Latios1928/engn2912e-project/analog/Analog_AI_Documentation.md

# Analog Design — AI Usage Documentation

A running record of every use of AI assistance in the analog design work for
the ENGN 2912E SNN project: what was asked, what the AI did, what it produced,
and how far its output was checked. It is updated as the work continues.

- **Tool:** Claude Code (desktop app), model Claude Opus 5.5 (Anthropic)
- **User:** Ray Wu
- **Started:** 2026-10-25
- **Last updated:** 2026-11-11

---

## How AI is used in this project

| Category | What the AI does | What the AI does *not* do |
|---|---|---|
| Schematic / testbench review | Reads `.sch` files as text, works out connectivity from pin coordinates, points out wiring, topology and SPICE-setup errors | Edit existing schematics: changes to the user's schematics are made by the user in xschem. *Exception (2026-11-03, user approved):* the AI created the new `neuron_5khz*` files (entry 28). |
| Simulation debugging | Explains ngspice/xschem error messages and proposes fixes | Run xschem or ngspice without asking. *Exception (2026-11-03, user approved):* the AI ran xschem netlisting and ngspice in the user's iic-osic-tools container, with scratch output in the container's `/tmp` only (entry 28). |
| Results analysis | Reads `wrdata` text output (`*_tb.txt`) with short Python scripts and reports measured values (thresholds, step sizes, reset levels, timing) | Generate simulation data (except entry 28, as above) |
| Circuit explanation | Explains circuit operation (e.g. Indiveri et al. 2011, Figure 4) and design trade-offs | Choose final device sizes or architecture. *Exception:* entry 28, where the user asked the AI to size a copy of the neuron. |
| Estimates | Rough area and sizing estimates from rules of thumb | Provide sign-off numbers: no layout exists yet |
| Documentation | Writes and maintains Markdown logs | |

**Verification levels used below:**
- **Simulated:** numbers from ngspice runs the AI made itself (only entry 28, with the user's approval).
- **Analysed:** numbers computed by the AI from the user's own simulation output files.
- **Reasoned:** derived from reading files or from circuit theory; not simulated.
- **Estimate:** rule-of-thumb figure that needs checking against the PDK or a layout.

---

## Files created or changed by AI

| File | Action | Date | Notes |
|---|---|---|---|
| `analog/neuron/SIM_LOG.md` | Created | 2026-10-26 | Running simulation log for the earlier Schmitt-trigger neuron. Results in it come from the user's simulations, analysed by the AI. |
| `analog/Analog_AI_Documentation.md` | Created | 2026-10-29 | This file. |
| `digital/README.md` | Created | 2026-10-26 | Digital-side summary (outside analog scope; listed for completeness). |
| `tools/analog_API_infrastructure/README.md` | Created | 2026-10-30 | Design document and build guide for the LLM-assisted sizing tool. No implementation code: the user writes the code. |
| `analog/neuron/neuron_5khz.sch` | Created | 2026-11-03 | Copy of `neuron.sch`, same topology, resized for 5 kHz (entry 28). Generated by script from the original. |
| `analog/neuron/neuron_5khz.sym` | Created | 2026-11-03 | Identical to `neuron.sym` (same pins). |
| `analog/neuron/neuron_5khz_testbench.sch` | Created | 2026-11-03 | Copy of `neuron_testbench.sch`: DC input, bias `.param`s, MIM model library, frequency `meas`. |
| `tools/analog_API_infrastructure/{params,netlist,runner,metrics,loop,compare}.py` | Created | 2026-11-04 | Sizing-loop implementation, at the user's request (entry 34). `advisor.py` not touched. |
| `tools/analog_API_infrastructure/configs/{params,spec,sim}.yaml`, `requirements.txt`, `.gitignore` | Created | 2026-11-04 | Configs for the 5 kHz neuron; `runs/` gitignored. |
| `tools/analog_API_infrastructure/README.md` | Edited | 2026-11-04 | Status line, new Quick start section, AI-usage note. |
| `tools/analog_API_infrastructure/advisor.py` → `advisor_draft.py` | Renamed (`git mv`) | 2026-11-04 | The user's draft, content unchanged (checksum-verified), at the user's request (entry 35). |
| `tools/analog_API_infrastructure/advisor.py` | Created | 2026-11-04 | New, complete OpenRouter advisor (entry 35). |
| `analog/testbenches/README.md` | Created | 2026-11-05 | How the testbenches and runners work; DPI reference point, test list and first findings (entry 43). |
| `analog/testbenches/tbtools.py` | Created | 2026-11-05 | Shared runner code: xschem netlisting, corner/temperature/param/mismatch substitution, parallel ngspice runs. |
| `analog/testbenches/.gitignore` | Created | 2026-11-05 | Ignores the `runs/` scratch folders. |
| `analog/testbenches/dpi/dpi_dc_tb.sch`, `dpi_step_tb.sch`, `dpi_spike_tb.sch` | Created | 2026-11-05 | DPI synapse testbenches (entry 43). Generated by script, using the pin positions in `DPI.sym`. |
| `analog/testbenches/dpi/run_dpi.py` | Created | 2026-11-05 | Runs the DPI testbenches over sweeps, corners, temperature, supply and mismatch; writes `results/`. |
| `analog/testbenches/dpi/results/*` | Generated | 2026-11-05 | Report `dpi_results.md`, per-suite CSVs and PNG plots from the runner. |
| `analog/neuron/DAC.sch` | Edited (user request) | 2026-11-05 | Weight pins `w0`–`w3` replaced by one bus pin `w[3:0]` to match the user's new `DAC.sym`; gate nets renamed `w[0]`–`w[3]` (entry 44). Sized for branch weights 1:2:3:4 (entry 45). Enable switch `Men` and `en` pin added (entry 48). |
| `analog/neuron/DAC.sym` | Edited (user request) | 2026-11-05 | `en` input pin added below `w[3:0]` (entry 48). |
| `analog/neuron/DACs-DPI.sch` | Edited (user request) | 2026-11-05 | x2/x3 weights wired as buses `w1[3:0]`, `w2[3:0]` (x1 was already `w0[3:0]`); sources renamed to the bus nets; DPI `Isum` reconnected by label (entry 44). Rewritten as the weight-code test, with a Vb reference and DAC current ammeter (entry 45). DAC `en` tied to VDD (entry 48). |
| `analog/neuron/DACs-DPI-neuron.sch` | Created | 2026-11-05 | DACs → DPI → `neuron_sized` testbench: input spikes of a chosen weight code, reports the input spike that first fires the neuron (entry 46). Generated by script from `DACs-DPI.sch` and `neuron_sized_testbench.sch`, which were not changed. Weights static and spikes on the DAC `en` pins since entry 48. |
| `mock/snn_mock.v` → `mock/snn_analog.v`, `snn_top.v`, `digital/snn_digital.v`, `mock/{neuron,tb_neuron,tb_snn_top}.v`, `mock/sim.f`, `analog/snn/snn_analog.v` (black box, was `mixed/snn_analog_stub.v`), `mixed/{sim.f,snn_ms_tb.v}`, `librelane/snn_top/config.json` | Renamed, split, moved and edited (user request) | 2026-11-09 | The behavioral model is now `snn_analog` (same name and ports as the analog network, own clock and power-on reset). The digital part is `digital/snn_digital.v` (`rf` + `pulse_gen`, no dependency on the analog side); the root `snn_top.v` only wires it to `snn_analog`, which `mock/` and `mixed/` each supply through their own file list (`sim.f`). The neuron has a `LEAK` parameter (new test in `tb_neuron.v`). `snn_ms_tb.v` instantiates `snn_top`. The LibreLane config lists `snn_top` and `digital/` (no analog macro yet, not run). |
| `mock/{dac,neuron,snn_analog,tb_neuron,tb_snn_top}.v`, `mixed/snn_ms_tb.v` | Edited (user request) | 2026-11-11 | Weights are sign-magnitude (bit 3 = sign, 1 = inhibitory; −7…+7), chosen over 1's complement because the magnitude bits drive the DAC branches directly and the sign only steers the current, so no branches oppose each other. Mock DAC gives a signed current, the neuron sums signed currents and clamps at 0, `snn_analog`'s `GAIN` is 32. New tests: inhibition in `tb_neuron` and an inhibition scenario in `tb_snn_top` (both fail if the sign is ignored). Max weight in the testbenches is now `4'h7`. `mixed/` also runs the inhibition scenario, as if the analog DAC already had a sign; it fails until `DAC.sch` and an inhibitory input exist (checked: today `1111` excites and hidden 1 and the output fire). |
| `analog/snn/snn_analog.{sch,sym,v}`, `mock/snn_analog.v`, `digital/{rf,pulse_gen,snn_digital,tb_pulse_gen}.v`, `snn_top.v`, `mock/tb_snn_top.v`, `mixed/{snn_ms_tb.v,snn_ms_tb.sch,snn_ms_tb_digital.json}` | Resized (user request) | 2026-11-11 | Network changed from 3-5-1 to 2-2-1: 8 weight words (`w[31:0]`, 3-bit `addr`), `in`/`pulse[1:0]`, `spike[4:0]`. Schematic regenerated (8 DAC, 5 DPI, 5 neurons). Scenarios mapped to 2-2-1 (path in1 → hid1 → out); the out-of-range `rf` write test was dropped because every 3-bit address is valid. All tests pass; full mixed run 96 s. Earlier entries describe the 3-5-1 network. |
| `digital/pulse_gen.v`, `tb_pulse_gen.v`, `tb_pulse_gen.json` | Moved from `mock/` and rewritten (user request) | 2026-11-09 | Input pulse generator is digital: three channels on one counter, `clk` and `rst` ports, `en` sampled at period boundaries, registered outputs. New testbench with a reference model. Chip pins: `in[2:0]` (enables), not `pulse[2:0]`. `snn_top`, `snn_ms_tb.v`, `mixed/Makefile` and the LibreLane config updated. |
| `analog/mock/*` → `mock/*` | Moved (user request) | 2026-11-09 | The mock modules and their testbenches moved to top-level `mock/`, together with `snn_top.v`, `tb_snn_top.v` and `tb_snn_top.json`. `snn.v` → `snn_mock.v` (module `snn` → `snn_mock`, ports unchanged). LibreLane config, `mixed/Makefile` and comments updated. Earlier entries below still use the old paths. |
| `xschemrc`, `analog/neuron/xschemrc` | Created | 2026-11-05 | Project xschem setup: loads the PDK, then puts the project root and `analog/neuron` on the symbol search path (entry 47). |
| `analog/neuron/layout/` (new folder) | Created | 2026-11-10 | DPI layout (entry 58): generator `gen_dpi.py`, `DPI.gds`, LVS reference `DPI_lvs_ref.spice` (+ converted `.cdl`), `run_dpi_checks.sh`, helpers `extract_pins.py`, `render_under.py`, `drc_summary.py`, `lvs_xref.py`, outputs `DPI_pins.json`, `DPI.png`, `DPI_under_cap.png`. `DPI.sch`/`DPI.sym` not changed. |
| `analog/neuron/layout/` neuron files | Created / rewritten | 2026-11-10 / 2026-11-11 | `neuron_sized` layout (entries 59, 60): `gen_neuron.py` (rewritten in entry 60), `neuron_sized.gds`, `neuron_sized_lvs_ref.spice` (+ `.cdl`), `run_neuron_checks.sh`, `coupling.py`, outputs `neuron_sized_pins.json`, `coupling_{VMEM,spike,net1,net2}.txt`, `neuron_sized.png`, `neuron_sized_under_cap.png`. `neuron_sized.sch`/`.sym` and `spike_amplifier.*` not changed. |
| `analog/neuron/layout/` DAC files | Created | 2026-11-11 | DAC layout (entry 64): `gen_dac.py`, `DAC.gds`, `DAC_lvs_ref.spice` (+ `.cdl`), `run_dac_checks.sh`, outputs `DAC_pins.json`, `DAC.png`, `DAC_coupling_*.txt`. `coupling.py` now counts GND as a supply. `DAC.sch`/`DAC.sym` not changed. |
| `analog/neuron/DAC_binary.sch`, `DAC_binary.sym` | Created (user request) | 2026-11-11 | Binary 1:2:4:8 DAC with multi-finger branches (entry 66). Generated by script from `DAC.sch`; the symbol is a copy of `DAC.sym` (same pins). `DAC.sch`/`DAC.sym` and their users not changed. |
| `analog/neuron/layout/` binary DAC files | Created | 2026-11-11 | Binary DAC layout (entry 68): `gen_dac_binary.py`, `DAC_binary.gds`, `DAC_binary_lvs_ref.spice` (+ `.cdl`), `run_dac_binary_checks.sh`, outputs `DAC_binary_pins.json`, `DAC_binary.png`, `DAC_binary_coupling_*.txt`. |
| `analog/snn/snn_analog.sch`, `snn_analog.sym` | Created | 2026-11-08 | The 3-5-1 network from `DAC`, `DPI` and `neuron_sized` (23/9/9 instances), per the word map of `analog/mock/snn.v` (entry 49a). Generated by script; no existing schematic changed. |
| `xschemrc` | Edited | 2026-11-08 | `analog/snn` added to the symbol search path. |
| `mixed/*` | Created | 2026-11-08 | Mixed-signal flow with SpiceBind: Verilog testbench, SPICE testbench, `libngspice` crash shim, Makefile, README (entry 49a). |
| `analog/mock/{dac,snn,tb_neuron}.v` | Edited (user request) | 2026-11-08 | Weights widened to 4 bits, binary (entry 49a). |
| `analog/snn/snn_analog_inh.sch`, `snn_analog_inh.sym` | Created (user request) | 2026-11-11 | Copy of the 2-2-1 `snn_analog` with `DAC_signed` hidden → output synapses, a `DPI_inh` on the output membrane, and new pins `s[1:0]` and `VT_inh` (entry 74). `snn_analog.sch/.sym` unchanged. |

Until entry 44, no existing schematic (`.sch`/`.sym`) or SPICE file had been edited by the AI. The DPI testbenches (entry 43) only instantiate `DPI.sym`; `DPI.sch` and `DPI.sym` were not changed by the AI. The originals `neuron.sch`, `neuron.sym` and `neuron_testbench.sch` were checksum-verified unchanged after the 5 kHz files were generated.

---

## Log

### 2026-10-25

**1. Review of the Schmitt-trigger comparator testbench** *(Reasoned)*
- **Asked:** review `schmitt_trigger_comparator_testbench.sch` without editing files.
- **AI found:**
  - Testbench: no model include, analysis or `.control` block; VIN was a constant 3 V DC (no hysteresis visible); load caps on the internal nodes VP/VN.
  - Comparator: NMOS on top and PMOS on bottom (source-follower, not inverting); both feedback devices NMOS; body pins apparently unconnected.
- **Outcome:** the user later rebuilt the comparator stack with PMOS on top and one NMOS plus one PMOS feedback device.

**2. "Undriven node" netlist errors** *(Reasoned)*
- **Asked:** debug undriven-node errors from netlisting.
- **AI did:** without seeing the error text, listed likely causes; the main one was floating transistor body pins. Asked for the exact messages.
- **Outcome:** the user wired the body pins.

**3. Triangle-wave transient on the comparator** *(Reasoned)*
- **Asked:** why the transient triangle input wasn't working.
- **AI found:** `.param` inside `.control` (parameters undefined); a one-direction current pulse into a cap can't make a triangle; the run was ~100× shorter than the waveform period.
- **AI suggested:** drive the input with a voltage `pwl` triangle and move `.param` outside `.control`.

**4. Input source for an SNN neuron** *(Reasoned)*
- **Asked:** what input current source suits a comparator inside an SNN.
- **AI explained:** switched (pulsed) unipolar current into a membrane capacitor with a reset, based on the behavioural models in `analog/mock/` (`dac.v`, `neuron.v`, `comparator.v`).

### 2026-10-26

**5. "unknown subckt … neuron" in `neuron_testbench`** *(Reasoned)*
- **AI found:** the `plot` title opened with `'` and closed with `"`, which ended the code block's `value="…"` early. The `.control` block lost its `.endc` and swallowed the `.subckt` definition. Also: `v(spike)` named a node that doesn't exist.

**6. "tran simulation(s) aborted"** *(Reasoned)*
- **AI explained:** the vector errors were a result of the sim failing at the DC operating point (MEM nearly floating; feedback loop). Suggested `.ic v(mem)=0` with `tran … uic`, or a leak resistor, plus a maximum time step.

**7. Singular matrix at `vbias#branch`** *(Reasoned)*
- **AI found:** the label on Vbias's + terminal said `VDD`, putting the 0.2 V source in parallel with the 3.3 V supply and leaving `reset_bias` floating.
- **Outcome:** the user relabelled it `reset_bias`.

**8. Plotting the input current** *(Reasoned)*
- **AI explained:** use the series ammeter's branch current (`i(vmem)`). Flagged that the ammeter's instance name must start with `V`: `iMEM` would netlist as a 0 A current source.
- **Outcome:** the user renamed it `VMEM`.

**9. Access to simulation results** *(Reasoned)*
- **AI explained:** it couldn't see results, because ngspice wrote them inside the container. Suggested `write`/`wrdata` with absolute `/foss/designs/...` paths.
- **Outcome:** the user added the paths; later results were readable.

**10. Staircase on MEM, no reset (ipk = 1 nA)** *(Analysed)*
- **AI measured:** MEM rose ≈ 51 mV per input pulse, reaching only ≈ 0.53 V in 10 ms; VOUT stayed at 3.3 V.
- **AI explained:** the staircase is expected for pulsed input; the neuron never reached its threshold. Also flagged a `v(out)` typo in `wrdata`.

**11. Reset not fast enough (ipk = 1 µA)** *(Analysed)*
- **AI measured:** about 67 spikes per input pulse; reset fall ≈ 9 ns, but MEM only dropped from ≈ 1.96 V to ≈ 1.21 V.
- **AI explained:** the reset ends itself when MEM drops below the lower threshold. Suggested holding the reset for a fixed time (one-shot or latch), widening M1, lowering the input current, and using finer time steps.
- **Outcome:** the user widened M1 to W = 2 µm and added C2 = 100 fF on the reset gate.

**12. MEM not crossing threshold (back at ipk = 1 nA)** *(Analysed)*
- **AI explained:** VP is an internal node, not the firing threshold. MEM needed ≈ 38 pulses to reach VTH+. Gave a table of ipk versus pulses-to-fire and suggested 10 nA.

**13. Measuring VTH+ / VTH−** *(Reasoned)*
- **AI suggested:** a slow `pwl` triangle on the comparator alone, with `meas tran … WHEN v(vout)=1.65 FALL=1 / RISE=1` and `plot v(vout) vs v(in)`. Explained the `pwl` syntax on request.

**14. Simulation log created** *(Analysed)*
- **AI created** `analog/neuron/SIM_LOG.md` from the user's latest results:
  - Comparator: **VTH+ = 1.954 V, VTH− = 1.298 V** (hysteresis 0.656 V).
  - Neuron at ipk = 20 nA: fires at ≈ 1.955 V; resets only to ≈ 0.74–1.01 V in ≈ 7 ns; 8 spikes in 10 ms.

### 2026-10-27

**15. Explanation of the voltage-amplifier I&F neuron** *(Reasoned)*
- **Asked:** explain Figure 4 of Indiveri et al., "Neuromorphic silicon neuron circuits", *Frontiers in Neuroscience* 5:73 (2011).
- **AI explained:** the roles of I_in, the leak (M1/V_lk), the comparator, the I_Na positive feedback, and the C_K/I_Kup/I_Kdn timing for spike width and refractory period. Compared it with the user's Schmitt-trigger neuron and suggested a starved inverter for a controlled reset hold.

**16. Suitability for subthreshold operation** *(Reasoned)*
- **AI concluded:** suitable. Gave the advantages (tunable pA–nA biases, ms time scales, nW power) and the issues to design for (mismatch, temperature, leakage floor, bias generation). Flagged that the earlier Schmitt-trigger stack would draw large through-current with a slow input.

**17. Layout area estimate for 9 neurons** *(Estimate)*
- **AI estimated:** ≈ 1,200 µm² per neuron (range 800–1,800), so **≈ 0.011 mm² for 9 neurons**, dominated by a 1 pF MIM membrane cap. The weight register file is ≈ 0.012–0.013 mm² (from the LibreLane netlist: 69 of 225 flip-flops). Flagged that `capa.sym` (ideal capacitor) must be replaced with a PDK MIM capacitor, and that the 5 V standard-cell library differs from the 3.3 V analog devices.

**18. Analog versus digital area** *(Estimate)*
- **AI estimated:** total analog ≈ 0.02–0.03 mm² (neurons, DACs, pulse generators, bias) versus digital ≈ 0.013–0.016 mm², so analog is likely larger.

**19. Shuttle tile-size table** *(Reasoned / Estimate)*
- **AI found:** in the user's table, the "usable area" column was ≈ 1,000× too large (a formula referencing the 3x2 width), and the NAND2-equivalent column was ≈ 10× too high for GF180 (a NAND2 is ≈ 9–10 µm²).
- **AI recommended:** 1x2 tiles (0.113 mm²) for margin; 1x1 is possible but tight.

### 2026-10-29

**20. Capacitor values in the new Figure 4 neuron (`neuron.sch`)** *(Reasoned)*
- **Asked:** whether the XC1/XC2 capacitances can be changed.
- **AI read** the new schematic and the paper's text (extracted from the PDF).
- **AI found:**
  - C2 is C_mem (on VMEM) and C1 is C_K (on the `spike` node that drives M6). Both are 1 × 1 µm `cap_mim_2f0_m3m4_noshield`, ≈ 2 fF each.
  - The paper gives no specific values for these capacitors.
- **AI recommended:**
  - Set capacitance through W and L (≈ 2 fF/µm²).
  - Starting values: C_mem ≈ 0.5–1 pF, C_K ≈ 50–200 fF.
  - Check the PDK's minimum MIM size.
  - The `spike` output sits on the slow C_K node.

### 2026-10-30

**21. Plan for LLM-assisted sizing infrastructure (OpenRouter)** *(Reasoned)*
- **Asked:** a README for `tools/analog_API_infrastructure/` describing Python tooling that calls OpenRouter models to size the neuron and set testbench parameters, with control over spike frequency, active and capacitor area, reset time, refractory time, etc. The user wants to write the code themselves; the AI only guides.
- **AI did:**
  - Read the existing draft `advisor.py` and `neuron_testbench.sch`.
  - Wrote `README.md` covering: the propose → validate → simulate → measure loop; spec and parameter formats; how each metric is measured (`.meas` versus computed in Python for area); preparing the schematic (parameterized fields, a separate automation code block, a generated `params.spice`); a module layout with function interfaces but no bodies; the OpenRouter call (key from the environment, structured JSON output, retries, logging); validation rules; a random-search baseline for comparison; and a milestone plan.
- **AI found:**
  - Bugs in `advisor.py`: `os.enrivon`; undefined `s` in `Param.fix`; `tuple{…]` syntax error; `meets_spec` body copied from `_key`; set literals in place of dicts in `_schema`; a missing comma.
  - The bias parameters (`Vlk`, `VNA`, `VK`, `VKup`, `VKdn`, `VIp`, `Vamp_bias`, `VT`) are used by the testbench sources but not defined in its `.param` line.
- **Not done by AI:** any implementation code, or fixes to `advisor.py`. Those are left to the user.

**22. Plain-language walkthrough of `advisor.py`** *(Reasoned)*
- **Asked:** explain each Python function in `advisor.py` for a non-software-engineer.
- **AI did:** explained the imports, constants, `Param`/`fix`, `Spec`, `meets_spec`, `_key`, `_schema`, and the functions not yet written (`_user_prompt`, `_log`, `_random`, `_client`, `suggest`, the `__main__` self-test), plus a table of common Python syntax.
- **AI found:** still present in the user's file: `meets_spec` body copied from `_key`; set literals (`{"type","string"}`) in place of dicts in `_schema`; a missing comma before `"required"`.
- **Not done by AI:** any change to `advisor.py`.

### 2026-11-01

**23. Re-display of the reference `advisor.py`** *(Reasoned)*
- **Asked:** show the full advisor script again.
- **AI did:** reprinted the reference version from entry 21's discussion, unchanged.

**24. Explanation of schemas, dictionaries and tuples; running guide** *(Reasoned)*
- **Asked:** what a schema is, the purpose of the tuples and dictionaries in `advisor.py`, and a running document on the AI harness.
- **AI did:** created a Claude Doc, "AI Analog Harnessing Guide" (https://claude.ai/artifact/H8XnjUgpAtzQzgn4qyrGyK), outside the repo. It covers: a diagram of the propose → simulate → measure → back-annotate loop; schemas; each dictionary and tuple in `advisor.py`; lists and sets compared with tuples; a function reference; a glossary; and a change log.
- **Not done by AI:** any change to `advisor.py` or other project code.

**25. Schema versus history record for a candidate** *(Reasoned)*
- **Asked:** how parameter values, simulation results, an ID and a score fit into the `type` / `properties` / `required` / `additionalProperties` keys of the candidate schema.
- **AI explained:** the schema covers only what the model proposes (parameter values, optionally a per-candidate `reason`). Results, ID and score belong in a separate history record built by the user's code after simulation, so the model cannot fabricate results. Gave an example record and a distance-from-spec score idea.
- **Not done by AI:** any change to `advisor.py`. The harnessing guide was not updated because the Docs connector was disconnected.

**26. Why a schema needs the `"type"` key** *(Reasoned)*
- **Asked:** why `"type": "object"` is needed when `candidate` is already a dictionary.
- **AI explained:** the dictionary is a description, not the candidate itself; every schema description is a dict whatever it describes (e.g. `{"type": "number"}`). The schema is sent as JSON to OpenRouter, whose validator and model see only that text, and strict mode requires `type` at every level.

**27. Analogy for the structure of `advisor.py`** *(Reasoned)*
- **Asked:** an analogy to make the structure of the advisor functions intuitive.
- **AI explained:** a lab that hires an outside consultant by mail. Knobs with end stops and detents (`Param`, `fix`); datasheet (`spec`, `meets_spec`); lab notebook (`history`, `_key`, `seen`); contract and cover letter (`SYSTEM_PROMPT`, `_user_prompt`); the enclosed reply form (`_schema`); mailbox (`_client`); binder of photocopies (`_log`); a free intern (`_random`); one round of mail (`suggest`). The bench (ngspice) is outside `advisor.py`: the consultant suggests, the bench decides.

### 2026-11-03

**28. Duplicate neuron sized for 5 kHz** *(Simulated)*
- **Asked:** create a duplicate of the neuron (Indiveri et al. 2011, Fig. 4 topology in `neuron.sch`) and size it to spike at 5 kHz.
- **User approved** (asked first, since the workspace rule was read-only): creating new files next to the originals, and running ngspice in the user's iic-osic-tools container.
- **Operating point the AI chose** (5 kHz needs a defined input): constant input current Iin = 5 nA DC, VDD = 3.3 V, typical corner, 27 °C.
- **AI did:**
  - Netlisted `neuron_testbench.sch` with xschem to confirm the connectivity it had read from the file.
  - Characterized Id vs Vgs for 1 µm/1 µm bias devices; swept the Na, K, Kup biases and M6 length (≈ 100 runs, scratch files in the container's `/tmp/claude_neuron`).
  - Generated the three new files with a script, then netlisted the new testbench with xschem and simulated that netlist.
- **Final sizing (`neuron_5khz.sch`):**
  - C2 (Cmem) 20.52 × 20.52 µm ≈ 0.86 pF; C1 (C_K) 6.85 × 6.85 µm ≈ 100 fF.
  - M6 (reset switch) W/L = 0.22/5 µm. The long channel delays the reset until the spike node is high, which gives a full-swing spike.
  - Bias devices M7–M12: W/L = 1/1 µm. Switches M1–M5 and the spike amplifier unchanged (0.22/0.28 µm).
- **Biases (`neuron_5khz_testbench.sch`):** Vlk 0.420 V (≈ 0.5 nA leak), Vamp_bias 0.535 V (≈ 10 nA), VIp 0.573 V (≈ 25 nA), VNA 2.0 V (≈ 4 µA), VKup 2.277 V (≈ 1 µA), VK 1.1 V, VKdn 0.573 V (≈ 25 nA), VT 1.0 V.
- **Simulated results (typical, 27 °C):**
  - Frequency **4.999 kHz** from the xschem-generated netlist of the new schematic.
  - Spike 0 → 3.30 V, ≈ 6.4 µs wide at VDD/2; VMEM resets to < 1 mV; average power ≈ 0.21 µW.
  - VNA or VK ±50 mV: frequency within 0.1 %, no latch-up.
  - f vs Iin: 1.75 / 2.86 / 5.00 / 7.54 / 9.95 / 18.4 kHz at 2 / 3 / 5 / 7.5 / 10 / 20 nA.
- **AI found:**
  - The original `neuron_testbench.sch` cannot run as is: it lacks `.lib … mimcap_typical` (the MIM caps are then unknown subcircuits) and `.param` values for the eight bias voltages; its `wrdata` names `v(mem)`/`v(vout)` no longer exist.
  - With the first biases tried, the spike node peaked at only ≈ 0.95 V, because the reset won a race against the spike node; when INa exceeded IK the neuron latched high and stopped firing.
- **Limitation:** fixed bias *voltages* on subthreshold devices make the design strongly corner- and temperature-dependent. ss 27 °C gives 2.96 kHz; typical 85 °C and ff 27/85 °C do not fire, because leak exceeds 5 nA. On silicon the biases should come from current-referenced bias generators, or be retuned per chip.

**28. Meaning of `"type": "object"` in a JSON schema** *(Reasoned)*
- **Asked:** whether `"type": "object"` is too general, since everything in Python is an object.
- **AI explained:** in JSON Schema, "object" is one of six JSON types and means a `{...}` with named fields (a Python dict), so it is as specific as `"string"`. `properties`, `required` and `additionalProperties` then pin down exactly which fields. Added a short note on this to the schema section of the harnessing guide.
- **Not done by AI:** any change to `advisor.py`.

**29. JSON versus JSON Schema keywords** *(Reasoned)*
- **Asked:** whether `type`, `properties`, `required` and `additionalProperties` are part of the JSON language.
- **AI explained:** JSON is only a data format with no keywords. Those names come from JSON Schema, a separate standard written in JSON. Python treats them as ordinary dictionary keys; OpenRouter and the model give them meaning, so they must be spelled exactly (a misspelled keyword is ignored or rejected).
- **Not done by AI:** any change to `advisor.py`.

**30. Description of `_user_prompt` in `advisor.py`** *(Reasoned)*
- **Asked:** add a description of the user prompt to this file.
- **What it is:** each request to the model carries two messages. The *system prompt* (`SYSTEM_PROMPT`) is the fixed job description, the same every call. The *user prompt* is the specific question for this round, rebuilt each call by `_user_prompt(space, history, spec, n)` so it always includes the latest simulation results.
- **Inputs:** `space` (the tunable parameters and their bounds), `history` (every point simulated so far, with its measured metrics), `spec` (acceptable range per metric), and `n` (how many new candidates to ask for).
- **How it works:** it collects lines of text in a list, then joins them with line breaks into one block of text. It has four parts:
  1. **Parameters:** one line per knob with its minimum, maximum and grid step.
  2. **Spec:** one line per metric with its acceptable range.
  3. **Simulated points:** a comma-separated table with a header row (parameter names, metric names, `meets_spec`), then one row per simulated point with its values and pass/fail. If nothing has been simulated, it says so.
  4. **Request:** "Propose exactly n new candidates."
- **Example output** (two parameters, one metric, one simulated point):
  ```
  Parameters (name: lo .. hi, step):
    WP: 2.2e-07 .. 2e-06, step 5e-09
    WN: 2.2e-07 .. 2e-06, step 5e-09

  Spec (metric: acceptable range):
    vth_hi: 1.95 .. 2.05

  Simulated points:
    WP,WN,vth_hi,meets_spec
    4.4e-07,2.2e-07,1.5,False

  Propose exactly 4 new candidates.
  ```
- **Why a plain-text table:** it is compact, so many points fit in one request, and models read comma-separated tables reliably. `:.4g` rounds each number to 4 significant figures to keep it short.
- **AI found** in the user's version (lines 59–79):
  - Lines 78–79 (`Propose exactly…` and `return`) are indented inside the `else:` block. With an empty history, the function returns `None` instead of a prompt, so the first call of a run fails. They should be dedented to the level of `metrics = list(spec)`.
  - Line 74 uses `h['metrics'][m]`, which crashes with `KeyError` if a measurement failed. `h['metrics'].get(m, float('nan'))` prints `nan` instead.
  - Lines 61 and 64 format `p.lo` and `lo` without `:.4g`, unlike `hi`, so the bounds print inconsistently.
  - Line 69 typo: `(non yet)` should be `(none yet)`.
- **Not done by AI:** any change to `advisor.py`. The fixes are left to the user.

**31. Opening an xschem schematic from the command line** *(Reasoned)*
- **Asked:** how to open an xschem schematic from the command line.
- **AI explained:**
  - `xschem <file>.sch`, run from the project root inside the iic-osic-tools container, so relative symbol paths such as `analog/neuron/neuron.sym` resolve.
  - How to launch it from a Mac terminal with `docker exec` and the container's VNC display.
  - The batch netlisting flags (`-n -s -q -o`).
- **Not done by AI:** nothing was run in the container.

**32. "Missing symbol" for `spike_amplifier` when opening from the command line** *(Reasoned)*
- **AI found:** `neuron.sch` (and `neuron_5khz.sch`) place the amplifier as `analog/neuron/spike_amplifier.sym`. That path is resolved against xschem's library search path (`XSCHEM_LIBRARY_PATH`), not against the schematic's folder, so it only resolves when the project root is on that path or is the working directory xschem was started from.
- **AI explained** three fixes:
  1. Start xschem from the project root.
  2. Reference the symbol by its bare name, since it is in the same folder as `neuron.sch`.
  3. Add the project root to `XSCHEM_LIBRARY_PATH` in an `xschemrc`.
- **Not done by AI:** no file was changed and nothing was run in the container. The diagnosis wasn't confirmed against the container's actual `XSCHEM_LIBRARY_PATH`.

### 2026-11-04

**33. Turning a DC current target into a pulsed testbench input** *(Reasoned)*
- **Asked:** for 5 kHz spiking with C = 1 pF and ΔV ≈ 1.66 V, the calculation gives a DC current; how does that translate to the pulsed source in the testbench?
- **AI explained:**
  - The DC number is the required *average* current: I = C·ΔV·f = 8.3 nA, plus leak, plus a correction for time spent spiking and in refractory.
  - Charge per pulse is q = ipk·(pw + (tr + tf)/2). The neuron fires after N = ⌈Q/q⌉ pulses, so f_out = f_pulse/N. The output rate is therefore quantized.
- **AI gave** three worked stimulus options:
  - one pulse per spike at 5 kHz;
  - 4 pulses per spike at 20 kHz, aiming q at Q/3.5 for margin;
  - fast pulses with average current equal to the DC value, which behave like DC.
- **AI noted:**
  - Pulses arriving during the refractory period are lost.
  - ΔV = 1.66 V implies VT ≈ 1.66 V, whereas the `neuron_5khz` testbench uses VT = 1.0 V.
- **Not done by AI:** no file was changed and nothing was simulated. The numbers are hand calculations.

**34. Python files for the sizing loop** *(Simulated)*
- **Asked:** add the Python files the sizing infrastructure needs to the tools folder. This reverses the earlier "the user writes the code" arrangement for these files; `advisor.py` stays the user's.
- **User approved** a smoke test of ~8 ngspice runs in the container (output in the gitignored `runs/`).
- **AI did:** wrote `params.py` (YAML → `Param`/`Spec`), `netlist.py` (xschem batch netlist → template: removes `.control` and overridden `.param`s, replaces device fields with `{PARAM}`; writes `params.spice`), `runner.py` (`ngspice -b` with timeout, `num_threads=1`), `metrics.py` (`parse_meas`, hierarchical `area`, `meets_spec`, `score`), `loop.py` (propose → validate → parallel simulate → `history.jsonl`; random proposer built in, LLM proposer calls `advisor.suggest()`), `compare.py`, and configs.
- **Design choice:** the schematic is not edited; device sizes are substituted in a copy of the netlist, so README step 3 becomes optional.
- **Example problem in the configs:** keep 5 kHz (4.9–5.1 kHz at 5 nA), spike width < 20 µs, power < 0.5 µW, while cutting MIM area to < 300 µm² (hand-sized design: 468 µm²). Tunables: W_C2, W_C1 (square caps), VT, Vlk, VKdn.
- **Checks:**
  - Area from the netlist: a_active 7.72 µm², a_cap 468 µm², matching the hand calculation.
  - Init point through the full tool: 4.999 kHz, 6.37 µs, 0.206 µW, matching entry 28.
  - 8 random points ran without errors; the best scored 0.089 (5.55 kHz at 241 µm²), none met spec. One point produced too few spikes for `f_spike` and was correctly reported as `None`.
- **Not done by AI:** `advisor.py` is unchanged and still does not import (its `suggest()` is unfinished, and entry 30's `_user_prompt` fixes are still open), so `--proposer llm` is untested. `openai` is not installed in the container.

**35. New `advisor.py`; the user's draft renamed** *(Reasoned; tested with stubbed API replies)*
- **Asked:** create a separate `advisor.py` and rename the user's.
- **AI did:**
  - Renamed the draft to `advisor_draft.py` with `git mv`. The content is byte-identical to the committed version.
  - Wrote a new `advisor.py` with the draft's structure (`Param`, `meets_spec`, `_key`, `_schema`, `_user_prompt`, `_log`, `_random`, `suggest`). It includes the fixes from entry 30 and README section 8, plus:
    - an HTTP call using only the Python standard library, so `openai` is not needed;
    - structured output, with a plain-JSON fallback when a model rejects `response_format`;
    - retries with backoff on HTTP 429/5xx;
    - history trimmed to the 20 best and 20 most recent points;
    - clamp/snap of proposed values, and removal of duplicates;
    - prompts, replies and token usage logged to each run's `advisor_log.jsonl`.
  - `loop.py`: fails fast if no model or `OPENROUTER_API_KEY` is set, and points the advisor log at the run folder.
  - README status, file table and setup note updated; `openai` removed from `requirements.txt`.
- **Checks (no ngspice runs, no real API calls):**
  - Prompt text inspected.
  - With a faked API reply, a duplicate was dropped, out-of-range values were clamped and an incomplete candidate was discarded.
  - A 429 followed by a `response_format` 400 led to a retry, then the plain-JSON fallback.
  - `loop.py --proposer llm` ran with stubbed simulation and API, and logged every round.
- **Not verified:** a real OpenRouter call, i.e. whether a given model returns schema-conforming candidates (README milestone 6).

**36. Checking the user's peak-current equation, C·ΔV + I_lk·ΔT** *(Reasoned)*
- **Asked:** the user derived I_peak = C·ΔV + I_lk·ΔT, which differs from entry 33.
- **AI explained:**
  - That expression is a *charge* (coulombs), not a current. It is the correct charge balance, the same as entry 33's Q plus leak charge.
  - To get a current, divide by the total pulse on-time: I_pk = (C·ΔV + I_lk·ΔT) / (N·t_on), with t_on = pw + (tr + tf)/2.
  - ΔT is the time VMEM sits above ground, because the leak device has almost no drain-source voltage at VMEM ≈ 0:
    - one pulse per spike: ΔT ≈ pw, so I_pk = C·ΔV/pw + I_lk;
    - N pulses: ΔT ≈ (N − 1)·per + pw.
  - The result is the minimum (exact) value; add margin.
- **AI checked:** worked numbers against entry 33's table (166.5 nA versus ≈ 220 nA with 1.3× margin; 43.5 nA versus ≈ 50 nA for N = 4).
- **Not done by AI:** no file was changed and nothing was simulated.

**37. A reasonable number of input pulses per output spike** *(Reasoned)*
- **Asked:** what pulses-per-spike makes sense for this neuron when the synaptic current varies with the weights and with which inputs fire.
- **AI explained:**
  - Because the input charge depends on the weights and on which inputs fire, there is no single N. It should be specified as a range: q(w) = w·q₁ and N(w) = ⌈Q/(w·q₁)⌉.
- **AI derived** the ratios already built into the behavioural mock (`analog/mock/snn.v`, `neuron.v`, `dac.v`, `pulse_gen.v`: THRESHOLD 1000, GAIN 16, pulse width 2 cycles, spike length DURATION+1 = 5 cycles):
  - Input layer: N ≈ 5 pulses at w = 7 and ≈ 32 at w = 1.
  - Hidden and output layers: ≈ 2 presynaptic spikes at w = 7 and ≈ 13 at w = 1 (single synapse).
  - Mid-weight fan-in gives a layer gain of about 1.
- **AI recommended:**
  - N ≈ 2–5 at maximum single-synapse weight and ≈ 15–35 at the least-significant weight, matching the mock so weights validated on the mock carry over.
  - Explained the limits: too few pulses loses weight resolution and lets the refractory period swallow inputs; too many collapses the firing rate through the layers and lets leak and DAC mismatch dominate.
- **Worked example:** Q ≈ 1.66 pC gives q₁ ≈ 53 fC (input layer) and ≈ 133 fC (later layers). A 6.4 µs spike then needs I_unit ≈ 21 nA; to keep the mock's 2.5 ratio, the pulse-generator width should be ≈ 2.6 µs.
- **Not done by AI:** no file was changed and nothing was simulated. The analog spike width and the DAC/DPI charge per spike need measuring.

**38. Choosing q₁, and what sets the spike width** *(Reasoned)*
- **Asked:** a recommended q₁, and how spike_time is set, given q₁ = I₁·t_spike.
- **AI recommended:**
  - q₁ ≈ Q/12.5 ≈ 130 fC for synapses driven by neuron spikes (Q = 1.66 pC). This is the mock's 80/1000 ratio: N = 2 events at w = 7 and 13 at w = 1, and mid-weight fan-in gain ≈ 1.
  - Input layer: ≈ 53 fC, i.e. a pulse-generator width ≈ 0.4 × t_spike.
  - t_spike ≈ 10 µs, giving I₁ ≈ 13 nA.
- **AI checked:**
  - Leak: weight-1 average current at 5 kHz is ≈ 0.65 nA, comparable to the 0.5 nA leak in `neuron_5khz`, so the AI suggested ≲ 0.1 nA.
  - I_K must exceed the largest simultaneous synaptic current (fan-in × 7 × I₁).
- **AI found:**
  - In `neuron.sch` / `neuron_5khz.sch`, the `spike` output is the C_K node (C1). Its width at a switching level V_sw is ≈ C_K·(VDD − V_sw)/I_Kdn: with 100 fF and 25 nA that is ≈ 6.6 µs, consistent with the simulated ≈ 6.4 µs.
  - So in this schematic, spike width is set by C_K and VKdn, which also set the refractory period. The two are coupled, unlike the paper, where I_Kup sets the width.
  - `DAC.sch` has 4 weight inputs (w0–w3) while the mock uses 3 bits.
  - `DPI.sch` still uses an ideal `capa.sym`.
- **Options given:**
  - Take the spike from the first inverter output (`#net2`, plus an inverter) so I_Kup sets the width.
  - Buffer the C_K node.
  - Make a clocked fixed-length pulse.
  - For a DPI synapse, q = I_w·(I_gain/I_τ)·t_spike.
  - Derive I₁ and I_Kdn from the same reference so q₁ depends on a current ratio.
- **Not done by AI:** no file was changed and nothing was simulated.

**39. Which capacitor to size for a 10 µs spike** *(Reasoned)*
- **Asked:** which capacitor to start with to set a 10 µs spike duration.
- **AI recommended:**
  - Start with C1 (C_K). The `spike` output is the C_K node, so t_spike ≈ C_K,total·(VDD − V_sw)/I_Kdn. C2 (C_mem) mainly sets the firing rate.
  - Scaled from the simulated `neuron_5khz` point (≈ 100 fF MIM + ≈ 7 fF parasitics, 6.4 µs at VKdn = 0.573 V) to 10 µs: ≈ 160 fF MIM, W = L ≈ 8.7 µm as a starting point, then trim with VKdn (≈ 14 mV per ±1.5× current).
- **AI noted:**
  - `neuron.sch` still has C1 = C2 = 1 × 1 µm (≈ 2 fF) and M6 = 0.22/0.28 µm, unlike the long-channel M6 in `neuron_5khz`.
  - The refractory period grows with C_K as well.
  - With the spike taken from the first inverter instead, the knob becomes C_K with VKup.
- **AI gave:** a `.meas` TRIG/TARG line for the width.
- **Not done by AI:** no file was changed and nothing was simulated. The 8.7 µm figure is a scaled estimate.

**40. Refractory period versus reset** *(Reasoned)*
- **Asked:** what the refractory period is, and whether it's just the reset.
- **AI explained:**
  - Reset (down-swing) is the fast discharge of VMEM to ground once I_K turns on. It lasts roughly C_mem·ΔV/(I_K − I_in), well under a µs to a few µs.
  - Refractory is the period after that during which VMEM is *held* at ground. C_K stays above M6's turn-on voltage while I_Kdn slowly discharges it, so I_K keeps sinking any input: ≈ C_K·(VDD − V_on,M6)/I_Kdn.
  - Inputs during refractory are lost, provided I_K exceeds the input current; it caps the maximum firing rate at about 1/(t_spike + t_reset + t_refr).
  - In this schematic the refractory period overlaps most of the spike's falling edge, because both come from the same C_K discharge.
- **AI gave:** a way to measure it in simulation.
- **Not done by AI:** no file was changed and nothing was simulated.

**41. Is the current target list enough for the sizing assistant?** *(Reasoned)*
- **Asked:** whether spike width 10 µs, refractory 12–15 µs, threshold 1.66 V, C_mem 1 pF and a 200 µs period are enough to run the sizing loop.
- **AI said:** not yet.
- **AI found:**
  - The width/refractory pair is consistent: both come from the C_K discharge, so their ratio ≈ (VDD − V_on,M6)/(VDD − V_sw) ≈ 1.4–1.5.
  - The period implies I_in ≈ 9.5 nA DC plus leak, but only once the input condition is defined.
- **AI listed what is missing:**
  - the input stimulus (DC or pulsed, q₁/I₁);
  - tolerances on each target;
  - VDD, corner and temperature;
  - the measurement definitions (V_sw level, which spike to measure);
  - a leak target;
  - the I_K margin;
  - spike swing and reset level;
  - area and power budgets;
  - which parameters are tunable, with bounds;
  - which values are fixed (C_mem = 1 pF; VT is a bias, not a sizing result).
- **AI gave:** an example `spec.yaml` / `params.yaml`.
- **Not done by AI:** no file was changed and nothing was simulated.

### 2026-11-05

**42. Sizing sweep for `sizing_context.txt`: `neuron_sized`** *(Simulated)*
- **Asked:** run a sizing sweep on the neuron to the targets in `neuron/sizing_context.txt`, and save the result in a copied schematic.
- **AI did:**
  - Copied `neuron_5khz.sch` / `.sym` / `_testbench.sch` to `neuron_sized*`.
  - Set C2 (C_mem) to 22.18 × 22.18 µm. This is 1.000 pF from the PDK model (1.99 fF/µm²·A + 0.238 fF/µm·P).
  - Wrote `tools/analog_API_infrastructure/configs_sized/` (spec, params, sim); the original `configs/` is unchanged.
  - Ran ≈ 670 ngspice points in total: 1-D sensitivity sweeps, a grid, random search, then local refinement. The points were driven through `loop.py`'s `validate` / `simulate` from a scratch script and are logged in `runs/*_sized_sweep*/history.jsonl` (gitignored).
  - The LLM proposer was not used, so no OpenRouter calls were made.
- **Measurement definitions** (spikes 3–7; the first two start from the initial condition):
  - period = mean spike-to-spike time;
  - t_spike = width of v(spike) above 1.65 V;
  - v_spike_max = max v(spike), v_reset = min VMEM;
  - t_refr = VMEM falls below 0.33 V (end of reset) → VMEM rises 10 mV above v_reset (as in the README and entry 40);
  - p_avg = −i(V1)·VDD.
- **Definition issue found:** measured from the spike's falling edge instead, refractory is always ≤ 0.9 × spike width whenever v_spike_max ≥ 2.97 V (345 points). The release point (spike ≈ 0.6 V) is set by M6, which is not a tunable, so under that definition the spec is infeasible.
- **Result:** W_C1 = 10 µm (C1 ≈ 0.21 pF), VKdn = 0.588, VKup = 2.35, VK = 1.22, VNA = 1.93, Vlk = 0.425 V. Fixed: VT = 1.66, Vamp_bias = 0.535, VIp = 0.573 V.
  - At 9.5 nA DC, tt, 27 °C: period 201.4 µs, t_spike 9.29 µs, t_refr 14.69 µs, v_spike_max 3.23 V, v_reset 0.9 mV, p_avg 0.38 µW, a_cap 592 µm². All targets met.
  - Re-checked at a 10 ns step and from a fresh xschem netlist of the saved copy; both agree within 0.1 %.
- **Margins are thin on t_spike and t_refr (≈ 0.3 µs each):** the two move together (t_refr ≈ t_spike + 5.4 µs at this point), which pins t_spike near 9.3 µs.
- **Not done by AI:** corners and temperature were not checked. The original `neuron_5khz*` files were not modified.

**43. DPI synapse testbenches** *(Simulated)*
- **Asked:** start building extensive testbenches for the analog devices. The user chose the DPI synapse first, both xschem testbenches and a Python runner, and approved running xschem netlisting and ngspice.
- **AI did:**
  - Read `DPI.sch`: M1 (gate Vthr) and diode-connected M2 form a differential pair on `Isum`; M3 (gate VT) is the τ leak into Vsyn; C4 = 1 pF ideal between VDD and Vsyn; M4 is the output pFET.
  - Characterized it in scratch netlists to choose a reference point: Vthr = 2.9 V, Vsg(M3) = 0.40 V, Iw = 5 nA (ideal sink in place of the DAC).
  - Generated three testbenches in `analog/testbenches/dpi/` (DC sweeps, step response, single spike plus spike train) and a runner, `run_dpi.py`, with shared code in `tbtools.py`. Suites: nominal, τ vs Vtau, gain vs Vthr, weight 1–7, pulse width, spike rate, 5 corners × 0/27/85 °C, VDD ±0.3 V, and 200-sample device mismatch. A full run takes about 10 s.
  - Wrote `analog/testbenches/README.md`.
- **Simulated results (tt, 27 °C, reference point):**
  - Gain Isyn/Iw 1.40 (Isyn = 7.0 nA); τ_rise 0.40 ms; τ_decay 0.43 ms; exponential decay; leakage 3.3 pA; log-log slope of Isyn vs Iw 0.88.
  - The single-spike EPSC is strongly non-linear in charge per spike. At 100 µs width and Iw = w × 1 nA, the charge for w = 1…7 spans 3.7×10⁻⁵ to 0.54 pC. 10 µs pulses at 5 nA give no measurable EPSC, and a 1 kHz train has a mean about 4× the single-spike charge × rate.
  - Mismatch with all devices at 0.22/0.28 µm: gain std/mean ≈ 1.1 (0.11 to 14.5), τ_decay std/mean ≈ 0.7.
  - Corners/temperature at fixed bias voltages: τ_decay ranges from 2.9 µs (ff, 85 °C) to 15 ms (fs, 0 °C); at ff/sf 85 °C the gain drops below 0.004.
  - With Vthr fixed at 2.9 V, the gain is 0.0015 at VDD = 3.0 V and 159 at 3.6 V; with Vthr = VDD − 0.4 V it stays between 1.25 and 1.57.
  - At the biases in `DACs-DPI.sch` (Vsg(M3) = 0.5 V, Vthr = 3 V): gain 0.012, τ_decay 33 µs.
- **AI found:**
  - `DPI.sym` changed while the testbenches were being written: the `Isum` pin moved to the left side. The first runner results came out wrong because the testbench wire no longer reached the pin (it netlisted as `net1`). The schematics were regenerated from the new pin positions, and the runner now stops if any DPI pin lands on an unnamed net.
  - `~/.spiceinit` sets `num_threads=4`. Parallel runs were about 10× slower until each run folder got its own `.spiceinit` with `num_threads=1`.
  - Not changed, for the user to decide: C4 is an ideal `capa` rather than a MIM cap; the bulks of M1/M2 are tied to `Isum`, which needs an isolated p-well on silicon.
- **Limitations:**
  - The pass/fail targets in `run_dpi.py` are provisional, chosen by the AI around the typical results, not project specs.
  - The DAC is ideal in these tests; DAC + DPI together is not covered yet.
- **Not done by AI:** any change to `DPI.sch`, `DPI.sym` or the other existing schematics.

**44. Fix after the `DAC.sym` weight bus change** *(Simulated)*
- **Asked:** fix what the change to a `w[3:0]` bus broke. The user said `DPI.sym`; the bus was in fact added to `DAC.sym` (Vb also moved and the box shrank). `DPI.sym` was unchanged since its `Isum` pin moved (entry 43).
- **AI found:**
  - `DAC.sch` still had four pins `w0`–`w3`, so xschem reported the symbol and schematic pins as mismatched.
  - In `DACs-DPI.sch`, x1 was already on the bus `w0[3:0]` (user edit), but the old wires of x2 and x3 (`w01`…`w32`) landed on their bus pins, and the TRAN_SIM sources still drove `w00`…`w32`.
  - Separately, the DPI's `Isum` pin had moved to the left side, so the DAC tail current no longer reached the DPI (it netlisted as `net2`). Isyn stayed at the 3.3 pA leakage.
- **AI did** (the user asked for the fix, which is the first edit of existing schematics by the AI; copies of both files from before the edit were kept outside the repo):
  - `DAC.sch`: one ipin `w[3:0]`; gate labels `w[0]`–`w[3]`. It now netlists as `.subckt DAC Isum Vb w[3] w[2] w[1] w[0]`.
  - `DACs-DPI.sch`: bus wires and labels `w1[3:0]` (x2) and `w2[3:0]` (x3), following the user's `w0[3:0]`.
    - Sources keep their names (`Vw<b><d>`, `b<b><d>`) but now drive `w<d>[<b>]`, with a comment explaining the mapping; the plot line uses `v(w1[0]) v(w0[1])`.
    - `Isum` labels were added at the DPI's new pin and on the DAC tail wire.
- **Verified:** all three DACs and the DPI share `Isum`. With the user's stimulus, Isyn peaks at 23 nA at 4 ms (before the fix: 3.3 pA). The DPI testbenches (entry 43) were rerun and are unchanged.
- **Not changed:** `untitled.sch` (the user's sketch, with three DACs and no wiring yet) and `DAC_tb.sch` (one instance, no wiring).

**45. DAC sized 1:2:3:4 and DAC + DPI weight-code testbench** *(Simulated)*
- **Asked:** size the DAC for branch weights 1:2:3:4, with the base branch (w[0]) giving 15 nA, and change the DAC + DPI testbench to test different weight codes. The user confirmed that 15 nA is the DAC output current, and chose 10 µs input spikes.
- **AI did** (copies of both files from before the edit were kept outside the repo):
  - `DAC.sch`: branch k uses `m = k+1` unit cells. Each cell is a 0.22/0.28 µm switch and a 1/8 µm current source. Topology unchanged.
    - L was chosen against DIBL. `Isum` sits near 2.5 V while the mirror diode sits near 0.6 V, so with minimum-length devices a 15 nA reference gave 73 nA. At L = 4/8/12 µm the error was +6.7/+4.3/+3.6 %.
    - The estimated unit mismatch from the PDK model is about 5 % (1σ).
  - `DACs-DPI.sch`:
    - The fixed `Vb = 0.5 V` was replaced by `Iref` into a diode-connected unit device `Mref`. `iref` = 14.42 nA is trimmed so that w[0] gives 15.0 nA.
    - Added `VIdac` (DPI side `Isum_dpi`) to measure the DAC current, and `V2 = vtau`.
    - The DPI biases are now Vthr = 2.9 V and Vsg(M3) = 0.40 V (before: 3 V and 0.5 V).
    - New TRAN_SIM: one 10 µs spike every 2 ms; spike k carries code k = 0…15 (B-sources = spike × bit gate). `d1`/`d2`/`d3` select which DACs get the codes. For each code it prints the DAC current, its ratio to the unit, the error against the ideal weight sum, the charge per spike net of leakage, and the Isyn peak.
- **Simulated results (tt, 27 °C, x1 only):**
  - Unit current 15.006 nA. The current of every code is within 0.20 % of the ideal weight sum; code 15 = 10.02 units = 150.4 nA.
  - Charge per spike 0.152 pC (code 1) to 1.59 pC (code 15).
  - Isyn peak 0.32 nA (code 1) to 8.7 nA (code 15).
  - With all three DACs on the same code: 45.07 nA (code 1) and 451 nA (code 15), i.e. exact summation.
- **AI found:**
  - DAC leakage with all switches off is 96 pA in total, about 3 pA per minimum-length switch cell; the test subtracts it per window.
  - With branch weights 1:2:3:4 the 16 codes give only 11 distinct weights (0–10); for example codes 3 and 4 both give 3.
  - As in the DPI itself, the switch bulks are tied to their sources, which needs isolated p-wells on silicon.
- **Not done:** corners, temperature and mismatch for the DAC; it is not yet in the `analog/testbenches` runner.

**46. DAC + DPI driving `neuron_sized`: input spikes needed to fire** *(Simulated)*
- **Asked:** a testbench that connects the DAC + DPI to the newest sized neuron (`neuron_sized`, entry 42) and shows the series of inputs that makes it spike; for example, 10 spikes of weight 2. The user chose a 5 kHz input rate (10 µs spikes every 200 µs).
- **AI did:**
  - Created `analog/neuron/DACs-DPI-neuron.sch` by script: the three DACs, the Vb reference and the DPI from `DACs-DPI.sch`, plus `neuron_sized` and its bias sources from `neuron_sized_testbench.sch` (same values).
    - The DPI output drives VMEM through the ammeter `VIsyn`. The DPI's VT net is renamed `VT_dpi`, so it does not clash with the neuron's VT (1.66 V). MIM cap models were added.
    - Symbols use `analog/neuron/...` paths (see entry 47 for launching xschem).
  - Parameters `code1`/`code2`/`code3` (0–15) set the code that each DAC receives on every input spike; also `tsp` and `tpw`.
  - The test prints VMEM before each next input spike and the DPI peak per interval, up to the input spike on which the neuron first fires, then the number of input spikes per output spike.
  - Tuned Vthr (DPI gain) to 2.909 V so that code 2 (weight 2, 30 nA) first fires the neuron on input spike 10. Neuron biases and the 15 nA DAC unit are unchanged.
- **Simulated results (tt, 27 °C, 5 kHz, x1 only):**
  - Code 2: VMEM climbs 0.05 → 1.60 V over inputs 1–9; the neuron fires 71 µs after input 10.
  - After the first output it fires once per 7.0 input spikes, because the DPI current does not reset with the neuron.
  - Input spike that first fires, by weight 1–10: never, 10, 6, 5, 4, 4, 3, 3, 3, 2. Steady-state inputs per output for weights 2–10: 7.0, 4.0, 2.9, 2.2, 1.8, 1.6, 1.4, 1.2, 1.1.
  - Sensitivity: Vthr 2.907 / 2.911 V gives 9 / 11 input spikes, so the count of 10 holds over only a ~4 mV window.
- **AI found:**
  - With `uic`, the DPI's Vsyn starts away from its operating point and injects a 0.73 µA glitch into VMEM at t = 0, which shifted the count by one spike. The testbench uses an operating point with `.ic v(VMEM)=0 v(spike)=0` instead.
  - With the default trapezoidal integration, `i(VIsyn)` rang by ±0.2 nA from step to step after each reset (VMEM was smooth). `.options method=gear` removes this; the results are unchanged (71 µs vs 73 µs latency).
  - Isyn falls as VMEM rises (2.19 → 1.74 nA peak over inputs 4–9), because the minimum-size DPI output pFET has a low output resistance.
  - A first scratch copy left the `VKup` source floating; this was caught and fixed before the results above.
- **Not done:** corners, temperature and mismatch for the chain. Given the 4 mV Vthr window, these will move the count substantially.

**47. "The system does not work": missing spike amplifier in the GUI run** *(Simulated)*
- **Reported:** the plots from `DACs-DPI-neuron.sch` showed that the system did not work.
- **AI found:**
  - The netlist that the user's xschem session wrote (`~/.xschem/simulations/DACs-DPI-neuron.spice`) contained `x1 - spike_amplifier IS MISSING`. Inside `neuron_sized.sch` the amplifier is placed as `analog/neuron/spike_amplifier.sym`, which did not resolve in that session (entry 32 describes the same problem).
  - Without the amplifier the neuron has no comparator. Re-running that exact netlist: v(spike) stays at 3 µV and the neuron never fires. The batch runs in entry 46 were netlisted from the project root, where the symbol resolves.
  - The project mixes two reference styles. `DACs-DPI`, `DAC_tb` and `neuron_5khz*` use bare names (`DAC.sym`), which resolve only when xschem starts in `analog/neuron`. `neuron`, `neuron_sized*` and the new testbenches use `analog/neuron/X.sym`, which resolves only from the project root. Tested headless: from either folder, the schematics in the other style had missing symbols.
  - A local `xschemrc` replaces `~/.xschem/xschemrc` rather than adding to it, so it has to load the PDK setup itself.
- **AI did:**
  - Added `xschemrc` at the project root. It sources the PDK xschemrc (as `~/.xschem/xschemrc` does), then appends the project root and `analog/neuron` to `XSCHEM_LIBRARY_PATH`. The root is computed from the file's own location, so other checkouts work too.
  - Added `analog/neuron/xschemrc`, which sources the root file.
  - No schematic was changed.
- **Verified:** from both the project root and `analog/neuron`, these netlist with no missing symbols: `DACs-DPI-neuron`, `neuron_sized_testbench`, `DACs-DPI`, `neuron_5khz_testbench`, `neuron_testbench`, `DAC_tb`. Netlisted from `analog/neuron`, `DACs-DPI-neuron` again fires on input spike 10, then once per 7.0 input spikes.
- **Note:** xschem must be restarted to read the new `xschemrc`.

**48. DAC enable switch driven by the previous section's spike** *(Simulated)*
- **Asked:** add an enable transistor and `en` pin to the DAC; hold the weights static in `DACs-DPI-neuron.sch` and drive `en` with the spike train; compare the charge per spike and the spikes-to-fire count with the previous setup, in which the weight bits themselves were pulsed.
- **AI did** (copies of `DAC.sch`, `DAC.sym`, `DACs-DPI.sch` and `DACs-DPI-neuron.sch` from before the edit were kept outside the repo):
  - `DAC.sch`: added `Men` (0.22/0.28 µm) with drain `Isum`, gate `en`, source the shared branch node `X`, and bulk at GND (not tied to its source as the other switches are, so it can be built on p-substrate). Added an `en` input pin.
  - `DAC.sym`: added the `en` pin below `w[3:0]`. The subcircuit is now `DAC Isum Vb w[3] w[2] w[1] w[0] en`.
  - `DACs-DPI.sch`: tied `en` of all three DACs to VDD, so its code test (which still pulses the bits) keeps working.
  - `DACs-DPI-neuron.sch` (the user's saved copy; its netlist was first confirmed identical to the generated one):
    - The weight bits are now static sources at `code1`–`code3`, and `Ven0`–`Ven2` pulse `en0`–`en2` (10 µs every 200 µs).
    - Added a measurement of DAC charge per input spike (spike 2, with leakage between spikes removed).
    - Vthr is unchanged at 2.909 V.
- **Simulated comparison (tt, 27 °C, 5 kHz, x1 only; before = weight bits pulsed, after = static bits, pulsed `en`):**

  | Weight (code) | Charge/spike before → after | First firing input before → after | Inputs per output before → after |
  |---|---|---|---|
  | 1 (1) | 153.5 → 167.7 fC (+9.2 %) | never → 30 | – → – |
  | 2 (2) | 308.7 → 322.4 fC (+4.4 %) | 10 → 10 (71 → 111 µs after it) | 7.05 → 6.20 |
  | 4 (8) | 622.2 → 635.7 fC (+2.2 %) | 5 → 5 | 2.89 → 2.65 |
  | 10 (15) | 1589 → 1599 fC (+0.6 %) | 2 → 2 | 1.15 → 1.08 |

  - The extra charge is about the same at every weight (+10 to +14 fC), as expected from recharging node `X` and the branch nodes (about 5–6 fF) from `Isum` each time `en` rises. The AI's estimate before simulating was 7–8 fC.
  - DAC leakage between spikes fell from 93 pA to 8.7 pA, because the off-state leakage now goes through one `Men` per DAC instead of 10 unit switches.
  - `DACs-DPI` code test with `en` = VDD: unit current 15.009 nA, worst code error 0.11 % (before: 15.006 nA, 0.20 %), so `Men` does not disturb the 1:2:3:4 ratios.
- **AI found:**
  - Weight 2 still first fires on input 10, but now 111 µs after it instead of 71 µs, so there is less margin before input 11.
  - Weight 1 now fires after 30 inputs. Its 9 % larger charge per spike tips it over the neuron's leak.
- **Limitation:** `en` is driven by an ideal pulse with 10 ns edges. A real neuron spike has slower edges, and `Men` conducts from about 0.8–1 V on its gate, so the charge per spike would follow the presynaptic spike shape. This is not simulated yet.

### 2026-11-08

**49. How the 3-5-1 SNN computes (ML principles)** *(Reasoned / Estimate)*
- **Asked:** explain the machine-learning principles behind the 3-5-1 SNN; the user knows the circuits but not how a computation is done.
- **AI explained:**
  - Rate coding: each neuron computes output rate = f(Σ weight × input rate − leak), the same form as an artificial neuron y = f(Σ w·x + b). Spike × DAC current is the multiply, KCL at VMEM the sum, the leak (Vlk) the bias, and integrate-and-fire the activation function.
  - Entry 46's steady-state results, converted to output rate at 5 kHz input, trace that activation function: about 0 for weight 1, then roughly 0.5 kHz per weight unit (0.71 kHz at weight 2 to 4.5 kHz at weight 10), i.e. close to a ReLU.
  - Layer roles: input neurons encode in[2:0] as spike rates, hidden neurons act as feature detectors (e.g. AND of two inputs when one input alone sits below the leak), and the output neuron combines them (e.g. OR), giving a classifier over the 8 input patterns. Worked example: 2-of-3 majority.
  - With only unsigned (excitatory) weights the network is monotone: it can compute AND, OR, majority and other monotone functions of the 3 inputs, but not XOR or NOT. Those need inhibitory synapses.
  - Weights are found offline (by hand or by training a software rate model with non-negative, quantized weights) and loaded into `rf`; there is no on-chip learning.
- **AI found / estimated:**
  - *(Estimate)* Rates fall from layer to layer. A hidden neuron firing at 0.7 kHz into a weight-10 synapse gives about 1.1 nA average, close to the leak level that weight 1 at 5 kHz (≈ 0.76 nA) fails to overcome, so the output neuron would barely fire.
  - The behavioural mock `analog/mock/neuron.v` has no leak, so in the mock any nonzero input eventually fires a neuron and the AND behaviour cannot appear.
  - `rf` stores 3-bit weights, while `DAC.sym` now takes a 4-bit code `w[3:0]` (entry 48).
- **Not done by AI:** no file other than this log was changed; nothing was simulated for this entry.

**49a. Mixed-signal simulation of `snn_top`** *(Simulated)*
- **Asked:** a mixed-signal simulation that swaps every digital (mock) block for its analog version where one exists. The user chose: Verilog `pulse_gen`, an xschem schematic for the network, SpiceBind to couple Icarus and ngspice, and, as step 1, a mock that follows the analog 4-bit weight format (binary 1:2:4:8).
- **AI did:**
  - Mock and `rf`/`snn_top`/testbenches: 4-bit binary weights (23 × 4 = 92 bits). Mock testbenches pass.
  - `analog/snn/snn_analog.sch`/`.sym`: 3 input sections (pulse → DAC → DPI → neuron), 5 hidden (3 DACs each), 1 output (5 DACs); one DPI per neuron on a shared `Isum`, DPI `Isyn` on VMEM; shared biases.
  - `mixed/`: Verilog testbench `snn_ms_tb.v` (`rf`, `pulse_gen`, the scenarios of `tb_snn_top.v`), SPICE testbench `snn_ms_tb.sch` with the biases of `DACs-DPI-neuron.sch`, Makefile, README.
- **AI found** (details in `mixed/README.md`):
  - ngspice crashed at start: uid 1000 has no passwd entry and `ngSpice_Init` dereferences `getpwuid()` unchecked. Fixed with an `LD_PRELOAD` shim.
  - A `.param` with the same name as a net (`VT`, `Vamp_bias`, …) made ngspice rename that net to `{vt}` on the long instance line, leaving the neuron biases floating. Parameters are now `p_*`. `DACs-DPI-neuron.sch` uses the same names but was checked and is not affected.
  - A `.tran` stop time of 1 s made ngspice reserve memory for 10⁷ points per trace and segfault depending on free memory; it is now 100 ms.
  - The first `pulse_gen` cut the first pulse short when `en` rose mid-cycle (a 5 µs pulse instead of 10 µs). The digital `pulse_gen` samples `en` at period boundaries, so pulses always have full width.
  - xschem returns exit code 10 after a good netlist.
- **Simulated results (tt, 27 °C, about 20 ms, 221 s):** all 4 scenarios pass. Scenario 3 run alone with a 2 ms settle: 415 / 727 / 1020 µs against 412 / 722 / 996 µs in pure ngspice with ideal sources.
- **Limitations found:**
  - First-spike times depend on history: two full runs differing by a 50 µs shift gave 393 / 699 / 986 µs and 416 / 729 / 1032 µs for scenario 3, and 287 and 153 µs for in1 in scenario 4.
  - At a 0.02 µs step SpiceBind is 4–5 % early while pure ngspice does not move.
  - There is no analog reset, and a 2 ms settle leaves charge on the membranes for the next scenario; unused membranes start far from 0 at the operating point.
  - `DAC.sch` is still 1:2:3:4 while the mock is binary (the scenarios only use codes 0 and 15).
- **Not done:** corners, temperature, mismatch; no existing analog schematic was changed.

**50. Readiness of the analog blocks for a full 3-5-1 SNN** *(Reasoned)*
- **Asked:** whether all analog components are ready and sized to work as an SNN.
- **AI's assessment (from the files and entries 42–48; nothing simulated): not yet.**
  - Sized and simulated at tt / 27 °C only: `neuron_sized` (entry 42), the DAC (entries 45, 48), the DPI biases (entries 43, 46), and one DAC → DPI → neuron chain driven by ideal 10 µs enable pulses (entries 46, 48).
  - Missing:
    - no top-level 3-5-1 schematic (9 neurons, 9 DPIs, 23 DACs);
    - no test of a real neuron spike driving the next layer's DAC `en`, including fan-out to 5 DACs;
    - no analog input pulse generator (it exists only in the Verilog mock);
    - all biases are ideal sources, with no on-chip generation or pin plan;
    - no corners, temperature or mismatch runs for the neuron, DAC or chain.
  - Known risks:
    - the DPI's minimum-size devices give gain std/mean ≈ 1.1 under mismatch;
    - with fixed biases, τ spans 2.9 µs to 15 ms across corners;
    - the weight-2 spike count shifts within a 4 mV Vthr window;
    - firing rates fall layer to layer (entry 49);
    - `rf` is 3-bit while the DAC takes a 4-bit code.
- **Not done by AI:** no file other than this log was changed.

**51. Layout of `neuron_sized` in KLayout: started, then stopped by the user** *(no result)*
- **Asked:** build a KLayout layout of `neuron_sized`. The user chose full DRC + LVS clean, `analog/neuron/layout/`, and approved running tools in the container.
- **AI did:** netlisted `neuron_sized` into `/tmp/claude_layout` in the container (12 FETs + the 5-FET spike amplifier, MIM caps C1 10 × 10 µm and C2 22.18 × 22.18 µm), and confirmed KLayout 0.30.8 with the gf180mcuD PCells, DRC and LVS decks. The user stopped the work while the AI was reading the PCell code.
- **Not done:** no layout and no file in the repo.

**52. High-level SNN architecture: signals, blocks, computation, training** *(Reasoned)*
- **Asked:** what the inputs are, how DAC / DPI / neuron fit together, how a computation is executed, and how training works.
- **AI explained** (with a diagram of one synapse chain):
  - Inputs: `in[2:0]` are static digital bits turned into 5 kHz spike trains; the weights are 23 static codes in `rf`; the biases are DC voltages. Internal signals are 10 µs spikes; the answer is the output neuron's spike count.
  - Per connection: spike → DAC `en` (weight × 15 nA) → shared `Isum` (sums all of a neuron's inputs) → one DPI per neuron (smooths to Isyn, τ ≈ 0.4 ms) → neuron (integrates against the leak, fires, resets) → spike drives the next layer's DACs. Totals: 9 neurons, 9 DPIs, 23 DACs.
  - Computation is asynchronous: load the weights, set the inputs, wait a few ms, and count output spikes. It is a classifier over the 8 input patterns.
  - Training is offline: the 8-pattern truth table is the dataset; a software rate model built from the entry-46 data, with non-negative integer weights; then hand design, search or gradient descent with rounding; verification in SPICE and chip-in-the-loop adjustment. Excitatory-only weights limit the network to monotone functions.
- **Not done by AI:** no file other than this log was changed.

**53. Can the SNN solve XOR?** *(Reasoned)*
- **Asked:** whether this SNN can be used for an XOR problem.
- **AI explained:** not as designed. All synapses are excitatory, so the network is monotone, while XOR must turn off when the second input turns on. No set of weights can fix this.
- **AI proposed:** XOR = H1 (OR of in0, in1) excitatory to the output, minus H2 (AND) inhibitory. The smallest change is one inhibitory (current-sinking) DPI on the output neuron, plus sign-select switches on the 5 hidden→output DACs and a sign bit for each in `rf`.
- **Cautions:** the OR neuron fires before the AND neuron, so the output may spike briefly for (1,1); count spikes after a delay or above a threshold. The inhibitory weight must outweigh H1's two-input rate. The alternative, complement input encoding, needs 4 input lines.
- **Not done by AI:** no file other than this log was changed.

**54. What the current (excitatory-only) SNN can compute** *(Reasoned)*
- **Asked:** what kind of computation the SNN can do now.
- **AI explained:**
  - As a binary classifier it computes the monotone Boolean functions of 3 inputs that are off for input 000: 18 non-constant ones plus constant 0. These are copy, 2- and 3-input OR, 2- and 3-input AND, majority, a+bc and a(b+c), with their permutations. Constant 1 is impossible because no inputs means no spikes.
  - For 3 inputs, every one of these is a threshold function, so a single neuron can compute each (weights and threshold given). The hidden layer adds margin and parallel readouts (`out[7:3]`), not new functions.
  - Not possible: XOR, parity, NOT, a·¬b, NAND, "exactly one".
  - The output rate also gives a graded weighted score, with at most 8 values for binary inputs. Variable-rate inputs would turn the network into a positive-weight ReLU model.
  - Input-layer weights set the effective scale between hidden weights and the leak. Margins are easiest for 0-vs-1 inputs, moderate for 1-vs-2, and tightest for 2-vs-3.
- **Not done by AI:** no file other than this log was changed.

**55. Worked XOR example (A = 1, B = 0) and an analogy** *(Reasoned / Estimate)*
- **Asked:** a concrete example of how the network turns A = 1, B = 0 (and a reference) into an output that reads as XOR, plus an analogy.
- **AI explained:**
  - The example uses the proposed network with one inhibitory synapse (entry 53), since the current chip cannot compute XOR. Weights: input 10/10; H1 (OR) 6/6; H2 (AND) 1/1; output +10 from H1 and inhibitory from H2.
  - The "reference" is each neuron's leak (Vlk); an always-on input would not enable XOR.
  - *(Estimate, scaled from the entry-46 rate data)* Timeline: input A fires from ~0.3 ms at ~4.5 kHz; H1 fires from ~1 ms at ~2.5 kHz; H2 stays silent (weight 1 alone is below the leak); the output fires from ~1.5 ms at ~2.3 kHz. Counting output spikes over 2–10 ms gives ~18, read as 1. Also gave a spike raster and a table of all four input cases.
  - Analogy: neurons as leaky tipping buckets (water level = VMEM, hole = leak, tip = spike, pipe width = weight, a pump = inhibition). The OR bucket has wide pipes, the AND bucket thin ones, and the AND bucket's tips run a pump that drains the output bucket.
- **Not done by AI:** no file other than this log was changed; nothing was simulated.

**56. Why use an SNN for XOR instead of a logic gate?** *(Reasoned / Estimate)*
- **Asked:** why use an SNN when an XOR circuit would do.
- **AI explained:**
  - For XOR alone, a gate wins on every metric. *(Estimates)* A gate is ~10 transistors, ~0.1 ns and ~fJ per answer; the SNN takes a few ms and ~10 nJ per answer (9 × 0.38 µW × ~5 ms), with ≈ 5,000 µm² of capacitors. A 3-input lookup table also beats it as a reprogrammable function.
  - XOR is a demonstrator (Minsky and Papert, 1969): it shows the network has layers, a nonlinearity and inhibition.
  - Claimed SNN advantages appear at scale on sensory or temporal data: multiply-accumulate by current summation, event-driven power, native spiking sensors, and functions learned from data. Whether SNNs beat digital accelerators is still debated.
  - Suggested report framing: XOR as verification, merit argued from block-level costs; a coincidence-detection or rate-coded task as a better showcase.
- **Not done by AI:** no file other than this log was changed.

**57. New thread: AI-generated KLayout layouts — tooling check** *(Analysed)*
- **Asked:** the user started a thread on having the AI generate KLayout layouts.
- **AI did:** surveyed the repo (no analog layout exists yet; only `librelane/snn_top/results/snn_top.gds` from the digital flow). It checked the container read-only: KLayout 0.30.8, gf180mcuD PCells (`fet`, `cap_mim`, `res`, …) under `libs.tech/klayout/tech/pymacros/cells`, the DRC deck (`run_drc.py`) and the LVS deck (`run_lvs.py`, with an xschem-to-KLayout SPICE converter), and gdsfactory 9.40.1. It noted that entry 51 (`neuron_sized`) was stopped before any layout was made.
- **Proposed:** scripted layout with KLayout Python (PCell instances → placement → routing on Metal1/Metal2 → pins), then DRC and LVS in the container against the xschem netlist. Start with a small block (DPI or DAC) before `neuron_sized`.
- **Not done by AI:** no file other than this log was changed; no layout made yet.

**58. DPI layout in KLayout, DRC + LVS clean, and a pin map for top-level integration** *(Analysed / tool-verified)*
- **Asked:** lay out the DPI synapse, then write a document with the pin coordinates for top-level integration. The user approved running tools in the container and adding files under `analog/neuron/layout/`.
- **AI did:** wrote a scripted layout (`gen_dpi.py`, KLayout Python + gf180mcuD PCells), ran the PDK's KLayout DRC (variant D, incl. off-grid) and LVS in the container, and iterated until both passed. The cell is 28.0 × 26.0 µm. The four FETs are W/L 0.22/0.28 as in `DPI.sch`. C4 is a MIM cap (Metal4–Metal5, 22.36 µm square, extracted at 0.99994 pF) over the transistors.
- **Design decisions the AI made:**
  - `DPI.sch` ties the NFET bodies to Isum, so M1/M2 sit in an LVPWELL inside a deep N-well (tied to VDD). The PDK then needs a P+ guard ring at substrate potential (DN.3), which is exposed as a new **VSS** pin.
  - The cap bottom plate goes to VDD and the top plate to net1. Both plates are reached from Metal5 through via stacks outside the cap (MIMTM.10).
- **Problems found and fixed:** off-grid M1 pads from the PDK FET generator (snapped to 5 nm); M2 spacing at the gate pads; M5 spacing to the wide top plate; DF.13 only counting taps inside NWELL; and the LVS deck ignoring Via2/Via3 under FuseTop, so routing under the cap uses only M1/M2.
- **Results:** DRC clean. LVS: "Netlists match" against `DPI_lvs_ref.spice` (the `DPI.sch` netlist with C4 as `cap_mim_2f0fF` and a VSS port). The `mslot` DRC table crashes because of a bug in the PDK deck; its only rule (metal > 30 µm must be slotted) does not apply here.
- **Integration document:** Claude Doc "DPI Layout — Pin Map for Top-Level Integration" (https://claude.ai/artifact/DZ2f6AuVjDpGHJJsQYuzQQ). Pins: Isum, Vthr, VT on the left edge; Isyn, VDD on the right edge, all Metal2; VSS on the Metal1 ring. Also covers keep-outs and abutment.
- **Open for the user:** whether to add a VSS pin to `DPI.sym` (or tie the NFET bodies to ground instead). The layout has not been simulated with parasitics.
- **Not done by AI:** `DPI.sch` and `DPI.sym` were not changed.

**59. `neuron_sized` layout in KLayout, DRC + LVS clean, with a VMEM coupling check** *(Analysed / tool-verified)*
- **Asked:** lay out the neuron with emphasis on low coupling onto VMEM, deep N-well for the NMOS, guard rings, dummy transistors for matching, and MIM caps over the transistors.
- **AI did:** wrote `gen_neuron.py` (17 FETs, the spike amplifier flattened as A1–A5, plus C1 and C2), ran the PDK DRC (variant D, incl. off-grid) and LVS in the container until both passed, and wrote `coupling.py`. That script measures VMEM's overlaps and side-runs against every other net from the LVS net geometry. The cell is 64.56 × 32.14 µm.
- **How each emphasis was done:**
  - **VMEM:** no channel track. On the NMOS side it is a Metal2 bus inside the NMOS guard ring, below the transistors. On the PMOS side it is a Metal2 bus inside the PMOS ring. The two meet through the left margin on Metal5 (the C2 top plate). The VMEM devices (M11, M6, A1, M5) sit at the left end, next to the stacks.
  - **Deep N-well:** NMOS in an LVPWELL (VSS) inside one DNWELL (VDD); PMOS in an NWELL in the same DNWELL.
  - **Guard rings:** a P+ ring around the NMOS (VSS), an N+ ring around the PMOS (VDD), and a P+ substrate ring around the DNWELL (VSS, rule DN.3).
  - **Dummies:** DN2/DN3 around the diff pair A1/A2 and DP2/DP3 around the mirror A4/A5. Both pairs are mirrored around their shared source and have poly contacts on both ends. Every row ends in a dummy (DN1/DN4, DP1/DP4).
  - **MIM caps:** C2 (VMEM, 22.18 µm) and C1 (spike, 10 µm) sit on one shared VSS Metal4 bottom plate over the transistors, which also shields the circuit from the top plates.
- **VMEM coupling result (geometry, not capacitance):** zero overlap with any signal net on an adjacent layer. Every signal crossing under VMEM's top plate has the VSS Metal4 plate in between. Same-layer side-runs within 1 µm are short and come only from the terminals of the VMEM devices themselves: amp_n2 4.2 µm (A1 drain), net2 2.2 µm (M5 gate), tail 1.6 µm, spike 0.9 µm (M6 gate), Vlk 0.6 µm, net7 0.4 µm.
- **Problems fixed:** M1 notches at the row-level links; rail straps too close to the second gate contact on the matched devices; contacts at the ring corners.
- **LVS reference:** `neuron_sized_lvs_ref.spice` = the `neuron_sized.sch` devices and nets, with C1/C2 written as `cap_mim_2f0fF` and the 8 dummies added.
- **Not done:** no parasitic extraction or post-layout simulation; no pin-map document yet. `neuron_sized.sch`, `neuron_sized.sym` and `spike_amplifier.*` were not changed.

**60. `neuron_sized` layout, revision 2: dummy rings and shielded switching lines** *(Analysed / tool-verified)*
- **Asked (user's layout review of entry 59):** (1) many parallel M1 lines, which is a problem especially for spike (DC bias lines matter less); (2) the dummies only sat at the row ends. The user wants a ring of dummies around the critical NMOS and PMOS transistors, trading area for matching because the neuron has subthreshold parts.
- **AI did:** rewrote `gen_neuron.py` and regenerated the LVS reference. DRC is clean (variant D, incl. off-grid) and LVS matches ("Congratulations! Netlists match", 17 devices + 2 caps + 46 dummies). The cell grew from 64.56 × 32.14 to 73.76 × 44.85 µm.
- **Dummy rings:** the AI treated as critical the NMOS A1, A2, A3, M7, M8, M10, M11 and the PMOS A4, A5, M9, M12.
  - Each critical row has an identical dummy (same W/L, orientation and x) directly above and below every device, plus end dummies and flank dummies around the diff pair and the mirror.
  - Each critical device therefore has a dummy on all four sides: 3 × 11 NMOS and 3 × 8 PMOS arrays.
  - The critical devices' rail terminals tie into the dummy above, so no M1 has to pass between the rows.
  - The switching devices (M1–M6) moved outside the rings.
- **Parallel lines:**
  - spike, net1 and net2 each get their own channel track with a grounded M1 shield on both sides (VSS below, VDD above).
  - M6 moved next to M1/M2, so spike stays short.
  - The switching devices' S/D stubs were moved 1.0 µm from the gate stub (was 0.35 µm), and the switch devices were spread to a 1.6 µm gap.
  - The DC bias lines remain packed together.
- **Result (geometric, `coupling.py`, same-layer side-run within 1 µm; entry 59 → entry 60):**
  - spike: VKup 20.1 → 0 µm, net2 28.6 → 9.3 µm.
  - net2: VKdn 32.6 → 0, VKup 22.3 → 0 µm.
  - net1: VT 15.3 → 2.4, amp_n2 16.4 → 2.4, tail 10.0 → 0.4 µm.
  - VMEM: unchanged, every side-run ≤ 1.6 µm and only at its own devices.
  - No bias line now runs beside a switching line.
- **Not done:** no parasitic extraction or post-layout simulation.
- **User check:** the user confirmed the AI's choice of critical (ringed) devices on 2026-11-11.

**61. Can Metal3 be used for routing? Are packed DC bias lines OK?** *(Reasoned / Estimate)*
- **Asked:** whether Metal3 is free for routing or used by the MIM cap (is the MIM only between M4 and M5?), and whether closely packed DC bias lines are acceptable.
- **AI explained:**
  - Metal3 is free: with MIM option B the cap is the Metal4 bottom plate plus the FuseTop top plate, contacted by Via4 to Metal5. The cells use Metal3 only for small pads in the via stacks outside the caps.
  - The constraint is the PDK LVS deck, not physics: it drops any Via2/Via3 under FuseTop, so Metal3 may cross under a cap but must change layer outside the FuseTop area. The bottom plate is reachable only from above (MIMTM.10), and other Metal4 must stay ≥ 1.2 µm from it (MIMTM.1).
  - Top-level Metal3 over the neuron sits below the VSS plate, so the plate does not shield it from the cell's own M1/M2. The AI advised keeping switching top-level routes off the neuron and DPI.
  - Packed DC bias lines are acceptable: neighbours that do not move inject nothing. The risk is a switching net coupling onto any bias line, because the bias nodes are high-impedance gate nodes for subthreshold devices.
  - In the current layout, no switching line runs beside a bias line. The remaining contact is net1's vertical M2 stub crossing four bias tracks (Vamp_bias, VIp, VKdn, VKup; 0.16 µm² each). Spike's C1 plate over the bias tracks is screened by the VSS bottom plate.
  - *(Estimate)* About 0.05 fF per crossing against about 10 fF on a bias node gives a transient on the order of 10–20 mV for a 3.3 V step. That is significant for a subthreshold gate if the bias source is high-impedance. Mitigations: low-impedance bias drivers or local decoupling (MOS caps) on the bias lines, or putting net1's track below the bias tracks.
- **Not done by AI:** no files changed other than this log; nothing simulated.

**62. Trade-offs of MOS decoupling caps on the bias lines** *(Reasoned / Estimate)*
- **Asked:** the trade-offs of adding MOS capacitors to decouple the bias lines (versus re-routing net1, entry 61).
- **AI explained:**
  - **Peak vs. charge:** a decap lowers the glitch peak (ΔV = Cc·Vstep / Ctot), but with a resistive bias source the integral ∫ΔV dt = Cc·Vstep·Rsrc does not depend on the decap. It helps (a) when the aggressor pulse is shorter than τ = Rsrc·Ctot, so the rising and falling edges cancel, and (b) by cutting the exponential rectification of large glitches in subthreshold devices. Re-routing lowers Cc itself, which helps in every case.
  - **Settling:** *(Estimate)* a subthreshold diode-connected bias source has Rsrc ≈ n·UT/I ≈ 35 MΩ at 1 nA. With 100 fF, τ ≈ 3.5 µs; at 10 pA it is about 0.35 ms. This slows bias start-up and reprogramming.
  - **Cap type and voltage:** an NMOS inversion cap at a subthreshold gate voltage (below Vth) is in depletion and gives only a fraction of Cox. An accumulation varactor (PDK `cap_nmos_b`/`cap_pmos_b`, to be checked in the PDK docs) or a MIM cap avoids this. MIM is linear but about 2 fF/µm² and needs M4/M5, already used by C1/C2.
  - **Reference rail:** reference the decap to the rail the bias is relative to (NMOS biases to VSS, PMOS biases to VDD). Otherwise supply noise couples into Vgs.
  - **Area:** *(Estimate)* about 5 fF/µm² gate cap; 100 fF per line ≈ 20 µm²; 8 lines ≈ 160 µm² per neuron, × 9 neurons. FEOL area under the MIM caps (the routing channel) could hold some of it.
  - **Leakage:** 3.3 V gate oxide leakage is negligible.
  - **Top level:** bias lines are shared by all neurons and run across the chip, which is likely the larger exposure. Decoupling at the bias generator (or per row) covers that once.
- **Recommendation:** re-route net1 below the bias tracks (no area, lowers Cc); add decoupling at the bias generators, sized so τ is much longer than the aggressor pulse width and much shorter than the bias reprogramming time; per-neuron decaps only if simulation shows a need.
- **Not done by AI:** no files changed other than this log; nothing simulated.

**63. Coordinates of the net1 wiring in `neuron_sized.gds`** *(Analysed)*
- **Asked:** the coordinates of the net1 line.
- **AI did:** read net1's geometry from the LVS database of the current layout (revision 2, entry 60). net1's M1 track is (23.49, 23.41)–(49.54, 23.81) µm, centre y 23.61. Its M2 risers are: from the A2 drain at x 28.94–29.34 (y 11.37–23.81, crossing the Vamp_bias, VIp and VKdn tracks); from the A5 drain at x 23.59–23.99 (y 23.41–33.47, crossing VKup); and to the M1/M3 gates at x 48.41–49.44 (y 11.96–32.87). The shields are at y 22.81 (VSS) and 24.41 (VDD).
- **Not done by AI:** no files changed other than this log.

**64. DAC layout: deep N-well, dummy ring, shielded routing, labelled pins** *(Analysed / tool-verified)*
- **Asked:** a layout of the current bias DAC (`DAC.sch`) with deep N-well for the NMOS, a dummy-transistor ring around the transistors, no parallel routing next to sensitive nodes, and labelled pins.
- **AI did:** wrote `gen_dac.py` and the LVS reference. DRC is clean (variant D, incl. off-grid; the `mslot` table crashes in the PDK deck as before). LVS matches ("Congratulations! Netlists match"; 21 devices + 28 dummies, substrate net GND). Cell: 172.08 × 33.13 µm.
- **Circuit facts used:** the DAC is all NMOS (no PMOS to ring). The weights are multipliers on unit devices: sources M2/M4/M6/M8 = 1/2/3/4 units of W/L 1/8 µm; switches M1/M3/M5/M7 = 1/2/3/4 units of 0.22/0.28 µm. The switches' bodies are tied to their sources (the branch nodes net4/net2/net3/net1); Men's body is GND.
- **Layout:**
  - **Deep N-well:** one DNWELL tied to VDD through an N+ strip. A VDD pin was added because the schematic has none.
  - **Isolated wells:** each branch's switches sit in their own LVPWELL whose P+ ring is the body tap (the branch node). Men and the current-source array sit in grounded LVPWELLs. A P+ substrate ring (GND) surrounds everything.
  - **Dummy ring and common centroid:** the 10 unit sources form a 2 × 5 common-centroid array (upper C D A D C, lower D B C B D), chosen by exhaustive search for centroid error plus a routable drain channel. A full ring of 18 identical dummies (4 × 7 positions) surrounds it. Horizontal centroids are exact; A and B are off by half a row vertically (unavoidable with odd unit counts in 2 rows). Each switch row and Men also have end dummies tied to their well.
  - **Routing:**
    - Switch gates are contacted at the bottom, so w[3:0] and en run in their own channel below the switches, behind a GND shield track.
    - X and Isum run above the switches between GND shield tracks.
    - Vb stays inside the array: M2 on the gate contacts plus a riser to the pin.
    - The branch nodes run in their own channel with a GND shield between each pair (added after the first coupling check showed 75–88 µm side-by-side runs, now 0).
  - **Pins (Metal2 at the edge, labelled):** left Isum, en, w[0]–w[3]; right Vb, VDD, GND. GND is also on the Metal1 substrate ring.
- **Remaining adjacency (geometric):** only inside devices: switch drain/gate/source of neighbouring switches (X–w[3] 8.9 µm, X–net1 6.1 µm) and each unit's drain next to its own Vb gate contact.
- **Open for the user:**
  - add VDD and GND pins to `DAC.sym` (GND is a global in the schematic);
  - the area: 172 × 33 µm per DAC, and the SNN uses 23 DACs. The switch wells could be stacked to shorten the cell if needed.
- **Not done:** no parasitic extraction or post-layout simulation. `DAC.sch` and `DAC.sym` were not changed.
- **User decision (2026-11-11):** keep the DAC as laid out (172 × 33 µm); no compaction of the switch wells.

**65. DAC: parallel horizontal tracks alternate between Metal1 and Metal3** *(Analysed / tool-verified)*
- **Asked:** the DAC layout still had many parallel wires; alternate the parallel horizontal traces between M3 and M1 to reduce coupling capacitance.
- **AI did:** changed `gen_dac.py` so that neighbouring horizontal tracks are never on the same layer (the DAC has no MIM cap, so Via2 is allowed anywhere):
  - X, Isum and the branch nodes move to Metal3, with the GND shields on Metal1 between them.
  - The digital channel alternates en M3, w[0] M1, w[1] M3, w[2] M1, w[3] M3.
  - The M2 stubs land on M3 tracks with Via2.
  - The branch tracks now cross the array guard ring on M3 instead of through M2 jumpers.
  - DRC clean (incl. off-grid), LVS matched, cell size and pin positions unchanged (172.08 × 33.13 µm).
- **Result (geometric, same-layer side-run within 1 µm, before → after):** w[2]–w[3] 60.9 → 4.7 µm, w[1]–w[2] 42.2 → 4.7, w[0]–w[1] 26.3 → 4.7, en–w[0] 13.4 → 4.7 (the remainder is the M2 pin stubs at the cell edge). Total over all signal pairs: 281.5 → 157.6 µm. X, Isum and the branch nodes were already shielded and are unchanged. Their remaining adjacency is short vertical device-level proximity (a switch drain next to a neighbouring switch's source strap or gate; unit drain stubs ending at the Vb gate line), which layer alternation does not affect.
- **Note:** the metric counts only same-layer neighbours; the diagonal M1–M3 coupling that remains is smaller but not zero. No capacitance extraction was run.
- **Not done:** no parasitic extraction or post-layout simulation; not committed.

**66. Binary 1:2:4:8 DAC schematic with fingers** *(Analysed)*
- **Asked:** change the DAC weights from 1:2:3:4 to binary 1:2:4:8, whether fingers can be used, and an updated schematic based on `DAC.sch`.
- **AI did:** created `analog/neuron/DAC_binary.sch` and `DAC_binary.sym` (same pins as `DAC.sym`) by script from `DAC.sch`.
  - Each branch is one multi-finger device with m = 1: switch W = k × 0.22 µm (L 0.28 µm) and current source W = k × 1 µm (L 8 µm), nf = k, for k = 1, 2, 4, 8 (M1/M2, M3/M4, M5/M6, M7/M8).
  - Topology unchanged: switch bodies on the branch nodes; Men's body on GND.
  - Netlisted with xschem: `XM8 net1 Vb GND GND nfet_03v3 L=8u W=8u nf=8`, etc.
- **AI explained:**
  - Fingers and m are electrically equivalent here, because the symbol's W is the total width and AD/AS are computed per finger.
  - Fingers share diffusion, which slightly lowers the drain capacitance on X and the branch nodes.
  - For matching, the layout can still split the 15 unit fingers into a 3 × 5 common-centroid array (A at the centre, B/C/D point-symmetric, so every centroid can be exact), and LVS combines parallel fingers.
  - Full-scale current rises from 10 to 15 units.
  - The repo README plans sign-magnitude weights (3 magnitude bits 1:2:4 plus a sign switch); this schematic follows the user's request for 4 binary bits instead.
- **Not done:** not simulated; existing instances (`DAC_tb`, `DACs-DPI`, `DACs-DPI-neuron`, `snn_analog`) still use `DAC.sym`; the DAC layout still matches the 1:2:3:4 `DAC.sch`.

**67. Simulation of `DAC_binary` (1:2:4:8, fingers) against `DAC` (1:2:3:4)** *(Simulated)*
- **Asked:** simulate the binary DAC schematic (entry 66).
- **AI did:** with the user's approval, wrote a static testbench and Python driver (outside the repo, container `/tmp`) and ran ngspice on both DACs side by side: Iref 14.42 nA into a 1u/8u diode for Vb, V(Isum) = 2.5 V, en = 3.3 V. Runs: all 16 codes; 5 corners × 3 temperatures; 200-run mismatch Monte Carlo (old DAC's m devices expanded into units, since the PDK mismatch model ignores m); output compliance sweep. Results recorded in `analog/neuron/SIM_LOG.md`.
- **Results (tt, 27 °C):**
  - LSB 15.02 nA; full scale 225.2 nA (15 LSB, up from 150.2 nA).
  - INL 0.005 LSB, DNL 0.002 LSB; Monte Carlo DNL max p95 0.27 LSB, monotonic in 200/200 runs.
  - Branch mismatch σ: ×1 3.3 %, ×2 2.5 %, ×4 1.5 %, ×8 0.77 % (area scaling as expected).
  - Full-scale σ across instances 3.4 %; full scale within 1 % for V(Isum) ≥ 2.04 V.
  - Corners: LSB 14.89–15.14 nA; at ff/85 °C the off switches leak 2.3 nA (0.16 LSB offset while en is high).
- **Found:** multi-finger devices need `ngbehavior=hsa` (the container default). A run-directory `.spiceinit` that drops it makes nf devices bin by total W and read about 3.7 % low. The first run hit this; it was corrected and rerun.
- **Not done by AI:** no repo testbench was added; no transient/DPI-chain simulation; `DAC.sch` and its users unchanged.

**68. Layout of the binary DAC (`DAC_binary.sch`)** *(Analysed / tool-verified)*
- **Asked:** lay out the binary 1:2:4:8 DAC (entries 66–67).
- **AI did:** wrote `gen_dac_binary.py` (derived from `gen_dac.py`) and an LVS reference written from the real schematic devices (W = k × unit, nf = k). DRC is clean (variant D, incl. off-grid; `mslot` crashes in the PDK deck as before). LVS matches ("Congratulations! Netlists match", with `--combine`, which merges parallel devices in both netlists so the unit fingers compare against the schematic's multi-finger devices). Cell: 187.88 × 40.70 µm.
- **Layout:**
  - **Common centroid:** the 15 unit sources form a point-symmetric 3 × 5 array (top D C D C D / middle B D A D B / bottom D C D C D; A = ×1 at the centre), chosen from the 89 routable point-symmetric placements. Every branch centroid is exactly at the array centre, and no two same-branch units touch.
  - **Dummy ring:** full, 5 × 7 positions, 20 dummies. The switch rows have 1/2/4/8 unit switches with end dummies.
  - **Wells:** deep N-well with isolated switch wells as in entry 64.
  - **Routing:**
    - Channel A (bottom/middle rows) carries all four branch nodes, track order net3 < net1 < net4 < net2 to satisfy the stacked-drain constraint. Branches C and D also use channel B (middle/top rows) and join on M2 left of the array.
    - Signals are on M3 with GND shields on M1 between them, as in entry 65. The middle row's GND sources strap onto channel A's top shield.
  - **Pins:** unchanged in kind (left Isum, en, w[0]–w[3]; right Vb, VDD, GND).
- **Remaining adjacency (geometric):** only device-level proximity, scaled by the larger branch D: net1–X 36.9 µm and w[3]–X 21.5 µm in the ×8 switch row, and Vb–net1 21.7 µm (unit drain stubs ending at the Vb gate lines). No long horizontal signal-to-signal runs.
- **Not done:** no parasitic extraction or post-layout simulation; the DAC users still instantiate `DAC.sym`.

**69. Binary DAC: full dummy rings around the switch rows** *(Analysed / tool-verified)*
- **Asked:** the weighted switch transistors only had dummies at the row ends; put rings around them, trading area for matching.
- **AI did:** changed `gen_dac_binary.py` so that each switch well (the ×1/×2/×4/×8 switches, and Men) holds a dummy ring: an identical 0.22/0.28 µm dummy directly above and below every device of the row plus the end dummies (3 × (k + 2) positions per branch; 52 new dummies). All are tied to the well's body net (branch node, or GND for Men). Each switch's source/body joins the dummy above it; its X (drain) and gate stubs cross the dummy rows on Metal2.
- **Checks:** DRC clean (incl. off-grid). LVS matched with the extended reference (`DAC_binary_lvs_ref.spice`, `--combine`).
- **Size and pins:** the cell grew in height only, 187.88 × 40.70 → 187.88 × 44.08 µm. Pins moved: Isum y 13.99 → 17.37, Vb 22.79 → 26.17, VDD 35.95 → 39.33, GND (M2) 10.39 → 13.77; w[3:0] and en unchanged.
- **Side effect:** net1–X same-layer adjacency fell from 36.9 to 23.8 µm, because the switch sources now strap to the dummy above instead of running beside the next switch's drain.
- **Not done:** no parasitic extraction or post-layout simulation; not committed.

### 2026-11-11

**DAC_binary layout: current sources moved under the switches** *(Layout, DRC/LVS run)*
- **Asked:** the Vb current-source array sat to the right of the w[3:0] switch islands, which wasted area; move it under them.
- **AI did:** changed the floorplan in `layout/gen_dac_binary.py`:
  - the array is stacked directly below the switch row, right-aligned with island D;
  - a new shielded channel C between the X/Isum channel and the array carries the four branch nodes;
  - one M2 riser per node, left of the array, joins channels C, A and B;
  - an M1 GND spine ties the X/Isum and channel C shields to the array ring, and the array ring is strapped to the substrate ring on the right;
  - the cell is built with the islands below the array and mirrored in y at the end.
  Device placement, the common-centroid pattern and the dummy rings are unchanged.
- **Result:** 187.88 × 44.08 µm (8282 µm²) → 106.58 × 57.12 µm (6088 µm², −26 %). DRC (variant D) clean; LVS match (`--combine`, substrate GND).
  - Pin sides are unchanged: Isum, en and w[3:0] on the left; Vb, VDD and GND on the right. Their y positions moved; see `DAC_binary_pins.json`.
  - Geometric coupling is unchanged for X, Isum, Vb, en and w[3:0]. Each branch node gains 0.64 µm² of overlap where its riser crosses the X/Isum channel.

**70. Purpose of the DPI; is the inhibitory DPI in the repo?** *(Reasoned, from git and file reads)*
- **Asked:** explain the DPI's purpose, and whether an inhibitory DPI is now present (the user was told it had been pushed).
- **AI explained the DPI's roles:**
  - it flips the DAC's sink current into a current sourced into VMEM;
  - it turns 10 µs charge packets into a smooth current lasting ~0.4 ms, which sets the time window in which inputs add up (the basis of AND);
  - Vthr scales all of a neuron's weights at once (gain);
  - its τ current can act as a threshold (the AND "option 2" on the branch);
  - it isolates the DAC from the VMEM swing;
  - one DPI per neuron sums all incoming DACs at `Isum`.
- **AI found:**
  - `DPI_inh.sch/.sym` (`DPI_sized` plus a 1:1 nFET mirror that sinks its current from VMEM), `DAC_signed` and the XOR testbenches (nominal pass; 27/30 under mismatch) exist only on the remote branch `origin/xor-inhibition` (commits b8612ed, ba1eddc, 2026-11-11, author martinatilla). They are not merged into `main` and not in the local checkout.
  - That branch started from cbdcec7, before `main` changed to the 2-2-1 network. A trial merge (`git merge-tree`, nothing written) conflicts in `analog/snn/snn_analog.sch`, `snn_analog.sym`, `mixed/snn_ms_tb.sch` and this log.
  - On `main`, signed weights exist only in the Verilog mock (`mock/dac.v`); the analog `snn_analog.sch` still uses 8 unsigned `DAC`s and 5 `DPI`s. The README TODO lists analog inhibition as open.
  - Entries 49–56 above described the earlier 3-5-1, unsigned network; `main` is now 2-2-1, and the branch implements the XOR from entry 53.
- **Not done by AI:** no merge, branch switch or file change other than this log.

**71. Why a DPI instead of wiring the DAC straight to the membrane** *(Reasoned)*
- **Asked:** an analogy for the DPI's usefulness, and why not connect the DAC current directly to the membrane capacitor.
- **AI explained:**
  - On average a direct connection would deliver similar current (once a pFET DAC fixes the polarity), so the DPI is not strictly required.
  - Analogy: the DAC throws cups of water; the DPI is a rain barrel with a spigot that trickles each cup into the membrane bucket over ~0.4 ms.
  - What the DPI adds:
    - a τ-set window in which inputs add up, separate from the leak;
    - a threshold that rejects one input and passes two (the AND on `origin/xor-inhibition`, 93–96 % yield, against 9–83 % for a leak-only AND in a ~25 mV Vlk window);
    - a gain knob (Vthr) that scales every weight on a neuron at once;
    - a fixed `Isum` voltage, so the DAC current sources are not affected by the VMEM swing;
    - the sink-to-source polarity flip.
  - Cost: about 728 µm² per neuron, mostly the 1 pF capacitor.
  - Included a sketch of the direct vs. DPI current for two spikes 0.15 ms apart.
- **Not done by AI:** no file other than this log was changed.

**72. Illustration of what the DPI does, and a correction to entry 71** *(Reasoned)*
- **Asked:** the user was still unsure why the DPI helps and asked for an illustration.
- **AI explained,** with a three-row before/after sketch (DAC straight to the membrane vs. through a DPI):
  - **Polarity:** the nFET DAC sinks current, so on its own it would pull VMEM down; the DPI sources current into VMEM.
  - **Stable weights:** wired directly, the DAC's output node would be VMEM, so the charge per spike would change as VMEM rises; the DPI holds `Isum` fixed.
  - **AND:** directly, two inputs give exactly 2× one input and the leak must sit in that narrow gap. A DPI in threshold mode gives ≈ 0 for one input and a large current for two, which moves the precise decision onto M3 (sized, with its own bias `VT_hid`) and leaves the leak a wide margin.
  - A pFET DAC wired directly would still integrate, so the DPI's value is reliable weights and a robust AND, not basic function.
- **Correction to entry 71:** the 9–83 % vs. 93–96 % AND yields on `origin/xor-inhibition` both used DPIs (leak-decided vs. DPI-threshold-decided AND). They do not compare a DPI with a direct DAC connection, which has not been simulated.
- **Not done by AI:** no file other than this log was changed.

**73. How to bring the inhibitory DAC + DPI into `main`** *(Reasoned, from git reads)*
- **Asked:** how to pull the inhibiting DAC + DPI from the other branch into the user's.
- **AI found:**
  - `DAC_signed` instantiates the existing `DAC.sym`; `DPI_inh` instantiates `DPI_sized.sym`; `DPI_sized` uses only primitives. `DAC.sch/.sym` and `DPI.sch/.sym` are unchanged on `main` since the branch point (cbdcec7), so the six cell files carry over with no conflicts.
  - `inh_cell_tb` and `hidden_tb` use only those cells plus `DAC`, `DPI` and `neuron_sized`. `xor_tb` uses the branch's 3-5-1 `snn_analog.sym` and does not fit `main`.
- **AI recommended:** copy the files with `git checkout origin/xor-inhibition -- <paths>` instead of merging. Check with `inh_cell_tb` (expected charge ratio ≈ 1.007), then commit with credit to b8612ed. After that, hand-edit `snn_analog.sch` for 2-2-1 (2 `DAC_signed` hidden → output DACs, a `DPI_inh` on the output VMEM, `VT_inh`, optionally `DPI_sized`).
  - Agree with the team on the weight format: `DAC_signed` wraps the 1:2:3:4 DAC with a separate sign pin, while `main` plans sign-magnitude (bit 3) and has `DAC_binary`. Check with the branch author about porting to 2-2-1.
- **Not done by AI:** no git command that changes the repo was run, and no file other than this log was changed.

**74. 2-2-1 SNN schematic with an inhibitory output synapse (`snn_analog_inh`)** *(Analysed / tool-verified by netlisting)*
- **Asked:** an updated SNN schematic with 2 input DACs and neurons, 4 DAC + DPI pairs into 2 hidden neurons, 2 signed DACs with an inhibitory DPI, and the output neuron. The user chose: a new copy (original untouched), separate sign pins `s[1:0]`, an own `VT_inh` bias with shared `Vthr`, and netlisting in the container.
- **AI did:**
  - Created `analog/snn/snn_analog_inh.sch` from `snn_analog.sch` by script.
    - Input and hidden layers unchanged: `DAC` → `DPI` → `neuron_sized`.
    - `xdac4_0` and `xdac4_1` are now `DAC_signed` (sign `s[0]`, `s[1]`; excitatory current to `Isum_4`, inhibitory to the new net `Isum_5`).
    - Added `xdpi5` = `DPI_inh` (Vthr, `VT_inh`, `Isum_5`), whose `Iout` sinks current from `VMEM_4`.
    - Added pins `s[1:0]` and `VT_inh`, and updated the description text.
  - Created `snn_analog_inh.sym`: `snn_analog.sym` plus the two pins, with the box extended downwards.
- **Verified** (netlisting only, in `/tmp/claude_snninh` in the container):
  - every top-level instance connects to the intended named nets, and nothing is reported missing;
  - `DAC_signed` steers its inner `DAC` output `Y` through `XMse`/`XMsi` to `Isum_e`/`Isum_i`;
  - `DPI_inh` is `DPI_sized` plus the 8 µm/2 µm mirror;
  - a scratch wrapper instance has the same 55 pins as the subcircuit.
- **Notes:**
  - The inhibitory path uses `DPI_sized` (inside `DPI_inh`), while the excitatory output DPI is the plain `DPI`, so their nominal gains match but their mismatch differs; `VT_inh` can trim.
  - `DAC_signed` and `DPI_inh` use an internal `GND` label, not the `VSS` pin (as `DAC` already does). This is fine in ngspice; check it for LVS.
  - On `origin/xor-inhibition`, the XOR also needed separate input/hidden DPI biases and `DPI_sized` for the AND; these are not in this schematic.
- **Not done:** no simulation or testbench; `mixed/`, `snn_analog.v`, the digital source of `s[1:0]` and the librelane macro were not updated.

### 2026-11-12

**Layouts for DPI_inh and DAC_signed** *(Layout, DRC/LVS run)*
- **Asked:** build layouts for the inhibitory DPI (`DPI_inh.sch`) and the signed DAC (`DAC_signed.sch`).
- **AI did:**
  - **`gen_dpi.py`:** added `-rd w/l/name` options. At the default sizes the output is the same as before; this was checked polygon by polygon against `DPI.gds`.
  - **New `DPI_sized.gds`** (`DPI_sized.sch`: all four devices 0.88/1.12 µm): 28 × 26 µm, the same footprint as `DPI.gds`.
  - **New `gen_dpi_inh.py` → `DPI_inh.gds`**, 30.10 × 37.66 µm:
    - `DPI_sized` is a subcell, with the Mi1/Mi2 mirror (2/8 µm) below it;
    - the mirror is one row of four rotated devices (dummy, Mi2, Mi1, dummy) in the P substrate, whose guard ring closes onto the DPI's bottom ring side;
    - Im runs to the DPI's Isyn pin on an M2 riser right of the DPI;
    - pins: Vthr, VT, Isum and Iout on the left, VDD on the right, GND on the ring.
  - **New `gen_dac_signed.py` → `DAC_signed.gds`**, 182.08 × 33.13 µm:
    - `DAC.gds` (the 1:2:3:4 DAC that the schematic instantiates) is a subcell, with a 10 µm steering block on its left;
    - Msi/Mse share Y, which goes on M2 to the DAC's Isum stub;
    - the Mni/Mpi inverter sits above them, with Mpi in an N-well whose tap is tied to the left end of the DAC's VDD tap strip;
    - Isum_e, Isum_i and s escape on M3;
    - en and w[3:0] are extended on M2 to the new left edge; Vb, VDD and GND stay on the right.
  - New LVS references (`*_lvs_ref.spice`, hierarchical) and check scripts (`run_dpi_sized_checks.sh`, `run_dpi_inh_checks.sh`, `run_dac_signed_checks.sh`).
- **Checks:** DRC (variant D) is clean for all three. LVS matches for all three, with each subcell matched hierarchically (DPI_inh/DPI_sized, DAC_signed/DAC).
- **Not done by AI:** no post-layout simulation. `DAC_signed` reuses `DAC.gds` unchanged, which still has the side-by-side floorplan that was compacted for `DAC_binary` on 2026-11-11.

**Top-level analog SNN layout (SNN.gds)** *(Layout, DRC/LVS run)*
- **Asked:** build the top-level layout of the SNN's analog components in `SNN.gds` (which held an empty cell `SNN`).
- **AI used** `analog/snn/snn_analog_inh.sch` (the newest schematic, with DAC_signed and DPI_inh):
  - 5 × neuron_sized, 5 × DPI (minimum size, as `DPI.sym`), 1 × DPI_inh, 6 × DAC (1:2:3:4) and 2 × DAC_signed;
  - all blocks are instances of the existing cells.
- **New `layout/gen_snn.py` → `SNN.gds`, 349.54 × 308.28 µm:**
  - one row per neuron (input rows at the bottom, the output row at the top);
  - each row, left to right: supply column (Vb, VDD, VSS), DAC(s) mirrored so their pins face right, channel A (w, en, s, Vthr/VT, row-local Isum), DPI(s), channel B (DPI supplies, VMEM, neuron biases), neuron, channel C (neuron supplies, spike);
  - routing is M2 stubs onto M3 tracks, with nothing routed over a block; the generator checks the spacing of every top-level M2/M3 shape;
  - a bottom channel carries the VDD/VSS M2 buses and the spike[0..3] taps back to the next layer's DAC enables;
  - DPI_inh's Iout reaches VMEM_4 through the gap between DPI4 and DPI_inh;
  - all pins are on the bottom edge (M3, labelled). The blocks' GND is VSS.
- **LVS setup:** block GDS files are read into one layout with SkipNewCell, so that DAC_signed's DAC subcell is the same cell as the plain DACs. Without this, LVS flattened a duplicate `DAC$1` and DAC_signed did not match.
- **New files:** `SNN_lvs_ref.spice` (hierarchical: every block's own LVS reference plus the top-level netlist) and `run_snn_checks.sh`.
- **Checks:** DRC (variant D) clean. LVS matches for all 7 circuits (SNN, neuron_sized, DPI, DPI_inh, DPI_sized, DAC, DAC_signed).
- **Not done by AI:** no coupling or parasitic analysis of the top-level routing (w, spike and the Isum/VMEM nodes share channels A/B), and no post-layout simulation. The DAC column (182 µm) sets the width; `DAC.gds` still has the side-by-side floorplan.

**SNN and DAC_signed layouts switched to the binary DAC** *(Layout, DRC/LVS run)*
- **Asked:** change the layout so that binary DACs are used.
- **AI did:**
  - **`gen_dac_signed.py`:** now uses `DAC_binary.gds` by default (`-rd dac=DAC` gives the old 1:2:3:4 version). DAC_binary is the other way up from DAC (w/en above Isum, VDD tap at the bottom), so the DAC is placed mirrored in y, the steering block is drawn as before and the cell is mirrored back. The inverter rows are now placed relative to the VDD tap. `DAC_signed.gds` is 116.58 × 57.12 µm (was 182.08 × 33.13).
  - **`gen_snn.py`:** the six plain DACs are `DAC_binary` (`-rd dac=DAC` for the old ones).
  - **New `make_snn_lvs_ref.py`:** writes `SNN_lvs_ref.spice` and is called from `run_snn_checks.sh`.
- **Result:** `SNN.gds` is 284.04 × 476.76 µm (0.135 mm², was 349.54 × 308.28 = 0.108 mm²). The binary DAC is narrower but taller (57.1 µm), and two DACs are stacked in rows u2–u4. DRC clean; LVS matches for all 7 circuits.
- **Layout now differs from the schematics:** `DAC_signed.sch` and `snn_analog_inh.sch` still instantiate `DAC.sym` (1:2:3:4, magnitude 0–10). The LVS references say so explicitly. With 1:2:4:8 weights the 4-bit codes mean 0–15 units, so the weight encoding of the digital side and the simulations would change too.

**SNN: spike lines on alternating metal layers** *(Layout, DRC/LVS run)*
- **Asked:** the spike outputs all run parallel to each other; alternate them between Metal3, Metal1 and Metal5.
- **AI did (`gen_snn.py`):**
  - the vertical spike tracks in channel C (spike[0..4]) and channel A (spike[0..3], to the DAC enables) rotate M1 → M5 → M3 (spike[0] M1, [1] M5, [2] M3, [3] M1, [4] M5). The rotation starts on M1 so the end tracks are not on M3 next to the M3 tracks around them (pulse[1], s[0], VSS);
  - the bottom-channel taps that join channels C and A cross those verticals, so they cannot use M1/M3/M5; they alternate M4 / M2, with M4 next to the M2 VDD bus;
  - via stacks connect each M2 stub to its track's layer;
  - the generator's spacing check now covers M1–M5;
  - the spike pins are on their track's layer.
- **Result:** `SNN.gds` is 284.34 × 476.76 µm (+0.3 µm for the 0.5 µm M5 tracks). DRC clean; LVS matches for all 7 circuits.
- **Not done by AI:** no coupling extraction; the change removes same-layer side-by-side runs between spike lines but does not change their pitch (0.8 µm).

**Parasitic extraction of SNN.gds** *(Extracted + simulated)*
- **Asked:** run a parasitic extraction (PEX) on the SNN layout.
- **Tools:** kpex has no gf180mcuD technology file in this container, so Magic 8.3 was used (gf180mcuD tech).
- **New `layout/run_snn_pex.sh` → `layout/PEX/` (the same folder as the teammate's PEX extraction; the file system is case-insensitive):**
  - `SNN_pex_c.spice`: flat, hierarchical net names, every C;
  - `SNN_pex.spice`: `.subckt SNN_flat` with the SNN pins, C ≥ 0.01 fF, for simulation;
  - both have 1271 devices, which matches a hand count of all unit fingers and dummies; Magic's substrate node VSUBS is mapped to VSS.
- **No wire resistance in the outputs:**
  - Magic's `extresist` merged the isolated LVPWELL body nodes (Isum of every DPI, the DAC_signed outputs) into the substrate, which shorts Isum to VSS; the extracted SNN then drew 0.88 mA and latched;
  - the C-only netlists draw 0.5 nA at rest, like the schematic;
  - the wire resistance that extresist computed was < 60 Ω per routed net (ps delays), so it was left out.
- **Results:**
  - **Spike lines:** spike-to-spike coupling is 152 fF with the old all-M3 routing and 33 fF with the M1/M5/M3 rotation.
  - **Spike node load:** total spike-node C is 48–108 fF (in-cell 18.9 fF; the rest is top-level routing to the pins and DAC enables). The spike node is the neuron's C_K (≈ 0.21 pF), so this changes its timing.
  - **Post-layout timing of each neuron** (schematic testbench plus extracted spike and VMEM C, 9.5 nA, tt 27 °C):
    - period 212.5–214.7 µs (spec 190–210);
    - spike width 11.0–12.7 µs (spec 9–11);
    - refractory 17.5–20.7 µs (spec 12–15);
    - spike peak ≥ 3.06 V (OK);
    - all neurons except the output neuron fail width and refractory; even the in-cell 18.9 fF alone pushes refractory to 15.7 µs;
    - spike widths differ by about 15 % between neurons, so the charge per synaptic event differs too.
  - **VMEM:** 36.6–42.6 fF (≈ 4 % of C_mem); switching-net coupling onto VMEM ≤ 0.07 fF.
  - **Isum:** 13–26 fF; the largest coupling is the static sign bit s[1] (2.7–7.2 fF, next to the local Isum track); from spike lines ≤ 0.23 fF (≈ 0.8 fC per 3.3 V edge, < 1 % of a 15 nA × 10 µs LSB packet).
- **Magic instance names:** DPI_j / neuron_sized_j are row 4 − j (DPI_0 is the output row).
- **Not done by AI:** no full post-layout transient of the SNN, and no fix for the spike load. Possible fixes: buffer the spike output inside the neuron, or re-size C1 / VKdn for the loaded node.

**Why the new block testbenches fail at process corners** *(Simulated)*
- **Asked:** look at the newly pulled block testbenches (`analog/testbenches/{neuron,dpi,dac}`); process corners seem to fail.
- **AI found (from the committed results):**
  - `neuron_nominal_tb__robust.md`: 1 of 15 corner/temperature conditions meets the specs; ff 27/85 °C and fs 85 °C do not fire; the period spans 201–757 µs and the spike width 1.6–244 µs.
  - `dpi_pulse_tb.md`: the excitatory gain spans 37.6× across corners.
  - `dac_signed_static_tb.md`: the unit current is 14.86–15.12 nA at every corner (only leakage grows, 1.55 nA at code 0 at ff/85 °C).
- **Cause:** the neuron and DPI testbenches bias subthreshold transistors with fixed gate voltages, so their currents move about 10× per 60–100 mV of threshold shift. The DAC is biased from a reference current into a diode, so its Vb moves instead (0.44–0.76 V across corners) and its current stays put.
- **Check (scratch netlists in the container's `/tmp/cmb`, not in the repo):** the neuron (`neuron_sized`, 9.5 nA DC, 6 ms runs, same spec definitions) at 15 PVT points, run two ways:
  - fixed bias voltages: reproduces the testbench, 1/15 pass, 3 do not fire;
  - each bias generated by its tt-27 °C current (Vlk 0.54 nA, VKdn 34.2 nA, VIp 24.0 nA, Vamp_bias 96.5 nA, VKup 0.55 µA, VNA 5.05 µA, VK 17.5 µA; VT left as a voltage) into a matched diode-connected replica of the bias transistor: all 15 fire; period 180–222 µs, t_spike 6.3–10.9 µs, t_refr 11.9–16.0 µs, neuron power 0.31–0.50 µW (the 76.8 µW of the reference branches excluded); 4/15 pass (tt 27 °C, sf at all three temperatures).
- **The remaining spread:** the period follows the MIM corner (`mim_corner_2p0fF` = 0.9/1.1 at ff/ss, i.e. ±10 % on C_mem at a fixed 9.5 nA input), which a ±5 % period spec cannot absorb; t_spike/t_refr follow C1 and the switching thresholds.
- **Suggested, not done:**
  - generate all subthreshold biases from currents (one on-chip reference plus mirrors, or current inputs at the SNN pins);
  - make the DPI gain a ratio of two reference currents;
  - state corner specs separately from the tt 27 °C targets, or add a trim.
- **Not done by AI:** no repo testbench, schematic or runner changed; DPI current-mode biasing not simulated.

**Current-mode bias cell (`bias_cell`): schematic, layout, verification** *(Simulated + layout, DRC/LVS run)*
- **Asked:** generate a bias cell that sets currents instead of voltages, with schematic and layout.
- **User chose:** one external Iref pin and fixed mirror ratios (no on-chip reference, no trim pins).
- **AI did:**
  - **`analog/neuron/bias_cell.sch` / `.sym`, 25 transistors:**
    - Iref (100 nA) into an NMOS master MN0 (10/8 µm); MNP/MP0 form the PMOS master;
    - each bias is a mirror output into a diode-connected replica of the transistor it drives;
    - PMOS outputs feed NMOS replicas for Vb, Vlk, VKdn, VIp, Vamp_bias and VK; NMOS outputs feed PMOS replicas for VNA, VKup, Vthr, VT_dpi and VT_inh;
    - replicas are exact copies in parallel, because wider or longer replicas did not track the target devices (narrow-width and short-channel effects: a 0.22/1.12 replica of the 0.22/0.28 amplifier tail gave 7 nA instead of 97 nA). VK, VNA and VKup (strong inversion) use long narrow replicas to save current;
    - Vthr comes from a pFET diode, so the DPI gain becomes roughly a ratio of reference currents;
    - VT stays a voltage input.
  - **Sizing:** `analog/testbenches/bias/bias_design.py` sizes every bias to the tuned voltage at tt 27 °C within 0.3 mV. VT_dpi and Vthr use the network's chain preset (VDD − 0.40, 2.909 V); VT_inh uses the DPI_sized output preset (VDD − 0.5096 V). Supply current is 0.72 µA including Iref (2.4 µW, shared by all blocks). The VKdn replica is 4 units, to halve its mismatch.
  - **Layout: `layout/gen_bias.py` → `bias_cell.gds`, 167.4 × 53.5 µm:**
    - two tiers (NMOS row, Iref/vgp gate buses, PMOS row in an N-well), tier A mirrored so the NMOS rows share the VSS P+ rail;
    - one column per bias, with an M3 vertical to the pin;
    - multi-finger PCells with contacts between fingers, gate bars along the outer gate-pad row, Via1 landed directly on the 0.38 µm PCell pads, internal S/D length 0.7 µm, and extra active (dogbone) around the internal contacts of 0.22 µm fingers (CO.4);
    - pins: bias outputs on M3 at the top/bottom edges; Iref, VDD and VSS on M2 at the edges.
    DRC (variant D) clean; LVS match (`--combine`, substrate VSS). `bias_cell_lvs_ref.spice`, `run_bias_checks.sh`.
- **Verification (`analog/testbenches/bias/run_bias_cell.py`, `results/bias_cell.md`):**
  - **neuron_sized** at 9.5 nA over 15 PVT points: with fixed voltages 1/15 pass, 3 do not fire; with the cell, all fire, period 180–222 µs, t_spike 6.2–11.1 µs, t_refr 11.7–16.2 µs, 4/15 pass. The remaining spread is the ±10 % MIM corner and the inverter thresholds.
  - **DPI DC gain:** 0.007–0.92 (137×) with fixed voltages; 0.51–0.93 (1.8×) with the cell.
  - **Mismatch (100 samples):** σ 1.6–6.9 mV on all outputs except Vamp_bias (25 mV, single minimum-size replica; tolerance ≈ 86 mV).
  - **Layout:** the extracted layout (Magic, C only) gives the same voltages as the schematic within 0.4 mV for the subthreshold biases (VK −7 mV, VNA −4 mV, VKup −1 mV from the finger split).
- **Not done by AI:** the cell is not yet connected in the SNN schematic or layout (the SNN still has voltage bias pins); no on-chip reference; DPI_inh / DPI_sized gain over PVT not simulated; no transient test of bias-line disturbance by switching nets.

**SNN layout: bias cell included** *(Layout, DRC/LVS + extracted op)*
- **Asked:** modify the SNN layout to include the bias cell.
- **AI did (`layout/gen_snn.py`, `make_snn_lvs_ref.py`):**
  - placed `bias_cell.gds` above the top row (output row u4), with an 11-track Metal2 channel between them;
  - the cell's bottom-edge outputs (Vamp_bias, VNA, VKup, Vthr, VT_dpi, VT_inh) drop into the channel; its top-edge outputs (Vb, Vlk, VKdn, VIp, VK) go over the cell on M2 and down an M3 corridor on its right;
  - each bias joins the top of its existing track (Vb in column L, Vthr/VT_dpi/VT_inh in channel A, the neuron biases in channel B). The tracks now start at their lowest tap, with no bottom pins;
  - the cell's VDD/VSS (right edge) connect to the channel C supply tracks;
  - a new column L track carries Iref from a bottom-edge pin to the cell's Iref pin.
- **Pins:** 45, all on the bottom edge: VDD, VSS, Iref, w[31:0], pulse[1:0], s[1:0], VT, spike[4:0]. Vb, Vthr, VT_dpi, VT_inh, VNA, Vlk, VK, VIp, VKup, VKdn and Vamp_bias are internal now.
- **Result:** `SNN.gds` is 285.14 × 547.04 µm (was 284.34 × 476.76). DRC (variant D) clean; LVS matches for all 8 circuits, including bias_cell.
- **Extracted SNN (`run_snn_pex.sh`, refreshed; 1394 devices), op at tt 27 °C, Iref 100 nA:** every bias within 0.6 mV of the bias cell's design values (VK −7 mV); idle supply current 0.72 µA.
- **Not done by AI:**
  - `snn_analog_inh.sch` still has the bias pins and no bias cell (the LVS reference says so);
  - no transient check of switching-line coupling onto the long, high-impedance bias tracks;
  - about 105 × 59 µm right of the bias cell is unused.

**Well-bias audit of the SNN layout** *(Analysed / tool-verified)*
- **Asked:** make sure the isolated P-wells are properly biased.
- **AI did:** wrote `layout/well_bias_check.py` (run from `run_snn_checks.sh`, report `layout/SNN_well_bias.md`). For every isolated P-well (LVPWELL), deep N-well, N-well and the substrate, it:
  - finds the wells and their taps from the drawn layers;
  - probes the net of each tap's Metal1 in the LVS database (with schematic names);
  - measures, for each LVPWELL island, the farthest N+ diffusion from a tap in the same island. DRC rule DF.14 accepts any P+ tap within 20 µm, even one in a different well, and no DRC or LVS rule checks that a DNWELL is tied, since it is not a device terminal.
- **Result: no issues.**
  - **59 LVPWELL islands,** each in a DNWELL with one P+ tap ring on its intended net: VSS for the DAC current-source arrays, Men and the neuron NMOS; Isum_0…Isum_5 for the DPI input pairs; DAC_binary NET1–NET4 for the weight-switch islands. Farthest N+ from a same-island tap: 1.4 µm (limit 20 µm).
  - **19 DNWELLs** and **15 NWELLs** (2 in DAC_signed and 2 in the bias cell outside any DNWELL) are tied to VDD; **20 substrate tap rings** are on VSS.
  - **Junction polarity:** every LVPWELL net stays below VDD, and each LVPWELL body is the lowest node of the NMOS it holds (VSS, or body = source for the DPI pairs and the weight switches), so all junctions are reverse-biased or at zero bias.
- **Found while testing the script:** a first version probed the first contact inside a tap's bounding box. For a substrate ring around a whole block that box also holds the block's own contacts, so it reported false substrate ties to NET3 and w[14]. It now probes contacts inside the tap polygon.
- **Not done by AI:** no transient check of the well nodes (for example the Isum or branch-node LVPWELL junction capacitance).

**Spike amplifier sizing (offset, bandwidth, stability, noise)** *(Simulated)*
- **Asked:** the spike amplifier is minimum size; run a sizing for DC offset, bandwidth, stability and input-referred noise.
- **AI did:** `analog/testbenches/spike_amp/amp_char.py` and `run_sweep.py` characterize the 5T OTA as the neuron uses it (comparator: VP = VMEM, VN = VT = 1.66 V, load = inverter 1 + its VIp limit). They measure:
  - systematic offset (DC trip point) and mismatch offset (40 MC samples);
  - open-loop gain, unity-gain frequency, and phase margin in unity-gain feedback (as a stability figure; the amplifier runs open-loop);
  - trip delay on the real VMEM ramp;
  - input-referred noise.
  The tail M3 was kept at 0.22/0.28 so the bias cell's replica stays valid. 320 points swept (`results/spike_amp_sizing.md`).
- **Result, current (all 0.22/0.28) → chosen (pair M1/M2 4/2 µm, mirror M4/M5 0.5/8 µm):**
  - systematic offset −55.9 → −1.2 mV; offset σ 40.5 → 2.6 mV; gain 24.6 → 53.8 dB;
  - fu 97 → 19 MHz; PM 81 → 64°; trip delay 0.03 → 0.66 µs;
  - noise 336 → 60 µV rms (1 Hz–100 kHz), 3.1 → 0.29 µV/√Hz at 1 kHz;
  - area 0.3 → 24 µm².
- **In the neuron (bias cell biases, 9.5 nA):**
  - period mismatch σ 2.88 % → 1.68 % (40 samples);
  - t_spike σ unchanged (set by VKdn);
  - PVT 4/15 → 5/15 pass;
  - nominal period +1.3 % and t_refr 14.71 → 14.99 µs (at its limit), from the added VMEM gate capacitance and the slower trip.
- **Saved:** `analog/neuron/spike_amplifier_sized.sch` / `.sym` (copy).
- **Not done by AI:** `neuron_sized.sch` and the neuron layout still use the minimum-size amplifier; no retune of VKdn for the t_refr margin.

**neuron_sized.sch now uses spike_amplifier_sized** *(Schematic edit, simulated)*
- **Asked:** update only the neuron_sized schematic to use the sized amplifier (no bias-cell retune, no layout change).
- **AI did:** in `analog/neuron/neuron_sized.sch`, instance x1 changed from `spike_amplifier.sym` to `spike_amplifier_sized.sym` (same pins), and a note was added.
- **Checked:** `neuron_sized_testbench.sch` netlists with no missing symbols and gives a period of 204.2 µs at 9.5 nA (was 201.4 µs), as in the sizing study.
- **Now out of step:**
  - `layout/neuron_sized.gds` and `neuron_sized_lvs_ref.spice` still have the minimum-size amplifier, so the neuron (and SNN) layout no longer matches this schematic;
  - t_refr is ≈ 15.0 µs, at its spec limit (VKdn not retuned).

---

## Notes on reliability

- Up to entry 27 the AI ran no SPICE simulation; those simulated numbers came from the user's own ngspice runs. Entries 28, 34, 42, 43–49, 49a and 67 have numbers from ngspice runs the AI made in the user's container, with the user's approval.
- Connectivity was worked out from xschem file coordinates. Where this was uncertain, the AI said so and asked the user to confirm in xschem.
- PDK-specific figures (MIM density and minimum size, standard-cell areas, device thresholds) are from general knowledge and need checking against the GF180 PDK documentation.
- Area figures are planning estimates only, until a layout exists. The DPI now has one (entry 58): 728 µm².
