Latios1928/engn2912e-project/analog/neuron/layout/SNN_well_bias.md

# Well-bias audit: SNN.gds

Generated by `well_bias_check.py`. Nets are probed in the LVS database (`SNN.lvsdb`): `<circuit>/<net>` with the schematic net name.

## Isolated P-wells (LVPWELL)

| # | island (um) | in DNWELL | P+ taps | tap net(s) | N+ diffusions | farthest N+ from a tap in the island (um) |
|---|---|---|---|---|---|---|
| 0 | (22.0, 16.2)-(99.7, 42.1) | DN2 | 1 | SNN/VSS x1 | 35 | 0.00 |
| 1 | (167.1, 16.2)-(173.6, 20.7) | DN0 | 1 | SNN/ISUM_0 x1 | 2 | 1.32 |
| 2 | (208.9, 16.3)-(270.5, 26.9) | DN1 | 1 | SNN/VSS x1 | 36 | 0.00 |
| 3 | (22.0, 53.1)-(53.3, 60.6) | DN2 | 1 | DAC_binary/NET1 x1 | 30 | 0.00 |
| 4 | (55.1, 53.1)-(74.9, 60.6) | DN2 | 1 | DAC_binary/NET3 x1 | 18 | 0.00 |
| 5 | (76.7, 53.1)-(90.7, 60.6) | DN2 | 1 | DAC_binary/NET2 x1 | 12 | 0.00 |
| 6 | (92.5, 53.1)-(103.6, 60.6) | DN2 | 1 | DAC_binary/NET4 x1 | 9 | 0.00 |
| 7 | (105.4, 53.1)-(116.6, 60.6) | DN2 | 1 | SNN/VSS x1 | 9 | 0.00 |
| 8 | (22.0, 75.3)-(99.7, 101.2) | DN5 | 1 | SNN/VSS x1 | 35 | 0.00 |
| 9 | (167.1, 75.3)-(173.6, 79.8) | DN3 | 1 | SNN/ISUM_1 x1 | 2 | 1.32 |
| 10 | (208.9, 75.4)-(270.5, 86.0) | DN4 | 1 | SNN/VSS x1 | 36 | 0.00 |
| 11 | (22.0, 112.2)-(53.3, 119.7) | DN5 | 1 | DAC_binary/NET1 x1 | 30 | 0.00 |
| 12 | (55.1, 112.2)-(74.9, 119.7) | DN5 | 1 | DAC_binary/NET3 x1 | 18 | 0.00 |
| 13 | (76.7, 112.2)-(90.7, 119.7) | DN5 | 1 | DAC_binary/NET2 x1 | 12 | 0.00 |
| 14 | (92.5, 112.2)-(103.6, 119.7) | DN5 | 1 | DAC_binary/NET4 x1 | 9 | 0.00 |
| 15 | (105.4, 112.2)-(116.6, 119.7) | DN5 | 1 | SNN/VSS x1 | 9 | 0.00 |
| 16 | (22.0, 134.4)-(99.7, 160.3) | DN8 | 1 | SNN/VSS x1 | 35 | 0.00 |
| 17 | (167.1, 134.4)-(173.6, 138.9) | DN6 | 1 | SNN/ISUM_2 x1 | 2 | 1.32 |
| 18 | (208.9, 134.5)-(270.5, 145.2) | DN7 | 1 | SNN/VSS x1 | 36 | 0.00 |
| 19 | (22.0, 171.3)-(53.3, 178.9) | DN8 | 1 | DAC_binary/NET1 x1 | 30 | 0.00 |
| 20 | (55.1, 171.3)-(74.9, 178.9) | DN8 | 1 | DAC_binary/NET3 x1 | 18 | 0.00 |
| 21 | (76.7, 171.3)-(90.7, 178.9) | DN8 | 1 | DAC_binary/NET2 x1 | 12 | 0.00 |
| 22 | (92.5, 171.3)-(103.6, 178.9) | DN8 | 1 | DAC_binary/NET4 x1 | 9 | 0.00 |
| 23 | (105.4, 171.3)-(116.6, 178.9) | DN8 | 1 | SNN/VSS x1 | 9 | 0.00 |
| 24 | (22.0, 191.8)-(99.7, 217.6) | DN9 | 1 | SNN/VSS x1 | 35 | 0.00 |
| 25 | (22.0, 228.6)-(53.3, 236.2) | DN9 | 1 | DAC_binary/NET1 x1 | 30 | 0.00 |
| 26 | (55.1, 228.6)-(74.9, 236.2) | DN9 | 1 | DAC_binary/NET3 x1 | 18 | 0.00 |
| 27 | (76.7, 228.6)-(90.7, 236.2) | DN9 | 1 | DAC_binary/NET2 x1 | 12 | 0.00 |
| 28 | (92.5, 228.6)-(103.6, 236.2) | DN9 | 1 | DAC_binary/NET4 x1 | 9 | 0.00 |
| 29 | (105.4, 228.6)-(116.6, 236.2) | DN9 | 1 | SNN/VSS x1 | 9 | 0.00 |
| 30 | (22.0, 250.9)-(99.7, 276.7) | DN12 | 1 | SNN/VSS x1 | 35 | 0.00 |
| 31 | (167.1, 250.9)-(173.6, 255.4) | DN10 | 1 | SNN/ISUM_3 x1 | 2 | 1.32 |
| 32 | (208.9, 251.0)-(270.5, 261.6) | DN11 | 1 | SNN/VSS x1 | 36 | 0.00 |
| 33 | (22.0, 287.7)-(53.3, 295.3) | DN12 | 1 | DAC_binary/NET1 x1 | 30 | 0.00 |
| 34 | (55.1, 287.7)-(74.9, 295.3) | DN12 | 1 | DAC_binary/NET3 x1 | 18 | 0.00 |
| 35 | (76.7, 287.7)-(90.7, 295.3) | DN12 | 1 | DAC_binary/NET2 x1 | 12 | 0.00 |
| 36 | (92.5, 287.7)-(103.6, 295.3) | DN12 | 1 | DAC_binary/NET4 x1 | 9 | 0.00 |
| 37 | (105.4, 287.7)-(116.6, 295.3) | DN12 | 1 | SNN/VSS x1 | 9 | 0.00 |
| 38 | (22.0, 308.2)-(99.7, 334.1) | DN13 | 1 | SNN/VSS x1 | 35 | 0.00 |
| 39 | (22.0, 345.1)-(53.3, 352.6) | DN13 | 1 | DAC_binary/NET1 x1 | 30 | 0.00 |
| 40 | (55.1, 345.1)-(74.9, 352.6) | DN13 | 1 | DAC_binary/NET3 x1 | 18 | 0.00 |
| 41 | (76.7, 345.1)-(90.7, 352.6) | DN13 | 1 | DAC_binary/NET2 x1 | 12 | 0.00 |
| 42 | (92.5, 345.1)-(103.6, 352.6) | DN13 | 1 | DAC_binary/NET4 x1 | 9 | 0.00 |
| 43 | (105.4, 345.1)-(116.6, 352.6) | DN13 | 1 | SNN/VSS x1 | 9 | 0.00 |
| 44 | (12.0, 367.3)-(89.7, 393.2) | DN16 | 1 | SNN/VSS x1 | 35 | 0.00 |
| 45 | (167.1, 367.3)-(173.6, 371.8) | DN14 | 1 | SNN/ISUM_4 x1 | 2 | 1.32 |
| 46 | (208.9, 367.4)-(270.5, 378.0) | DN15 | 1 | SNN/VSS x1 | 36 | 0.00 |
| 47 | (12.0, 404.2)-(43.3, 411.7) | DN16 | 1 | DAC_binary/NET1 x1 | 30 | 0.00 |
| 48 | (45.1, 404.2)-(64.9, 411.7) | DN16 | 1 | DAC_binary/NET3 x1 | 18 | 0.00 |
| 49 | (66.7, 404.2)-(80.7, 411.7) | DN16 | 1 | DAC_binary/NET2 x1 | 12 | 0.00 |
| 50 | (82.5, 404.2)-(93.6, 411.7) | DN16 | 1 | DAC_binary/NET4 x1 | 9 | 0.00 |
| 51 | (95.4, 404.2)-(106.6, 411.7) | DN16 | 1 | SNN/VSS x1 | 9 | 0.00 |
| 52 | (167.1, 407.0)-(175.3, 412.2) | DN17 | 1 | SNN/ISUM_5 x1 | 2 | 1.40 |
| 53 | (12.0, 424.6)-(89.7, 450.5) | DN18 | 1 | SNN/VSS x1 | 35 | 0.00 |
| 54 | (12.0, 461.5)-(43.3, 469.1) | DN18 | 1 | DAC_binary/NET1 x1 | 30 | 0.00 |
| 55 | (45.1, 461.5)-(64.9, 469.1) | DN18 | 1 | DAC_binary/NET3 x1 | 18 | 0.00 |
| 56 | (66.7, 461.5)-(80.7, 469.1) | DN18 | 1 | DAC_binary/NET2 x1 | 12 | 0.00 |
| 57 | (82.5, 461.5)-(93.6, 469.1) | DN18 | 1 | DAC_binary/NET4 x1 | 9 | 0.00 |
| 58 | (95.4, 461.5)-(106.6, 469.1) | DN18 | 1 | SNN/VSS x1 | 9 | 0.00 |

## Deep N-wells (DNWELL)

| # | region (um) | LVPWELL islands inside | N+ taps (outside LVPWELL) | tap net(s) |
|---|---|---|---|---|
| DN0 | (164.6, 13.7)-(185.7, 32.7) | 1 | 1 | SNN/VDD x1 |
| DN1 | (206.4, 13.8)-(273.0, 51.6) | 1 | 1 | SNN/VDD x1 |
| DN2 | (19.5, 13.7)-(119.1, 63.8) | 6 | 1 | SNN/VDD x1 |
| DN3 | (164.6, 72.8)-(185.7, 91.8) | 1 | 1 | SNN/VDD x1 |
| DN4 | (206.4, 72.9)-(273.0, 110.7) | 1 | 1 | SNN/VDD x1 |
| DN5 | (19.5, 72.8)-(119.1, 122.9) | 6 | 1 | SNN/VDD x1 |
| DN6 | (164.6, 131.9)-(185.7, 150.9) | 1 | 1 | SNN/VDD x1 |
| DN7 | (206.4, 132.0)-(273.0, 169.8) | 1 | 1 | SNN/VDD x1 |
| DN8 | (19.5, 131.9)-(119.1, 182.1) | 6 | 1 | SNN/VDD x1 |
| DN9 | (19.5, 189.3)-(119.1, 239.4) | 6 | 1 | SNN/VDD x1 |
| DN10 | (164.6, 248.4)-(185.7, 267.4) | 1 | 1 | SNN/VDD x1 |
| DN11 | (206.4, 248.5)-(273.0, 286.2) | 1 | 1 | SNN/VDD x1 |
| DN12 | (19.5, 248.4)-(119.1, 298.5) | 6 | 1 | SNN/VDD x1 |
| DN13 | (19.5, 305.7)-(119.1, 355.8) | 6 | 1 | SNN/VDD x1 |
| DN14 | (164.6, 364.8)-(185.7, 383.8) | 1 | 1 | SNN/VDD x1 |
| DN15 | (206.4, 364.9)-(273.0, 402.7) | 1 | 1 | SNN/VDD x1 |
| DN16 | (9.5, 364.8)-(109.1, 414.9) | 6 | 1 | SNN/VDD x1 |
| DN17 | (164.6, 404.5)-(185.7, 423.5) | 1 | 1 | SNN/VDD x1 |
| DN18 | (9.5, 422.1)-(109.1, 472.3) | 6 | 1 | SNN/VDD x1 |

## N-wells (NWELL)

| # | region (um) | in DNWELL | N+ taps | tap net(s) |
|---|---|---|---|---|
| NW0 | (166.0, 27.5)-(184.3, 31.6) | yes | 1 | SNN/VDD x1 |
| NW1 | (208.9, 38.3)-(270.5, 49.1) | yes | 1 | SNN/VDD x1 |
| NW2 | (166.0, 86.6)-(184.3, 90.7) | yes | 1 | SNN/VDD x1 |
| NW3 | (208.9, 97.4)-(270.5, 108.2) | yes | 1 | SNN/VDD x1 |
| NW4 | (166.0, 145.7)-(184.3, 149.8) | yes | 1 | SNN/VDD x1 |
| NW5 | (208.9, 156.6)-(270.5, 167.3) | yes | 1 | SNN/VDD x1 |
| NW6 | (166.0, 262.2)-(184.3, 266.3) | yes | 1 | SNN/VDD x1 |
| NW7 | (208.9, 273.0)-(270.5, 283.7) | yes | 1 | SNN/VDD x1 |
| NW8 | (116.0, 365.2)-(119.7, 369.3) | no | 1 | SNN/VDD x1 |
| NW9 | (166.0, 378.6)-(184.3, 382.7) | yes | 1 | SNN/VDD x1 |
| NW10 | (208.9, 389.4)-(270.5, 400.2) | yes | 1 | SNN/VDD x1 |
| NW11 | (166.0, 417.8)-(184.4, 422.4) | yes | 1 | SNN/VDD x1 |
| NW12 | (116.0, 422.5)-(119.7, 426.6) | no | 1 | SNN/VDD x1 |
| NW13 | (6.0, 489.0)-(173.4, 499.5) | no | 1 | SNN/VDD x1 |
| NW14 | (6.0, 529.2)-(173.4, 540.1) | no | 1 | SNN/VDD x1 |

## P substrate

P+ taps outside all wells: 20, nets: SNN/VSS x20

## Junction polarity (this project's body nets)

Every junction must stay reverse-biased (or at zero bias) in operation:

| junction | n side | p side | why it is reverse-biased |
|---|---|---|---|
| DNWELL / P substrate | VDD | VSS | VDD is the highest, VSS the lowest supply |
| DNWELL / LVPWELL | VDD | VSS, Isum_k, DAC branch nodes | every LVPWELL net stays below VDD (Isum_k sits at about 2.0-2.6 V, the branch nodes between 0 V and Isum) |
| N+ S/D / LVPWELL on VSS | S/D of the NMOS (current sources, Men, neuron NMOS) | VSS | VSS is the lowest node |
| N+ S/D / LVPWELL on Isum_k (DPI M1, M2) | sources: Isum_k; drains: VDD, net1 | Isum_k | body = source; both drains are above Isum_k |
| N+ S/D / LVPWELL on a DAC branch node (weight switches) | source: branch node; drain: X | branch node | body = source; the DAC current flows from X into the branch node, so X >= branch node |
| NWELL / P substrate (DAC_signed inverter, bias cell) | VDD | VSS | as above |
| P+ S/D / NWELL or DNWELL (PMOS) | VDD | PMOS S/D | every PMOS S/D is at or below VDD |

Dummy transistors have every terminal on their well's net (zero bias).

## Issues found

None.
