Latios1928/engn2912e-project/analog/neuron/layout/bias_cell.png

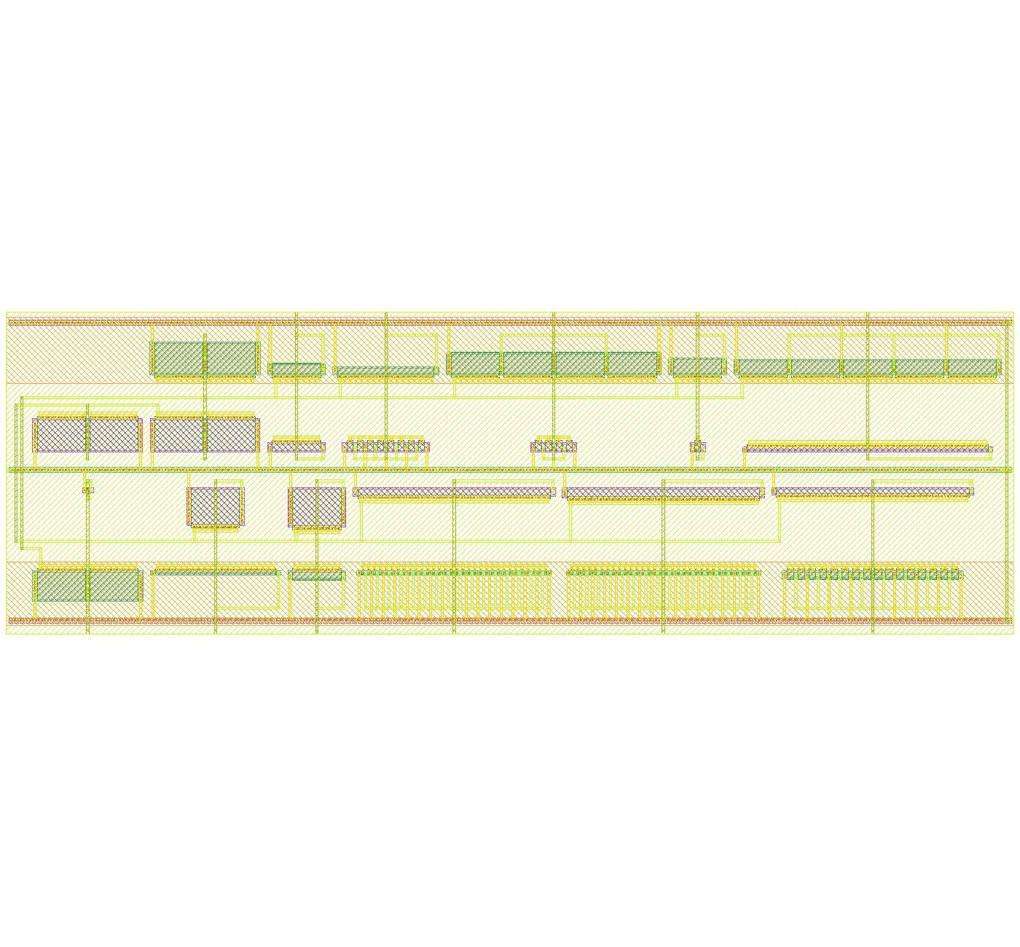
analog/neuron/layout/bias_cell.png
