Latios1928/engn2912e-project/analog/neuron/layout/DAC.png

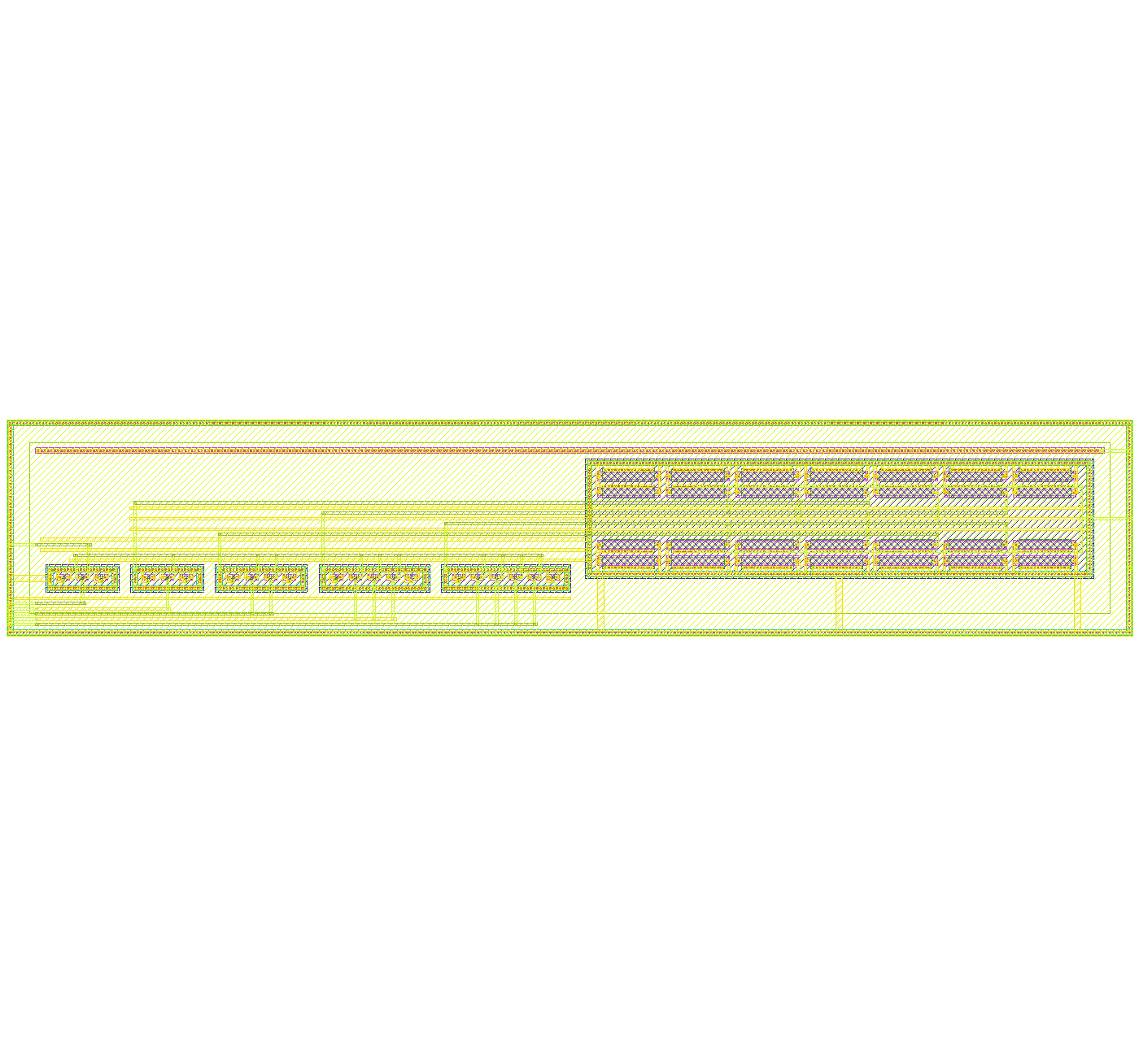
analog/neuron/layout/DAC.png
