Latios1928/engn2912e-project/analog/neuron/layout/DAC_binary.png

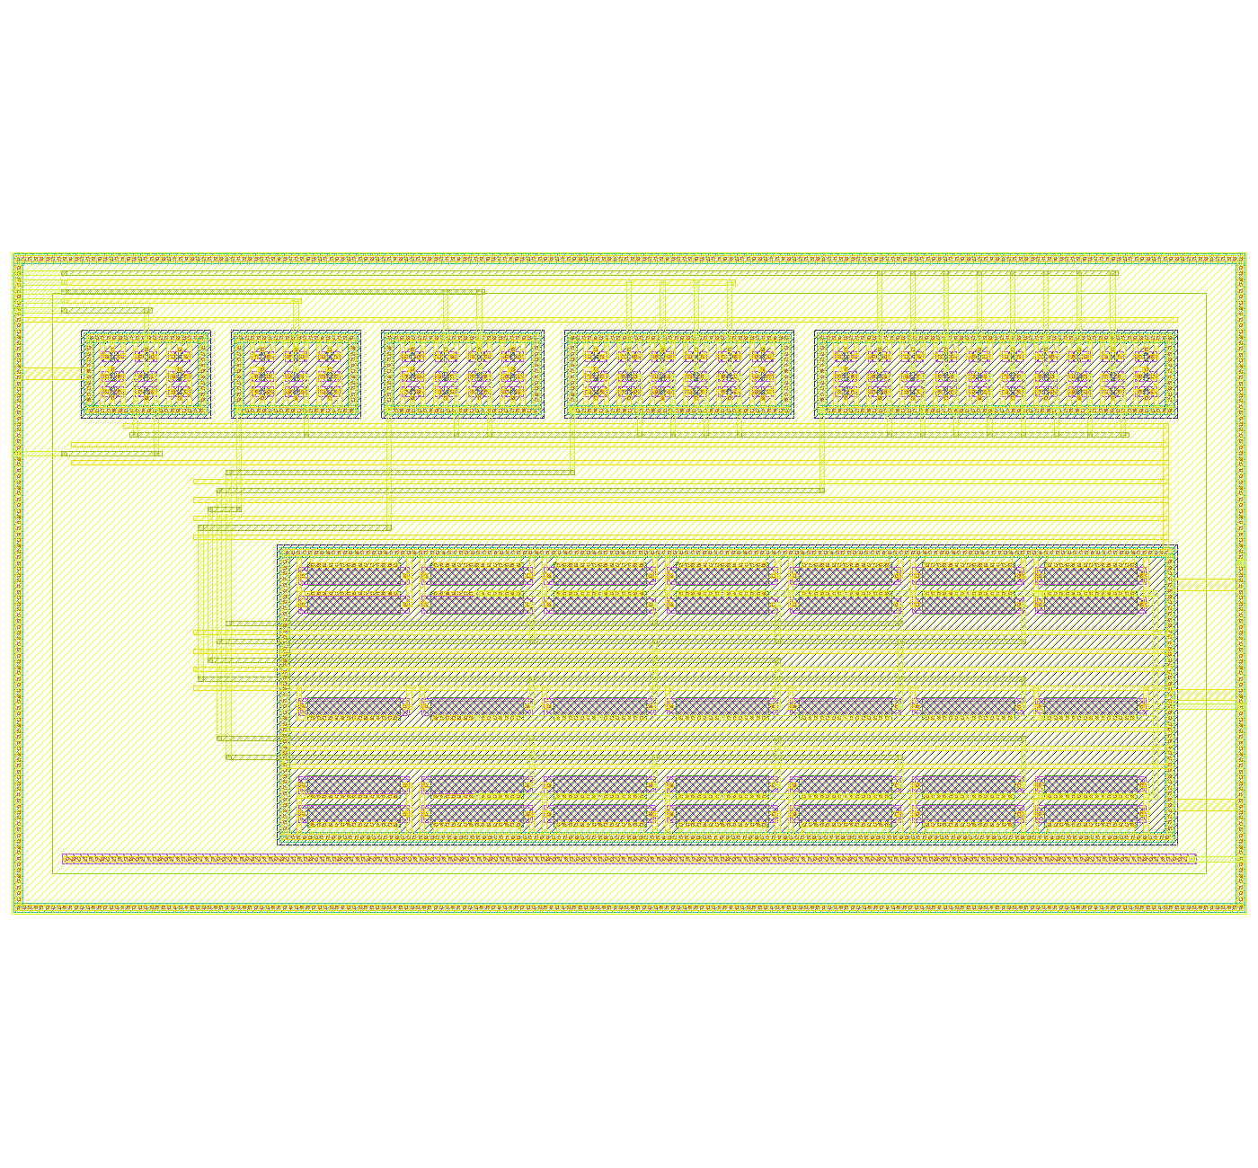
analog/neuron/layout/DAC_binary.png
