Latios1928/engn2912e-project/analog/neuron/layout/DAC_signed.png

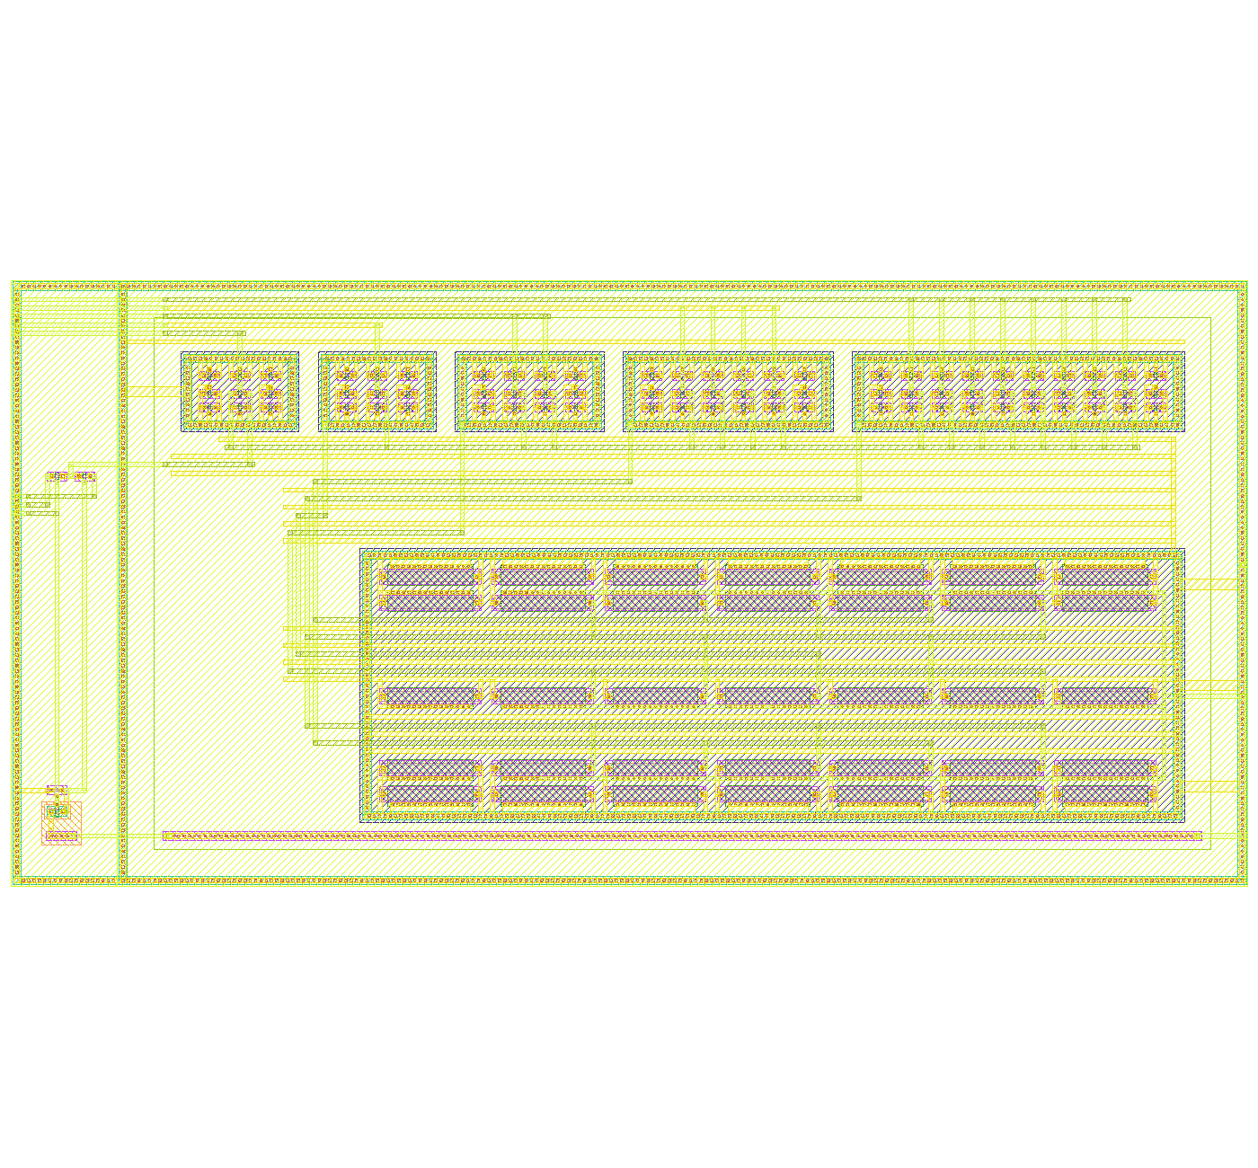
analog/neuron/layout/DAC_signed.png
