Latios1928/engn2912e-project/analog/neuron/layout/DPI.png

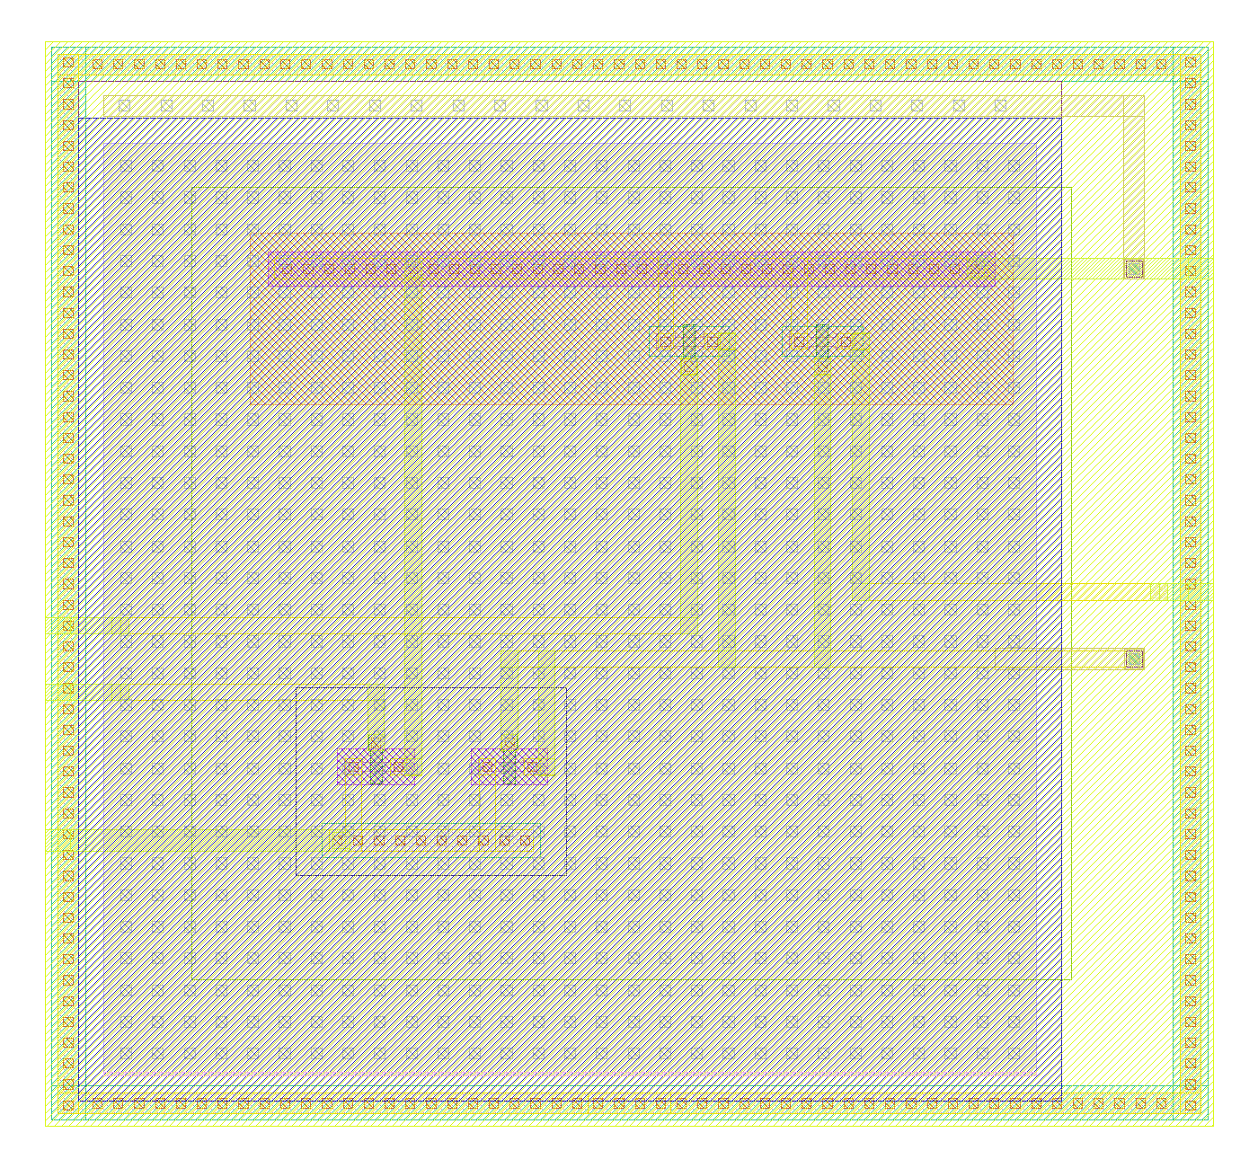
analog/neuron/layout/DPI.png
