Latios1928/engn2912e-project/analog/neuron/layout/DPI_inh.png

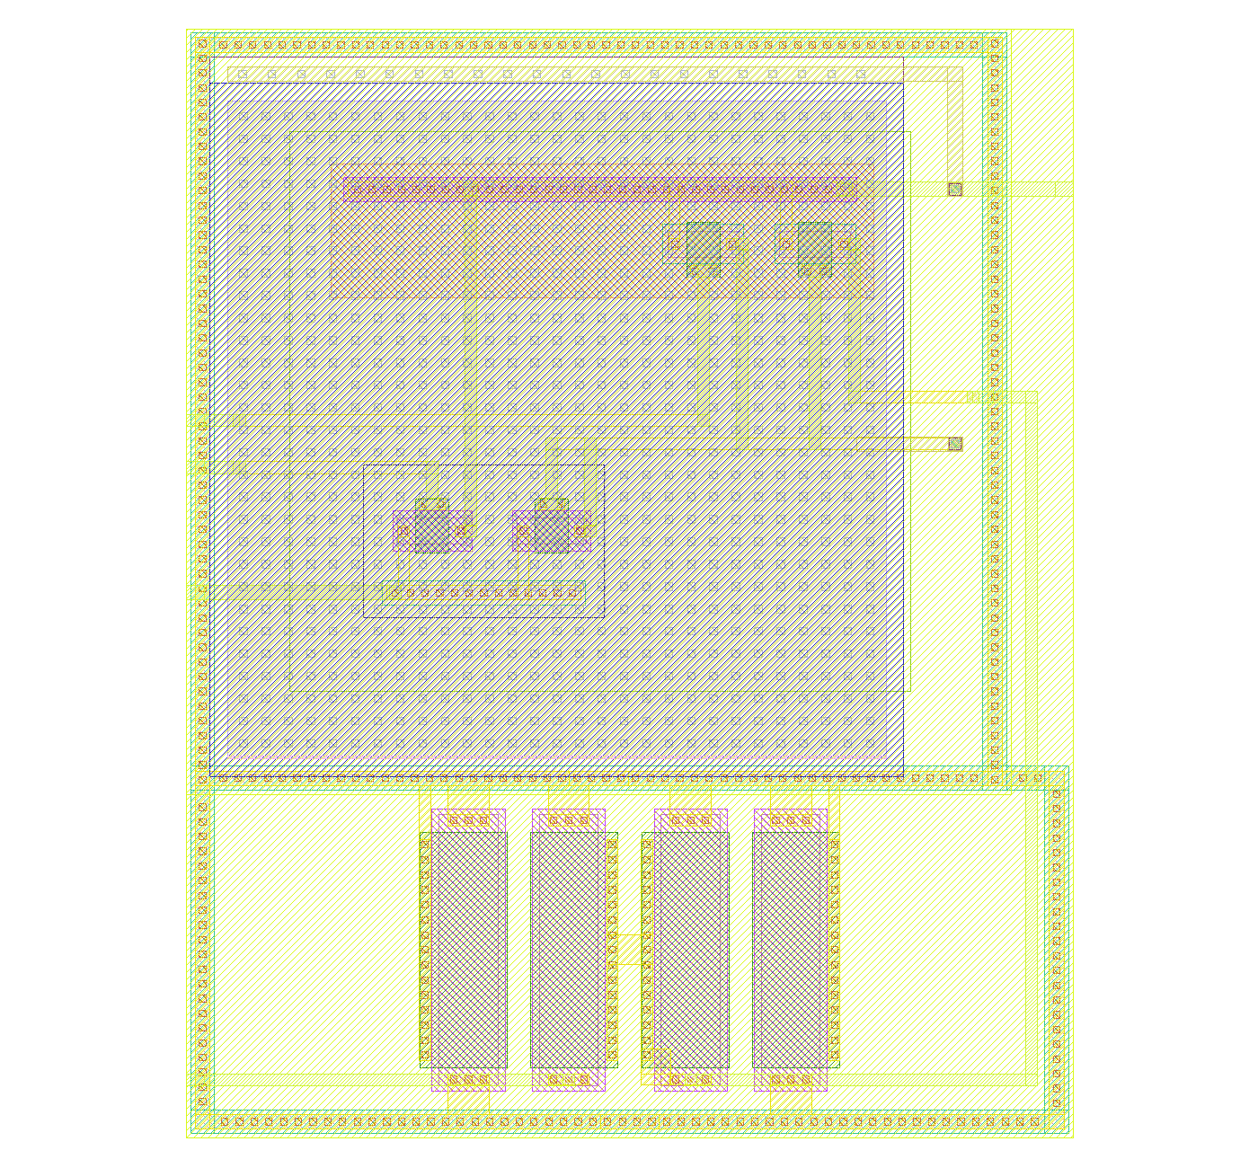
analog/neuron/layout/DPI_inh.png
