Latios1928/engn2912e-project/analog/neuron/layout/DPI_under_cap.png

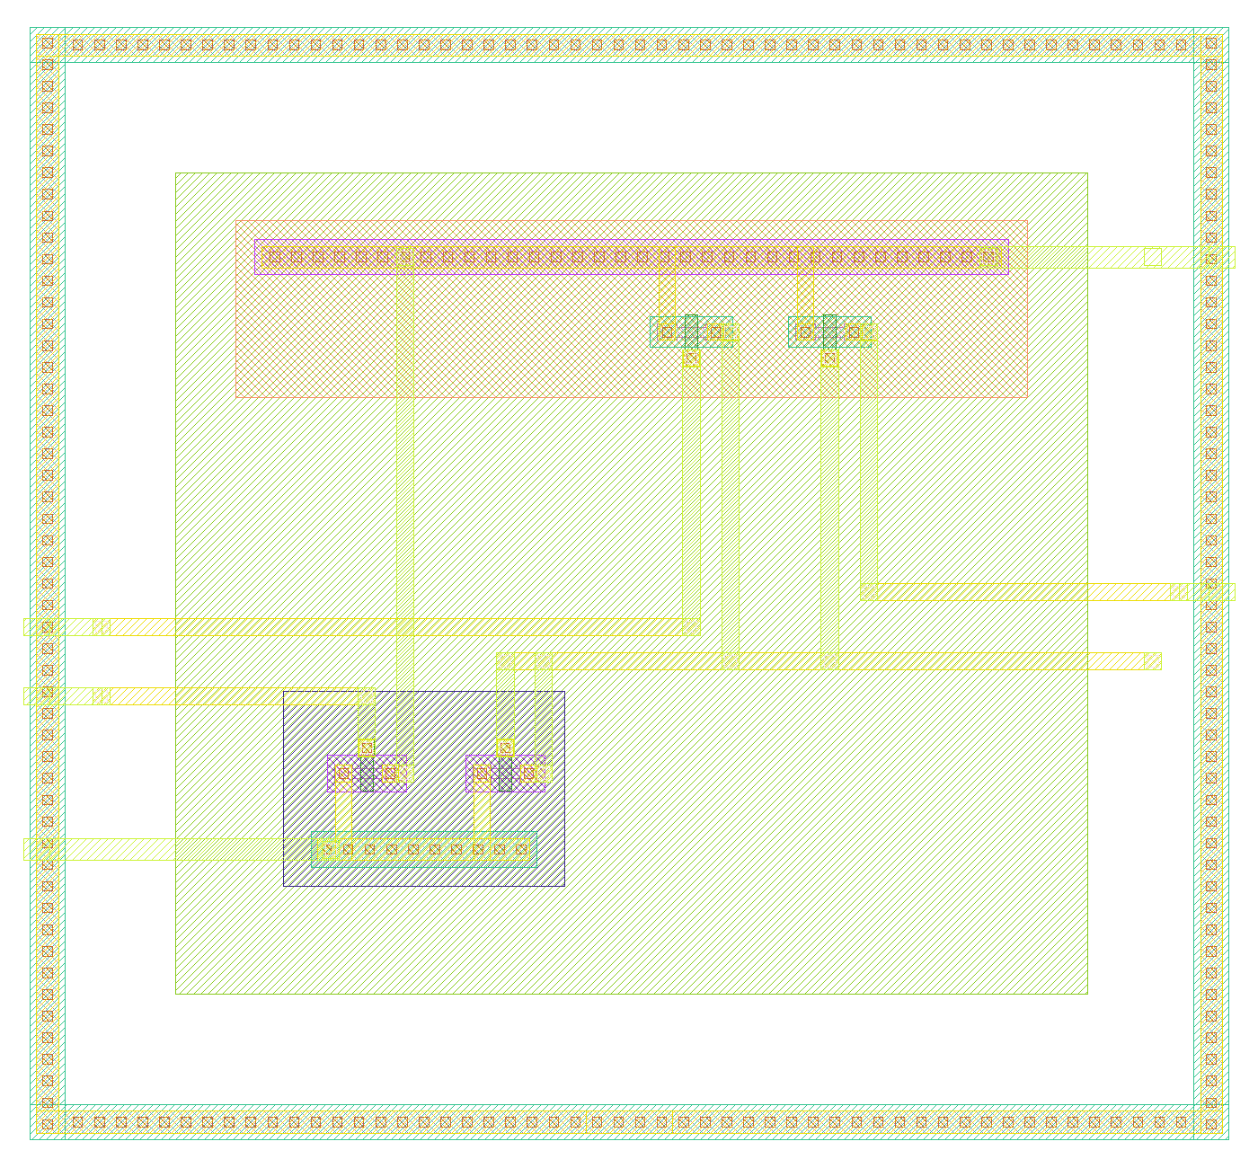
analog/neuron/layout/DPI_under_cap.png
