Latios1928/engn2912e-project/analog/neuron/layout/neuron_sized.png

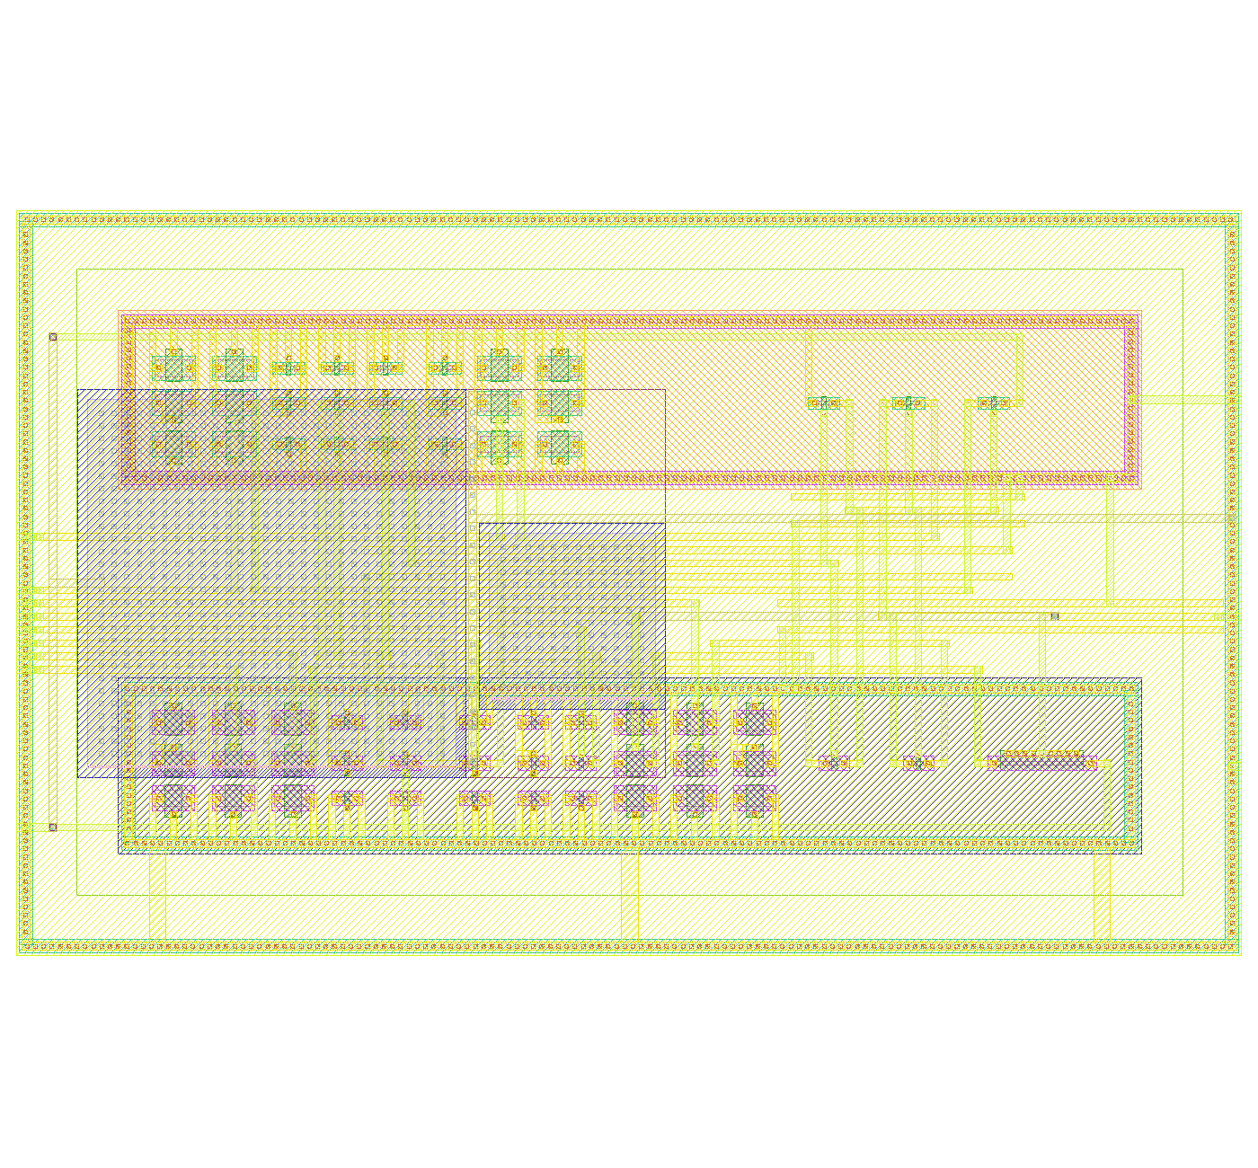
analog/neuron/layout/neuron_sized.png
