Latios1928/engn2912e-project/analog/neuron/layout/neuron_sized_under_cap.png

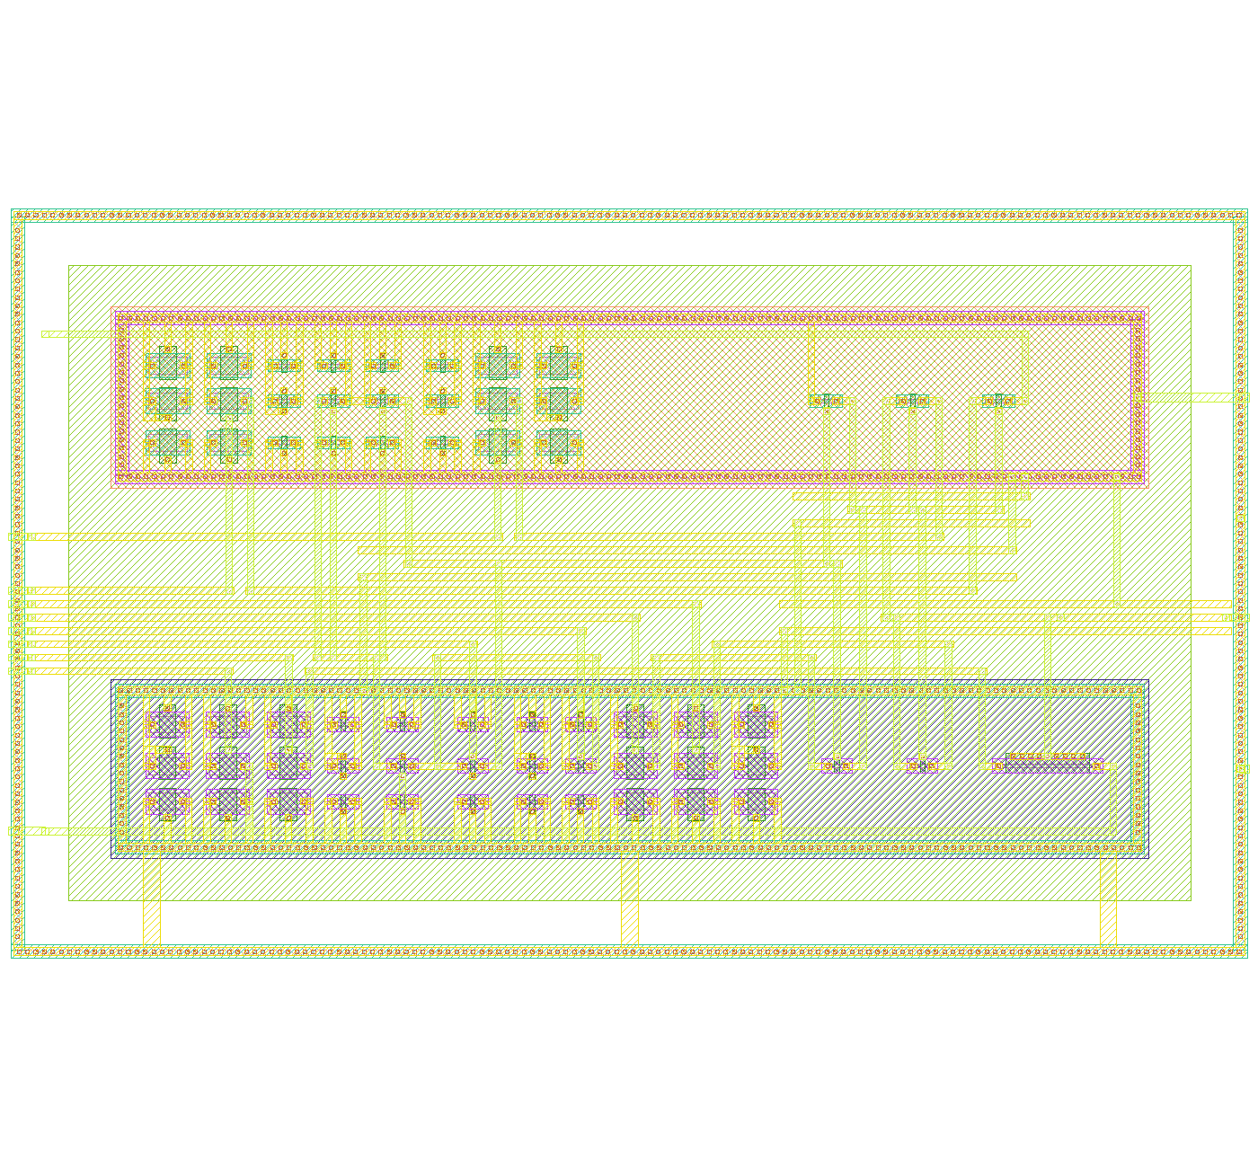
analog/neuron/layout/neuron_sized_under_cap.png
