Latios1928/engn2912e-project/analog/neuron/layout/SNN.png

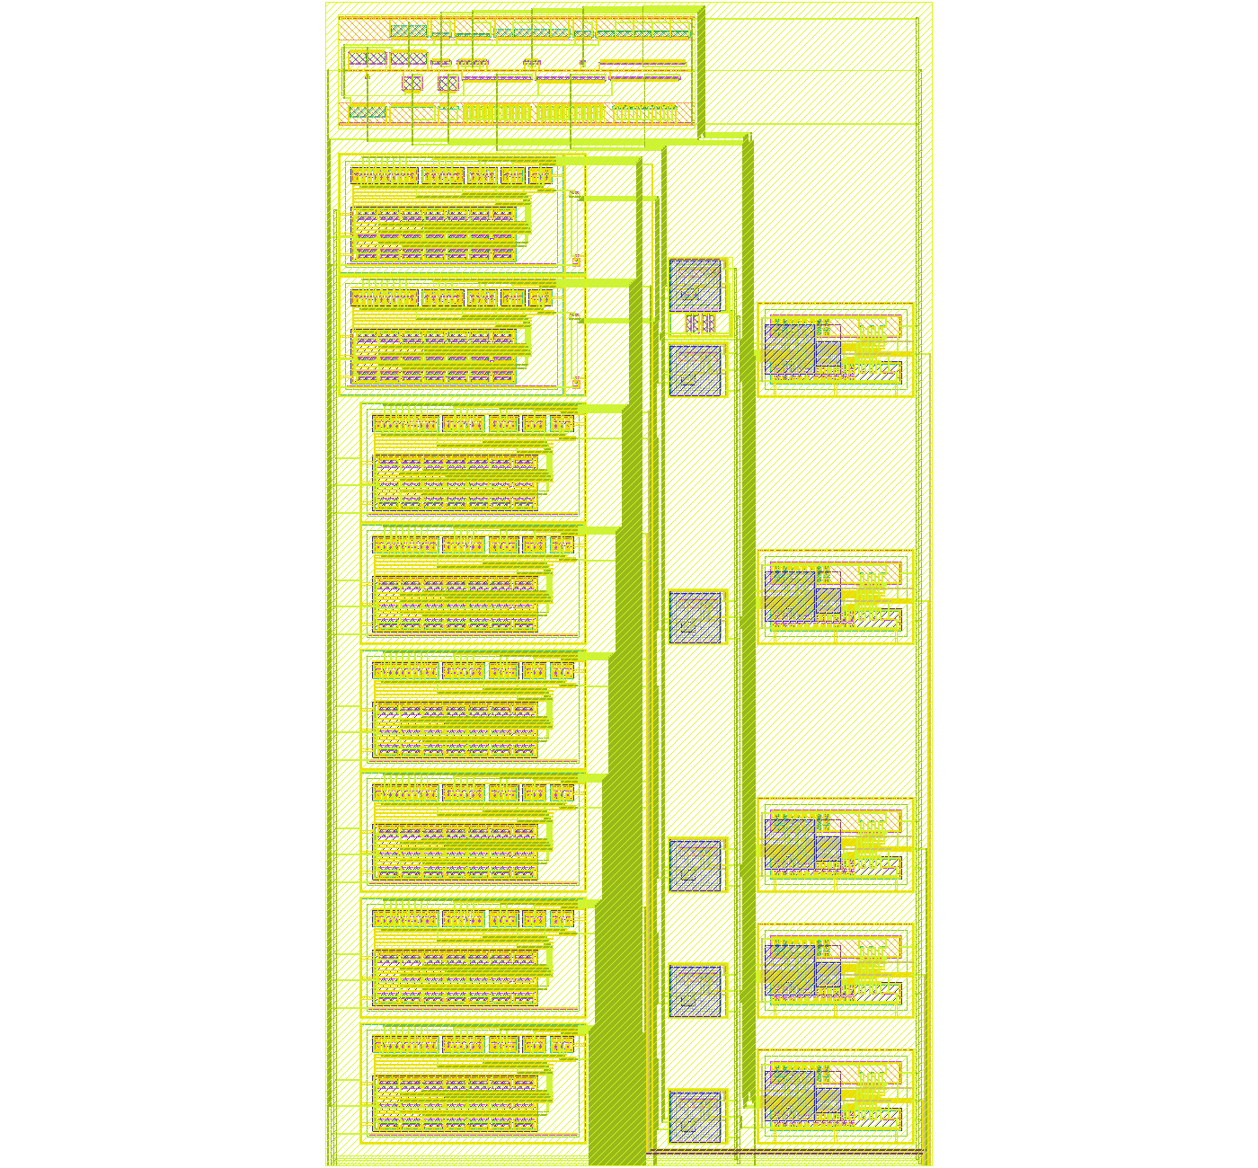
analog/neuron/layout/SNN.png
