Latios1928/engn2912e-project/analog/testbenches/dac/results/dac_signed_pulse_tb.md

# dac_signed_pulse_tb: DAC_signed switched by its enable

Generated by `run_dac_signed_pulse.py` on 2026-11-12 14:52. Cell: schematic `analog/neuron/DAC_signed.sch`. tt, 27 C, Iref 14.42 nA, outputs held at 2.5 V, 5 enables every 200 us; charge per enable = mean of enables 2-5, leakage removed.

## Ideal 10 us enable pulses (10 ns edges)

| code | weight | sign | on-current (nA) | charge (fC) | on-current x 10 us (fC) | excess (fC) | excess | settling to 1 % (ns) | to the other output (fC) |
|---|---|---|---|---|---|---|---|---|---|
| 1 | 1 | + | 15.04 | 160.3 | 150.4 | 9.871 | +6.6 % | 19.3 | 1.7e-09 |
| 1 | 1 | - | 15.04 | 160.3 | 150.4 | 9.87 | +6.6 % | 19.2 | 1.8e-05 |
| 2 | 2 | + | 30.06 | 315 | 300.6 | 14.38 | +4.8 % | 17 | 9.4e-10 |
| 2 | 2 | - | 30.06 | 315 | 300.6 | 14.38 | +4.8 % | 17 | 2.2e-05 |
| 4 | 3 | + | 45.08 | 470.9 | 450.8 | 20.12 | +4.5 % | 17 | 1.5e-09 |
| 4 | 3 | - | 45.08 | 470.9 | 450.8 | 20.12 | +4.5 % | 17 | 2.4e-05 |
| 7 | 6 | + | 90.09 | 945.3 | 900.9 | 44.46 | +4.9 % | 22.4 | 1.7e-09 |
| 7 | 6 | - | 90.09 | 945.3 | 900.9 | 44.46 | +4.9 % | 22.2 | 2.7e-05 |
| 8 | 4 | + | 60.08 | 627.9 | 600.8 | 27.05 | +4.5 % | 17.9 | 3.6e-09 |
| 8 | 4 | - | 60.08 | 627.9 | 600.8 | 27.05 | +4.5 % | 17.9 | 2.7e-05 |
| 15 | 10 | + | 150.1 | 1594 | 1501 | 93.35 | +6.2 % | 83.2 | 2.3e-09 |
| 15 | 10 | - | 150.1 | 1594 | 1501 | 93.35 | +6.2 % | 82.8 | 2.3e-05 |

## Enable driven by a neuron spike

Enable shape: spike 3 of `analog/testbenches/neuron/results/neuron_nominal_tb.txt` (schematic neuron unless that file says otherwise), 346 PWL points, 19.9 us from start to below 20 mV, above 1.65 V for 9.1 us, peak 3.22 V; repeated every 200 us. *Equivalent enable width*: the charge divided by the on-current.

| code | weight | sign | charge (fC) | ideal 10 us pulse (fC) | spike / pulse | equivalent enable width (us) |
|---|---|---|---|---|---|---|
| 1 | 1 | + | 254.4 | 160.3 | 1.587 | 16.91 |
| 1 | 1 | - | 254.4 | 160.3 | 1.587 | 16.91 |
| 2 | 2 | + | 503.7 | 315 | 1.599 | 16.75 |
| 2 | 2 | - | 503.7 | 315 | 1.599 | 16.75 |
| 4 | 3 | + | 751.1 | 470.9 | 1.595 | 16.66 |
| 4 | 3 | - | 751.1 | 470.9 | 1.595 | 16.66 |
| 7 | 6 | + | 1488 | 945.3 | 1.574 | 16.52 |
| 7 | 6 | - | 1488 | 945.3 | 1.574 | 16.52 |
| 8 | 4 | + | 997.4 | 627.9 | 1.588 | 16.60 |
| 8 | 4 | - | 997.4 | 627.9 | 1.588 | 16.60 |
| 15 | 10 | + | 2465 | 1594 | 1.546 | 16.43 |
| 15 | 10 | - | 2465 | 1594 | 1.546 | 16.43 |

## Enable width (codes 1 and 15, s = 0)

Straight-line fit q = I x width + q_fixed: I should match the on-current; q_fixed is the charge every enable adds on top (edges, node X).

| code | I from the fit (nA) | on-current (nA) | q_fixed (fC) | q_fixed in units of 1 us of on-current |
|---|---|---|---|---|
| 1 | 15.04 | 15.06 | 9.91 | 0.66 |
| 15 | 150.1 | 151.3 | 93.2 | 0.62 |

| code | width (us) | charge (fC) | on-current x width (fC) | excess |
|---|---|---|---|---|
| 1 | 2 | 39.99 | 30.23 | +32.3 % |
| 1 | 5 | 85.12 | 75.2 | +13.2 % |
| 1 | 10 | 160.3 | 150.4 | +6.6 % |
| 1 | 20 | 310.7 | 300.8 | +3.3 % |
| 1 | 50 | 761.9 | 752.1 | +1.3 % |
| 15 | 2 | 392.5 | 312.6 | +25.6 % |
| 15 | 5 | 843.9 | 750.9 | +12.4 % |
| 15 | 10 | 1594 | 1501 | +6.2 % |
| 15 | 20 | 3095 | 3001 | +3.1 % |
| 15 | 50 | 7596 | 7503 | +1.2 % |

## Corners and temperature: ideal 10 us pulses

*Leakage per period*: the current that still flows while the enable is off, times one 200 us period, so it can be compared with the charge of one pulse. It flows whether a spike comes or not.

| corner | T (C) | code | on-current (nA) | charge per pulse (fC) | excess | leakage, enable off (pA) | leakage per period (fC) | leakage / pulse charge |
|---|---|---|---|---|---|---|---|---|
| tt | 0 | 1 | 15.07 | 160.5 | +6.5 % | 0.0469 | 0.009383 | 0.0058 % |
| tt | 0 | 15 | 150.4 | 1594 | +6.0 % | 0.0469 | 0.009382 | 0.00059 % |
| tt | 27 | 1 | 15.04 | 160.3 | +6.6 % | 0.388 | 0.07752 | 0.048 % |
| tt | 27 | 15 | 150.1 | 1594 | +6.2 % | 0.388 | 0.07754 | 0.0049 % |
| tt | 85 | 1 | 15.09 | 160.9 | +6.6 % | 12.7 | 2.539 | 1.6 % |
| tt | 85 | 15 | 149.5 | 1595 | +6.7 % | 12.7 | 2.541 | 0.16 % |
| ss | 0 | 1 | 14.98 | 159.9 | +6.8 % | 0.00295 | 0.000589 | 0.00037 % |
| ss | 0 | 15 | 149.4 | 1590 | +6.4 % | 0.00295 | 0.0005892 | 3.7e-05 % |
| ss | 27 | 1 | 14.95 | 159.8 | +6.9 % | 0.0234 | 0.004674 | 0.0029 % |
| ss | 27 | 15 | 149.2 | 1591 | +6.7 % | 0.0234 | 0.004674 | 0.00029 % |
| ss | 85 | 1 | 14.92 | 159.8 | +7.1 % | 1.12 | 0.224 | 0.14 % |
| ss | 85 | 15 | 148.8 | 1594 | +7.2 % | 1.12 | 0.224 | 0.014 % |
| ff | 0 | 1 | 15.15 | 160.7 | +6.0 % | 1.14 | 0.2288 | 0.14 % |
| ff | 0 | 15 | 151.3 | 1596 | +5.5 % | 1.14 | 0.2288 | 0.014 % |
| ff | 27 | 1 | 15.17 | 160.9 | +6.1 % | 7.4 | 1.479 | 0.92 % |
| ff | 27 | 15 | 150.9 | 1594 | +5.7 % | 7.4 | 1.48 | 0.093 % |
| ff | 85 | 1 | 16.42 | 172.1 | +4.8 % | 155 | 30.93 | 18 % |
| ff | 85 | 15 | 150.2 | 1592 | +6.0 % | 156 | 31.23 | 2 % |
| sf | 0 | 1 | 15.01 | 160.1 | +6.7 % | 0.00516 | 0.001032 | 0.00064 % |
| sf | 0 | 15 | 149.7 | 1590 | +6.2 % | 0.00516 | 0.001032 | 6.5e-05 % |
| sf | 27 | 1 | 14.98 | 160 | +6.8 % | 0.0447 | 0.008946 | 0.0056 % |
| sf | 27 | 15 | 149.4 | 1591 | +6.5 % | 0.0447 | 0.008946 | 0.00056 % |
| sf | 85 | 1 | 14.95 | 160 | +7.0 % | 2 | 0.4006 | 0.25 % |
| sf | 85 | 15 | 149 | 1594 | +6.9 % | 2 | 0.4006 | 0.025 % |
| fs | 0 | 1 | 15.13 | 160.7 | +6.2 % | 0.519 | 0.1038 | 0.065 % |
| fs | 0 | 15 | 151 | 1597 | +5.7 % | 0.519 | 0.1038 | 0.0065 % |
| fs | 27 | 1 | 15.11 | 160.6 | +6.2 % | 3.56 | 0.7127 | 0.44 % |
| fs | 27 | 15 | 150.6 | 1596 | +5.9 % | 3.56 | 0.7128 | 0.045 % |
| fs | 85 | 1 | 15.76 | 166.4 | +5.6 % | 82.9 | 16.58 | 10 % |
| fs | 85 | 15 | 150 | 1595 | +6.4 % | 83.4 | 16.67 | 1 % |

## Corners and temperature: enable driven by the neuron's spike at that corner

| corner | T (C) | code | neuron period (us) | spike above 1.65 V (us) | charge per spike (fC) | ideal 10 us pulse, same corner (fC) | spike / pulse | equivalent enable width (us) |
|---|---|---|---|---|---|---|---|---|
| tt | 0 | 1 | 213.2 | 20.2 | 586.3 | 160.5 | 3.65 | 38.9 |
| tt | 0 | 15 | 213.2 | 20.2 | 5652 | 1594 | 3.55 | 37.6 |
| tt | 27 | 1 | 201.4 | 9.14 | 254.4 | 160.3 | 1.59 | 16.9 |
| tt | 27 | 15 | 201.4 | 9.14 | 2465 | 1594 | 1.55 | 16.4 |
| tt | 85 | 1 | 500.6 | 2.64 | 71.63 | 160.9 | 0.445 | 4.75 |
| tt | 85 | 15 | 500.6 | 2.64 | 717.1 | 1595 | 0.449 | 4.8 |
| ss | 0 | 1 | 756.5 | 244 | 9174 | 159.9 | 57.4 | 612 |
| ss | 0 | 15 | 756.5 | 244 | 8.686e+04 | 1590 | 54.6 | 581 |
| ss | 27 | 1 | 369.5 | 85.5 | 2864 | 159.8 | 17.9 | 191 |
| ss | 27 | 15 | 369.5 | 85.5 | 2.718e+04 | 1591 | 17.1 | 182 |
| ss | 85 | 1 | 234.1 | 16.7 | 481 | 159.8 | 3.01 | 32.2 |
| ss | 85 | 15 | 234.1 | 16.7 | 4595 | 1594 | 2.88 | 30.9 |
| ff | 0 | 1 | 231.6 | 1.82 | 49.98 | 160.7 | 0.311 | 3.3 |
| ff | 0 | 15 | 231.6 | 1.82 | 506 | 1596 | 0.317 | 3.35 |
| sf | 0 | 1 | 415 | 110 | 3905 | 160.1 | 24.4 | 260 |
| sf | 0 | 15 | 415 | 110 | 3.713e+04 | 1590 | 23.3 | 248 |
| sf | 27 | 1 | 276.2 | 61 | 1612 | 160 | 10.1 | 108 |
| sf | 27 | 15 | 276.2 | 61 | 1.55e+04 | 1591 | 9.74 | 104 |
| sf | 85 | 1 | 213.3 | 10.1 | 265.2 | 160 | 1.66 | 17.7 |
| sf | 85 | 15 | 213.3 | 10.1 | 2562 | 1594 | 1.61 | 17.2 |
| fs | 0 | 1 | 209 | 2.08 | 102.1 | 160.7 | 0.635 | 6.75 |
| fs | 0 | 15 | 209 | 2.08 | 988.5 | 1597 | 0.619 | 6.55 |
| fs | 27 | 1 | 336 | 1.6 | 65.88 | 160.6 | 0.41 | 4.36 |
| fs | 27 | 15 | 336 | 1.6 | 654.6 | 1596 | 0.41 | 4.35 |

Every run: `dac_signed_pulse_tb.csv`. Netlists, logs and waveforms (isel, ioth, v(en)): `runs/dac_signed_pulse_sch_*/`.
