Latios1928/engn2912e-project/analog/testbenches/dac/results/dac_signed_static_tb.md

# dac_signed_static_tb: DAC_signed, DC

Generated by `run_dac_signed.py` on 2026-11-12 09:45. Cell: schematic `analog/neuron/DAC_signed.sch`. Iref 14.42 nA into a 1 um / 8 um diode for Vb, en high, outputs held at 2.5 V, gmin 1e-16 S.

## Nominal (tt, 27 C)

- Vb 0.6161 V; unit current 15 nA (s = 0), 15 nA (s = 1)
- Branch ratios w[0..3]: 1.000, 1.999, 2.997, 3.996 (taken as 1:2:3:4); full scale 150.1 nA = 10.00 units
- INL 0.00342 units; monotonic: yes
- Inhibitory / excitatory current, codes 1-15: 1.00000 to 1.00000
- Current to the unselected output: at most 0.000278 pA (1.8e-06 % of the selected current)
- Code 0 (en on, all bits off): 3.87 pA
- Full scale within 1 % down to an output voltage of 1.95 V (Isum_e), 1.95 V (Isum_i)

### Every code

| code | w[3:0] | ideal weight | Isum_e, s = 0 (nA) | Isum_i, s = 1 (nA) | i / e | to the other output (pA) |
|---|---|---|---|---|---|---|
| 0 | 0000 | 0 | 0.003872 | 0.003872 | nan | 0.000278 |
| 1 | 0001 | 1 | 15.04 | 15.04 | 1.00000 | 0.000278 |
| 2 | 0010 | 2 | 30.06 | 30.06 | 1.00000 | 0.000278 |
| 3 | 0011 | 3 | 45.08 | 45.08 | 1.00000 | 0.000278 |
| 4 | 0100 | 3 | 45.08 | 45.08 | 1.00000 | 0.000278 |
| 5 | 0101 | 4 | 60.09 | 60.09 | 1.00000 | 0.000278 |
| 6 | 0110 | 5 | 75.09 | 75.09 | 1.00000 | 0.000278 |
| 7 | 0111 | 6 | 90.09 | 90.09 | 1.00000 | 0.000278 |
| 8 | 1000 | 4 | 60.09 | 60.09 | 1.00000 | 0.000278 |
| 9 | 1001 | 5 | 75.09 | 75.09 | 1.00000 | 0.000278 |
| 10 | 1010 | 6 | 90.09 | 90.09 | 1.00000 | 0.000278 |
| 11 | 1011 | 7 | 105.1 | 105.1 | 1.00000 | 0.000278 |
| 12 | 1100 | 7 | 105.1 | 105.1 | 1.00000 | 0.000278 |
| 13 | 1101 | 8 | 120.1 | 120.1 | 1.00000 | 0.000278 |
| 14 | 1110 | 9 | 135.1 | 135.1 | 1.00000 | 0.000278 |
| 15 | 1111 | 10 | 150.1 | 150.1 | 1.00000 | 0.000278 |

### Digital sign-magnitude weights

The digital side (`rf`, `mock/dac.v`) stores weights as sign-magnitude: bit 3 is the sign, bits 2:0 the magnitude (0-7, binary). Wired straight to `DAC_signed` (bits 2:0 to w[2:0], w[3] = 0, bit 3 to s), each digital weight delivers:

| digital weight | to | units delivered | ideal | error (units) |
|---|---|---|---|---|
| -7 | Isum_i | -6.00 | -7 | +1.00 |
| -6 | Isum_i | -5.00 | -6 | +1.00 |
| -5 | Isum_i | -4.00 | -5 | +1.00 |
| -4 | Isum_i | -3.00 | -4 | +1.00 |
| -3 | Isum_i | -3.00 | -3 | -0.00 |
| -2 | Isum_i | -2.00 | -2 | -0.00 |
| -1 | Isum_i | -1.00 | -1 | -0.00 |
| +0 | Isum_e | +0.00 | +0 | +0.00 |
| +1 | Isum_e | +1.00 | +1 | +0.00 |
| +2 | Isum_e | +2.00 | +2 | +0.00 |
| +3 | Isum_e | +3.00 | +3 | +0.00 |
| +4 | Isum_e | +3.00 | +4 | -1.00 |
| +5 | Isum_e | +4.00 | +5 | -1.00 |
| +6 | Isum_e | +5.00 | +6 | -1.00 |
| +7 | Isum_e | +6.00 | +7 | -1.00 |

With branches 1:2:3:4, bits 2:0 weigh 1:2:3, so magnitudes 4-7 come out as 3-6 units: the digital weights and the analog branches disagree (see the end of this report).

## Process corners and temperature

| corner | T (C) | Vb (V) | unit (nA) | full scale (nA) | INL (units) | monotonic | i / e | to the other output (pA) | code 0 (pA) | vmin e / i (V) |
|---|---|---|---|---|---|---|---|---|---|---|
| tt | 0 | 0.647 | 15.03 | 150.4 | 0.00361 | yes | 1.0000-1.0000 | 0.000278 | 0.462 | 1.97 / 1.97 |
| tt | 27 | 0.616 | 15 | 150.1 | 0.00342 | yes | 1.0000-1.0000 | 0.000278 | 3.87 | 1.95 / 1.95 |
| tt | 85 | 0.550 | 14.94 | 149.5 | 0.00262 | yes | 1.0000-1.0000 | 0.000777 | 127 | 1.92 / 1.92 |
| ss | 0 | 0.758 | 14.94 | 149.4 | 0.00361 | yes | 1.0000-1.0000 | 0.000278 | 0.0243 | 1.84 / 1.84 |
| ss | 27 | 0.727 | 14.92 | 149.2 | 0.00359 | yes | 1.0000-1.0000 | 0.000278 | 0.229 | 1.83 / 1.83 |
| ss | 85 | 0.661 | 14.88 | 148.8 | 0.00351 | yes | 1.0000-1.0000 | 0.000777 | 11.2 | 1.8 / 1.8 |
| ff | 0 | 0.537 | 15.12 | 151.3 | 0.00214 | yes | 1.0000-1.0000 | 0.000278 | 11.4 | 2.07 / 2.07 |
| ff | 27 | 0.506 | 15.08 | 150.9 | 0.00175 | yes | 1.0000-1.0000 | 0.000278 | 74 | 2.05 / 2.05 |
| ff | 85 | 0.439 | 14.86 | 150.2 | 0.000796 | yes | 1.0000-1.0000 | 0.000777 | 1.55e+03 | 1.99 / 1.99 |
| sf | 0 | 0.728 | 14.97 | 149.7 | 0.00364 | yes | 1.0000-1.0000 | 0.000278 | 0.047 | 1.88 / 1.88 |
| sf | 27 | 0.696 | 14.94 | 149.4 | 0.00361 | yes | 1.0000-1.0000 | 0.000278 | 0.442 | 1.87 / 1.87 |
| sf | 85 | 0.630 | 14.9 | 149 | 0.00342 | yes | 1.0000-1.0000 | 0.000777 | 20 | 1.84 / 1.84 |
| fs | 0 | 0.567 | 15.1 | 151 | 0.00275 | yes | 1.0000-1.0000 | 0.000278 | 5.18 | 2.05 / 2.05 |
| fs | 27 | 0.536 | 15.06 | 150.6 | 0.00231 | yes | 1.0000-1.0000 | 0.000278 | 35.6 | 2.03 / 2.03 |
| fs | 85 | 0.469 | 14.92 | 150 | 0.00129 | yes | 1.0000-1.0000 | 0.000777 | 830 | 1.97 / 1.97 |

## Device mismatch (tt, 27 C)

100 of 100 samples simulated; monotonic in 100 of 100. The reference diode mismatches too, so the unit spread includes the reference.

| quantity | mean | std dev | min | max |
|---|---|---|---|---|
| unit current (nA) | 15.12 | 0.62 | 13.72 | 16.75 |
| full scale (nA) | 151.3 | 6.04 | 137.3 | 166.5 |
| INL (units) | 0.1149 | 0.0604 | 0.026 | 0.321 |
| i / e, lowest code | 1 | 0.000341 | 0.9992 | 1.001 |
| i / e, highest code | 1 | 0.000335 | 0.9993 | 1.002 |
| branch w[0] ratio (ideal 1) | 1 | 0 | 1 | 1 |
| branch w[1] ratio (ideal 2) | 1.997 | 0.0857 | 1.809 | 2.24 |
| branch w[2] ratio (ideal 3) | 3.002 | 0.151 | 2.63 | 3.438 |
| branch w[3] ratio (ideal 4) | 3.99 | 0.183 | 3.562 | 4.428 |

## Open points

- Weight format: the digital side is sign-magnitude with a 3-bit binary magnitude; `DAC_signed` wraps the 1:2:3:4 `DAC` with a separate sign pin. A matching cell would steer `DAC_binary`'s x1/x2/x4 branches with s = bit 3.
- Dynamic behaviour (charge per input spike when `en` switches, injection, real spike shapes) needs a pulse testbench.

Every run: `dac_signed_static_tb.csv`; nominal currents per code: `dac_signed_static_tb_codes.csv`. Netlists and logs: `runs/dac_signed_sch_*/`.
