Latios1928/engn2912e-project/analog/testbenches/dpi/results/dpi_load_tb.md

# dpi_load_tb: synapse output vs membrane voltage

Generated by `run_dpi_load.py` on 2026-11-12 15:38. Excitatory cell: `DPI_sized`; inhibitory: `DPI_inh`. Bias presets: *output* Vthr 2.785 V, vtau 0.5096 V (XOR output layer (testbenches/xor/README.md)); *hidden* Vthr 2.5 V, vtau 0.6225 V (XOR hidden layer (testbenches/xor/README.md)); *relay* Vthr 2.4 V, vtau 0.72 V (XOR input relays (testbenches/xor/README.md)); *chain* Vthr 2.909 V, vtau 0.4 V (neuron/DACs-DPI-neuron.sch (one DPI bias set for the 2-2-1 network on main)).

Reference VMEM: 0.5 V (excitatory), 1.0 V (inhibitory). *Left at*: output current at that VMEM as a fraction of the reference. *-1 % / -10 % at VMEM*: membrane voltage where the output has dropped by 1 % / 10 % (excitatory: rising VMEM; inhibitory: falling VMEM; *none*: not within 0-3.3 V). *V(Isum)*: the tail voltage the DAC sees (lowest of the two DPIs at the reference VMEM); bold where it is below what `DAC_signed` needs at that corner (`dac/results/dac_signed_static_tb.csv`, 1 % compliance).

## Bias presets (tt, 27 C)

| bias | input (nA) | exc. out (nA) | exc. gain | left at 1.66 V | at 3.2 V | exc. -1 % / -10 % at VMEM (V) | inh. out (nA) | left at 0.1 V | inh. -1 % / -10 % at VMEM (V) | V(Isum) (V) | DAC needs (V) |
|---|---|---|---|---|---|---|---|---|---|---|---|---|
| output | 15 | 10.81 | 0.721 | 97 % | 91 % | 0.97 / 3.21 | 10.93 | 97 % | 0.64 / 0.04 | 2.227 | 1.95 |
|  | 45 | 27.81 | 0.618 | 98 % | 91 % | 1.04 / 3.21 | 28.01 | 97 % | 0.58 / 0.05 | 2.179 | 1.95 |
|  | 150 | 76.14 | 0.508 | 98 % | 90 % | 1.13 / 3.20 | 76.41 | 98 % | 0.46 / 0.06 | 2.122 | 1.95 |
| hidden | 15 | 204 | 13.6 | 98 % | 85 % | 1.24 / 3.17 | 204.1 | 96 % | 0.30 / 0.08 | **1.948** | 1.95 |
|  | 45 | 359.6 | 7.99 | 98 % | 78 % | 1.30 / 3.15 | 359.2 | 90 % | 0.24 / 0.10 | **1.897** | 1.95 |
|  | 150 | 611.2 | 4.07 | 99 % | 70 % | 1.36 / 3.12 | 609.8 | 82 % | 0.23 / 0.12 | **1.838** | 1.95 |
| relay | 15 | 23.31 | 1.55 | 98 % | 91 % | 1.02 / 3.21 | 23.49 | 97 % | 0.59 / 0.05 | 2.000 | 1.95 |
|  | 45 | 356.3 | 7.92 | 98 % | 78 % | 1.30 / 3.15 | 356 | 90 % | 0.24 / 0.10 | **1.813** | 1.95 |
|  | 150 | 662.9 | 4.42 | 99 % | 68 % | 1.37 / 3.12 | 661.4 | 80 % | 0.23 / 0.13 | **1.743** | 1.95 |
| chain | 15 | 7.344 | 0.49 | 97 % | 90 % | 0.95 / 3.21 | 7.435 | 97 % | 0.66 / 0.04 | 2.350 | 1.95 |
|  | 45 | 19.45 | 0.432 | 98 % | 91 % | 1.01 / 3.21 | 19.62 | 97 % | 0.61 / 0.04 | 2.303 | 1.95 |
|  | 150 | 56.01 | 0.373 | 98 % | 90 % | 1.10 / 3.20 | 56.26 | 98 % | 0.50 / 0.06 | 2.245 | 1.95 |

## Corners and temperature (output biases)

| corner | T (C) | input (nA) | exc. out (nA) | exc. gain | left at 1.66 V | at 3.2 V | exc. -1 % / -10 % at VMEM (V) | inh. out (nA) | left at 0.1 V | inh. -1 % / -10 % at VMEM (V) | V(Isum) (V) | DAC needs (V) |
|---|---|---|---|---|---|---|---|---|---|---|---|---|---|
| tt | 0 | 15 | 10.41 | 0.694 | 97 % | 90 % | 0.95 / 3.20 | 10.52 | 97 % | 0.67 / 0.04 | 2.188 | 1.97 |
|  |  | 45 | 27.01 | 0.6 | 98 % | 90 % | 1.01 / 3.21 | 27.19 | 97 % | 0.61 / 0.04 | 2.144 | 1.97 |
|  |  | 150 | 75.18 | 0.501 | 98 % | 90 % | 1.11 / 3.20 | 75.4 | 98 % | 0.50 / 0.06 | 2.090 | 1.97 |
| tt | 27 | 15 | 10.81 | 0.721 | 97 % | 91 % | 0.97 / 3.21 | 10.93 | 97 % | 0.64 / 0.04 | 2.227 | 1.95 |
|  |  | 45 | 27.81 | 0.618 | 98 % | 91 % | 1.04 / 3.21 | 28.01 | 97 % | 0.58 / 0.05 | 2.179 | 1.95 |
|  |  | 150 | 76.14 | 0.508 | 98 % | 90 % | 1.13 / 3.20 | 76.41 | 98 % | 0.46 / 0.06 | 2.122 | 1.95 |
| tt | 85 | 15 | 11.54 | 0.77 | 98 % | 91 % | 1.02 / 3.21 | 11.68 | 97 % | 0.58 / 0.05 | 2.314 | 1.92 |
|  |  | 45 | 30.45 | 0.677 | 98 % | 91 % | 1.09 / 3.20 | 30.7 | 98 % | 0.50 / 0.05 | 2.256 | 1.92 |
|  |  | 150 | 81.96 | 0.546 | 98 % | 89 % | 1.18 / 3.19 | 82.32 | 97 % | 0.37 / 0.07 | 2.189 | 1.92 |
| ss | 0 | 15 | 9.32 | 0.621 | 97 % | 90 % | 0.94 / 3.20 | 9.361 | 97 % | 0.68 / 0.04 | 2.080 | 1.84 |
|  |  | 45 | 24.34 | 0.541 | 98 % | 90 % | 1.01 / 3.21 | 24.39 | 97 % | 0.62 / 0.04 | 2.035 | 1.84 |
|  |  | 150 | 68.48 | 0.457 | 98 % | 90 % | 1.11 / 3.20 | 68.41 | 98 % | 0.50 / 0.05 | 1.980 | 1.84 |
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
|  |  | 45 | 25.75 | 0.572 | 98 % | 91 % | 1.08 / 3.21 | 26.06 | 98 % | 0.52 / 0.05 | 2.335 | 1.97 |
|  |  | 150 | 68.75 | 0.458 | 98 % | 89 % | 1.17 / 3.19 | 69.27 | 97 % | 0.40 / 0.07 | 2.270 | 1.97 |

## Device mismatch (tt, 27 C, output biases, 50 samples)

| input (nA) | quantity | mean | std dev | min | max |
|---|---|---|---|---|---|
| 15 | excitatory gain | 0.7165 | 0.139 | 0.4911 | 1.127 |
| 15 | inhibitory gain | 0.7415 | 0.111 | 0.4286 | 0.9486 |
| 15 | excitatory left at 1.66 V (%) | 97.46 | 0.0502 | 97.37 | 97.59 |
| 15 | inhibitory left at 0.1 V (%) | 97.08 | 0.0481 | 96.93 | 97.16 |
| 15 | V(Isum) (V) | 2.228 | 0.005 | 2.216 | 2.237 |
| 15 | inhibitory / excitatory output | 1.078 | 0.285 | 0.5894 | 1.706 |
| 45 | excitatory gain | 0.6136 | 0.108 | 0.435 | 0.9251 |
| 45 | inhibitory gain | 0.6317 | 0.0865 | 0.383 | 0.7898 |
| 45 | excitatory left at 1.66 V (%) | 97.74 | 0.0565 | 97.64 | 97.88 |
| 45 | inhibitory left at 0.1 V (%) | 97.38 | 0.0469 | 97.23 | 97.45 |
| 45 | V(Isum) (V) | 2.18 | 0.00501 | 2.168 | 2.19 |
| 45 | inhibitory / excitatory output | 1.065 | 0.257 | 0.6142 | 1.624 |
| 150 | excitatory gain | 0.5033 | 0.0747 | 0.3758 | 0.7125 |
| 150 | inhibitory gain | 0.515 | 0.0606 | 0.3358 | 0.6224 |
| 150 | excitatory left at 1.66 V (%) | 98.08 | 0.046 | 97.99 | 98.19 |
| 150 | inhibitory left at 0.1 V (%) | 97.5 | 0.0264 | 97.42 | 97.53 |
| 150 | V(Isum) (V) | 2.123 | 0.00502 | 2.111 | 2.132 |
| 150 | inhibitory / excitatory output | 1.048 | 0.215 | 0.6562 | 1.508 |

Every run: `dpi_load_tb.csv`. Logs and the swept curves: `runs/dpiload_sch_DPI_sized_*/`.
