Latios1928/engn2912e-project/analog/testbenches/dpi/results/dpi_load_tb__DPI__chain.md

# dpi_load_tb__DPI__chain: synapse output vs membrane voltage

Generated by `run_dpi_load.py` on 2026-11-12 15:39. Excitatory cell: `DPI`; inhibitory: `DPI_inh`. Bias presets: *output* Vthr 2.785 V, vtau 0.5096 V (XOR output layer (testbenches/xor/README.md)); *hidden* Vthr 2.5 V, vtau 0.6225 V (XOR hidden layer (testbenches/xor/README.md)); *relay* Vthr 2.4 V, vtau 0.72 V (XOR input relays (testbenches/xor/README.md)); *chain* Vthr 2.909 V, vtau 0.4 V (neuron/DACs-DPI-neuron.sch (one DPI bias set for the 2-2-1 network on main)).

Reference VMEM: 0.5 V (excitatory), 1.0 V (inhibitory). *Left at*: output current at that VMEM as a fraction of the reference. *-1 % / -10 % at VMEM*: membrane voltage where the output has dropped by 1 % / 10 % (excitatory: rising VMEM; inhibitory: falling VMEM; *none*: not within 0-3.3 V). *V(Isum)*: the tail voltage the DAC sees (lowest of the two DPIs at the reference VMEM); bold where it is below what `DAC_signed` needs at that corner (`dac/results/dac_signed_static_tb.csv`, 1 % compliance).

## Bias presets (tt, 27 C)

| bias | input (nA) | exc. out (nA) | exc. gain | left at 1.66 V | at 3.2 V | exc. -1 % / -10 % at VMEM (V) | inh. out (nA) | left at 0.1 V | inh. -1 % / -10 % at VMEM (V) | V(Isum) (V) | DAC needs (V) |
|---|---|---|---|---|---|---|---|---|---|---|---|---|
| output | 15 | 17.72 | 1.18 | 66 % | 33 % | 0.53 / 0.80 | 10.93 | 97 % | 0.64 / 0.04 | 2.227 | 1.95 |
|  | 45 | 46.6 | 1.04 | 68 % | 36 % | 0.53 / 0.83 | 28.01 | 97 % | 0.58 / 0.05 | 2.179 | 1.95 |
|  | 150 | 125.3 | 0.836 | 72 % | 39 % | 0.54 / 0.89 | 76.41 | 98 % | 0.46 / 0.06 | 2.122 | 1.95 |
| hidden | 15 | 3.224e-05 | 2.15e-06 | 58 % | 27 % | 0.52 / 0.69 | 204.1 | 96 % | 0.30 / 0.08 | **1.948** | 1.95 |
|  | 45 | 451.9 | 10 | 79 % | 43 % | 0.55 / 1.03 | 359.2 | 90 % | 0.24 / 0.10 | **1.897** | 1.95 |
|  | 150 | 938.2 | 6.25 | 83 % | 41 % | 0.57 / 1.17 | 609.8 | 82 % | 0.23 / 0.12 | **1.838** | 1.95 |
| relay | 15 | 9.978e-06 | 6.65e-07 | 50 % | 22 % | 0.51 / 0.60 | 23.49 | 97 % | 0.59 / 0.05 | 2.000 | 1.95 |
|  | 45 | 1.492e-05 | 3.32e-07 | 55 % | 25 % | 0.51 / 0.64 | 356 | 90 % | 0.24 / 0.10 | **1.813** | 1.95 |
|  | 150 | 336 | 2.24 | 77 % | 43 % | 0.55 / 0.99 | 661.4 | 80 % | 0.23 / 0.13 | **1.743** | 1.95 |
| chain | 15 | 12.36 | 0.824 | 65 % | 33 % | 0.53 / 0.80 | 7.435 | 97 % | 0.66 / 0.04 | 2.350 | 1.95 |
|  | 45 | 31.65 | 0.703 | 67 % | 35 % | 0.53 / 0.82 | 19.62 | 97 % | 0.61 / 0.04 | 2.303 | 1.95 |
|  | 150 | 88.28 | 0.589 | 71 % | 38 % | 0.54 / 0.86 | 56.26 | 98 % | 0.50 / 0.06 | 2.245 | 1.95 |

## Corners and temperature (chain biases)

| corner | T (C) | input (nA) | exc. out (nA) | exc. gain | left at 1.66 V | at 3.2 V | exc. -1 % / -10 % at VMEM (V) | inh. out (nA) | left at 0.1 V | inh. -1 % / -10 % at VMEM (V) | V(Isum) (V) | DAC needs (V) |
|---|---|---|---|---|---|---|---|---|---|---|---|---|---|
| tt | 0 | 15 | 11.25 | 0.75 | 63 % | 30 % | 0.53 / 0.77 | 7.008 | 97 % | 0.69 / 0.04 | 2.312 | 1.97 |
|  |  | 45 | 29.08 | 0.646 | 65 % | 32 % | 0.53 / 0.79 | 18.75 | 97 % | 0.64 / 0.04 | 2.268 | 1.97 |
|  |  | 150 | 82.78 | 0.552 | 69 % | 35 % | 0.53 / 0.84 | 54.97 | 97 % | 0.54 / 0.05 | 2.214 | 1.97 |
| tt | 27 | 15 | 12.36 | 0.824 | 65 % | 33 % | 0.53 / 0.80 | 7.435 | 97 % | 0.66 / 0.04 | 2.350 | 1.95 |
|  |  | 45 | 31.65 | 0.703 | 67 % | 35 % | 0.53 / 0.82 | 19.62 | 97 % | 0.61 / 0.04 | 2.303 | 1.95 |
|  |  | 150 | 88.28 | 0.589 | 71 % | 38 % | 0.54 / 0.86 | 56.26 | 98 % | 0.50 / 0.06 | 2.245 | 1.95 |
| tt | 85 | 15 | 14.08 | 0.938 | 69 % | 38 % | 0.53 / 0.84 | 8.433 | 97 % | 0.60 / 0.05 | 2.434 | 1.92 |
|  |  | 45 | 37.39 | 0.831 | 71 % | 40 % | 0.54 / 0.87 | 21.88 | 98 % | 0.54 / 0.05 | 2.378 | 1.92 |
|  |  | 150 | 102.5 | 0.683 | 74 % | 42 % | 0.54 / 0.92 | 60.7 | 97 % | 0.42 / 0.06 | 2.313 | 1.92 |
| ss | 0 | 15 | 8.696 | 0.58 | 65 % | 32 % | 0.53 / 0.79 | 6.259 | 97 % | 0.69 / 0.04 | 2.203 | 1.84 |
|  |  | 45 | 22.97 | 0.51 | 67 % | 34 % | 0.53 / 0.81 | 16.86 | 97 % | 0.64 / 0.04 | 2.158 | 1.84 |
|  |  | 150 | 67.58 | 0.451 | 70 % | 37 % | 0.53 / 0.85 | 50.12 | 97 % | 0.54 / 0.05 | 2.103 | 1.84 |
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
|  |  | 45 | 26.79 | 0.595 | 72 % | 41 % | 0.54 / 0.88 | 18.42 | 97 % | 0.55 / 0.05 | 2.458 | 1.97 |
|  |  | 150 | 73.15 | 0.488 | 74 % | 43 % | 0.54 / 0.93 | 51.07 | 97 % | 0.45 / 0.06 | 2.393 | 1.97 |

## Device mismatch (tt, 27 C, chain biases, 50 samples)

| input (nA) | quantity | mean | std dev | min | max |
|---|---|---|---|---|---|
| 15 | excitatory gain | 1.084 | 1.1 | 0.1152 | 6.183 |
| 15 | inhibitory gain | 0.5052 | 0.0778 | 0.2868 | 0.6524 |
| 15 | excitatory left at 1.66 V (%) | 65.46 | 1.64 | 62.95 | 70.71 |
| 15 | inhibitory left at 0.1 V (%) | 96.97 | 0.0421 | 96.85 | 97.05 |
| 15 | V(Isum) (V) | 2.471 | 0.0231 | 2.416 | 2.514 |
| 15 | inhibitory / excitatory output | 1.086 | 1.1 | 0.08311 | 4.971 |
| 45 | excitatory gain | 0.8703 | 0.787 | 0.1101 | 4.262 |
| 45 | inhibitory gain | 0.4432 | 0.0633 | 0.2628 | 0.5608 |
| 45 | excitatory left at 1.66 V (%) | 67.39 | 2.15 | 64.08 | 73.97 |
| 45 | inhibitory left at 0.1 V (%) | 97.27 | 0.0514 | 97.1 | 97.35 |
| 45 | V(Isum) (V) | 2.426 | 0.0232 | 2.371 | 2.469 |
| 45 | inhibitory / excitatory output | 1.054 | 1 | 0.1058 | 4.52 |
| 150 | excitatory gain | 0.6707 | 0.507 | 0.1092 | 2.637 |
| 150 | inhibitory gain | 0.3798 | 0.0475 | 0.2409 | 0.4655 |
| 150 | excitatory left at 1.66 V (%) | 70.46 | 2.77 | 65.91 | 77.86 |
| 150 | inhibitory left at 0.1 V (%) | 97.53 | 0.0147 | 97.46 | 97.53 |
| 150 | V(Isum) (V) | 2.372 | 0.0232 | 2.317 | 2.415 |
| 150 | inhibitory / excitatory output | 0.996 | 0.846 | 0.1466 | 3.85 |

Every run: `dpi_load_tb__DPI__chain.csv`. Logs and the swept curves: `runs/dpiload_sch_DPI_*/`.
