Latios1928/engn2912e-project/analog/testbenches/dpi/results/dpi_pulse_tb.md

# dpi_pulse_tb: synapses driven by DAC-like current pulses

Generated by `run_dpi_pulse.py` on 2026-11-12 15:46. Excitatory `DPI_sized`, inhibitory `DPI_inh`, *output* biases (Vthr 2.785 V, vtau 0.5096 V; XOR output layer (testbenches/xor/README.md)). Input: code x 15 nA (DAC branches 1:2:3:4) for 10 us; outputs held at 0.5 V unless stated. *Gain*: charge delivered to the membrane / input charge, over the whole response (3 ms after the last pulse). *i / e*: inhibitory charge removed / excitatory charge delivered.

## Gain vs weight (one pulse, tt 27 C)

| code | units | charge in (fC) | excitatory out (fC) | gain | inhibitory out (fC) | gain | i / e | decay time (ms) | peak out (nA) | lowest V(Isum) (V) |
|---|---|---|---|---|---|---|---|---|---|---|
| 1 | 1 | 150 | -0.0004778 | -3.19e-06 | -0.0009942 | -6.63e-06 | 2.081 | - | 2.33e-05 | 2.595 |
| 2 | 2 | 300 | 0.1294 | 0.000431 | 0.005216 | 1.74e-05 | 0.040 | - | 0.000395 | 2.410 |
| 4 | 3 | 450 | 6.382 | 0.0142 | 2.021 | 0.00449 | 0.317 | 0.62 | 0.0177 | 2.264 |
| 7 | 6 | 900 | 383.2 | 0.426 | 378.1 | 0.42 | 0.987 | 0.382 | 1.02 | 2.149 |
| 10 | 6 | 900 | 383.2 | 0.426 | 378.1 | 0.42 | 0.987 | 0.382 | 1.02 | 2.149 |
| 15 | 10 | 1500 | 1230 | 0.82 | 1224 | 0.816 | 0.995 | 0.399 | 3.13 | 2.123 |

Codes 1, 2: less than 1 % of the input charge reaches the membrane (a single pulse that small does not get through the DPI).
Codes 4-15: gain 0.0142 to 0.82 (57.84x; 1 = charge out proportional to charge in).

## Trains: 10 pulses at 5 kHz

| code | charge per pulse, pulses 1 / 2 / 5 / 10 (fC) | pulse 10 / pulse 1 | total gain | i / e |
|---|---|---|---|---|
| 1 | -0.01495 / 0.01624 / 47.59 / 335.1 | -22416.61 | 0.555 | 0.996 |
| 4 | 2.587 / 137.5 / 422.8 / 1254 | 484.59 | 0.971 | 0.999 |
| 15 | 476.5 / 1064 / 1682 / 4852 | 10.18 | 1.21 | 0.997 |

Pulse 10's window includes the decay after the train, so compare pulses 1-9 for build-up.

## Two pulses vs one (code 4)

| gap | excitatory: two / (2 x one) | inhibitory: two / (2 x one) |
|---|---|---|
| 20 us | 28.611 | 89.061 |
| 50 us | 28.328 | 88.179 |
| 100 us | 27.869 | 86.752 |
| 200 us | 26.946 | 83.877 |
| 400 us | 25.126 | 78.198 |
| 700 us | 22.444 | 69.803 |
| 1000 us | 19.823 | 61.583 |
| 2000 us | 11.668 | 35.934 |

Above 1: the second input adds more than the first (the synapse rewards coincidence); 1: linear; below 1: the second adds less.

## Input width (code 4)

16.5 us instead of 10 us (1.65x the input charge, as a real neuron spike delivers through the DAC) gives 31.03x the excitatory and 95.53x the inhibitory output charge.

## Membrane voltage (one code-15 pulse)

| VMEM (V) | excitatory out (fC) | inhibitory out (fC) | i / e |
|---|---|---|---|
| 0.1 | 1243 | 1203 | 0.968 |
| 0.5 | 1230 | 1224 | 0.995 |
| 1 | 1216 | 1244 | 1.024 |
| 1.66 | 1195 | 1271 | 1.063 |
| 2.5 | 1165 | 1306 | 1.121 |

## Corners and temperature (one code-4 pulse)

| corner | T (C) | excitatory gain | inhibitory gain | i / e | decay time (ms) | lowest V(Isum) (V) |
|---|---|---|---|---|---|---|
| tt | 0 | 0.00956 | 0.0012 | 0.125 | - | 2.224 |
| tt | 27 | 0.0142 | 0.00449 | 0.317 | 0.62 | 2.264 |
| tt | 85 | 0.0205 | 0.0143 | 0.696 | 0.0418 | 2.353 |
| ss | 0 | 0.000588 | -2.96e-06 | -0.005 | - | 2.117 |
| ss | 27 | 0.00445 | 7.48e-05 | 0.017 | - | 2.149 |
| ss | 85 | 0.0219 | 0.00725 | 0.331 | 0.719 | 2.233 |
| ff | 0 | 0.0105 | 0.00464 | 0.441 | 0.0604 | 2.341 |
| ff | 27 | 0.0113 | 0.00559 | 0.496 | 0.0197 | 2.389 |
| ff | 85 | 0.00455 | 0.00283 | 0.623 | 0.00403 | 2.550 |
| sf | 0 | 0.0111 | -5.89e-05 | -0.005 | 0.17 | 2.150 |
| sf | 27 | 0.0132 | 0.0044 | 0.334 | 0.0448 | 2.186 |
| sf | 85 | 0.0104 | 0.00496 | 0.479 | 0.00743 | 2.312 |
| fs | 0 | 0.00155 | 4.09e-05 | 0.026 | - | 2.307 |
| fs | 27 | 0.00835 | 0.000838 | 0.100 | - | 2.344 |
| fs | 85 | 0.0221 | 0.0177 | 0.804 | 0.302 | 2.425 |

Excitatory gain across corners: 0.000588 to 0.0221 (37.6x).

## Device mismatch (one code-4 pulse, 50 samples)

| quantity | mean | std dev | std / mean | min | max |
|---|---|---|---|---|---|
| excitatory gain | 0.01417 | 0.00284 | 0.20 | 0.009368 | 0.02066 |
| inhibitory gain | 0.004877 | 0.00176 | 0.36 | 0.001684 | 0.008783 |
| i / e | 0.3584 | 0.154 | 0.43 | 0.1156 | 0.7298 |

Every run: `dpi_pulse_tb.csv`. Logs and waveforms: `runs/dpipulse_sch_DPI_sized_output_*/`.
