Latios1928/engn2912e-project/analog/testbenches/dpi/results/dpi_pulse_tb__DPI__chain.md

# dpi_pulse_tb__DPI__chain: synapses driven by DAC-like current pulses

Generated by `run_dpi_pulse.py` on 2026-11-12 15:46. Excitatory `DPI`, inhibitory `DPI_inh`, *chain* biases (Vthr 2.909 V, vtau 0.4 V; neuron/DACs-DPI-neuron.sch (one DPI bias set for the 2-2-1 network on main)). Input: code x 15 nA (DAC branches 1:2:3:4) for 10 us; outputs held at 0.5 V unless stated. *Gain*: charge delivered to the membrane / input charge, over the whole response (3 ms after the last pulse). *i / e*: inhibitory charge removed / excitatory charge delivered.

## Gain vs weight (one pulse, tt 27 C)

| code | units | charge in (fC) | excitatory out (fC) | gain | inhibitory out (fC) | gain | i / e | decay time (ms) | peak out (nA) | lowest V(Isum) (V) |
|---|---|---|---|---|---|---|---|---|---|---|
| 1 | 1 | 150 | 0.1488 | 0.000992 | -0.002014 | -1.34e-05 | -0.014 | - | 0.000345 | 2.594 |
| 2 | 2 | 300 | 7.301 | 0.0243 | 0.03026 | 0.000101 | 0.004 | 0.46 | 0.0169 | 2.416 |
| 4 | 3 | 450 | 90.19 | 0.2 | 6.648 | 0.0148 | 0.074 | 0.419 | 0.216 | 2.330 |
| 7 | 6 | 900 | 709.3 | 0.788 | 146.1 | 0.162 | 0.206 | 0.417 | 1.7 | 2.270 |
| 10 | 6 | 900 | 709.3 | 0.788 | 146.1 | 0.162 | 0.206 | 0.417 | 1.7 | 2.270 |
| 15 | 10 | 1500 | 1741 | 1.16 | 432.2 | 0.288 | 0.248 | 0.423 | 4.11 | 2.247 |

Codes 1: less than 1 % of the input charge reaches the membrane (a single pulse that small does not get through the DPI).
Codes 2-15: gain 0.0243 to 1.16 (47.70x; 1 = charge out proportional to charge in).

## Trains: 10 pulses at 5 kHz

| code | charge per pulse, pulses 1 / 2 / 5 / 10 (fC) | pulse 10 / pulse 1 | total gain | i / e |
|---|---|---|---|---|
| 1 | 0.04874 / 1.792 / 106.8 / 466.4 | 9568.96 | 0.86 | 0.281 |
| 4 | 33.18 / 230.7 / 514.9 / 1552 | 46.77 | 1.21 | 0.315 |
| 15 | 643.5 / 1276 / 1929 / 5599 | 8.70 | 1.4 | 0.364 |

Pulse 10's window includes the decay after the train, so compare pulses 1-9 for build-up.

## Two pulses vs one (code 4)

| gap | excitatory: two / (2 x one) | inhibitory: two / (2 x one) |
|---|---|---|
| 20 us | 3.697 | 9.821 |
| 50 us | 3.681 | 9.906 |
| 100 us | 3.649 | 10.049 |
| 200 us | 3.593 | 10.331 |
| 400 us | 3.472 | 10.887 |
| 700 us | 3.276 | 11.668 |
| 1000 us | 3.078 | 12.401 |
| 2000 us | 2.432 | 14.525 |

Above 1: the second input adds more than the first (the synapse rewards coincidence); 1: linear; below 1: the second adds less.

## Input width (code 4)

16.5 us instead of 10 us (1.65x the input charge, as a real neuron spike delivers through the DAC) gives 5.02x the excitatory and 12.58x the inhibitory output charge.

## Membrane voltage (one code-15 pulse)

| VMEM (V) | excitatory out (fC) | inhibitory out (fC) | i / e |
|---|---|---|---|
| 0.1 | 2035 | 424.7 | 0.209 |
| 0.5 | 1741 | 432.2 | 0.248 |
| 1 | 1432 | 439.7 | 0.307 |
| 1.66 | 1097 | 449.3 | 0.410 |
| 2.5 | 762.1 | 462.2 | 0.606 |

## Corners and temperature (one code-4 pulse)

| corner | T (C) | excitatory gain | inhibitory gain | i / e | decay time (ms) | lowest V(Isum) (V) |
|---|---|---|---|---|---|---|
| tt | 0 | 0.158 | 0.000309 | 0.002 | 2.14 | 2.292 |
| tt | 27 | 0.2 | 0.0148 | 0.074 | 0.419 | 2.330 |
| tt | 85 | 0.188 | 0.0855 | 0.455 | 0.0336 | 2.411 |
| ss | 0 | 0.00892 | -1.87e-06 | -0.000 | - | 2.184 |
| ss | 27 | 0.0539 | 1.33e-05 | 0.000 | - | 2.218 |
| ss | 85 | 0.194 | 0.0198 | 0.102 | 0.428 | 2.303 |
| ff | 0 | 0.206 | 0.0614 | 0.299 | 0.0661 | 2.398 |
| ff | 27 | 0.184 | 0.0763 | 0.414 | 0.0196 | 2.437 |
| ff | 85 | 0.0579 | 0.0866 | 1.495 | 0.00303 | 2.526 |
| sf | 0 | 0.216 | 0.0343 | 0.159 | 0.159 | 2.214 |
| sf | 27 | 0.203 | 0.0678 | 0.334 | 0.0426 | 2.250 |
| sf | 85 | 0.118 | 0.0848 | 0.719 | 0.00567 | 2.336 |
| fs | 0 | 0.0201 | 3.41e-06 | 0.000 | - | 2.369 |
| fs | 27 | 0.0967 | 0.000183 | 0.002 | - | 2.407 |
| fs | 85 | 0.186 | 0.0518 | 0.278 | 0.215 | 2.491 |

Excitatory gain across corners: 0.00892 to 0.216 (24.2x).

## Device mismatch (one code-4 pulse, 50 samples)

| quantity | mean | std dev | std / mean | min | max |
|---|---|---|---|---|---|
| excitatory gain | 0.2699 | 0.275 | 1.02 | 0.03199 | 1.176 |
| inhibitory gain | 0.01463 | 0.0034 | 0.23 | 0.005893 | 0.0206 |
| i / e | 0.1315 | 0.133 | 1.01 | 0.01045 | 0.6083 |

Every run: `dpi_pulse_tb__DPI__chain.csv`. Logs and waveforms: `runs/dpipulse_sch_DPI_chain_*/`.
