Latios1928/engn2912e-project/analog/testbenches/neuron/results/neuron_nominal_tb__robust.md

# neuron_nominal_tb__robust: neuron robustness

Generated by `run_neuron_robust.py` on 2026-11-12 11:11. Neuron: schematic `neuron_sized.sch`. Testbench `neuron_nominal_tb` (9.5 nA DC), runs of 5 ms, bias voltages fixed unless stated.

Specs (`analog/neuron/sizing_context.txt`, defined at tt 27 C): period 190-210 us, t_spike 9-11 us, t_refr 12-15 us, v_spike_max >= 0.9 VDD, v_reset <= 50 mV, p_avg <= 1 uW. Bold: outside the spec. *fires* = at least 7 spikes in the run (needed for the measurements).

## Process corners and temperature

1 of 15 conditions meet all specs. Does not fire: ff 27 C, ff 85 C, fs 85 C.

| corner | T (C) | fires | period (us) | t_spike (us) | t_refr (us) | v_spike_max (V) | v_reset (mV) | p_avg (uW) | all specs |
|---|---|---|---|---|---|---|---|---|---|
| ff | 0 | yes | **231.6** | **1.825** | **3.254** | 3.298 | 0.5947 | **1.532** | **FAIL** |
| ff | 27 | **no** | - | - | - | - | - | - | **FAIL** |
| ff | 85 | **no** | - | - | - | - | - | - | **FAIL** |
| fs | 0 | yes | 209 | **2.107** | **3.884** | **2.237** | 1.232 | 0.9636 | **FAIL** |
| fs | 27 | yes | **336** | **1.618** | **2.708** | **2.419** | 1.985 | **1.46** | **FAIL** |
| fs | 85 | **no** | - | - | - | - | - | - | **FAIL** |
| sf | 0 | yes | **413.7** | **110** | **218.8** | **2.533** | 1.067 | 0.05053 | **FAIL** |
| sf | 27 | yes | **276.3** | **61.08** | **94.29** | 3.299 | 0.9811 | 0.1087 | **FAIL** |
| sf | 85 | yes | **213.3** | 10.12 | 14.98 | 3.3 | 1.229 | 0.3503 | **FAIL** |
| ss | 0 | yes | **756.5** | **243.9** | **499.7** | **2.429** | 1.183 | 0.07788 | **FAIL** |
| ss | 27 | yes | **369.6** | **85.71** | **156.5** | **2.632** | 1.233 | 0.1188 | **FAIL** |
| ss | 85 | yes | **234.1** | **16.75** | **25.82** | 3.035 | 1.387 | 0.2319 | **FAIL** |
| tt | 0 | yes | **213.2** | **20.3** | **33.93** | 3.065 | 0.8312 | 0.2341 | **FAIL** |
| tt | 27 | yes | 201.4 | 9.2 | 14.61 | 3.224 | 0.8998 | 0.3813 | PASS |
| tt | 85 | yes | **500.7** | **2.654** | **4.108** | 3.298 | 1.199 | 0.9961 | **FAIL** |

## Supply voltage

*fixed*: all biases at their nominal voltage. *tracks VDD*: VNA and VKup (PMOS, source at VDD) move with VDD, so their gate-source voltage stays the same.

| VDD (V) | PMOS biases | fires | period (us) | t_spike (us) | t_refr (us) | v_spike_max (V) | v_reset (mV) | p_avg (uW) | all specs |
|---|---|---|---|---|---|---|---|---|---|
| 3 | fixed | yes | **266.7** | **0.1431** | **4.749** | **1.502** | 4.389 | 0.7498 | **FAIL** |
| 3 | tracks VDD | yes | 200.1 | **8.845** | 13.35 | 2.986 | 0.9588 | 0.3347 | **FAIL** |
| 3.3 | fixed | yes | 201.4 | 9.2 | 14.61 | 3.224 | 0.8998 | 0.3813 | PASS |
| 3.3 | tracks VDD | yes | 201.4 | 9.2 | 14.61 | 3.224 | 0.8998 | 0.3813 | PASS |
| 3.6 | fixed | yes | 202.7 | 10.13 | **16.45** | 3.6 | 0.8371 | 0.4627 | **FAIL** |
| 3.6 | tracks VDD | yes | 202.2 | 9.166 | **15.46** | 3.395 | 0.867 | 0.4306 | **FAIL** |

## Bias sensitivity (each bias +-10 mV)

Change of each spec per 10 mV increase of the bias (half the difference between +10 mV and -10 mV). *Tolerance*: drift (mV, linear estimate) before the first spec leaves its range, and which spec that is. Bias voltages on subthreshold devices change their current by about 10x per 60-100 mV, so a few mV matter.

| bias | period (us/10 mV) | t_spike (us/10 mV) | t_refr (us/10 mV) | v_spike_max (V/10 mV) | v_reset (mV/10 mV) | p_avg (uW/10 mV) | tolerance (mV) |
|---|---|---|---|---|---|---|---|
| vlk (0.425 V) | +3.15 | +0.0103 | +0.0162 | +0.000915 | -0.000864 | -0.00112 | 27.3 (+, period) |
| vamp (0.535 V) | +0.0355 | -0.0232 | -0.0219 | -0.00377 | +0.000853 | +0.0452 | 86.0 (+, t_spike) |
| vip (0.573 V) | -0.0965 | -0.0226 | -0.0212 | -0.00256 | +0.000776 | +0.00775 | 88.5 (+, t_spike) |
| vna (1.93 V) | -0.083 | -0.121 | -0.11 | -0.0198 | +0.00421 | -0.00187 | 16.5 (+, t_spike) |
| vkup (2.35 V) | -0.094 | -0.158 | -0.193 | -0.0354 | +0.00756 | +0.00309 | 12.6 (+, t_spike) |
| vk (1.22 V) | -0.023 | +0.0006 | +0.00215 | +1.5e-05 | -0.00228 | -0.000179 | 1827.0 (+, t_refr) |
| vkdn (0.588 V) | -3.36 | -2.05 | -3.32 | -0.01 | +0.00226 | +0.00573 | 1.0 (+, t_spike) |
| vt (1.66 V) | +1.14 | +0.0009 | +0.0009 | +0.00015 | -3.3e-05 | +0.000978 | 75.7 (+, period) |

Tolerance sign: (+, x) means raising the bias makes spec x fail first; (-, x) lowering it.

| bias | change | fires | period (us) | t_spike (us) | t_refr (us) | v_spike_max (V) | v_reset (mV) | p_avg (uW) | all specs |
|---|---|---|---|---|---|---|---|---|---|
| nominal | +0 mV | yes | 201.4 | 9.2 | 14.61 | 3.224 | 0.8998 | 0.3813 | PASS |
| vamp | -10 mV | yes | 201.4 | 9.23 | 14.64 | 3.229 | 0.8987 | 0.34 | PASS |
| vamp | +10 mV | yes | 201.4 | 9.183 | 14.59 | 3.222 | 0.9004 | 0.4304 | PASS |
| vip | -10 mV | yes | 201.5 | 9.293 | 14.69 | 3.237 | 0.8965 | 0.3743 | PASS |
| vip | +10 mV | yes | 201.3 | 9.248 | 14.65 | 3.232 | 0.898 | 0.3898 | PASS |
| vk | -10 mV | yes | 201.4 | 9.209 | 14.61 | 3.226 | 0.9018 | 0.3816 | PASS |
| vk | +10 mV | yes | 201.4 | 9.21 | 14.62 | 3.226 | 0.8972 | 0.3812 | PASS |
| vkdn | -10 mV | yes | 205.2 | **11.53** | **18.36** | 3.238 | 0.8969 | 0.3749 | **FAIL** |
| vkdn | +10 mV | yes | 198.5 | **7.433** | **11.73** | 3.218 | 0.9014 | 0.3864 | **FAIL** |
| vkup | -10 mV | yes | 201.5 | 9.353 | 14.79 | 3.258 | 0.8928 | 0.3783 | PASS |
| vkup | +10 mV | yes | 201.3 | 9.037 | 14.4 | 3.187 | 0.9079 | 0.3845 | PASS |
| vlk | -10 mV | yes | 198.7 | 9.261 | 14.66 | 3.234 | 0.898 | 0.3824 | PASS |
| vlk | +10 mV | yes | 205 | 9.282 | 14.69 | 3.236 | 0.8963 | 0.3801 | PASS |
| vna | -10 mV | yes | 201.5 | 9.346 | 14.74 | 3.248 | 0.8948 | 0.3835 | PASS |
| vna | +10 mV | yes | 201.4 | 9.104 | 14.52 | 3.208 | 0.9032 | 0.3797 | PASS |
| vt | -10 mV | yes | 200.3 | 9.226 | 14.63 | 3.228 | 0.8989 | 0.3805 | PASS |
| vt | +10 mV | yes | 202.6 | 9.227 | 14.63 | 3.229 | 0.8988 | 0.3824 | PASS |

## Device mismatch (tt, 27 C)

100 of 100 samples fire; **20 of 100 meet all specs (20 % yield)**.

| spec | mean | std dev | min | max | in spec |
|---|---|---|---|---|---|
| period (us) | 201.5 | 5.49 | 191.5 | 218.1 | 94 / 100 |
| t_spike (us) | 9.37 | 0.995 | 6.993 | 11.88 | 58 / 100 |
| t_refr (us) | 14.85 | 1.63 | 10.91 | 19 | 53 / 100 |
| v_spike_max (V) | 3.233 | 0.0216 | 3.167 | 3.269 | 100 / 100 |
| v_reset (mV) | 0.8975 | 0.00605 | 0.8838 | 0.9137 | 100 / 100 |
| p_avg (uW) | 0.403 | 0.124 | 0.2 | 0.8927 | 100 / 100 |

Every run: `neuron_nominal_tb__robust.csv`. Netlists, logs and waveforms: `runs/robust_sch_*/`.
