Latios1928/engn2912e-project/analog/testbenches/neuron/results/neuron_nominal_tb__robust__pex.md

# neuron_nominal_tb__robust__pex: neuron robustness

Generated by `run_neuron_robust.py --pex` on 2026-11-12 11:11. Neuron: post-layout extraction (Extraction: neuron_sized_pex.spice (Magic, RC_extract.sh) of neuron_sized.gds, md5 f8c0e5f946c4151b1e8247031d836878). Testbench `neuron_nominal_tb` (9.5 nA DC), runs of 5 ms, bias voltages fixed unless stated.

Specs (`analog/neuron/sizing_context.txt`, defined at tt 27 C): period 190-210 us, t_spike 9-11 us, t_refr 12-15 us, v_spike_max >= 0.9 VDD, v_reset <= 50 mV, p_avg <= 1 uW. Bold: outside the spec. *fires* = at least 7 spikes in the run (needed for the measurements).

## Process corners and temperature

0 of 15 conditions meet all specs. Does not fire: ff 27 C, ff 85 C, fs 85 C.

| corner | T (C) | fires | period (us) | t_spike (us) | t_refr (us) | v_spike_max (V) | v_reset (mV) | p_avg (uW) | all specs |
|---|---|---|---|---|---|---|---|---|---|
| ff | 0 | yes | **239.3** | **1.973** | **3.488** | 3.298 | 0.6256 | **1.537** | **FAIL** |
| ff | 27 | **no** | - | - | - | - | - | - | **FAIL** |
| ff | 85 | **no** | - | - | - | - | - | - | **FAIL** |
| fs | 0 | yes | **215.7** | **2.248** | **4.153** | **2.24** | 1.248 | 0.9743 | **FAIL** |
| fs | 27 | yes | **346.2** | **1.734** | **2.857** | **2.414** | 1.96 | **1.465** | **FAIL** |
| fs | 85 | **no** | - | - | - | - | - | - | **FAIL** |
| sf | 0 | yes | **390.2** | **61.13** | **181.8** | **2.088** | 1.288 | 0.04983 | **FAIL** |
| sf | 27 | yes | **289.2** | **62.8** | **99.61** | 3.197 | 0.9669 | 0.08456 | **FAIL** |
| sf | 85 | yes | **220.7** | 10.65 | **16.16** | 3.297 | 1.246 | 0.3355 | **FAIL** |
| ss | 0 | yes | **636** | **76.53** | **361.6** | **1.872** | 1.586 | 0.04248 | **FAIL** |
| ss | 27 | yes | **397.4** | **95.97** | **173.5** | **2.672** | 1.202 | 0.1087 | **FAIL** |
| ss | 85 | yes | **244.7** | **19.79** | **29.58** | 3.178 | 1.344 | 0.2443 | **FAIL** |
| tt | 0 | yes | **224.2** | **23.75** | **38.74** | 3.171 | 0.7963 | 0.2383 | **FAIL** |
| tt | 27 | yes | 208.8 | 10.23 | **16.11** | 3.274 | 0.9012 | 0.3921 | **FAIL** |
| tt | 85 | yes | **515.6** | **2.863** | **4.388** | 3.298 | 1.229 | 0.9993 | **FAIL** |

## Supply voltage

*fixed*: all biases at their nominal voltage. *tracks VDD*: VNA and VKup (PMOS, source at VDD) move with VDD, so their gate-source voltage stays the same.

| VDD (V) | PMOS biases | fires | period (us) | t_spike (us) | t_refr (us) | v_spike_max (V) | v_reset (mV) | p_avg (uW) | all specs |
|---|---|---|---|---|---|---|---|---|---|
| 3 | fixed | yes | **279.5** | **0.0338** | **5.029** | **1.501** | 4.537 | 0.7745 | **FAIL** |
| 3 | tracks VDD | yes | 207.2 | 9.541 | 14.43 | 2.995 | 0.9716 | 0.3442 | PASS |
| 3.3 | fixed | yes | 208.8 | 10.23 | **16.11** | 3.274 | 0.9012 | 0.3921 | **FAIL** |
| 3.3 | tracks VDD | yes | 208.8 | 10.23 | **16.11** | 3.274 | 0.9012 | 0.3921 | **FAIL** |
| 3.6 | fixed | yes | 209.6 | 10.51 | **17.9** | 3.59 | 0.8459 | 0.3696 | **FAIL** |
| 3.6 | tracks VDD | yes | **210.1** | 10.31 | **17.19** | 3.471 | 0.8651 | 0.4426 | **FAIL** |

## Bias sensitivity (each bias +-10 mV)

Change of each spec per 10 mV increase of the bias (half the difference between +10 mV and -10 mV). *Tolerance*: drift (mV, linear estimate) before the first spec leaves its range, and which spec that is. Bias voltages on subthreshold devices change their current by about 10x per 60-100 mV, so a few mV matter.

| bias | period (us/10 mV) | t_spike (us/10 mV) | t_refr (us/10 mV) | v_spike_max (V/10 mV) | v_reset (mV/10 mV) | p_avg (uW/10 mV) | tolerance (mV) |
|---|---|---|---|---|---|---|---|
| vlk (0.425 V) | +3.27 | +0.0177 | +0.0234 | -0.00144 | -0.000966 | -0.00107 | 3.6 (+, period) |
| vamp (0.535 V) | -0.015 | -0.0519 | -0.0422 | -0.0097 | +0.00148 | +0.0439 | 138.4 (+, p_avg) |
| vip (0.573 V) | -0.101 | +0.0664 | +0.0667 | +0.0113 | -0.00233 | +0.00809 | 114.7 (-, period) |
| vna (1.93 V) | -0.017 | -0.0049 | +0.00415 | -0.006 | +1e-06 | -0.00182 | 505.5 (+, v_spike_max) |
| vkup (2.35 V) | +0.046 | -0.0132 | -0.0583 | -0.0108 | +0.00206 | +0.00377 | 253.0 (+, period) |
| vk (1.22 V) | -0.0125 | -0.0408 | -0.0367 | -0.00104 | -0.00112 | -0.000147 | 189.8 (-, t_spike) |
| vkdn (0.588 V) | -3.66 | -2.17 | -3.58 | +0.00023 | -0.000195 | +0.00699 | 3.2 (-, period) |
| vt (1.66 V) | +1.15 | -0.0031 | -0.0019 | -0.00107 | +0.000112 | +0.000476 | 10.2 (+, period) |

Tolerance sign: (+, x) means raising the bias makes spec x fail first; (-, x) lowering it. Specs already out of range at nominal, so left out of the tolerance: t_refr.

| bias | change | fires | period (us) | t_spike (us) | t_refr (us) | v_spike_max (V) | v_reset (mV) | p_avg (uW) | all specs |
|---|---|---|---|---|---|---|---|---|---|
| nominal | +0 mV | yes | 208.8 | 10.23 | **16.11** | 3.274 | 0.9012 | 0.3921 | **FAIL** |
| vamp | -10 mV | yes | 208.9 | 10.27 | **16.14** | 3.282 | 0.9002 | 0.3526 | **FAIL** |
| vamp | +10 mV | yes | 208.8 | 10.16 | **16.06** | 3.262 | 0.9032 | 0.4404 | **FAIL** |
| vip | -10 mV | yes | 208.9 | 10.09 | **15.99** | 3.255 | 0.9055 | 0.3845 | **FAIL** |
| vip | +10 mV | yes | 208.7 | 10.23 | **16.12** | 3.277 | 0.9008 | 0.4006 | **FAIL** |
| vk | -10 mV | yes | 208.8 | 10.22 | **16.11** | 3.274 | 0.9037 | 0.3923 | **FAIL** |
| vk | +10 mV | yes | 208.8 | 10.14 | **16.04** | 3.272 | 0.9015 | 0.392 | **FAIL** |
| vkdn | -10 mV | yes | **213** | **12.66** | **20.13** | 3.273 | 0.9015 | 0.3845 | **FAIL** |
| vkdn | +10 mV | yes | 205.6 | **8.314** | 12.96 | 3.274 | 0.9011 | 0.3984 | **FAIL** |
| vkup | -10 mV | yes | 208.8 | 10.14 | **16.08** | 3.28 | 0.9022 | 0.3884 | **FAIL** |
| vkup | +10 mV | yes | 208.9 | 10.12 | **15.96** | 3.259 | 0.9063 | 0.396 | **FAIL** |
| vlk | -10 mV | yes | 206 | 10.14 | **16.02** | 3.274 | 0.9043 | 0.3929 | **FAIL** |
| vlk | +10 mV | yes | **212.6** | 10.17 | **16.07** | 3.271 | 0.9023 | 0.3908 | **FAIL** |
| vna | -10 mV | yes | 208.8 | 10.2 | **16.08** | 3.279 | 0.902 | 0.3939 | **FAIL** |
| vna | +10 mV | yes | 208.8 | 10.19 | **16.09** | 3.267 | 0.902 | 0.3903 | **FAIL** |
| vt | -10 mV | yes | 207.7 | 10.2 | **16.09** | 3.272 | 0.902 | 0.3917 | **FAIL** |
| vt | +10 mV | yes | 210 | 10.19 | **16.08** | 3.27 | 0.9023 | 0.3927 | **FAIL** |

## Device mismatch (tt, 27 C)

100 of 100 samples fire; **7 of 100 meet all specs (7 % yield)**.

| spec | mean | std dev | min | max | in spec |
|---|---|---|---|---|---|
| period (us) | 208.9 | 5.4 | 195.6 | 222 | 58 / 100 |
| t_spike (us) | 10.2 | 1.18 | 7.651 | 13.2 | 59 / 100 |
| t_refr (us) | 16.11 | 1.92 | 11.98 | 21.07 | 29 / 100 |
| v_spike_max (V) | 3.267 | 0.0247 | 3.204 | 3.299 | 100 / 100 |
| v_reset (mV) | 0.9032 | 0.00818 | 0.87 | 0.9212 | 100 / 100 |
| p_avg (uW) | 0.4257 | 0.13 | 0.2424 | 0.7767 | 100 / 100 |

Every run: `neuron_nominal_tb__robust__pex.csv`. Netlists, logs and waveforms: `runs/robust_pex_*/`.
