Latios1928/engn2912e-project/analog/testbenches/neuron/results/neuron_pulse_tb__pex.md

# neuron_pulse_tb__pex: neuron driven by current pulses

Generated by `run_neuron_pulse.py --pex` on 2026-11-12 09:01. Neuron: post-layout extraction (Extraction: neuron_sized_pex.spice (Magic, RC_extract.sh) of neuron_sized.gds, md5 f8c0e5f946c4151b1e8247031d836878). tt, 27 C, VDD 3.3 V, biases as in `neuron_nominal_tb`, first pulse at 50 us, maximum time step 100 ns.

Ideal reference: an integrate-and-fire neuron with no leak, reset to 0, needs ceil(Q/q) pulses per spike, Q = C VT = 1 pF x 1.66 V = 1.66 pC.

Effective membrane capacitance from the VMEM step of pulse 1 (q / step): 1.034 pF to 1.116 pF (1 pF MIM plus device and wiring capacitance on VMEM).

## Charge per pulse (10 us pulses every 200 us)

Smallest charge per pulse that fires: 150 fC (15 nA pulses). 

| Pulse | q | ideal pulses/spike | first spike after pulse | pulses/spike after | VMEM step, pulse 1 | droop to pulse 2 |
|---|---|---|---|---|---|---|
| 5 nA | 50 fC | 34 | never | - | 44.9 mV | 47.1 mV |
| 10 nA | 100 fC | 17 | never | - | 92.7 mV | 81.9 mV |
| 15 nA | 150 fC | 12 | 44 | 44.00 | 141 mV | 93.1 mV |
| 20 nA | 200 fC | 9 | 19 | 19.00 | 189 mV | 94.9 mV |
| 30 nA | 300 fC | 6 | 9 | 9.00 | 286 mV | 96.5 mV |
| 50 nA | 500 fC | 4 | 5 | 5.00 | 480 mV | 99.1 mV |
| 80 nA | 800 fC | 3 | 3 | 3.00 | 771 mV | 102 mV |
| 120 nA | 1.2 pC | 2 | 2 | 2.00 | 1.16 V | 106 mV |
| 166 nA | 1.66 pC | 1 | 2 | 2.00 | 1.61 V | 111 mV |
| 250 nA | 2.5 pC | 1 | 1 | 1.00 | -4.89 mV | -5.42 uV |
| 400 nA | 4 pC | 1 | 1 | 1.00 | -4.46 mV | 427 uV |

## Interval between pulses (20 nA x 10 us, q = 0.2 pC, ideal 9 pulses)

Longest interval that still fires: 200 us.

| Interval | average current | first spike after pulse | pulses/spike after | droop to pulse 2 |
|---|---|---|---|---|
| 15 us | 13.3 nA | 9 | 10.00 | 2.06 mV |
| 25 us | 8 nA | 10 | 10.00 | 7.16 mV |
| 50 us | 4 nA | 10 | 10.00 | 19.8 mV |
| 100 us | 2 nA | 12 | 12.00 | 45 mV |
| 200 us | 1 nA | 19 | 19.00 | 94.9 mV |
| 500 us | 400 pA | never | - | 192 mV |
| 1 ms | 200 pA | never | - | 194 mV |
| 2 ms | 100 pA | never | - | 194 mV |
| 5 ms | 40 pA | never | - | 194 mV |

## Pulses inside the refractory period (200 nA x 10 us, q = 2 pC > Q)

Shortest interval at which every pulse fires: 28 us (nominal spike width + refractory time: 23.81 us).

| Interval | input pulses | output spikes | spikes per pulse |
|---|---|---|---|
| 12 us | 77 | 36 | 0.47 |
| 16 us | 59 | 32 | 0.54 |
| 20 us | 59 | 40 | 0.68 |
| 24 us | 59 | 45 | 0.76 |
| 28 us | 59 | 60 | 1.02 |
| 32 us | 60 | 60 | 1.00 |
| 40 us | 60 | 60 | 1.00 |
| 60 us | 60 | 60 | 1.00 |

Plot: `neuron_pulse_tb.png`. Per-point netlists, logs and waveforms: `runs/pulse_pex_*/`.
