Latios1928/engn2912e-project/analog/testbenches/neuron/results/neuron_rate_tb.md

# neuron_rate_tb: firing rate vs input current

Generated by `run_neuron_rate.py` on 2026-11-12 08:35. Neuron: schematic `neuron_sized.sch`. tt, 27 C, VDD 3.3 V, biases as in `neuron_nominal_tb`, maximum time step 100 ns.

| Result | Value |
|---|---|
| Lowest current tested that does not fire repeatedly | 728.6 pA |
| Lowest current tested that fires (>= 3 spikes) | 742.9 pA |
| Slope of the rate, 1-20 nA (ideal 1/(C VT) = 602 Hz/nA) | 512.4 Hz/nA |
| Highest current with clean spikes, and its rate | 416.3 nA: 54.93 kHz |
| Lowest current tested that overdrives (spike no longer falls below 0.33 V) | 500 nA |
| Lowest current tested that latches (spike stuck high) | 5 uA |
| Period at 9.5 nA (spec 190-210 us) | 201.4 us PASS |

Classes: *fires* >= 3 clean spikes; *few* 1-2 spikes (too slow to measure a rate in the run); *silent* no spike; *overdriven* the input beats the reset, so the spike no longer falls below 0.33 V between spikes and VMEM is not held at 0 (the count is of incomplete spikes, shown in brackets); *latched* spike stuck high at the end of the run.

| Iin | class | spikes | rate | first spike | spike min at end | VMEM at end (min-max) |
|---|---|---|---|---|---|---|
| 300 pA | silent | 0 | - | - | 0.000 V | 0.019-0.019 V |
| 400 pA | silent | 0 | - | - | 0.000 V | 0.030-0.030 V |
| 500 pA | silent | 0 | - | - | 0.000 V | 0.070-0.070 V |
| 600 pA | silent | 0 | - | - | 0.000 V | 1.108-1.212 V |
| 700 pA | few | 2 | - | 12.52 ms | -0.000 V | 0.000-3.233 V |
| 714.3 pA | few | 2 | - | 11.25 ms | 0.000 V | 0.309-1.225 V |
| 728.6 pA | few | 2 | - | 10.22 ms | 0.000 V | 0.705-1.579 V |
| 742.9 pA | fires | 3 | 106.6 Hz | 9.368 ms | -0.000 V | 0.000-3.233 V |
| 757.1 pA | fires | 3 | 115.4 Hz | 8.65 ms | -0.000 V | 0.000-3.232 V |
| 771.4 pA | fires | 3 | 124.2 Hz | 8.036 ms | -0.000 V | 0.000-3.237 V |
| 785.7 pA | fires | 3 | 132.9 Hz | 7.506 ms | 0.000 V | 0.396-1.650 V |
| 800 pA | fires | 4 | 141.7 Hz | 7.042 ms | -0.000 V | 0.000-3.237 V |
| 1 nA | fires | 7 | 262.6 Hz | 3.793 ms | -0.000 V | 0.000-3.233 V |
| 1.5 nA | fires | 11 | 560.2 Hz | 1.77 ms | -0.000 V | 0.000-3.238 V |
| 2 nA | fires | 11 | 854.5 Hz | 1.155 ms | -0.000 V | 0.000-3.240 V |
| 3 nA | fires | 11 | 1.435 kHz | 682.3 us | -0.000 V | 0.000-3.234 V |
| 5 nA | fires | 12 | 2.564 kHz | 375.4 us | -0.000 V | 0.000-3.237 V |
| 7 nA | fires | 12 | 3.654 kHz | 259.1 us | -0.000 V | 0.001-3.240 V |
| 9.5 nA | fires | 12 | 4.966 kHz | 186.9 us | -0.000 V | 0.001-3.241 V |
| 15 nA | fires | 13 | 7.659 kHz | 116 us | -0.000 V | 0.001-3.238 V |
| 20 nA | fires | 13 | 9.937 kHz | 86.35 us | -0.000 V | 0.002-3.248 V |
| 30 nA | fires | 14 | 13.93 kHz | 57.21 us | -0.000 V | 0.003-3.251 V |
| 50 nA | fires | 20 | 20.46 kHz | 34.31 us | -0.000 V | 0.005-3.253 V |
| 100 nA | fires | 31 | 31.43 kHz | 17.41 us | -0.000 V | 0.010-3.258 V |
| 200 nA | fires | 43 | 43.33 kHz | 9.01 us | -0.000 V | 0.019-3.267 V |
| 240.2 nA | fires | 46 | 46.21 kHz | 7.61 us | 0.000 V | 0.023-3.271 V |
| 288.5 nA | fires | 49 | 49.21 kHz | 6.409 us | 0.017 V | 0.028-3.273 V |
| 346.6 nA | fires | 53 | 52.91 kHz | 5.509 us | 0.165 V | 0.034-3.257 V |
| 416.3 nA | fires | 55 | 54.93 kHz | 4.703 us | 0.309 V | 0.041-3.237 V |
| 500 nA | overdriven | 59 | (58.35 kHz) | 4.01 us | 0.437 V | 0.049-3.213 V |
| 1 uA | overdriven | 68 | (67.65 kHz) | 2.309 us | 0.836 V | 0.099-3.140 V |
| 2 uA | overdriven | 82 | (81.65 kHz) | 1.524 us | 1.236 V | 0.203-3.084 V |
| 5 uA | latched | 1 | - | 1.007 us | 2.006 V | 0.561-2.914 V |
| 10 uA | latched | 1 | - | 807.1 ns | 3.300 V | 3.174-3.174 V |

Plot: `neuron_rate_tb.png`. Per-point netlists, logs and waveforms: `runs/rate_sch_*/`.
