Latios1928/engn2912e-project/analog/testbenches/neuron/results/neuron_rate_tb__pex.md

# neuron_rate_tb__pex: firing rate vs input current

Generated by `run_neuron_rate.py --pex` on 2026-11-12 08:47. Neuron: post-layout extraction (Extraction: neuron_sized_pex.spice (Magic, RC_extract.sh) of neuron_sized.gds, md5 f8c0e5f946c4151b1e8247031d836878). tt, 27 C, VDD 3.3 V, biases as in `neuron_nominal_tb`, maximum time step 100 ns.

| Result | Value |
|---|---|
| Lowest current tested that does not fire repeatedly | 728.6 pA |
| Lowest current tested that fires (>= 3 spikes) | 742.9 pA |
| Slope of the rate, 1-20 nA (ideal 1/(C VT) = 602 Hz/nA) | 490.3 Hz/nA |
| Highest current with clean spikes, and its rate | 416.3 nA: 50.55 kHz |
| Lowest current tested that overdrives (spike no longer falls below 0.33 V) | 500 nA |
| Lowest current tested that latches (spike stuck high) | 5 uA |
| Period at 9.5 nA (spec 190-210 us) | 208.9 us PASS |

Classes: *fires* >= 3 clean spikes; *few* 1-2 spikes (too slow to measure a rate in the run); *silent* no spike; *overdriven* the input beats the reset, so the spike no longer falls below 0.33 V between spikes and VMEM is not held at 0 (the count is of incomplete spikes, shown in brackets); *latched* spike stuck high at the end of the run.

| Iin | class | spikes | rate | first spike | spike min at end | VMEM at end (min-max) |
|---|---|---|---|---|---|---|
| 300 pA | silent | 0 | - | - | 0.000 V | 0.019-0.019 V |
| 400 pA | silent | 0 | - | - | 0.000 V | 0.030-0.030 V |
| 500 pA | silent | 0 | - | - | 0.000 V | 0.070-0.070 V |
| 600 pA | silent | 0 | - | - | 0.000 V | 1.095-1.200 V |
| 700 pA | few | 2 | - | 12.86 ms | -0.000 V | 0.000-3.145 V |
| 714.3 pA | few | 2 | - | 11.55 ms | 0.000 V | 0.187-1.117 V |
| 728.6 pA | few | 2 | - | 10.49 ms | 0.000 V | 0.590-1.476 V |
| 742.9 pA | fires | 3 | 103.6 Hz | 9.619 ms | -0.000 V | 0.000-3.156 V |
| 757.1 pA | fires | 3 | 112.2 Hz | 8.881 ms | -0.000 V | 0.000-3.156 V |
| 771.4 pA | fires | 3 | 120.7 Hz | 8.25 ms | -0.000 V | 0.000-3.146 V |
| 785.7 pA | fires | 3 | 129.2 Hz | 7.705 ms | 0.000 V | 0.229-1.501 V |
| 800 pA | fires | 4 | 137.7 Hz | 7.228 ms | -0.000 V | 0.000-3.145 V |
| 1 nA | fires | 7 | 255.1 Hz | 3.889 ms | -0.000 V | 0.000-3.157 V |
| 1.5 nA | fires | 11 | 544 Hz | 1.813 ms | -0.000 V | 0.000-3.152 V |
| 2 nA | fires | 11 | 829.3 Hz | 1.183 ms | -0.000 V | 0.000-3.157 V |
| 3 nA | fires | 11 | 1.391 kHz | 698.6 us | -0.000 V | 0.000-3.158 V |
| 5 nA | fires | 11 | 2.481 kHz | 384.5 us | -0.000 V | 0.000-3.160 V |
| 7 nA | fires | 12 | 3.53 kHz | 265.4 us | -0.000 V | 0.001-3.153 V |
| 9.5 nA | fires | 12 | 4.788 kHz | 191.5 us | -0.000 V | 0.001-3.161 V |
| 15 nA | fires | 12 | 7.363 kHz | 119 us | -0.000 V | 0.001-3.158 V |
| 20 nA | fires | 13 | 9.501 kHz | 88.7 us | -0.000 V | 0.002-3.163 V |
| 30 nA | fires | 13 | 13.3 kHz | 58.95 us | -0.000 V | 0.003-3.149 V |
| 50 nA | fires | 19 | 19.37 kHz | 35.54 us | 0.000 V | 0.005-3.162 V |
| 100 nA | fires | 29 | 29.53 kHz | 18.18 us | 0.000 V | 0.010-3.162 V |
| 200 nA | fires | 40 | 40.15 kHz | 9.575 us | 0.000 V | 0.020-3.175 V |
| 240.2 nA | fires | 43 | 42.59 kHz | 8.147 us | 0.002 V | 0.023-3.191 V |
| 288.5 nA | fires | 46 | 45.52 kHz | 6.937 us | 0.049 V | 0.028-3.221 V |
| 346.6 nA | fires | 48 | 48.02 kHz | 5.925 us | 0.169 V | 0.034-3.188 V |
| 416.3 nA | fires | 51 | 50.55 kHz | 5.134 us | 0.321 V | 0.041-3.157 V |
| 500 nA | overdriven | 53 | (53.19 kHz) | 4.437 us | 0.467 V | 0.049-3.096 V |
| 1 uA | overdriven | 62 | (61.85 kHz) | 2.726 us | 0.796 V | 0.100-3.081 V |
| 2 uA | overdriven | 76 | (75.6 kHz) | 1.814 us | 1.198 V | 0.205-3.040 V |
| 5 uA | latched | 1 | - | 1.4 us | 1.980 V | 0.568-2.880 V |
| 10 uA | latched | 1 | - | 1.07 us | 3.300 V | 3.174-3.174 V |

Plot: `neuron_rate_tb.png`. Per-point netlists, logs and waveforms: `runs/rate_pex_*/`.
