Latios1928/engn2912e-project/analog/testbenches/dpi/results/dpi_load_tb__DPI__chain.csv

suite | bias | corner | temp | seed | level | iw | e | i | gain_e | gain_i | e0 | e166 | e32 | i01 | i166 | e_v99 | e_v90 | i_v99 | i_v90 | vsum_e | vsum_i
bias | output | tt | 27 |  | 1 | 1.5e-08 | 1.77222e-08 | 1.09264e-08 | 1.18148 | 0.7284266666666667 | 1.1891413029984992 | 0.6608378192323753 | 0.3333903240004063 | 0.9707955044662469 | 1.0180937911846537 | 0.529107 | 0.803682 | 0.643238 | 0.0407615 | 2.35152 | 2.22703
bias | output | tt | 27 |  | 2 | 4.5e-08 | 4.65995e-08 | 2.80063e-08 | 1.0355444444444444 | 0.6223622222222223 | 1.1704610564491036 | 0.6839536904902412 | 0.35743516561336497 | 0.9738380293005503 | 1.0151287388908925 | 0.531972 | 0.832739 | 0.577342 | 0.0473665 | 2.30375 | 2.17943
bias | output | tt | 27 |  | 3 | 1.5e-07 | 1.25344e-07 | 7.64058e-08 | 0.8356266666666666 | 0.509372 | 1.143836162879755 | 0.7203224725555273 | 0.3943890413581823 | 0.9750621026152464 | 1.0115122150412665 | 0.537362 | 0.887289 | 0.458385 | 0.0592031 | 2.24842 | 2.12176
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
