Latios1928/engn2912e-project/analog/testbenches/bias/results/bias_cell.md

# bias_cell: current-mode bias generator

Generated by `run_bias_cell.py`. Cell `analog/neuron/bias_cell.sch`, Iref = 100 nA, VDD = 3.3 V. Sizing: `bias_design.py` (`bias_cell_sizes.json`).

## Bias voltages across corners and temperature

| corner | T (C) | Vb | Vlk | VKdn | VIp | Vamp_bias | VK | VNA | VKup | Vthr | VT_dpi | VT_inh | supply (nA) |
|---|---|---|---|---|---|---|---|---|---|---|---|---|---|
| tt | 0 | 0.647 | 0.475 | 0.625 | 0.611 | 0.563 | 1.213 | 1.936 | 2.330 | 2.851 | 2.843 | 2.739 | 720 |
| tt | 27 | 0.616 | 0.425 | 0.588 | 0.573 | 0.535 | 1.220 | 1.930 | 2.350 | 2.909 | 2.900 | 2.790 | 719 |
| tt | 85 | 0.551 | 0.317 | 0.509 | 0.492 | 0.476 | 1.233 | 1.921 | 2.394 | 3.033 | 3.023 | 2.902 | 720 |
| ss | 0 | 0.757 | 0.581 | 0.734 | 0.719 | 0.665 | 1.354 | 1.777 | 2.199 | 2.733 | 2.725 | 2.620 | 714 |
| ss | 27 | 0.726 | 0.531 | 0.697 | 0.681 | 0.637 | 1.363 | 1.769 | 2.219 | 2.791 | 2.782 | 2.671 | 715 |
| ss | 85 | 0.661 | 0.423 | 0.618 | 0.601 | 0.579 | 1.382 | 1.755 | 2.261 | 2.915 | 2.904 | 2.783 | 715 |
| ff | 0 | 0.537 | 0.369 | 0.516 | 0.502 | 0.461 | 1.075 | 2.093 | 2.461 | 2.969 | 2.962 | 2.858 | 725 |
| ff | 27 | 0.506 | 0.319 | 0.479 | 0.465 | 0.433 | 1.079 | 2.090 | 2.481 | 3.027 | 3.018 | 2.909 | 725 |
| ff | 85 | 0.441 | 0.211 | 0.400 | 0.383 | 0.374 | 1.087 | 2.085 | 2.526 | 3.151 | 3.141 | 3.020 | 725 |
| sf | 0 | 0.727 | 0.554 | 0.704 | 0.690 | 0.638 | 1.310 | 2.044 | 2.424 | 2.940 | 2.931 | 2.826 | 720 |
| sf | 27 | 0.696 | 0.503 | 0.668 | 0.652 | 0.611 | 1.319 | 2.040 | 2.444 | 2.997 | 2.988 | 2.878 | 720 |
| sf | 85 | 0.632 | 0.395 | 0.589 | 0.572 | 0.552 | 1.335 | 2.033 | 2.488 | 3.121 | 3.111 | 2.990 | 720 |
| fs | 0 | 0.567 | 0.397 | 0.546 | 0.531 | 0.487 | 1.117 | 1.827 | 2.236 | 2.763 | 2.755 | 2.651 | 719 |
| fs | 27 | 0.536 | 0.347 | 0.508 | 0.494 | 0.460 | 1.122 | 1.820 | 2.256 | 2.820 | 2.812 | 2.703 | 719 |
| fs | 85 | 0.470 | 0.239 | 0.429 | 0.412 | 0.401 | 1.132 | 1.808 | 2.299 | 2.945 | 2.934 | 2.814 | 720 |

## neuron_sized, 9.5 nA DC: biases as fixed voltages vs from the cell

| corner | T (C) | period fixed / cell (us) | t_spike fixed / cell (us) | t_refr fixed / cell (us) | v_spike_max fixed / cell (V) | all specs fixed / cell |
|---|---|---|---|---|---|---|
| tt | 0 | 213.4 / 200.3 | 20.64 / 8.334 | 34.26 / 13.68 | 3.086 / 3.083 | fail / fail |
| tt | 27 | 201.4 / 201.5 | 9.289 / 9.319 | 14.69 / 14.71 | 3.235 / 3.237 | PASS / PASS |
| tt | 85 | 500.6 / 202.4 | 2.657 / 9.715 | 4.111 / 15.21 | 3.298 / 3.29 | fail / fail |
| ss | 0 | 756.7 / 220.5 | 244 / 10.58 | 499.7 / 15.59 | 2.427 / 3.269 | fail / fail |
| ss | 27 | 370 / 221 | 86.42 / 10.8 | 157.2 / 15.84 | 2.638 / 3.294 | fail / fail |
| ss | 85 | 234 / 221.9 | 16.6 / 11.1 | 25.67 / 16.15 | 3.023 / 3.3 | fail / fail |
| ff | 0 | 231.6 / 179.8 | 1.817 / 6.232 | 3.252 / 11.72 | 3.298 / 2.859 | fail / fail |
| ff | 27 | - / 180.7 | - / 6.79 | - / 12.36 | - / 2.959 | fail / fail |
| ff | 85 | - / 182.4 | - / 8.082 | - / 13.78 | - / 3.192 | fail / fail |
| sf | 0 | 414.6 / 200.6 | 112.2 / 9.339 | 220.9 / 14.12 | 2.55 / 3.24 | fail / PASS |
| sf | 27 | 276.3 / 201.2 | 61.08 / 9.624 | 94.3 / 14.45 | 3.299 / 3.273 | fail / PASS |
| sf | 85 | 213.3 / 201.9 | 10.1 / 9.955 | 14.97 / 14.82 | 3.3 / 3.298 | fail / PASS |
| fs | 0 | 209 / 200.2 | 2.134 / 7.718 | 3.904 / 13.61 | 2.239 / 2.988 | fail / fail |
| fs | 27 | 336 / 201.1 | 1.619 / 8.17 | 2.709 / 14.14 | 2.41 / 3.057 | fail / fail |
| fs | 85 | - / 202.8 | - / 9.362 | - / 15.46 | - / 3.242 | fail / fail |

Pass (specs of `neuron/sizing_context.txt`): fixed voltages 1/15, bias cell 4/15. '-' = fewer than 7 spikes in 6 ms (does not fire).

## DPI (minimum size) DC gain Isyn/Iw at Iw = 15 nA, VMEM = 1 V

| corner | T (C) | Vthr 2.909 V, VT = VDD - 0.40 V | from the cell |
|---|---|---|---|
| tt | 0 | 0.61 | 0.667 |
| tt | 27 | 0.688 | 0.69 |
| tt | 85 | 0.805 | 0.729 |
| ss | 0 | 0.32 | 0.582 |
| ss | 27 | 0.508 | 0.605 |
| ss | 85 | 0.671 | 0.648 |
| ff | 0 | 0.814 | 0.787 |
| ff | 27 | 0.841 | 0.806 |
| ff | 85 | 0.00671 | 0.809 |
| sf | 0 | 0.873 | 0.873 |
| sf | 27 | 0.919 | 0.89 |
| sf | 85 | 0.548 | 0.927 |
| fs | 0 | 0.314 | 0.507 |
| fs | 27 | 0.448 | 0.53 |
| fs | 85 | 0.609 | 0.56 |

Fixed voltages: gain 0.00671 to 0.919 (136.9x)

Bias cell: gain 0.507 to 0.927 (1.8x)

## Mismatch, 100 samples, tt 27 C

| bias | sigma (mV) |
|---|---|
| Vb | 2.19 |
| Vlk | 2.29 |
| VKdn | 2.67 |
| VIp | 5.46 |
| Vamp_bias | 25.02 |
| VK | 6.53 |
| VNA | 6.90 |
| VKup | 2.57 |
| Vthr | 4.59 |
| VT_dpi | 4.50 |
| VT_inh | 1.63 |
