Latios1928/engn2912e-project/analog/testbenches/dac/results/dac_signed_pulse_tb.csv

suite | corner | temp | code | w | s | tpw | tper | i_on | q | q_ideal | excess | q_spread | q_other | i_idle | q_leak | t_settle | i_peak | en_max | neuron_period | spike_above_vsw
pulse | tt | 27 | 15 | 10 | 0 | 1e-05 | 0.0002 | 1.50053e-07 | 1.59388e-12 | 1.50053e-12 | 9.335e-14 | 0.0008281677416115622 | 2.34e-24 | 3.87677e-13 | 7.75354e-17 | 8.324e-08 | 5.86964e-06 | 3.3
pulse | tt | 27 | 15 | 10 | 1 | 1e-05 | 0.0002 | 1.50053e-07 | 1.59388e-12 | 1.50053e-12 | 9.335e-14 | 0.0008281677416115622 | 2.2905e-20 | 3.87694e-13 | 7.75388e-17 | 8.279e-08 | 5.86962e-06 | 3.3
pulse | tt | 27 | 1 | 1 | 0 | 1e-05 | 0.0002 | 1.50411e-08 | 1.6028175e-13 | 1.50411e-13 | 9.870749999999991e-15 | 0.001123022427693766 | 1.7e-24 | 3.87614e-13 | 7.75228e-17 | 1.927e-08 | 1.62249e-06 | 3.3
pulse | tt | 27 | 1 | 1 | 1 | 1e-05 | 0.0002 | 1.50411e-08 | 1.6028075e-13 | 1.50411e-13 | 9.869749999999994e-15 | 0.0011167903818768545 | 1.83256e-20 | 3.87643e-13 | 7.75286e-17 | 1.925e-08 | 1.62248e-06 | 3.3
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
