Latios1928/engn2912e-project/analog/testbenches/dac/results/dac_signed_static_tb.csv

suite | label | corner | temp | seed | vb | unit | unit1 | fs0 | fs1 | inl | mono | ei_min | ei_max | xtalk | xtalk_abs | leak0_0 | leak0_1 | vmin_e | vmin_i | ratio_w0 | ratio_w1 | ratio_w2 | ratio_w3
nominal | tt_27C | tt | 27 |  | 0.616089 | 1.5003355337500003e-08 | 1.5003355342083334e-08 | 1.50052e-07 | 1.50052e-07 | 0.0034175459486613926 | True | 0.9999986682470134 | 1.0 | 1.8453171643031426e-08 | 2.77556e-16 | 3.8719e-12 | 3.87179e-12 | 1.9531 | 1.9531 | 1.0 | 1.9990205575188418 | 2.997489151607668 | 3.995545435664436
pvt | tt_0C | tt | 0 |  | 0.647458 | 1.5033859936666667e-08 | 1.503385992975e-08 | 1.50356e-07 | 1.50356e-07 | 0.0036142675198235427 | True | 1.0 | 1.0 | 1.8415828445553226e-08 | 2.77556e-16 | 4.6152e-13 | 4.61686e-13 | 1.96635 | 1.96635 | 1.0 | 1.9988296517861999 | 2.99707540607775 | 3.994896507645917
pvt | tt_27C | tt | 27 |  | 0.616089 | 1.5003355337500003e-08 | 1.5003355342083334e-08 | 1.50052e-07 | 1.50052e-07 | 0.0034175459486613926 | True | 0.9999986682470134 | 1.0 | 1.8453171643031426e-08 | 2.77556e-16 | 3.8719e-12 | 3.87179e-12 | 1.9531 | 1.9531 | 1.0 | 1.9990205575188418 | 2.997489151607668 | 3.995545435664436
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
