Latios1928/engn2912e-project/analog/testbenches/dac/results/dac_signed_static_tb_codes.csv

code | ideal_weight | i_e_s0 | i_i_s1 | other_output_s0 | other_output_s1
0 | 0 | 3.8719e-12 | 3.87179e-12 | 2.77556e-16 | 2.77556e-16
1 | 1 | 1.50411e-08 | 1.50411e-08 | 2.77556e-16 | 2.77556e-16
2 | 2 | 3.00636e-08 | 3.00636e-08 | 2.77556e-16 | 2.77556e-16
3 | 3 | 4.50778e-08 | 4.50778e-08 | 2.77556e-16 | 2.77556e-16
4 | 3 | 4.50778e-08 | 4.50778e-08 | 2.77556e-16 | 2.77556e-16
5 | 4 | 6.00858e-08 | 6.00858e-08 | 2.77556e-16 | 2.77556e-16
6 | 5 | 7.5089e-08 | 7.50889e-08 | 2.77556e-16 | 2.77556e-16
7 | 6 | 9.0088e-08 | 9.0088e-08 | 2.77556e-16 | 2.77556e-16
8 | 4 | 6.00858e-08 | 6.00858e-08 | 2.77556e-16 | 2.77556e-16
9 | 5 | 7.5089e-08 | 7.5089e-08 | 2.77556e-16 | 2.77556e-16
10 | 6 | 9.0088e-08 | 9.0088e-08 | 2.77556e-16 | 2.77556e-16
11 | 7 | 1.05084e-07 | 1.05084e-07 | 2.77556e-16 | 2.77556e-16
12 | 7 | 1.05084e-07 | 1.05084e-07 | 2.77556e-16 | 2.77556e-16
13 | 8 | 1.20076e-07 | 1.20076e-07 | 2.77556e-16 | 2.77556e-16
14 | 9 | 1.35065e-07 | 1.35065e-07 | 2.77556e-16 | 2.77556e-16
15 | 10 | 1.50052e-07 | 1.50052e-07 | 2.77556e-16 | 2.77556e-16
