Latios1928/engn2912e-project/analog/testbenches/dpi/results/dpi_load_tb.csv

suite | bias | corner | temp | seed | level | iw | e | i | gain_e | gain_i | e0 | e166 | e32 | i01 | i166 | e_v99 | e_v90 | i_v99 | i_v90 | vsum_e | vsum_i
bias | output | tt | 27 |  | 1 | 1.5e-08 | 1.08092e-08 | 1.09264e-08 | 0.7206133333333334 | 0.7284266666666667 | 1.0119527809643636 | 0.9746419716537764 | 0.9053482218850608 | 0.9707955044662469 | 1.0180937911846537 | 0.972394 | 3.2082 | 0.643433 | 0.0407616 | 2.22703 | 2.22703
bias | output | tt | 27 |  | 2 | 4.5e-08 | 2.78086e-08 | 2.80062e-08 | 0.6179688888888889 | 0.62236 | 1.010611825118848 | 0.9775177463086959 | 0.9058888257589379 | 0.9738379358856253 | 1.0151323635480716 | 1.03547 | 3.20655 | 0.577285 | 0.0473668 | 2.17943 | 2.17943
bias | output | tt | 27 |  | 3 | 1.5e-07 | 7.61448e-08 | 7.64059e-08 | 0.507632 | 0.5093726666666667 | 1.0090078376987004 | 0.9808365114886375 | 0.8955831520996836 | 0.9750621352539529 | 1.0115121999740857 | 1.13178 | 3.19609 | 0.458396 | 0.0592032 | 2.12176 | 2.12176
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
