Latios1928/engn2912e-project/analog/testbenches/dpi/results/dpi_pulse_tb.csv

suite | corner | temp | code | units | qin | qe | qi | ge | gi | ratio | tau_e | tau_i | pe | pi | vsum | n | gap | tpw | vmem | seed
code | tt | 27 | 1 | 1 | 1.5e-13 | -4.7782e-19 | -9.94196e-19 | -3.185466666666667e-06 | -6.627973333333333e-06 | 2.0806914737767355 | -9.9918e-06 | -1.00011 | 2.32592e-14 | 5.44009e-14 | 2.59477 | 1
code | tt | 27 | 2 | 2 | 3e-13 | 1.29368e-16 | 5.2161e-18 | 0.00043122666666666674 | 1.7387e-05 | 0.04031986271720982 | -9.9906e-06 | -1.00011 | 3.9474e-13 | 6.92779e-14 | 2.41014 | 1
code | tt | 27 | 4 | 3 | 4.5e-13 | 6.38233e-15 | 2.02059e-15 | 0.014182955555555555 | 0.0044902 | 0.3165912762267072 | 0.000619846 | -1.225e-07 | 1.76762e-11 | 9.9043e-13 | 2.26355 | 1
code | tt | 27 | 7 | 6 | 9e-13 | 3.83164e-13 | 3.78109e-13 | 0.42573777777777777 | 0.4201211111111111 | 0.9868072157092003 | 0.000382135 | -2.3416e-06 | 1.02347e-09 | 9.41956e-10 | 2.14943 | 1
code | tt | 27 | 10 | 6 | 9e-13 | 3.83164e-13 | 3.78109e-13 | 0.42573777777777777 | 0.4201211111111111 | 0.9868072157092003 | 0.000382135 | -2.3416e-06 | 1.02347e-09 | 9.41956e-10 | 2.14943 | 1
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
