Latios1928/engn2912e-project/analog/testbenches/dac/results/dac_signed_pulse_tb.png

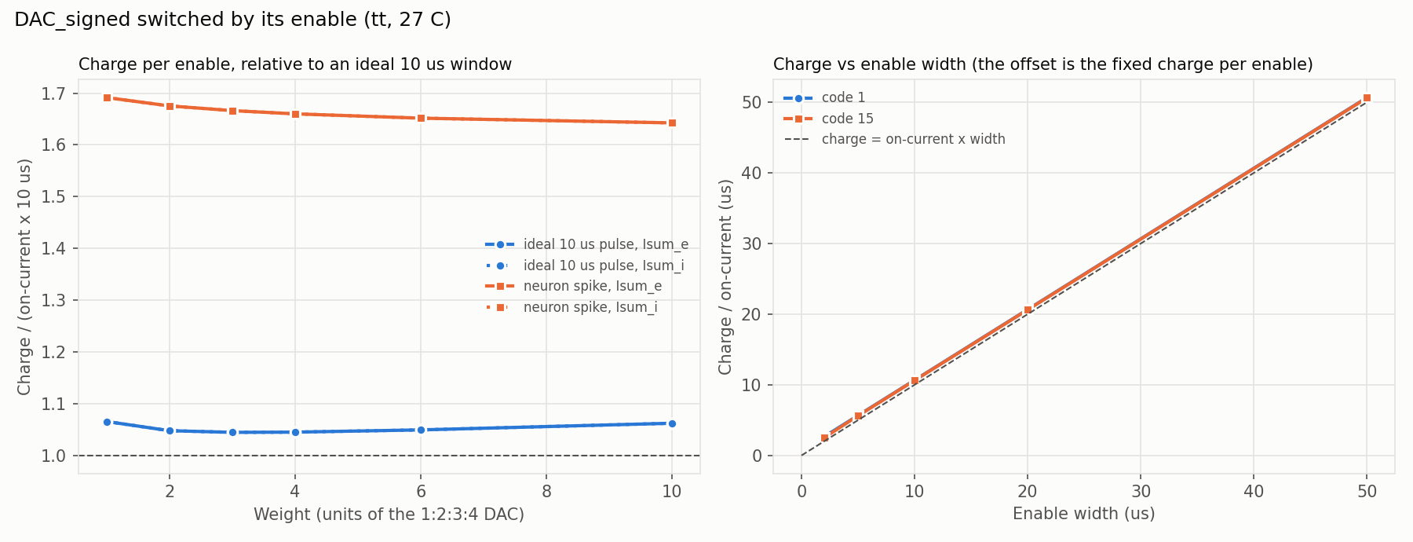
analog/testbenches/dac/results/dac_signed_pulse_tb.png
