Latios1928/engn2912e-project/analog/testbenches/dac/results/dac_signed_static_tb.png

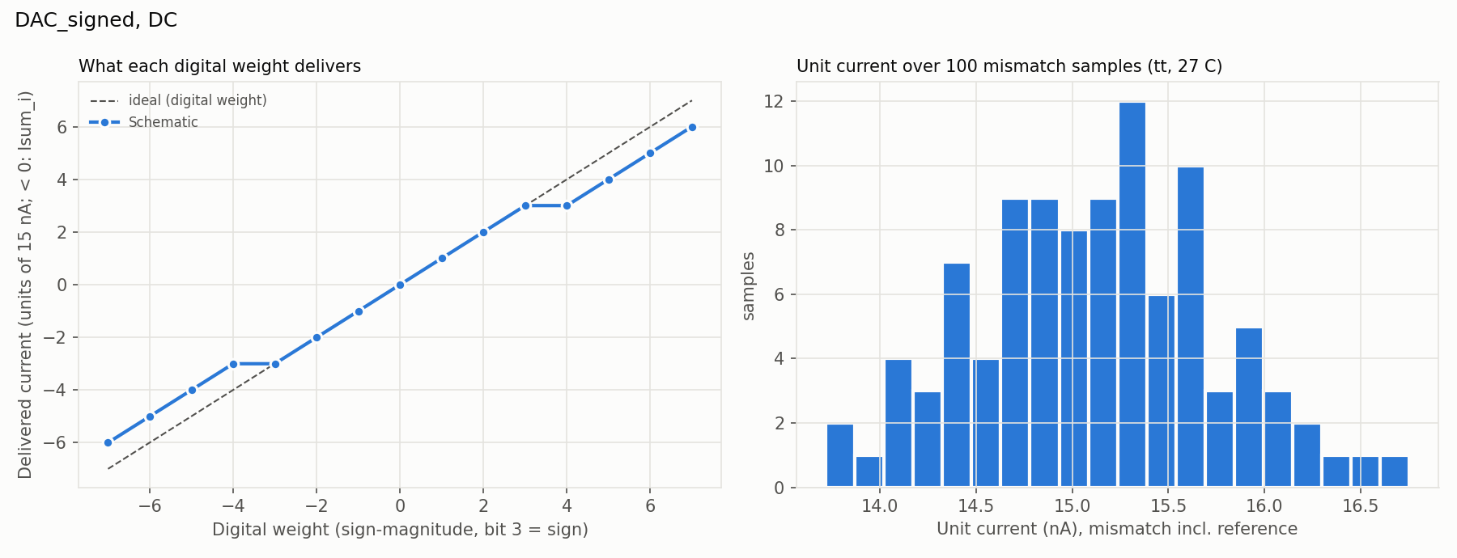
analog/testbenches/dac/results/dac_signed_static_tb.png
