Latios1928/engn2912e-project/analog/testbenches/dpi/results/dpi_load_tb.png

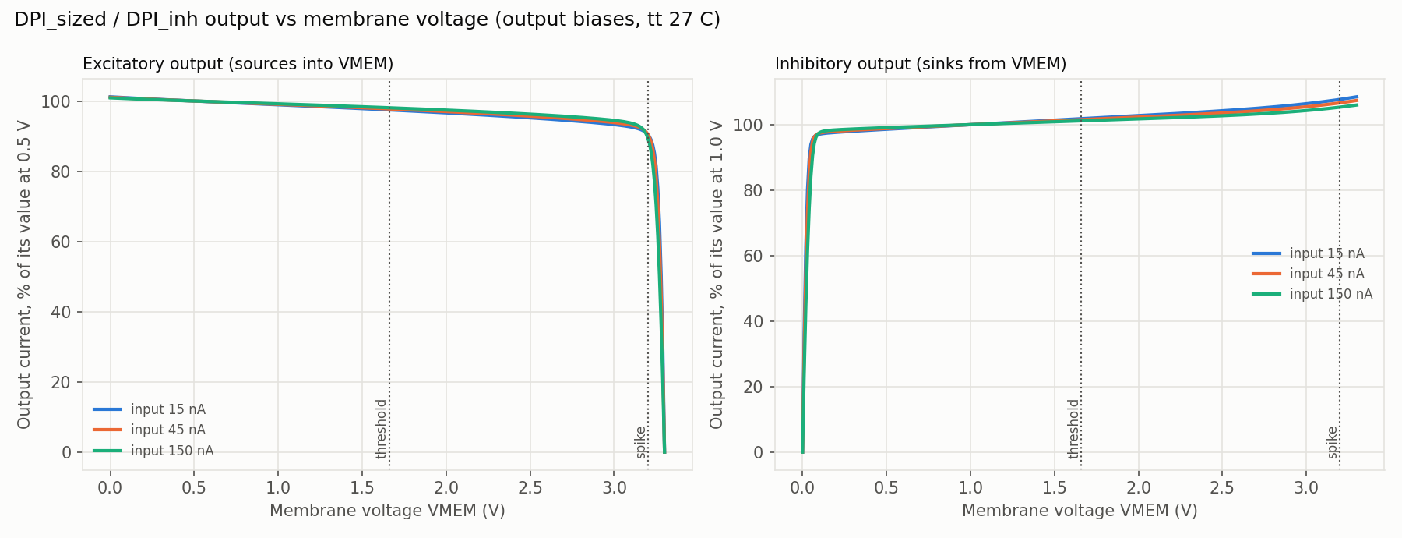
analog/testbenches/dpi/results/dpi_load_tb.png
