Latios1928/engn2912e-project/analog/testbenches/dpi/results/dpi_load_tb__DPI__chain.png

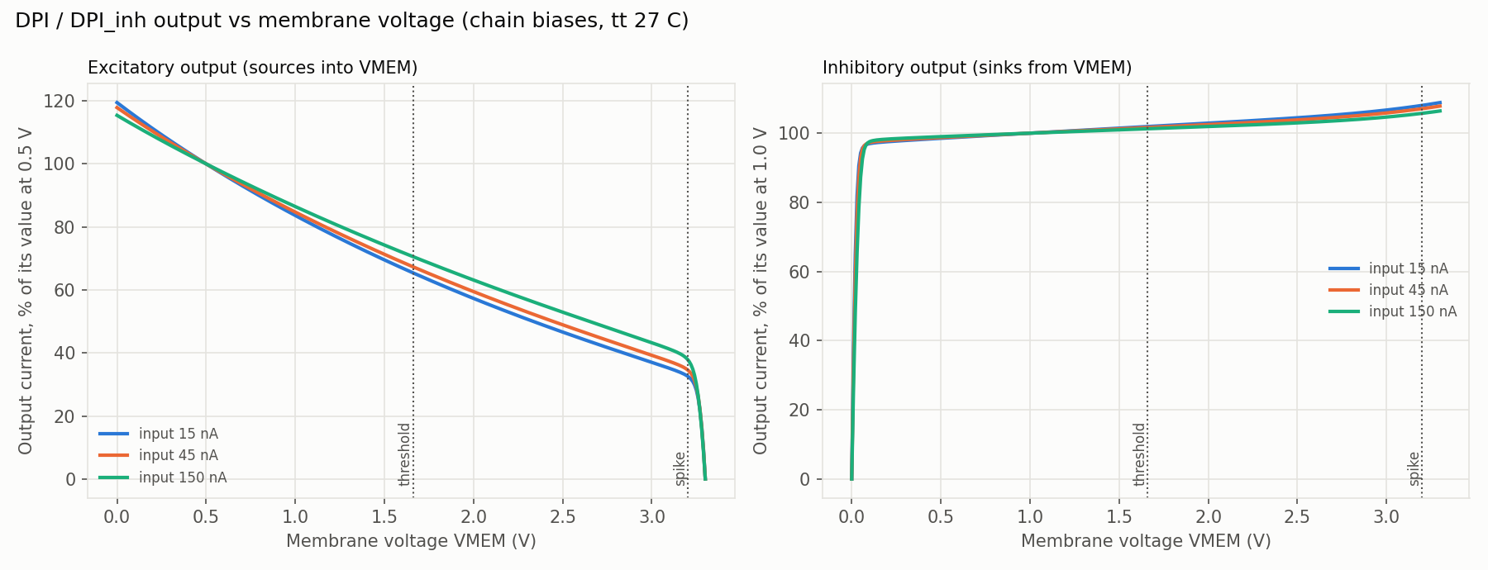
analog/testbenches/dpi/results/dpi_load_tb__DPI__chain.png
