Latios1928/engn2912e-project/analog/testbenches/neuron/results/neuron_nominal_tb__robust_pvt.png

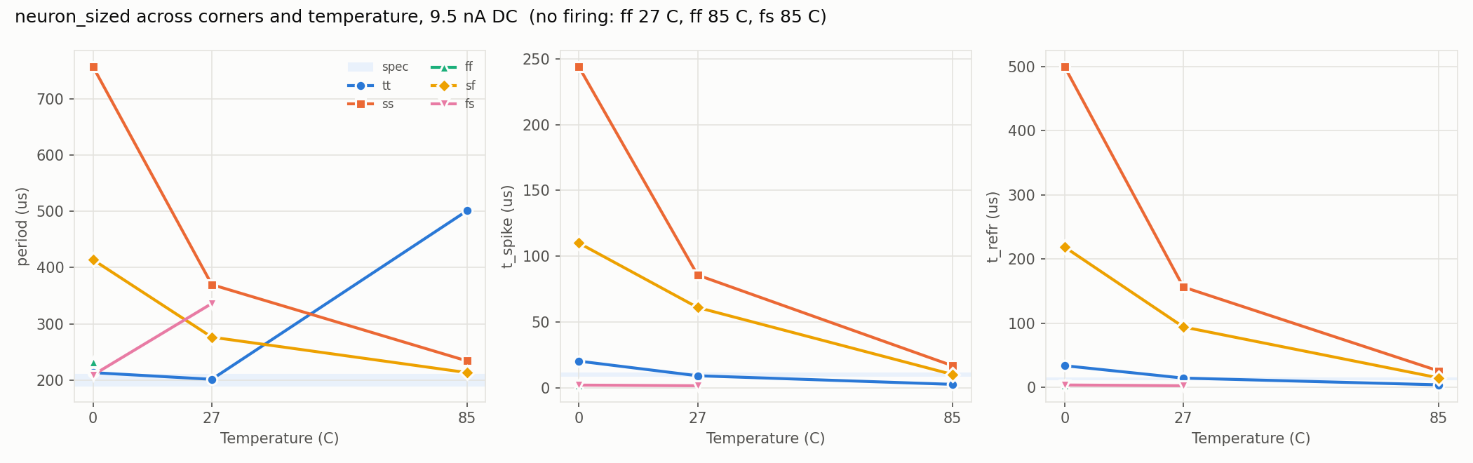
analog/testbenches/neuron/results/neuron_nominal_tb__robust_pvt.png
