Latios1928/engn2912e-project/analog/testbenches/neuron/results/neuron_pulse_tb.png

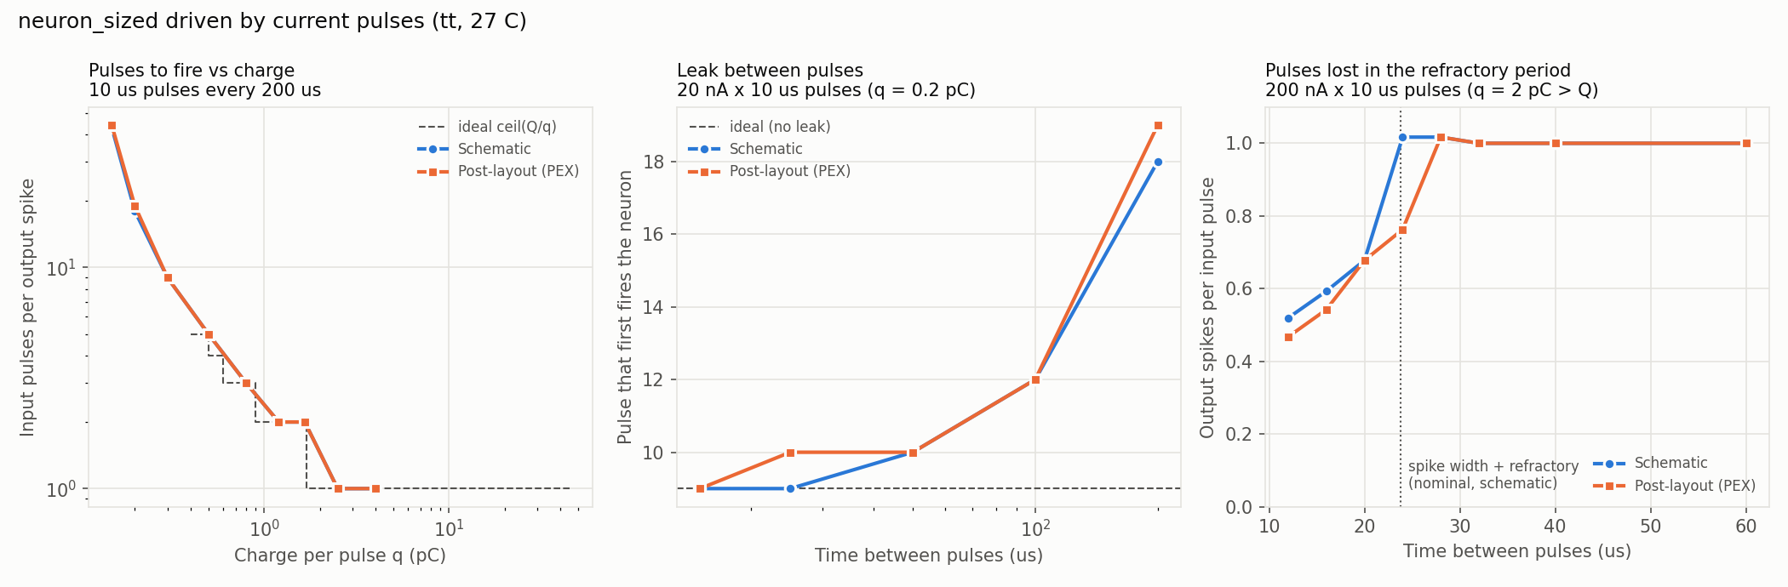
analog/testbenches/neuron/results/neuron_pulse_tb.png
