Latios1928/engn2912e-project/analog/testbenches/neuron/results/neuron_rate_tb.png

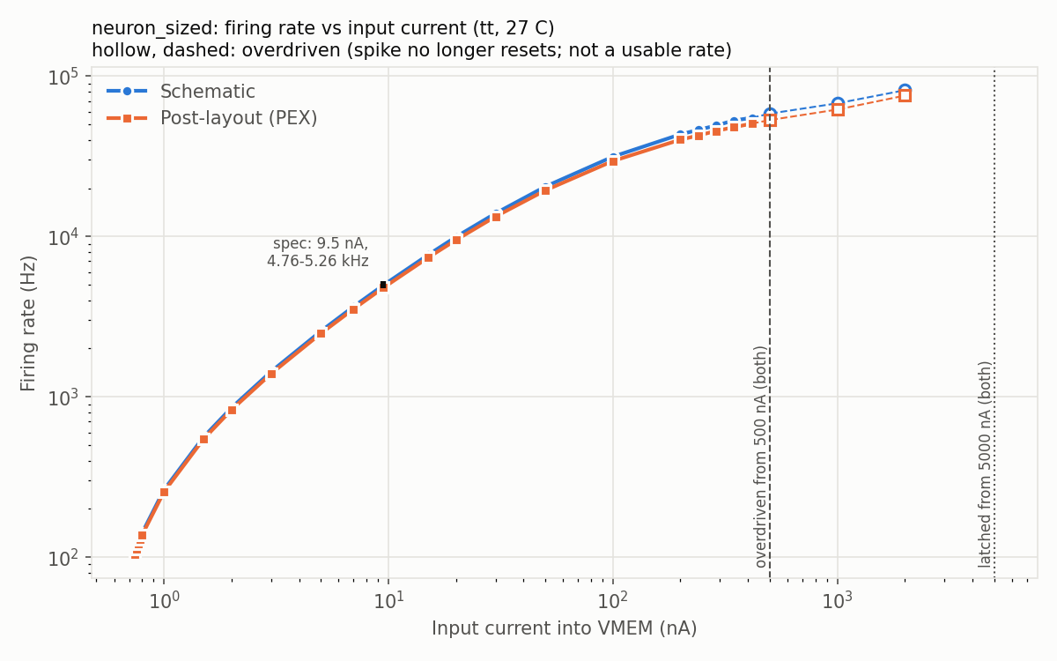
analog/testbenches/neuron/results/neuron_rate_tb.png
