Latios1928/engn2912e-project/librelane/snn_top/results/snn_top.png

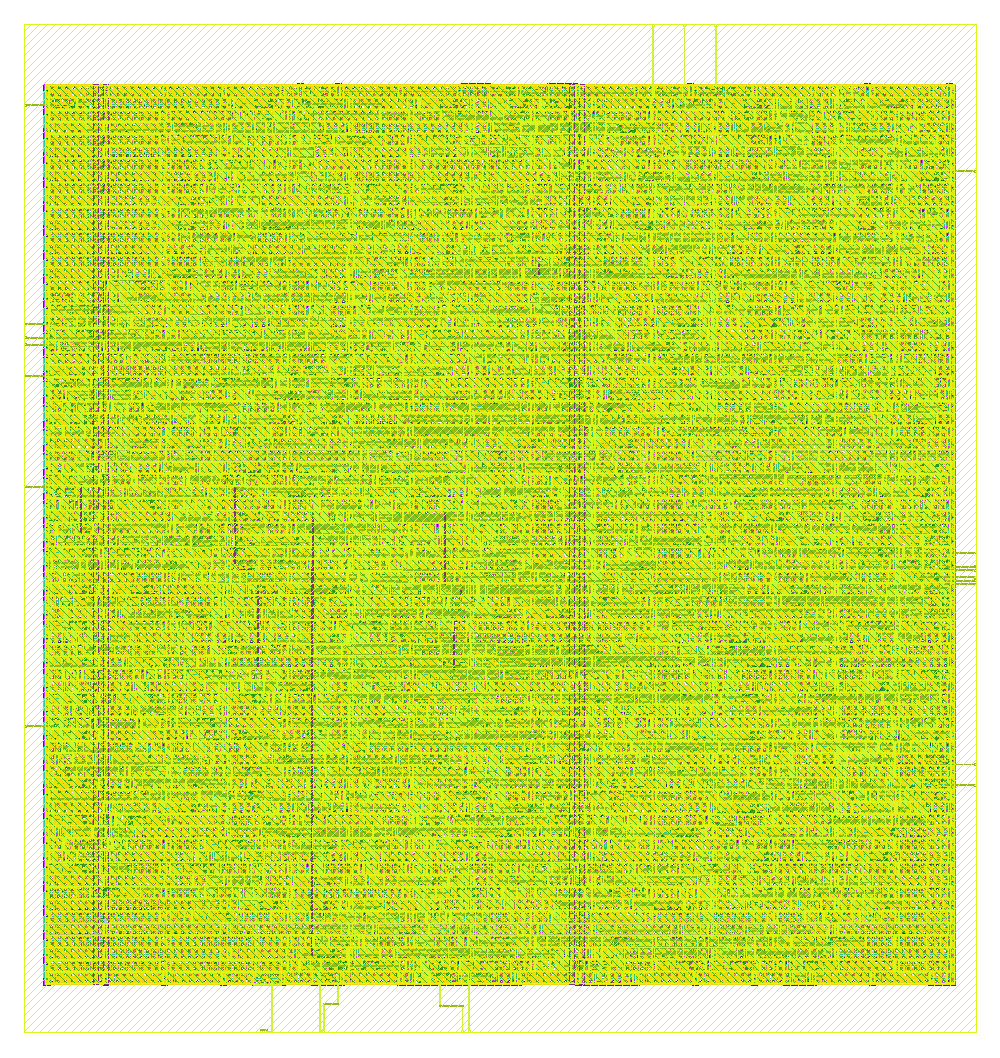
librelane/snn_top/results/snn_top.png
