Latios1928/engn2912e-project/analog/neuron/layout/DAC_lvs_ref.spice

* LVS reference for the DAC layout.
* Same devices and nets as the xschem netlist of analog/neuron/DAC.sch, with these
* layout-only changes:
*   - multiplier devices (m=2/3/4) written out as separate unit devices (M3_1, M3_2, ...)
*   - GND (a global in the schematic) and VDD (DNWELL tie, new) are ports
*   - dummy transistors: DA_* ring around the current-source array (all GND),
*     *_DL / *_DR at the ends of each switch row (all terminals on that well's body net)
.subckt DAC Isum Vb w[3] w[2] w[1] w[0] en VDD GND
* enable switch
XMen Isum en X GND nfet_03v3 L=0.28u W=0.22u nf=1
* branch A (x1): switch M1, source M2, node net4
XM1_1 X w[0] net4 net4 nfet_03v3 L=0.28u W=0.22u nf=1
XM2_1 net4 Vb GND GND nfet_03v3 L=8u W=1u nf=1
* branch B (x2): switch M3, source M4, node net2
XM3_1 X w[1] net2 net2 nfet_03v3 L=0.28u W=0.22u nf=1
XM3_2 X w[1] net2 net2 nfet_03v3 L=0.28u W=0.22u nf=1
XM4_1 net2 Vb GND GND nfet_03v3 L=8u W=1u nf=1
XM4_2 net2 Vb GND GND nfet_03v3 L=8u W=1u nf=1
* branch C (x3): switch M5, source M6, node net3
XM5_1 X w[2] net3 net3 nfet_03v3 L=0.28u W=0.22u nf=1
XM5_2 X w[2] net3 net3 nfet_03v3 L=0.28u W=0.22u nf=1
XM5_3 X w[2] net3 net3 nfet_03v3 L=0.28u W=0.22u nf=1
XM6_1 net3 Vb GND GND nfet_03v3 L=8u W=1u nf=1
XM6_2 net3 Vb GND GND nfet_03v3 L=8u W=1u nf=1
XM6_3 net3 Vb GND GND nfet_03v3 L=8u W=1u nf=1
* branch D (x4): switch M7, source M8, node net1
XM7_1 X w[3] net1 net1 nfet_03v3 L=0.28u W=0.22u nf=1
XM7_2 X w[3] net1 net1 nfet_03v3 L=0.28u W=0.22u nf=1
XM7_3 X w[3] net1 net1 nfet_03v3 L=0.28u W=0.22u nf=1
XM7_4 X w[3] net1 net1 nfet_03v3 L=0.28u W=0.22u nf=1
XM8_1 net1 Vb GND GND nfet_03v3 L=8u W=1u nf=1
XM8_2 net1 Vb GND GND nfet_03v3 L=8u W=1u nf=1
XM8_3 net1 Vb GND GND nfet_03v3 L=8u W=1u nf=1
XM8_4 net1 Vb GND GND nfet_03v3 L=8u W=1u nf=1
* dummies at the ends of the switch rows (all terminals on the well's body net)
XMEN_DL GND GND GND GND nfet_03v3 L=0.28u W=0.22u nf=1
XMEN_DR GND GND GND GND nfet_03v3 L=0.28u W=0.22u nf=1
XA_DL net4 net4 net4 net4 nfet_03v3 L=0.28u W=0.22u nf=1
XA_DR net4 net4 net4 net4 nfet_03v3 L=0.28u W=0.22u nf=1
XB_DL net2 net2 net2 net2 nfet_03v3 L=0.28u W=0.22u nf=1
XB_DR net2 net2 net2 net2 nfet_03v3 L=0.28u W=0.22u nf=1
XC_DL net3 net3 net3 net3 nfet_03v3 L=0.28u W=0.22u nf=1
XC_DR net3 net3 net3 net3 nfet_03v3 L=0.28u W=0.22u nf=1
XD_DL net1 net1 net1 net1 nfet_03v3 L=0.28u W=0.22u nf=1
XD_DR net1 net1 net1 net1 nfet_03v3 L=0.28u W=0.22u nf=1
* dummy ring around the current-source array (18 devices, all GND)
XDA_b0 GND GND GND GND nfet_03v3 L=8u W=1u nf=1
XDA_b1 GND GND GND GND nfet_03v3 L=8u W=1u nf=1
XDA_b2 GND GND GND GND nfet_03v3 L=8u W=1u nf=1
XDA_b3 GND GND GND GND nfet_03v3 L=8u W=1u nf=1
XDA_b4 GND GND GND GND nfet_03v3 L=8u W=1u nf=1
XDA_b5 GND GND GND GND nfet_03v3 L=8u W=1u nf=1
XDA_b6 GND GND GND GND nfet_03v3 L=8u W=1u nf=1
XDA_t0 GND GND GND GND nfet_03v3 L=8u W=1u nf=1
XDA_t1 GND GND GND GND nfet_03v3 L=8u W=1u nf=1
XDA_t2 GND GND GND GND nfet_03v3 L=8u W=1u nf=1
XDA_t3 GND GND GND GND nfet_03v3 L=8u W=1u nf=1
XDA_t4 GND GND GND GND nfet_03v3 L=8u W=1u nf=1
XDA_t5 GND GND GND GND nfet_03v3 L=8u W=1u nf=1
XDA_t6 GND GND GND GND nfet_03v3 L=8u W=1u nf=1
XDA_10 GND GND GND GND nfet_03v3 L=8u W=1u nf=1
XDA_16 GND GND GND GND nfet_03v3 L=8u W=1u nf=1
XDA_20 GND GND GND GND nfet_03v3 L=8u W=1u nf=1
XDA_26 GND GND GND GND nfet_03v3 L=8u W=1u nf=1
.ends
