Latios1928/engn2912e-project/analog/neuron/layout/PEX/SNN_pex.spice

* NGSPICE file created from SNN_flat.ext - technology: gf180mcuD

.subckt SNN_flat spike[0] spike[3] VDD VSS Iref w[0] w[1] w[2] w[3] w[4] w[5] w[6]
+ w[7] w[8] w[9] w[10] w[11] w[12] w[13] w[14] w[15] w[16] w[17] w[18] w[19] w[20]
+ w[21] w[22] w[23] w[24] w[25] w[26] w[27] w[28] w[29] w[30] w[31] pulse[0] pulse[1]
+ s[0] s[1] VT spike[2] spike[1] spike[4]
X0 bias_cell_0.VT_dpi bias_cell_0.VT_dpi VDD VDD pfet_03v3 ad=0.1074p pd=1.08u as=0.1074p ps=1.08u w=0.22u l=0.28u
X1 VSS VSS VSS VSS nfet_03v3 ad=0.2014p pd=1.98u as=0.72393n ps=4.91971m w=0.22u l=0.28u
X2 VSS VSS VSS VSS nfet_03v3 ad=0.2014p pd=1.98u as=0 ps=0 w=0.22u l=0.28u
X3 VSS VSS VSS VSS nfet_03v3 ad=0.61p pd=3.22u as=0 ps=0 w=1u l=8u
X4 VSS w[5] a_5364_23116# VSS nfet_03v3 ad=0.2014p pd=1.98u as=0.2014p ps=1.98u w=0.22u l=0.28u
X5 VSS VSS VSS VSS nfet_03v3 ad=0.2014p pd=1.98u as=0 ps=0 w=0.22u l=0.28u
X6 VSS w[25] a_3364_81516# VSS nfet_03v3 ad=0.2014p pd=1.98u as=0.2014p ps=1.98u w=0.22u l=0.28u
X7 VSS VSS VSS VSS nfet_03v3 ad=0.61p pd=3.22u as=0 ps=0 w=1u l=8u
X8 VSS w[23] a_5364_69692# VSS nfet_03v3 ad=0.2014p pd=1.98u as=0.2014p ps=1.98u w=0.22u l=0.28u
X9 VSS w[13] a_5364_46404# VSS nfet_03v3 ad=0.2014p pd=1.98u as=0.2014p ps=1.98u w=0.22u l=0.28u
X10 VSS VSS VSS VSS nfet_03v3 ad=0.61p pd=3.22u as=0 ps=0 w=1u l=8u
X11 VSS VSS VSS VSS nfet_03v3 ad=0.61p pd=3.22u as=0 ps=0 w=1u l=8u
X12 VSS VSS VSS VSS nfet_03v3 ad=0.61p pd=3.22u as=0 ps=0 w=1u l=8u
X13 VSS VSS VSS VSS nfet_03v3 ad=0.61p pd=3.22u as=0 ps=0 w=1u l=1u
X14 VSS bias_cell_0.Vb VSS VSS nfet_03v3 ad=0.61p pd=3.22u as=0 ps=0 w=1u l=8u
X15 VSS VSS VSS VSS nfet_03v3 ad=0.2014p pd=1.98u as=0 ps=0 w=0.22u l=0.28u
X16 bias_cell_0.Vthr bias_cell_0.Vthr VDD VDD pfet_03v3 ad=0.1074p pd=1.08u as=0.1074p ps=1.08u w=0.22u l=0.28u
X17 VSS w[31] a_3364_92980# VSS nfet_03v3 ad=0.2014p pd=1.98u as=0.2014p ps=1.98u w=0.22u l=0.28u
X18 VSS VSS VSS VSS nfet_03v3 ad=0.2014p pd=1.98u as=0 ps=0 w=0.22u l=0.28u
X19 VSS VSS VSS VSS nfet_03v3 ad=0.61p pd=3.22u as=0 ps=0 w=1u l=8u
X20 VSS bias_cell_0.Vb VSS VSS nfet_03v3 ad=0.61p pd=3.22u as=0 ps=0 w=1u l=8u
X21 VDD VDD VDD VDD pfet_03v3 ad=0.2166p pd=2.06u as=0.14012n ps=0.83427m w=0.22u l=0.28u
X22 VSS VSS VSS VSS nfet_03v3 ad=0.2014p pd=1.98u as=0 ps=0 w=0.22u l=0.28u
X23 VDD VDD VDD VDD pfet_03v3 ad=0.65p pd=3.3u as=0 ps=0 w=1u l=1u
X24 VSS VSS VSS VSS nfet_03v3 ad=0.2014p pd=1.98u as=0 ps=0 w=0.22u l=0.28u
X25 VSS VSS VSS VSS nfet_03v3 ad=0.2014p pd=1.98u as=0 ps=0 w=0.22u l=0.28u
X26 neuron_sized_1.VMEM spike[3] a_43986_51190# VSS nfet_03v3 ad=0.2014p pd=1.98u as=0.2014p ps=1.98u w=0.22u l=5u
X27 VSS VSS VSS VSS nfet_03v3 ad=0.2014p pd=1.98u as=0 ps=0 w=0.22u l=0.28u
X28 DAC_signed_1.DAC_binary_0.Isum a_23094_79840# DPI_0.Isum VSS nfet_03v3 ad=0.2014p pd=1.98u as=0.2014p ps=1.98u w=0.22u l=0.28u
X29 VDD VDD VDD VDD pfet_03v3 ad=0.65p pd=3.3u as=0 ps=0 w=1u l=1u
X30 VSS VSS VSS VSS nfet_03v3 ad=0.61p pd=3.22u as=0 ps=0 w=1u l=1u
X31 VSS VSS VSS VSS nfet_03v3 ad=0.2014p pd=1.98u as=0 ps=0 w=0.22u l=0.28u
X32 VSS VSS VSS VSS nfet_03v3 ad=0.2014p pd=1.98u as=0 ps=0 w=0.22u l=0.28u
X33 VSS VSS VSS VSS nfet_03v3 ad=0.61p pd=3.22u as=0 ps=0 w=1u l=8u
X34 VSS VSS VSS VSS nfet_03v3 ad=0.61p pd=3.22u as=0 ps=0 w=1u l=8u
X35 VDD bias_cell_0.VT_dpi bias_cell_0.VT_dpi VDD pfet_03v3 ad=0.1074p pd=1.08u as=0.1074p ps=1.08u w=0.22u l=0.28u
X36 VSS VSS VSS VSS nfet_03v3 ad=0.2014p pd=1.98u as=0 ps=0 w=0.22u l=0.28u
X37 VSS bias_cell_0.Vb VSS VSS nfet_03v3 ad=0.61p pd=3.22u as=0 ps=0 w=1u l=8u
X38 a_48826_16078# bias_cell_0.VKdn VSS VSS nfet_03v3 ad=0.61p pd=3.22u as=0.61p ps=3.22u w=1u l=1u
X39 bias_cell_0.Vlk a_2244_98592# VDD VDD pfet_03v3 ad=0.546p pd=2.98u as=0.546p ps=2.98u w=0.84u l=16u
X40 VDD bias_cell_0.Vthr bias_cell_0.Vthr VDD pfet_03v3 ad=0.1074p pd=1.08u as=0.1074p ps=1.08u w=0.22u l=0.28u
X41 VSS VSS VSS VSS nfet_03v3 ad=0.61p pd=3.22u as=0 ps=0 w=1u l=8u
X42 VSS VSS VSS VSS nfet_03v3 ad=0.2014p pd=1.98u as=0 ps=0 w=0.22u l=0.28u
X43 VSS bias_cell_0.Vb VSS VSS nfet_03v3 ad=0.61p pd=3.22u as=0 ps=0 w=1u l=8u
X44 spike[2] VSS cap_mim_2f0_m4m5_noshield c_width=10u c_length=10u
X45 a_46472_20418# a_50306_20496# spike[1] VDD pfet_03v3 ad=0.2166p pd=2.06u as=0.2166p ps=2.06u w=0.22u l=0.28u
X46 VSS VSS VSS VSS nfet_03v3 ad=0.2014p pd=1.98u as=0 ps=0 w=0.22u l=0.28u
X47 VDD a_2244_98592# bias_cell_0.VKdn VDD pfet_03v3 ad=2.10275p pd=7.77u as=1.13225p ps=3.935u w=3.235u l=8u
X48 VSS VSS VSS VSS nfet_03v3 ad=0.2014p pd=1.98u as=0 ps=0 w=0.22u l=0.28u
X49 VSS VSS VSS VSS nfet_03v3 ad=0.2014p pd=1.98u as=0 ps=0 w=0.22u l=0.28u
X50 VSS VSS VSS VSS nfet_03v3 ad=0.2014p pd=1.98u as=0 ps=0 w=0.22u l=0.28u
X51 a_45268_4332# neuron_sized_4.VMEM a_44260_8656# VSS nfet_03v3 ad=0.2014p pd=1.98u as=0.2014p ps=1.98u w=0.22u l=0.28u
X52 VDD VDD VDD VDD pfet_03v3 ad=0.2166p pd=2.06u as=0 ps=0 w=0.22u l=0.28u
X53 VSS w[23] a_5364_69692# VSS nfet_03v3 ad=0.2014p pd=1.98u as=0.2014p ps=1.98u w=0.22u l=0.28u
X54 VSS w[30] a_3364_92980# VSS nfet_03v3 ad=0.2014p pd=1.98u as=0.2014p ps=1.98u w=0.22u l=0.28u
X55 VSS VSS VSS VSS nfet_03v3 ad=0.2014p pd=1.98u as=0 ps=0 w=0.22u l=0.28u
X56 VSS bias_cell_0.Vb VSS VSS nfet_03v3 ad=0.61p pd=3.22u as=0 ps=0 w=1u l=8u
X57 VSS VSS VSS VSS nfet_03v3 ad=0.2014p pd=1.98u as=0 ps=0 w=0.22u l=0.28u
X58 VSS VSS VSS VSS nfet_03v3 ad=0.61p pd=3.22u as=0 ps=0 w=1u l=8u
X59 VSS VSS VSS VSS nfet_03v3 ad=0.2014p pd=1.98u as=0 ps=0 w=0.22u l=0.28u
X60 a_34406_27492# bias_cell_0.VT_dpi VDD VDD pfet_03v3 ad=0.2166p pd=2.06u as=0.2166p ps=2.06u w=0.22u l=0.28u
X61 VSS VSS VSS VSS nfet_03v3 ad=0.2014p pd=1.98u as=0 ps=0 w=0.22u l=0.28u
X62 VSS VSS VSS VSS nfet_03v3 ad=0.61p pd=3.22u as=0 ps=0 w=1u l=1u
X63 VSS VSS VSS VSS nfet_03v3 ad=0.2014p pd=1.98u as=0 ps=0 w=0.22u l=0.28u
X64 VSS VSS VSS VSS nfet_03v3 ad=0.2014p pd=1.98u as=0 ps=0 w=0.22u l=0.28u
X65 bias_cell_0.VT_dpi bias_cell_0.VT_dpi VDD VDD pfet_03v3 ad=0.1074p pd=1.08u as=0.1074p ps=1.08u w=0.22u l=0.28u
X66 VDD bias_cell_0.VT_inh bias_cell_0.VT_inh VDD pfet_03v3 ad=0.308p pd=1.58u as=0.308p ps=1.58u w=0.88u l=1.12u
X67 VSS VSS VSS VSS nfet_03v3 ad=0.2014p pd=1.98u as=0 ps=0 w=0.22u l=0.28u
X68 VSS VSS VSS VSS nfet_03v3 ad=0.2014p pd=1.98u as=0 ps=0 w=0.22u l=0.28u
X69 VSS bias_cell_0.Vb VSS VSS nfet_03v3 ad=0.61p pd=3.22u as=0 ps=0 w=1u l=8u
X70 VSS VSS VSS VSS nfet_03v3 ad=0.2014p pd=1.98u as=0 ps=0 w=0.22u l=0.28u
X71 VSS VSS VSS VSS nfet_03v3 ad=0.61p pd=3.22u as=0 ps=0 w=1u l=1u
X72 VSS VSS VSS VSS nfet_03v3 ad=0.2014p pd=1.98u as=0 ps=0 w=0.22u l=0.28u
X73 VSS bias_cell_0.Vb VSS VSS nfet_03v3 ad=0.61p pd=3.22u as=0 ps=0 w=1u l=8u
X74 VSS VSS VSS VSS nfet_03v3 ad=0.2014p pd=1.98u as=0 ps=0 w=0.22u l=0.28u
X75 bias_cell_0.VK a_2244_98592# VDD VDD pfet_03v3 ad=0.7315p pd=2.79u as=1.3585p ps=5.48u w=2.09u l=8u
X76 bias_cell_0.VT_dpi bias_cell_0.VT_dpi VDD VDD pfet_03v3 ad=0.1074p pd=1.08u as=0.1074p ps=1.08u w=0.22u l=0.28u
X77 VSS VSS VSS VSS nfet_03v3 ad=0.2014p pd=1.98u as=0 ps=0 w=0.22u l=0.28u
X78 VSS VSS VSS VSS nfet_03v3 ad=0.2014p pd=1.98u as=0 ps=0 w=0.22u l=0.28u
X79 VSS w[3] a_5364_11292# VSS nfet_03v3 ad=0.2014p pd=1.98u as=0.2014p ps=1.98u w=0.22u l=0.28u
X80 VSS VSS VSS VSS nfet_03v3 ad=0.2014p pd=1.98u as=0 ps=0 w=0.22u l=0.28u
X81 VSS VSS VSS VSS nfet_03v3 ad=0.2014p pd=1.98u as=0 ps=0 w=0.22u l=0.28u
X82 a_50306_55608# a_45030_55608# a_48106_51190# VSS nfet_03v3 ad=0.2014p pd=1.98u as=0.2014p ps=1.98u w=0.22u l=0.28u
X83 VSS VSS VSS VSS nfet_03v3 ad=0.2014p pd=1.98u as=0 ps=0 w=0.22u l=0.28u
X84 VDD VDD VDD VDD pfet_03v3 ad=0.2166p pd=2.06u as=0 ps=0 w=0.22u l=0.28u
X85 VDD VDD VDD VDD pfet_03v3 ad=0.65p pd=3.3u as=0 ps=0 w=1u l=1u
X86 VSS w[7] a_5364_23116# VSS nfet_03v3 ad=0.2014p pd=1.98u as=0.2014p ps=1.98u w=0.22u l=0.28u
X87 Iref Iref VSS VSS nfet_03v3 ad=1.75p pd=5.7u as=3.05p ps=11.22u w=5u l=8u
X88 VSS VSS VSS VSS nfet_03v3 ad=0.61p pd=3.22u as=0 ps=0 w=1u l=8u
X89 VSS VSS VSS VSS nfet_03v3 ad=0.61p pd=3.22u as=0 ps=0 w=1u l=8u
X90 VSS VSS VSS VSS nfet_03v3 ad=0.61p pd=3.22u as=0 ps=0 w=1u l=8u
X91 VSS VSS VSS VSS nfet_03v3 ad=0.61p pd=3.22u as=0 ps=0 w=1u l=8u
X92 VSS VSS VSS VSS nfet_03v3 ad=0.61p pd=3.22u as=0 ps=0 w=1u l=1u
X93 VDD bias_cell_0.VT_dpi bias_cell_0.VT_dpi VDD pfet_03v3 ad=0.1074p pd=1.08u as=0.1074p ps=1.08u w=0.22u l=0.28u
X94 VSS VSS VSS VSS nfet_03v3 ad=0.2014p pd=1.98u as=0 ps=0 w=0.22u l=0.28u
X95 VSS w[11] a_5364_34940# VSS nfet_03v3 ad=0.2014p pd=1.98u as=0.2014p ps=1.98u w=0.22u l=0.28u
X96 VSS VSS VSS VSS nfet_03v3 ad=0.61p pd=3.22u as=0 ps=0 w=1u l=8u
X97 VDD VDD VDD VDD pfet_03v3 ad=0.2166p pd=2.06u as=0 ps=0 w=0.22u l=0.28u
X98 VDD VDD VDD VDD pfet_03v3 ad=0.65p pd=3.3u as=0 ps=0 w=1u l=1u
X99 VSS w[5] a_5364_23116# VSS nfet_03v3 ad=0.2014p pd=1.98u as=0.2014p ps=1.98u w=0.22u l=0.28u
X100 bias_cell_0.VKdn bias_cell_0.VKdn VSS VSS nfet_03v3 ad=0.35p pd=1.7u as=0.61p ps=3.22u w=1u l=1u
X101 VSS VSS VSS VSS nfet_03v3 ad=0.61p pd=3.22u as=0 ps=0 w=1u l=8u
X102 VSS w[19] a_5364_58228# VSS nfet_03v3 ad=0.2014p pd=1.98u as=0.2014p ps=1.98u w=0.22u l=0.28u
X103 VSS bias_cell_0.Vb VSS VSS nfet_03v3 ad=0.61p pd=3.22u as=0 ps=0 w=1u l=8u
X104 a_34406_50780# VDD cap_mim_2f0_m4m5_noshield c_width=22.36u c_length=22.36u
X105 VSS VSS VSS VSS nfet_03v3 ad=0.61p pd=3.22u as=0 ps=0 w=1u l=8u
X106 VSS VSS VSS VSS nfet_03v3 ad=0.61p pd=3.22u as=0 ps=0 w=1u l=8u
X107 VSS VSS VSS VSS nfet_03v3 ad=0.2014p pd=1.98u as=0 ps=0 w=0.22u l=0.28u
X108 VDD VDD VDD VDD pfet_03v3 ad=0.65p pd=3.3u as=0 ps=0 w=1u l=1u
X109 VDD bias_cell_0.VT_dpi bias_cell_0.VT_dpi VDD pfet_03v3 ad=0.1074p pd=1.08u as=0.1074p ps=1.08u w=0.22u l=0.28u
X110 VSS VSS VSS VSS nfet_03v3 ad=0.61p pd=3.22u as=0 ps=0 w=1u l=8u
X111 VSS VSS VSS VSS nfet_03v3 ad=0.61p pd=3.22u as=0 ps=0 w=1u l=8u
X112 VDD VDD VDD VDD pfet_03v3 ad=0.65p pd=3.3u as=0 ps=0 w=1u l=1u
X113 VSS VSS VSS VSS nfet_03v3 ad=0.61p pd=3.22u as=0 ps=0 w=1u l=1u
X114 neuron_sized_3.VMEM spike[1] a_43986_16078# VSS nfet_03v3 ad=0.2014p pd=1.98u as=0.2014p ps=1.98u w=0.22u l=5u
X115 VSS VSS VSS VSS nfet_03v3 ad=0.2014p pd=1.98u as=0 ps=0 w=0.22u l=0.28u
X116 VSS w[22] a_5364_69692# VSS nfet_03v3 ad=0.2014p pd=1.98u as=0.2014p ps=1.98u w=0.22u l=0.28u
X117 VDD VDD VDD VDD pfet_03v3 ad=0.65p pd=3.3u as=0 ps=0 w=1u l=1u
X118 VSS VSS VSS VSS nfet_03v3 ad=0.2014p pd=1.98u as=0 ps=0 w=0.22u l=0.28u
X119 VSS VSS VSS VSS nfet_03v3 ad=0.2014p pd=1.98u as=0 ps=0 w=0.22u l=0.28u
X120 VDD VDD VDD VDD pfet_03v3 ad=0.2166p pd=2.06u as=0 ps=0 w=0.22u l=0.28u
X121 VSS VSS VSS VSS nfet_03v3 ad=0.2014p pd=1.98u as=0 ps=0 w=0.22u l=0.28u
X122 VSS VSS VSS VSS nfet_03v3 ad=0.2014p pd=1.98u as=0 ps=0 w=0.22u l=0.28u
X123 a_45030_78896# VT a_45268_74556# VSS nfet_03v3 ad=0.2014p pd=1.98u as=0.2014p ps=1.98u w=0.22u l=0.28u
X124 VSS VSS VSS VSS nfet_03v3 ad=0.2014p pd=1.98u as=0 ps=0 w=0.22u l=0.28u
X125 a_43986_27902# bias_cell_0.VK VSS VSS nfet_03v3 ad=0.61p pd=3.22u as=0.61p ps=3.22u w=1u l=1u
X126 VSS VSS VSS VSS nfet_03v3 ad=0.61p pd=3.22u as=0 ps=0 w=1u l=8u
X127 VSS VSS VSS VSS nfet_03v3 ad=0.61p pd=3.22u as=0 ps=0 w=1u l=8u
X128 VSS VSS VSS VSS nfet_03v3 ad=0.2014p pd=1.98u as=0 ps=0 w=0.22u l=0.28u
X129 VSS VSS VSS VSS nfet_03v3 ad=0.2014p pd=1.98u as=0 ps=0 w=0.22u l=0.28u
X130 VSS w[3] a_5364_11292# VSS nfet_03v3 ad=0.2014p pd=1.98u as=0.2014p ps=1.98u w=0.22u l=0.28u
X131 VSS VSS VSS VSS nfet_03v3 ad=0.2014p pd=1.98u as=0 ps=0 w=0.22u l=0.28u
X132 VSS VSS VSS VSS nfet_03v3 ad=0.2014p pd=1.98u as=0 ps=0 w=0.22u l=0.28u
X133 VSS VSS VSS VSS nfet_03v3 ad=0.2014p pd=1.98u as=0 ps=0 w=0.22u l=0.28u
X134 VSS VSS VSS VSS nfet_03v3 ad=0.2014p pd=1.98u as=0 ps=0 w=0.22u l=0.28u
X135 VSS VSS VSS VSS nfet_03v3 ad=0.61p pd=3.22u as=0 ps=0 w=1u l=8u
X136 bias_cell_0.VT_dpi bias_cell_0.VT_dpi VDD VDD pfet_03v3 ad=0.1074p pd=1.08u as=0.1074p ps=1.08u w=0.22u l=0.28u
X137 VSS VSS VSS VSS nfet_03v3 ad=0.61p pd=3.22u as=0 ps=0 w=1u l=1u
X138 VSS w[10] a_5364_34940# VSS nfet_03v3 ad=0.2014p pd=1.98u as=0.2014p ps=1.98u w=0.22u l=0.28u
X139 DPI_inh_0.Isum s[0] DAC_signed_1.DAC_binary_0.Isum VSS nfet_03v3 ad=0.2014p pd=1.98u as=0.2014p ps=1.98u w=0.22u l=0.28u
X140 VSS w[18] a_5364_58228# VSS nfet_03v3 ad=0.2014p pd=1.98u as=0.2014p ps=1.98u w=0.22u l=0.28u
X141 VDD VDD VDD VDD pfet_03v3 ad=0.2166p pd=2.06u as=0 ps=0 w=0.22u l=0.28u
X142 bias_cell_0.Vamp_bias bias_cell_0.Vamp_bias VSS VSS nfet_03v3 ad=0.2014p pd=1.98u as=0.2014p ps=1.98u w=0.22u l=0.28u
X143 VSS VSS VSS VSS nfet_03v3 ad=0.2014p pd=1.98u as=0 ps=0 w=0.22u l=0.28u
X144 VSS VSS VSS VSS nfet_03v3 ad=0.2014p pd=1.98u as=0 ps=0 w=0.22u l=0.28u
X145 VSS VSS VSS VSS nfet_03v3 ad=0.2014p pd=1.98u as=0 ps=0 w=0.22u l=0.28u
X146 VSS VSS VSS VSS nfet_03v3 ad=0.61p pd=3.22u as=0 ps=0 w=1u l=8u
X147 VSS bias_cell_0.Vb VSS VSS nfet_03v3 ad=0.61p pd=3.22u as=0 ps=0 w=1u l=8u
X148 bias_cell_0.Vthr bias_cell_0.Vthr VDD VDD pfet_03v3 ad=0.1074p pd=1.08u as=0.1074p ps=1.08u w=0.22u l=0.28u
X149 VSS VSS VSS VSS nfet_03v3 ad=0.2014p pd=1.98u as=0 ps=0 w=0.22u l=0.28u
X150 neuron_sized_4.VMEM a_50306_8672# a_43278_8594# VDD pfet_03v3 ad=0.2166p pd=2.06u as=0.2166p ps=2.06u w=0.22u l=0.28u
X151 VSS VSS VSS VSS nfet_03v3 ad=0.61p pd=3.22u as=0 ps=0 w=1u l=1u
X152 VSS VSS VSS VSS nfet_03v3 ad=0.2014p pd=1.98u as=0 ps=0 w=0.22u l=0.28u
X153 VSS VSS VSS VSS nfet_03v3 ad=0.61p pd=3.22u as=0 ps=0 w=1u l=8u
X154 VSS VSS VSS VSS nfet_03v3 ad=0.2014p pd=1.98u as=0 ps=0 w=0.22u l=0.28u
X155 VSS VSS VSS VSS nfet_03v3 ad=0.2014p pd=1.98u as=0 ps=0 w=0.22u l=0.28u
X156 VSS VSS VSS VSS nfet_03v3 ad=0.61p pd=3.22u as=0 ps=0 w=1u l=8u
X157 VSS VSS VSS VSS nfet_03v3 ad=0.2014p pd=1.98u as=0 ps=0 w=0.22u l=0.28u
X158 VSS VSS VSS VSS nfet_03v3 ad=0.2014p pd=1.98u as=0 ps=0 w=0.22u l=0.28u
X159 VSS VSS VSS VSS nfet_03v3 ad=0.61p pd=3.22u as=0 ps=0 w=1u l=8u
X160 VSS VSS VSS VSS nfet_03v3 ad=0.2014p pd=1.98u as=0 ps=0 w=0.22u l=0.28u
X161 a_50306_20496# a_45030_20496# a_48106_16078# VSS nfet_03v3 ad=0.2014p pd=1.98u as=0.2014p ps=1.98u w=0.22u l=0.28u
X162 VSS VSS VSS VSS nfet_03v3 ad=0.2014p pd=1.98u as=0 ps=0 w=0.22u l=0.28u
X163 VSS VSS VSS VSS nfet_03v3 ad=0.2014p pd=1.98u as=0 ps=0 w=0.22u l=0.28u
X164 VDD bias_cell_0.VT_dpi bias_cell_0.VT_dpi VDD pfet_03v3 ad=0.1074p pd=1.08u as=0.1074p ps=1.08u w=0.22u l=0.28u
X165 VDD VDD VDD VDD pfet_03v3 ad=0.65p pd=3.3u as=0 ps=0 w=1u l=1u
X166 VSS VSS VSS VSS nfet_03v3 ad=0.61p pd=3.22u as=0 ps=0 w=1u l=8u
X167 VSS VSS VSS VSS nfet_03v3 ad=0.61p pd=3.22u as=0 ps=0 w=1u l=8u
X168 VDD bias_cell_0.Vthr bias_cell_0.Vthr VDD pfet_03v3 ad=0.1074p pd=1.08u as=0.1074p ps=1.08u w=0.22u l=0.28u
X169 VSS VSS VSS VSS nfet_03v3 ad=0.2014p pd=1.98u as=0 ps=0 w=0.22u l=0.28u
X170 VSS bias_cell_0.Vb VSS VSS nfet_03v3 ad=0.61p pd=3.22u as=0 ps=0 w=1u l=8u
X171 VDD VDD VDD VDD pfet_03v3 ad=0.65p pd=3.3u as=0 ps=0 w=1u l=1u
X172 VSS VSS VSS VSS nfet_03v3 ad=0.61p pd=3.22u as=0 ps=0 w=1u l=8u
X173 VSS VSS VSS VSS nfet_03v3 ad=0.2014p pd=1.98u as=0 ps=0 w=0.22u l=0.28u
X174 VSS w[2] a_5364_11292# VSS nfet_03v3 ad=0.2014p pd=1.98u as=0.2014p ps=1.98u w=0.22u l=0.28u
X175 VSS bias_cell_0.Vb VSS VSS nfet_03v3 ad=0.61p pd=3.22u as=0 ps=0 w=1u l=8u
X176 VSS VSS VSS VSS nfet_03v3 ad=0.61p pd=3.22u as=0 ps=0 w=1u l=8u
X177 VSS bias_cell_0.Vb VSS VSS nfet_03v3 ad=0.61p pd=3.22u as=0 ps=0 w=1u l=8u
X178 a_50306_78896# a_45030_78896# VDD VDD pfet_03v3 ad=0.2166p pd=2.06u as=0.2166p ps=2.06u w=0.22u l=0.28u
X179 VSS w[30] a_3364_92980# VSS nfet_03v3 ad=0.2014p pd=1.98u as=0.2014p ps=1.98u w=0.22u l=0.28u
X180 neuron_sized_2.VMEM VSS cap_mim_2f0_m4m5_noshield c_width=22.18u c_length=22.18u
X181 VDD VDD VDD VDD pfet_03v3 ad=0.2166p pd=2.06u as=0 ps=0 w=0.22u l=0.28u
X182 bias_cell_0.VT_dpi bias_cell_0.VT_dpi VDD VDD pfet_03v3 ad=0.1074p pd=1.08u as=0.1074p ps=1.08u w=0.22u l=0.28u
X183 VSS VSS VSS VSS nfet_03v3 ad=0.2014p pd=1.98u as=0 ps=0 w=0.22u l=0.28u
X184 a_45030_55608# VT a_45268_51268# VSS nfet_03v3 ad=0.2014p pd=1.98u as=0.2014p ps=1.98u w=0.22u l=0.28u
X185 VSS VSS VSS VSS nfet_03v3 ad=0.2014p pd=1.98u as=0 ps=0 w=0.22u l=0.28u
X186 VSS VSS VSS VSS nfet_03v3 ad=0.2014p pd=1.98u as=0 ps=0 w=0.22u l=0.28u
X187 VSS VSS VSS VSS nfet_03v3 ad=0.61p pd=3.22u as=0 ps=0 w=1u l=1u
X188 VSS VSS VSS VSS nfet_03v3 ad=0.2014p pd=1.98u as=0 ps=0 w=0.22u l=0.28u
X189 VSS VSS VSS VSS nfet_03v3 ad=0.2014p pd=1.98u as=0 ps=0 w=0.22u l=0.28u
X190 VSS VSS VSS VSS nfet_03v3 ad=0.2014p pd=1.98u as=0 ps=0 w=0.22u l=0.28u
X191 a_45030_20496# a_44260_20480# VDD VDD pfet_03v3 ad=0.2166p pd=2.06u as=0.2166p ps=2.06u w=0.22u l=0.28u
X192 VSS bias_cell_0.Vb VSS VSS nfet_03v3 ad=0.61p pd=3.22u as=0 ps=0 w=1u l=8u
X193 VSS VSS VSS VSS nfet_03v3 ad=0.2014p pd=1.98u as=0 ps=0 w=0.22u l=0.28u
X194 VDD bias_cell_0.VT_dpi bias_cell_0.VT_dpi VDD pfet_03v3 ad=0.1074p pd=1.08u as=0.1074p ps=1.08u w=0.22u l=0.28u
X195 VSS VSS VSS VSS nfet_03v3 ad=0.2014p pd=1.98u as=0 ps=0 w=0.22u l=0.28u
X196 VSS VSS VSS VSS nfet_03v3 ad=0.2014p pd=1.98u as=0 ps=0 w=0.22u l=0.28u
X197 VSS VSS VSS VSS nfet_03v3 ad=0.2014p pd=1.98u as=0 ps=0 w=0.22u l=0.28u
X198 VSS VSS VSS VSS nfet_03v3 ad=0.61p pd=3.22u as=0 ps=0 w=1u l=8u
X199 bias_cell_0.VT_inh bias_cell_0.VT_inh VDD VDD pfet_03v3 ad=0.308p pd=1.58u as=0.308p ps=1.58u w=0.88u l=1.12u
X200 VSS VSS VSS VSS nfet_03v3 ad=0.2014p pd=1.98u as=0 ps=0 w=0.22u l=0.28u
X201 VSS VSS VSS VSS nfet_03v3 ad=0.61p pd=3.22u as=0 ps=0 w=1u l=1u
X202 VSS VSS VSS VSS nfet_03v3 ad=0.2014p pd=1.98u as=0 ps=0 w=0.22u l=0.28u
X203 a_3364_92980# spike[3] DAC_signed_0.DAC_binary_0.Isum VSS nfet_03v3 ad=0.2014p pd=1.98u as=0.2014p ps=1.98u w=0.22u l=0.28u
X204 VSS VSS VSS VSS nfet_03v3 ad=0.2014p pd=1.98u as=0 ps=0 w=0.22u l=0.28u
X205 VDD bias_cell_0.Vthr DPI_2.Isum DPI_2.Isum nfet_03v3 ad=0.2014p pd=1.98u as=0.2014p ps=1.98u w=0.22u l=0.28u
X206 VSS VSS VSS VSS nfet_03v3 ad=0.2014p pd=1.98u as=0 ps=0 w=0.22u l=0.28u
X207 VSS VSS VSS VSS nfet_03v3 ad=0.2014p pd=1.98u as=0 ps=0 w=0.22u l=0.28u
X208 VSS VSS VSS VSS nfet_03v3 ad=0.2014p pd=1.98u as=0 ps=0 w=0.22u l=0.28u
X209 VSS VSS VSS VSS nfet_03v3 ad=0.2014p pd=1.98u as=0 ps=0 w=0.22u l=0.28u
X210 VSS VSS VSS VSS nfet_03v3 ad=0.2014p pd=1.98u as=0 ps=0 w=0.22u l=0.28u
X211 VSS VSS VSS VSS nfet_03v3 ad=0.2014p pd=1.98u as=0 ps=0 w=0.22u l=0.28u
X212 VSS VSS VSS VSS nfet_03v3 ad=0.2014p pd=1.98u as=0 ps=0 w=0.22u l=0.28u
X213 VSS VSS VSS VSS nfet_03v3 ad=0.2014p pd=1.98u as=0 ps=0 w=0.22u l=0.28u
X214 VDD VDD VDD VDD pfet_03v3 ad=0.65p pd=3.3u as=0 ps=0 w=1u l=1u
X215 VSS w[24] a_3364_81516# VSS nfet_03v3 ad=0.2014p pd=1.98u as=0.2014p ps=1.98u w=0.22u l=0.28u
X216 VSS w[12] a_5364_46404# VSS nfet_03v3 ad=0.2014p pd=1.98u as=0.2014p ps=1.98u w=0.22u l=0.28u
X217 VDD VDD VDD VDD pfet_03v3 ad=0.65p pd=3.3u as=0 ps=0 w=1u l=1u
X218 VSS w[3] a_5364_11292# VSS nfet_03v3 ad=0.2014p pd=1.98u as=0.2014p ps=1.98u w=0.22u l=0.28u
X219 VSS VSS VSS VSS nfet_03v3 ad=0.2014p pd=1.98u as=0 ps=0 w=0.22u l=0.28u
X220 VDD VDD VDD VDD pfet_03v3 ad=0.65p pd=3.3u as=0 ps=0 w=1u l=1u
X221 VSS VSS VSS VSS nfet_03v3 ad=0.2014p pd=1.98u as=0 ps=0 w=0.22u l=0.28u
X222 VSS VSS VSS VSS nfet_03v3 ad=0.61p pd=3.22u as=0 ps=0 w=1u l=8u
X223 VSS VSS VSS VSS nfet_03v3 ad=0.61p pd=3.22u as=0 ps=0 w=1u l=8u
X224 VSS bias_cell_0.Vb VSS VSS nfet_03v3 ad=0.61p pd=3.22u as=0 ps=0 w=1u l=8u
X225 VSS VSS VSS VSS nfet_03v3 ad=0.61p pd=3.22u as=0 ps=0 w=1u l=8u
X226 VSS w[10] a_5364_34940# VSS nfet_03v3 ad=0.2014p pd=1.98u as=0.2014p ps=1.98u w=0.22u l=0.28u
X227 VSS VSS VSS VSS nfet_03v3 ad=0.61p pd=3.22u as=0 ps=0 w=1u l=1u
X228 VSS VSS VSS VSS nfet_03v3 ad=0.2014p pd=1.98u as=0 ps=0 w=0.22u l=0.28u
X229 VSS VSS VSS VSS nfet_03v3 ad=0.2014p pd=1.98u as=0 ps=0 w=0.22u l=0.28u
X230 VSS w[18] a_5364_58228# VSS nfet_03v3 ad=0.2014p pd=1.98u as=0.2014p ps=1.98u w=0.22u l=0.28u
X231 VDD VDD VDD VDD pfet_03v3 ad=0.65p pd=3.3u as=0 ps=0 w=1u l=1u
X232 VSS VSS VSS VSS nfet_03v3 ad=0.2014p pd=1.98u as=0 ps=0 w=0.22u l=0.28u
X233 VSS VSS VSS VSS nfet_03v3 ad=0.61p pd=3.22u as=0 ps=0 w=1u l=1u
X234 VDD VDD VDD VDD pfet_03v3 ad=0.65p pd=3.3u as=0 ps=0 w=1u l=1u
X235 VSS VSS VSS VSS nfet_03v3 ad=0.2014p pd=1.98u as=0 ps=0 w=0.22u l=0.28u
X236 bias_cell_0.VK a_2244_98592# VDD VDD pfet_03v3 ad=0.7315p pd=2.79u as=0.7315p ps=2.79u w=2.09u l=8u
X237 VSS VSS VSS VSS nfet_03v3 ad=0.61p pd=3.22u as=0 ps=0 w=1u l=8u
X238 VSS VSS VSS VSS nfet_03v3 ad=0.2014p pd=1.98u as=0 ps=0 w=0.22u l=0.28u
X239 VSS VSS VSS VSS nfet_03v3 ad=0.2014p pd=1.98u as=0 ps=0 w=0.22u l=0.28u
X240 VDD a_2244_98592# bias_cell_0.VK VDD pfet_03v3 ad=0.7315p pd=2.79u as=0.7315p ps=2.79u w=2.09u l=8u
X241 VSS bias_cell_0.Vb VSS VSS nfet_03v3 ad=0.61p pd=3.22u as=0 ps=0 w=1u l=8u
X242 a_45030_20496# VT a_45268_16156# VSS nfet_03v3 ad=0.2014p pd=1.98u as=0.2014p ps=1.98u w=0.22u l=0.28u
X243 VSS VSS VSS VSS nfet_03v3 ad=0.61p pd=3.22u as=0 ps=0 w=1u l=8u
X244 VSS VSS VSS VSS nfet_03v3 ad=0.2014p pd=1.98u as=0 ps=0 w=0.22u l=0.28u
X245 VSS VSS VSS VSS nfet_03v3 ad=0.2014p pd=1.98u as=0 ps=0 w=0.22u l=0.28u
X246 a_46472_55530# bias_cell_0.VKup VDD VDD pfet_03v3 ad=0.65p pd=3.3u as=0.65p ps=3.3u w=1u l=1u
X247 VDD VDD VDD VDD pfet_03v3 ad=0.2166p pd=2.06u as=0 ps=0 w=0.22u l=0.28u
X248 bias_cell_0.Vamp_bias a_2244_98592# VDD VDD pfet_03v3 ad=1.5995p pd=5.27u as=2.9705p ps=10.44u w=4.57u l=8u
X249 VSS VSS VSS VSS nfet_03v3 ad=0.2014p pd=1.98u as=0 ps=0 w=0.22u l=0.28u
X250 VSS VSS VSS VSS nfet_03v3 ad=0.61p pd=3.22u as=0 ps=0 w=1u l=1u
X251 VSS VSS VSS VSS nfet_03v3 ad=0.2014p pd=1.98u as=0 ps=0 w=0.22u l=0.28u
X252 VSS VSS VSS VSS nfet_03v3 ad=0.2014p pd=1.98u as=0 ps=0 w=0.22u l=0.28u
X253 VSS VSS VSS VSS nfet_03v3 ad=0.2014p pd=1.98u as=0 ps=0 w=0.22u l=0.28u
X254 a_48106_74478# bias_cell_0.VIp VSS VSS nfet_03v3 ad=0.61p pd=3.22u as=0.61p ps=3.22u w=1u l=1u
X255 bias_cell_0.VT_dpi bias_cell_0.VT_dpi VDD VDD pfet_03v3 ad=0.1074p pd=1.08u as=0.1074p ps=1.08u w=0.22u l=0.28u
X256 VSS bias_cell_0.Vb VSS VSS nfet_03v3 ad=0.61p pd=3.22u as=0 ps=0 w=1u l=8u
X257 VSS VSS VSS VSS nfet_03v3 ad=0.2014p pd=1.98u as=0 ps=0 w=0.22u l=0.28u
X258 VSS bias_cell_0.Vb VSS VSS nfet_03v3 ad=0.61p pd=3.22u as=0 ps=0 w=1u l=8u
X259 VSS VSS VSS VSS nfet_03v3 ad=0.2014p pd=1.98u as=0 ps=0 w=0.22u l=0.28u
X260 VSS VSS VSS VSS nfet_03v3 ad=0.2014p pd=1.98u as=0 ps=0 w=0.22u l=0.28u
X261 VSS VSS VSS VSS nfet_03v3 ad=0.2014p pd=1.98u as=0 ps=0 w=0.22u l=0.28u
X262 a_5364_34940# spike[0] DPI_2.Isum VSS nfet_03v3 ad=0.2014p pd=1.98u as=0.2014p ps=1.98u w=0.22u l=0.28u
X263 a_5364_58228# spike[0] DPI_1.Isum VSS nfet_03v3 ad=0.2014p pd=1.98u as=0.2014p ps=1.98u w=0.22u l=0.28u
X264 VSS VSS VSS VSS nfet_03v3 ad=0.2014p pd=1.98u as=0 ps=0 w=0.22u l=0.28u
X265 VSS bias_cell_0.Vb VSS VSS nfet_03v3 ad=0.61p pd=3.22u as=0 ps=0 w=1u l=8u
X266 VSS VSS VSS VSS nfet_03v3 ad=0.2014p pd=1.98u as=0 ps=0 w=0.22u l=0.28u
X267 VSS bias_cell_0.Vb VSS VSS nfet_03v3 ad=0.61p pd=3.22u as=0 ps=0 w=1u l=8u
X268 VSS VSS VSS VSS nfet_03v3 ad=0.2014p pd=1.98u as=0 ps=0 w=0.22u l=0.28u
X269 VSS VSS VSS VSS nfet_03v3 ad=0.2014p pd=1.98u as=0 ps=0 w=0.22u l=0.28u
X270 VSS bias_cell_0.Vb VSS VSS nfet_03v3 ad=0.61p pd=3.22u as=0 ps=0 w=1u l=8u
X271 VSS VSS VSS VSS nfet_03v3 ad=0.2014p pd=1.98u as=0 ps=0 w=0.22u l=0.28u
X272 VSS bias_cell_0.Vb VSS VSS nfet_03v3 ad=0.61p pd=3.22u as=0 ps=0 w=1u l=8u
X273 neuron_sized_2.VMEM bias_cell_0.Vlk VSS VSS nfet_03v3 ad=0.61p pd=3.22u as=0.61p ps=3.22u w=1u l=1u
X274 VSS w[31] a_3364_92980# VSS nfet_03v3 ad=0.2014p pd=1.98u as=0.2014p ps=1.98u w=0.22u l=0.28u
X275 VSS VSS VSS VSS nfet_03v3 ad=0.2014p pd=1.98u as=0 ps=0 w=0.22u l=0.28u
X276 VSS VSS VSS VSS nfet_03v3 ad=0.2014p pd=1.98u as=0 ps=0 w=0.22u l=0.28u
X277 VSS bias_cell_0.Vb VSS VSS nfet_03v3 ad=0.61p pd=3.22u as=0 ps=0 w=1u l=8u
X278 VSS w[4] a_5364_23116# VSS nfet_03v3 ad=0.2014p pd=1.98u as=0.2014p ps=1.98u w=0.22u l=0.28u
X279 VSS VSS VSS VSS nfet_03v3 ad=0.61p pd=3.22u as=0 ps=0 w=1u l=8u
X280 VSS bias_cell_0.Vb VSS VSS nfet_03v3 ad=0.61p pd=3.22u as=0 ps=0 w=1u l=8u
X281 VSS VSS VSS VSS nfet_03v3 ad=0.2014p pd=1.98u as=0 ps=0 w=0.22u l=0.28u
X282 VSS VSS VSS VSS nfet_03v3 ad=0.61p pd=3.22u as=0 ps=0 w=1u l=8u
X283 VSS VSS VSS VSS nfet_03v3 ad=0.61p pd=3.22u as=0 ps=0 w=1u l=8u
X284 VSS VSS VSS VSS nfet_03v3 ad=0.2014p pd=1.98u as=0 ps=0 w=0.22u l=0.28u
X285 VSS VSS VSS VSS nfet_03v3 ad=0.2014p pd=1.98u as=0 ps=0 w=0.22u l=0.28u
X286 VSS VSS VSS VSS nfet_03v3 ad=0.61p pd=3.22u as=0 ps=0 w=1u l=8u
X287 VSS VSS VSS VSS nfet_03v3 ad=0.2014p pd=1.98u as=0 ps=0 w=0.22u l=0.28u
X288 bias_cell_0.VT_inh bias_cell_0.VT_inh VDD VDD pfet_03v3 ad=0.308p pd=1.58u as=0.308p ps=1.58u w=0.88u l=1.12u
X289 VSS VSS VSS VSS nfet_03v3 ad=0.61p pd=3.22u as=0 ps=0 w=1u l=1u
X290 VSS bias_cell_0.Vb VSS VSS nfet_03v3 ad=0.61p pd=3.22u as=0 ps=0 w=1u l=8u
X291 VSS VSS VSS VSS nfet_03v3 ad=0.2014p pd=1.98u as=0 ps=0 w=0.22u l=0.28u
X292 VSS VSS VSS VSS nfet_03v3 ad=0.61p pd=3.22u as=0 ps=0 w=1u l=8u
X293 VSS VSS VSS VSS nfet_03v3 ad=0.2014p pd=1.98u as=0 ps=0 w=0.22u l=0.28u
X294 VSS bias_cell_0.Vb VSS VSS nfet_03v3 ad=0.61p pd=3.22u as=0 ps=0 w=1u l=8u
X295 a_46472_55530# a_50306_55608# spike[3] VDD pfet_03v3 ad=0.2166p pd=2.06u as=0.2166p ps=2.06u w=0.22u l=0.28u
X296 VSS VSS VSS VSS nfet_03v3 ad=0.2014p pd=1.98u as=0 ps=0 w=0.22u l=0.28u
X297 VSS VSS VSS VSS nfet_03v3 ad=0.2014p pd=1.98u as=0 ps=0 w=0.22u l=0.28u
X298 a_46472_32242# bias_cell_0.VKup VDD VDD pfet_03v3 ad=0.65p pd=3.3u as=0.65p ps=3.3u w=1u l=1u
X299 bias_cell_0.Vthr bias_cell_0.Vthr VDD VDD pfet_03v3 ad=0.1074p pd=1.08u as=0.1074p ps=1.08u w=0.22u l=0.28u
X300 VSS VSS VSS VSS nfet_03v3 ad=0.2014p pd=1.98u as=0 ps=0 w=0.22u l=0.28u
X301 VSS VSS VSS VSS nfet_03v3 ad=0.2014p pd=1.98u as=0 ps=0 w=0.22u l=0.28u
X302 VSS VSS VSS VSS nfet_03v3 ad=0.61p pd=3.22u as=0 ps=0 w=1u l=1u
X303 VSS VSS VSS VSS nfet_03v3 ad=0.2014p pd=1.98u as=0 ps=0 w=0.22u l=0.28u
X304 VDD VDD VDD VDD pfet_03v3 ad=0.65p pd=3.3u as=0 ps=0 w=1u l=1u
X305 VDD VDD VDD VDD pfet_03v3 ad=0.65p pd=3.3u as=0 ps=0 w=1u l=1u
X306 VSS VSS VSS VSS nfet_03v3 ad=0.2014p pd=1.98u as=0 ps=0 w=0.22u l=0.28u
X307 VSS VSS VSS VSS nfet_03v3 ad=0.2014p pd=1.98u as=0 ps=0 w=0.22u l=0.28u
X308 bias_cell_0.Vthr bias_cell_0.Vthr VDD VDD pfet_03v3 ad=0.1074p pd=1.08u as=0.2166p ps=2.06u w=0.22u l=0.28u
X309 VSS w[31] a_3364_92980# VSS nfet_03v3 ad=0.2014p pd=1.98u as=0.2014p ps=1.98u w=0.22u l=0.28u
X310 a_45268_27980# bias_cell_0.Vamp_bias VSS VSS nfet_03v3 ad=0.2014p pd=1.98u as=0.2014p ps=1.98u w=0.22u l=0.28u
X311 VSS VSS VSS VSS nfet_03v3 ad=0.2014p pd=1.98u as=0 ps=0 w=0.22u l=0.28u
X312 VSS VSS VSS VSS nfet_03v3 ad=0.2014p pd=1.98u as=0 ps=0 w=0.22u l=0.28u
X313 VDD bias_cell_0.VT_dpi bias_cell_0.VT_dpi VDD pfet_03v3 ad=0.2166p pd=2.06u as=0.1074p ps=1.08u w=0.22u l=0.28u
X314 VSS VSS VSS VSS nfet_03v3 ad=0.2014p pd=1.98u as=0 ps=0 w=0.22u l=0.28u
X315 VSS VSS VSS VSS nfet_03v3 ad=0.2014p pd=1.98u as=0 ps=0 w=0.22u l=0.28u
X316 VSS VSS VSS VSS nfet_03v3 ad=0.2014p pd=1.98u as=0 ps=0 w=0.22u l=0.28u
X317 VSS VSS VSS VSS nfet_03v3 ad=0.2014p pd=1.98u as=0 ps=0 w=0.22u l=0.28u
X318 VSS VSS VSS VSS nfet_03v3 ad=0.2014p pd=1.98u as=0 ps=0 w=0.22u l=0.28u
X319 VSS VSS VSS VSS nfet_03v3 ad=0.2014p pd=1.98u as=0 ps=0 w=0.22u l=0.28u
X320 VSS VSS VSS VSS nfet_03v3 ad=0.2014p pd=1.98u as=0 ps=0 w=0.22u l=0.28u
X321 VSS VSS VSS VSS nfet_03v3 ad=0.2014p pd=1.98u as=0 ps=0 w=0.22u l=0.28u
X322 VSS VSS VSS VSS nfet_03v3 ad=0.2014p pd=1.98u as=0 ps=0 w=0.22u l=0.28u
X323 VSS VSS VSS VSS nfet_03v3 ad=0.2014p pd=1.98u as=0 ps=0 w=0.22u l=0.28u
X324 VDD bias_cell_0.Vthr bias_cell_0.Vthr VDD pfet_03v3 ad=0.1074p pd=1.08u as=0.1074p ps=1.08u w=0.22u l=0.28u
X325 VSS w[11] a_5364_34940# VSS nfet_03v3 ad=0.2014p pd=1.98u as=0.2014p ps=1.98u w=0.22u l=0.28u
X326 VSS bias_cell_0.Vb VSS VSS nfet_03v3 ad=0.61p pd=3.22u as=0 ps=0 w=1u l=8u
X327 VSS w[19] a_5364_58228# VSS nfet_03v3 ad=0.2014p pd=1.98u as=0.2014p ps=1.98u w=0.22u l=0.28u
X328 VSS VSS VSS VSS nfet_03v3 ad=0.2014p pd=1.98u as=0 ps=0 w=0.22u l=0.28u
X329 VSS VSS VSS VSS nfet_03v3 ad=0.2014p pd=1.98u as=0 ps=0 w=0.22u l=0.28u
X330 VSS bias_cell_0.Vb VSS VSS nfet_03v3 ad=0.61p pd=3.22u as=0 ps=0 w=1u l=8u
X331 VSS bias_cell_0.Vb VSS VSS nfet_03v3 ad=0.61p pd=3.22u as=0 ps=0 w=1u l=8u
X332 a_45268_27980# neuron_sized_2.VMEM a_44260_32304# VSS nfet_03v3 ad=0.2014p pd=1.98u as=0.2014p ps=1.98u w=0.22u l=0.28u
X333 VSS w[1] a_5364_11292# VSS nfet_03v3 ad=0.2014p pd=1.98u as=0.2014p ps=1.98u w=0.22u l=0.28u
X334 VSS VSS VSS VSS nfet_03v3 ad=0.2014p pd=1.98u as=0 ps=0 w=0.22u l=0.28u
X335 VSS w[23] a_5364_69692# VSS nfet_03v3 ad=0.2014p pd=1.98u as=0.2014p ps=1.98u w=0.22u l=0.28u
X336 bias_cell_0.VT_dpi bias_cell_0.VT_dpi VDD VDD pfet_03v3 ad=0.1074p pd=1.08u as=0.1074p ps=1.08u w=0.22u l=0.28u
X337 VDD VDD VDD VDD pfet_03v3 ad=0.65p pd=3.3u as=0 ps=0 w=1u l=1u
X338 VSS w[30] a_3364_92980# VSS nfet_03v3 ad=0.2014p pd=1.98u as=0.2014p ps=1.98u w=0.22u l=0.28u
X339 VSS VSS VSS VSS nfet_03v3 ad=0.2014p pd=1.98u as=0 ps=0 w=0.22u l=0.28u
X340 VSS bias_cell_0.Vb VSS VSS nfet_03v3 ad=0.61p pd=3.22u as=0 ps=0 w=1u l=8u
X341 VDD VDD VDD VDD pfet_03v3 ad=0.2166p pd=2.06u as=0 ps=0 w=0.22u l=0.28u
X342 bias_cell_0.VKup Iref VSS VSS nfet_03v3 ad=3.66305p pd=13.23u as=3.66305p ps=13.23u w=6.005u l=8u
X343 VSS VSS VSS VSS nfet_03v3 ad=0.2014p pd=1.98u as=0 ps=0 w=0.22u l=0.28u
X344 VSS VSS VSS VSS nfet_03v3 ad=0.2014p pd=1.98u as=0 ps=0 w=0.22u l=0.28u
X345 VSS VSS VSS VSS nfet_03v3 ad=0.2014p pd=1.98u as=0 ps=0 w=0.22u l=0.28u
X346 VSS VSS VSS VSS nfet_03v3 ad=0.61p pd=3.22u as=0 ps=0 w=1u l=8u
X347 VSS VSS VSS VSS nfet_03v3 ad=0.2014p pd=1.98u as=0 ps=0 w=0.22u l=0.28u
X348 VSS VSS VSS VSS nfet_03v3 ad=0.61p pd=3.22u as=0 ps=0 w=1u l=8u
X349 VSS VSS VSS VSS nfet_03v3 ad=0.2014p pd=1.98u as=0 ps=0 w=0.22u l=0.28u
X350 VSS bias_cell_0.Vb VSS VSS nfet_03v3 ad=0.61p pd=3.22u as=0 ps=0 w=1u l=8u
X351 VSS VSS VSS VSS nfet_03v3 ad=0.2014p pd=1.98u as=0 ps=0 w=0.22u l=0.28u
X352 a_46472_8594# bias_cell_0.VKup VDD VDD pfet_03v3 ad=0.65p pd=3.3u as=0.65p ps=3.3u w=1u l=1u
X353 VSS bias_cell_0.Vb VSS VSS nfet_03v3 ad=0.61p pd=3.22u as=0 ps=0 w=1u l=8u
X354 VSS VSS VSS VSS nfet_03v3 ad=0.2014p pd=1.98u as=0 ps=0 w=0.22u l=0.28u
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
