Latios1928/engn2912e-project/analog/neuron/layout/PEX/SNN_pex_c.spice

* NGSPICE file created from SNN.ext - technology: gf180mcuD

X0 neuron_sized_0/a_8270_2214# neuron_sized_0/a_9750_6632# spike[4] VSS nfet_03v3 ad=0.2014p pd=1.98u as=0.2014p ps=1.98u w=0.22u l=0.28u
X1 VSS VSS VSS VSS nfet_03v3 ad=0.61p pd=3.22u as=0.13584n ps=0.45369m w=1u l=1u
X2 VDD VDD VDD VDD pfet_03v3 ad=0.2166p pd=2.06u as=0.13954n ps=0.82992m w=0.22u l=0.28u
X3 VSS VSS VSS VSS nfet_03v3 ad=0.61p pd=3.22u as=0 ps=0 w=1u l=1u
X4 VDD VDD VDD VDD pfet_03v3 ad=0.2166p pd=2.06u as=0 ps=0 w=0.22u l=0.28u
X5 VSS VSS VSS VSS nfet_03v3 ad=0.61p pd=3.22u as=0 ps=0 w=1u l=1u
X6 VSS VSS VSS VSS nfet_03v3 ad=0.2014p pd=1.98u as=0 ps=0 w=0.22u l=0.28u
X7 neuron_sized_0/a_4712_2292# bias_cell_0/Vamp_bias VSS VSS nfet_03v3 ad=0.2014p pd=1.98u as=0.2014p ps=1.98u w=0.22u l=0.28u
X8 neuron_sized_0/a_9750_6632# neuron_sized_0/a_4474_6632# neuron_sized_0/a_7550_2214# VSS nfet_03v3 ad=0.2014p pd=1.98u as=0.2014p ps=1.98u w=0.22u l=0.28u
X9 VSS VSS VSS VSS nfet_03v3 ad=0.61p pd=3.22u as=0 ps=0 w=1u l=1u
X10 VSS VSS VSS VSS nfet_03v3 ad=0.61p pd=3.22u as=0 ps=0 w=1u l=1u
X11 VDD VDD VDD VDD pfet_03v3 ad=0.2166p pd=2.06u as=0 ps=0 w=0.22u l=0.28u
X12 VSS VSS VSS VSS nfet_03v3 ad=0.2014p pd=1.98u as=0 ps=0 w=0.22u l=0.28u
X13 VDD VDD VDD VDD pfet_03v3 ad=0.65p pd=3.3u as=0 ps=0 w=1u l=1u
X14 VSS VSS VSS VSS nfet_03v3 ad=0.61p pd=3.22u as=0 ps=0 w=1u l=1u
X15 neuron_sized_0/a_4474_6632# neuron_sized_0/a_3704_6616# VDD VDD pfet_03v3 ad=0.2166p pd=2.06u as=0.2166p ps=2.06u w=0.22u l=0.28u
X16 VSS VSS VSS VSS nfet_03v3 ad=0.2014p pd=1.98u as=0 ps=0 w=0.22u l=0.28u
X17 neuron_sized_0/a_5916_6554# bias_cell_0/VKup VDD VDD pfet_03v3 ad=0.65p pd=3.3u as=0.65p ps=3.3u w=1u l=1u
X18 DPI_0/Isyn spike[4] neuron_sized_0/a_3430_2214# VSS nfet_03v3 ad=0.2014p pd=1.98u as=0.2014p ps=1.98u w=0.22u l=5u
X19 DPI_0/Isyn neuron_sized_0/a_9750_6632# neuron_sized_0/a_2722_6554# VDD pfet_03v3 ad=0.2166p pd=2.06u as=0.2166p ps=2.06u w=0.22u l=0.28u
X20 VSS VSS VSS VSS nfet_03v3 ad=0.2014p pd=1.98u as=0 ps=0 w=0.22u l=0.28u
X21 VDD VDD VDD VDD pfet_03v3 ad=0.2166p pd=2.06u as=0 ps=0 w=0.22u l=0.28u
X22 VSS VSS VSS VSS nfet_03v3 ad=0.61p pd=3.22u as=0 ps=0 w=1u l=1u
X23 VDD VDD VDD VDD pfet_03v3 ad=0.65p pd=3.3u as=0 ps=0 w=1u l=1u
X24 VDD VDD VDD VDD pfet_03v3 ad=0.65p pd=3.3u as=0 ps=0 w=1u l=1u
X25 VSS VSS VSS VSS nfet_03v3 ad=0.2014p pd=1.98u as=0 ps=0 w=0.22u l=0.28u
X26 VSS VSS VSS VSS nfet_03v3 ad=0.61p pd=3.22u as=0 ps=0 w=1u l=1u
X27 VDD VDD VDD VDD pfet_03v3 ad=0.65p pd=3.3u as=0 ps=0 w=1u l=1u
X28 VDD VDD VDD VDD pfet_03v3 ad=0.2166p pd=2.06u as=0 ps=0 w=0.22u l=0.28u
X29 VSS VSS VSS VSS nfet_03v3 ad=0.61p pd=3.22u as=0 ps=0 w=1u l=1u
X30 VSS VSS VSS VSS nfet_03v3 ad=0.2014p pd=1.98u as=0 ps=0 w=0.22u l=0.28u
X31 neuron_sized_0/a_4712_2292# DPI_0/Isyn neuron_sized_0/a_3704_6616# VSS nfet_03v3 ad=0.2014p pd=1.98u as=0.2014p ps=1.98u w=0.22u l=0.28u
X32 VSS VSS VSS VSS nfet_03v3 ad=0.2014p pd=1.98u as=0 ps=0 w=0.22u l=0.28u
X33 spike[4] VSS cap_mim_2f0_m4m5_noshield c_width=10u c_length=10u
X34 VDD VDD VDD VDD pfet_03v3 ad=0.2166p pd=2.06u as=0 ps=0 w=0.22u l=0.28u
X35 VDD VDD VDD VDD pfet_03v3 ad=0.65p pd=3.3u as=0 ps=0 w=1u l=1u
X36 VDD VDD VDD VDD pfet_03v3 ad=0.65p pd=3.3u as=0 ps=0 w=1u l=1u
X37 VDD VDD VDD VDD pfet_03v3 ad=0.2166p pd=2.06u as=0 ps=0 w=0.22u l=0.28u
X38 VDD VDD VDD VDD pfet_03v3 ad=0.65p pd=3.3u as=0 ps=0 w=1u l=1u
X39 VDD VDD VDD VDD pfet_03v3 ad=0.2166p pd=2.06u as=0 ps=0 w=0.22u l=0.28u
X40 VSS VSS VSS VSS nfet_03v3 ad=0.2014p pd=1.98u as=0 ps=0 w=0.22u l=0.28u
X41 neuron_sized_0/a_7550_2214# bias_cell_0/VIp VSS VSS nfet_03v3 ad=0.61p pd=3.22u as=0.61p ps=3.22u w=1u l=1u
X42 VSS VSS VSS VSS nfet_03v3 ad=0.2014p pd=1.98u as=0 ps=0 w=0.22u l=0.28u
X43 neuron_sized_0/a_8270_2214# bias_cell_0/VKdn VSS VSS nfet_03v3 ad=0.61p pd=3.22u as=0.61p ps=3.22u w=1u l=1u
X44 VSS VSS VSS VSS nfet_03v3 ad=0.61p pd=3.22u as=0 ps=0 w=1u l=1u
X45 VDD VDD VDD VDD pfet_03v3 ad=0.65p pd=3.3u as=0 ps=0 w=1u l=1u
X46 VDD neuron_sized_0/a_3704_6616# neuron_sized_0/a_3704_6616# VDD pfet_03v3 ad=0.2166p pd=2.06u as=0.2166p ps=2.06u w=0.22u l=0.28u
X47 neuron_sized_0/a_5916_6554# neuron_sized_0/a_9750_6632# spike[4] VDD pfet_03v3 ad=0.2166p pd=2.06u as=0.2166p ps=2.06u w=0.22u l=0.28u
X48 VSS VSS VSS VSS nfet_03v3 ad=0.61p pd=3.22u as=0 ps=0 w=1u l=1u
X49 neuron_sized_0/a_2722_6554# bias_cell_0/VNA VDD VDD pfet_03v3 ad=0.65p pd=3.3u as=0.65p ps=3.3u w=1u l=1u
X50 VDD VDD VDD VDD pfet_03v3 ad=0.2166p pd=2.06u as=0 ps=0 w=0.22u l=0.28u
X51 neuron_sized_0/a_4474_6632# VT neuron_sized_0/a_4712_2292# VSS nfet_03v3 ad=0.2014p pd=1.98u as=0.2014p ps=1.98u w=0.22u l=0.28u
X52 VSS VSS VSS VSS nfet_03v3 ad=0.61p pd=3.22u as=0 ps=0 w=1u l=1u
X53 VDD VDD VDD VDD pfet_03v3 ad=0.2166p pd=2.06u as=0 ps=0 w=0.22u l=0.28u
X54 VSS VSS VSS VSS nfet_03v3 ad=0.61p pd=3.22u as=0 ps=0 w=1u l=1u
X55 DPI_0/Isyn bias_cell_0/Vlk VSS VSS nfet_03v3 ad=0.61p pd=3.22u as=0.61p ps=3.22u w=1u l=1u
X56 VSS VSS VSS VSS nfet_03v3 ad=0.2014p pd=1.98u as=0 ps=0 w=0.22u l=0.28u
X57 neuron_sized_0/a_3430_2214# bias_cell_0/VK VSS VSS nfet_03v3 ad=0.61p pd=3.22u as=0.61p ps=3.22u w=1u l=1u
X58 VSS VSS VSS VSS nfet_03v3 ad=0.2014p pd=1.98u as=0 ps=0 w=0.22u l=0.28u
X59 VSS VSS VSS VSS nfet_03v3 ad=0.61p pd=3.22u as=0 ps=0 w=1u l=1u
X60 DPI_0/Isyn VSS cap_mim_2f0_m4m5_noshield c_width=22.18u c_length=22.18u
X61 VDD VDD VDD VDD pfet_03v3 ad=0.65p pd=3.3u as=0 ps=0 w=1u l=1u
X62 VDD VDD VDD VDD pfet_03v3 ad=0.65p pd=3.3u as=0 ps=0 w=1u l=1u
X63 neuron_sized_0/a_9750_6632# neuron_sized_0/a_4474_6632# VDD VDD pfet_03v3 ad=0.2166p pd=2.06u as=0.2166p ps=2.06u w=0.22u l=0.28u
X64 VSS VSS VSS VSS nfet_03v3 ad=0.2014p pd=1.98u as=0 ps=0 w=0.22u l=0.28u
X65 neuron_sized_1/a_8270_2214# neuron_sized_1/a_9750_6632# spike[3] VSS nfet_03v3 ad=0.8114p pd=5.2u as=0.2014p ps=1.98u w=0.22u l=0.28u
X66 VSS VSS VSS VSS nfet_03v3 ad=0 pd=0 as=0 ps=0 w=1u l=1u
X67 VDD VDD VDD VDD pfet_03v3 ad=0 pd=0 as=0 ps=0 w=0.22u l=0.28u
X68 VSS VSS VSS VSS nfet_03v3 ad=0 pd=0 as=0 ps=0 w=1u l=1u
X69 VDD VDD VDD VDD pfet_03v3 ad=0 pd=0 as=0 ps=0 w=0.22u l=0.28u
X70 VSS VSS VSS VSS nfet_03v3 ad=0 pd=0 as=0 ps=0 w=1u l=1u
X71 VSS VSS VSS VSS nfet_03v3 ad=0 pd=0 as=0 ps=0 w=0.22u l=0.28u
X72 neuron_sized_1/a_4712_2292# bias_cell_0/Vamp_bias VSS VSS nfet_03v3 ad=0.6042p pd=5.94u as=0 ps=0 w=0.22u l=0.28u
X73 neuron_sized_1/a_9750_6632# neuron_sized_1/a_4474_6632# neuron_sized_1/a_7550_2214# VSS nfet_03v3 ad=0.2014p pd=1.98u as=0.8114p ps=5.2u w=0.22u l=0.28u
X74 VSS VSS VSS VSS nfet_03v3 ad=0 pd=0 as=0 ps=0 w=1u l=1u
X75 VSS VSS VSS VSS nfet_03v3 ad=0 pd=0 as=0 ps=0 w=1u l=1u
X76 VDD VDD VDD VDD pfet_03v3 ad=0 pd=0 as=0 ps=0 w=0.22u l=0.28u
X77 VSS VSS VSS VSS nfet_03v3 ad=0 pd=0 as=0 ps=0 w=0.22u l=0.28u
X78 VDD VDD VDD VDD pfet_03v3 ad=0 pd=0 as=0 ps=0 w=1u l=1u
X79 VSS VSS VSS VSS nfet_03v3 ad=0 pd=0 as=0 ps=0 w=1u l=1u
X80 neuron_sized_1/a_4474_6632# neuron_sized_1/a_3704_6616# VDD VDD pfet_03v3 ad=0.2166p pd=2.06u as=0 ps=0 w=0.22u l=0.28u
X81 VSS VSS VSS VSS nfet_03v3 ad=0 pd=0 as=0 ps=0 w=0.22u l=0.28u
X82 neuron_sized_1/a_5916_6554# bias_cell_0/VKup VDD VDD pfet_03v3 ad=0.8666p pd=5.36u as=0 ps=0 w=1u l=1u
X83 DPI_1/Isyn spike[3] neuron_sized_1/a_3430_2214# VSS nfet_03v3 ad=0.8114p pd=5.2u as=0.8114p ps=5.2u w=0.22u l=5u
X84 DPI_1/Isyn neuron_sized_1/a_9750_6632# neuron_sized_1/a_2722_6554# VDD pfet_03v3 ad=0.4332p pd=4.12u as=0.8666p ps=5.36u w=0.22u l=0.28u
X85 VSS VSS VSS VSS nfet_03v3 ad=0 pd=0 as=0 ps=0 w=0.22u l=0.28u
X86 VDD VDD VDD VDD pfet_03v3 ad=0 pd=0 as=0 ps=0 w=0.22u l=0.28u
X87 VSS VSS VSS VSS nfet_03v3 ad=0 pd=0 as=0 ps=0 w=1u l=1u
X88 VDD VDD VDD VDD pfet_03v3 ad=0 pd=0 as=0 ps=0 w=1u l=1u
X89 VDD VDD VDD VDD pfet_03v3 ad=0 pd=0 as=0 ps=0 w=1u l=1u
X90 VSS VSS VSS VSS nfet_03v3 ad=0 pd=0 as=0 ps=0 w=0.22u l=0.28u
X91 VSS VSS VSS VSS nfet_03v3 ad=0 pd=0 as=0 ps=0 w=1u l=1u
X92 VDD VDD VDD VDD pfet_03v3 ad=0 pd=0 as=0 ps=0 w=1u l=1u
X93 VDD VDD VDD VDD pfet_03v3 ad=0 pd=0 as=0 ps=0 w=0.22u l=0.28u
X94 VSS VSS VSS VSS nfet_03v3 ad=0 pd=0 as=0 ps=0 w=1u l=1u
X95 VSS VSS VSS VSS nfet_03v3 ad=0 pd=0 as=0 ps=0 w=0.22u l=0.28u
X96 neuron_sized_1/a_4712_2292# DPI_1/Isyn neuron_sized_1/a_3704_6616# VSS nfet_03v3 ad=0 pd=0 as=0.2014p ps=1.98u w=0.22u l=0.28u
X97 VSS VSS VSS VSS nfet_03v3 ad=0 pd=0 as=0 ps=0 w=0.22u l=0.28u
X98 spike[3] VSS cap_mim_2f0_m4m5_noshield c_width=10u c_length=10u
X99 VDD VDD VDD VDD pfet_03v3 ad=0 pd=0 as=0 ps=0 w=0.22u l=0.28u
X100 VDD VDD VDD VDD pfet_03v3 ad=0 pd=0 as=0 ps=0 w=1u l=1u
X101 VDD VDD VDD VDD pfet_03v3 ad=0 pd=0 as=0 ps=0 w=1u l=1u
X102 VDD VDD VDD VDD pfet_03v3 ad=0 pd=0 as=0 ps=0 w=0.22u l=0.28u
X103 VDD VDD VDD VDD pfet_03v3 ad=0 pd=0 as=0 ps=0 w=1u l=1u
X104 VDD VDD VDD VDD pfet_03v3 ad=0 pd=0 as=0 ps=0 w=0.22u l=0.28u
X105 VSS VSS VSS VSS nfet_03v3 ad=0 pd=0 as=0 ps=0 w=0.22u l=0.28u
X106 neuron_sized_1/a_7550_2214# bias_cell_0/VIp VSS VSS nfet_03v3 ad=0 pd=0 as=0 ps=0 w=1u l=1u
X107 VSS VSS VSS VSS nfet_03v3 ad=0 pd=0 as=0 ps=0 w=0.22u l=0.28u
X108 neuron_sized_1/a_8270_2214# bias_cell_0/VKdn VSS VSS nfet_03v3 ad=0 pd=0 as=0 ps=0 w=1u l=1u
X109 VSS VSS VSS VSS nfet_03v3 ad=0 pd=0 as=0 ps=0 w=1u l=1u
X110 VDD VDD VDD VDD pfet_03v3 ad=0 pd=0 as=0 ps=0 w=1u l=1u
X111 VDD neuron_sized_1/a_3704_6616# neuron_sized_1/a_3704_6616# VDD pfet_03v3 ad=0 pd=0 as=0.2166p ps=2.06u w=0.22u l=0.28u
X112 neuron_sized_1/a_5916_6554# neuron_sized_1/a_9750_6632# spike[3] VDD pfet_03v3 ad=0 pd=0 as=0.2166p ps=2.06u w=0.22u l=0.28u
X113 VSS VSS VSS VSS nfet_03v3 ad=0 pd=0 as=0 ps=0 w=1u l=1u
X114 neuron_sized_1/a_2722_6554# bias_cell_0/VNA VDD VDD pfet_03v3 ad=0 pd=0 as=0 ps=0 w=1u l=1u
X115 VDD VDD VDD VDD pfet_03v3 ad=0 pd=0 as=0 ps=0 w=0.22u l=0.28u
X116 neuron_sized_1/a_4474_6632# VT neuron_sized_1/a_4712_2292# VSS nfet_03v3 ad=0.2014p pd=1.98u as=0 ps=0 w=0.22u l=0.28u
X117 VSS VSS VSS VSS nfet_03v3 ad=0 pd=0 as=0 ps=0 w=1u l=1u
X118 VDD VDD VDD VDD pfet_03v3 ad=0 pd=0 as=0 ps=0 w=0.22u l=0.28u
X119 VSS VSS VSS VSS nfet_03v3 ad=0 pd=0 as=0 ps=0 w=1u l=1u
X120 DPI_1/Isyn bias_cell_0/Vlk VSS VSS nfet_03v3 ad=0 pd=0 as=0 ps=0 w=1u l=1u
X121 VSS VSS VSS VSS nfet_03v3 ad=0 pd=0 as=0 ps=0 w=0.22u l=0.28u
X122 neuron_sized_1/a_3430_2214# bias_cell_0/VK VSS VSS nfet_03v3 ad=0 pd=0 as=0 ps=0 w=1u l=1u
X123 VSS VSS VSS VSS nfet_03v3 ad=0 pd=0 as=0 ps=0 w=0.22u l=0.28u
X124 VSS VSS VSS VSS nfet_03v3 ad=0 pd=0 as=0 ps=0 w=1u l=1u
X125 DPI_1/Isyn VSS cap_mim_2f0_m4m5_noshield c_width=22.18u c_length=22.18u
X126 VDD VDD VDD VDD pfet_03v3 ad=0 pd=0 as=0 ps=0 w=1u l=1u
X127 VDD VDD VDD VDD pfet_03v3 ad=0 pd=0 as=0 ps=0 w=1u l=1u
X128 neuron_sized_1/a_9750_6632# neuron_sized_1/a_4474_6632# VDD VDD pfet_03v3 ad=0.2166p pd=2.06u as=0 ps=0 w=0.22u l=0.28u
X129 VSS VSS VSS VSS nfet_03v3 ad=0 pd=0 as=0 ps=0 w=0.22u l=0.28u
X130 neuron_sized_2/a_8270_2214# neuron_sized_2/a_9750_6632# spike[2] VSS nfet_03v3 ad=0.8114p pd=5.2u as=0.2014p ps=1.98u w=0.22u l=0.28u
X131 VSS VSS VSS VSS nfet_03v3 ad=0 pd=0 as=0 ps=0 w=1u l=1u
X132 VDD VDD VDD VDD pfet_03v3 ad=0 pd=0 as=0 ps=0 w=0.22u l=0.28u
X133 VSS VSS VSS VSS nfet_03v3 ad=0 pd=0 as=0 ps=0 w=1u l=1u
X134 VDD VDD VDD VDD pfet_03v3 ad=0 pd=0 as=0 ps=0 w=0.22u l=0.28u
X135 VSS VSS VSS VSS nfet_03v3 ad=0 pd=0 as=0 ps=0 w=1u l=1u
X136 VSS VSS VSS VSS nfet_03v3 ad=0 pd=0 as=0 ps=0 w=0.22u l=0.28u
X137 neuron_sized_2/a_4712_2292# bias_cell_0/Vamp_bias VSS VSS nfet_03v3 ad=0.6042p pd=5.94u as=0 ps=0 w=0.22u l=0.28u
X138 neuron_sized_2/a_9750_6632# neuron_sized_2/a_4474_6632# neuron_sized_2/a_7550_2214# VSS nfet_03v3 ad=0.2014p pd=1.98u as=0.8114p ps=5.2u w=0.22u l=0.28u
X139 VSS VSS VSS VSS nfet_03v3 ad=0 pd=0 as=0 ps=0 w=1u l=1u
X140 VSS VSS VSS VSS nfet_03v3 ad=0 pd=0 as=0 ps=0 w=1u l=1u
X141 VDD VDD VDD VDD pfet_03v3 ad=0 pd=0 as=0 ps=0 w=0.22u l=0.28u
X142 VSS VSS VSS VSS nfet_03v3 ad=0 pd=0 as=0 ps=0 w=0.22u l=0.28u
X143 VDD VDD VDD VDD pfet_03v3 ad=0 pd=0 as=0 ps=0 w=1u l=1u
X144 VSS VSS VSS VSS nfet_03v3 ad=0 pd=0 as=0 ps=0 w=1u l=1u
X145 neuron_sized_2/a_4474_6632# neuron_sized_2/a_3704_6616# VDD VDD pfet_03v3 ad=0.2166p pd=2.06u as=0 ps=0 w=0.22u l=0.28u
X146 VSS VSS VSS VSS nfet_03v3 ad=0 pd=0 as=0 ps=0 w=0.22u l=0.28u
X147 neuron_sized_2/a_5916_6554# bias_cell_0/VKup VDD VDD pfet_03v3 ad=0.8666p pd=5.36u as=0 ps=0 w=1u l=1u
X148 DPI_2/Isyn spike[2] neuron_sized_2/a_3430_2214# VSS nfet_03v3 ad=0.8114p pd=5.2u as=0.8114p ps=5.2u w=0.22u l=5u
X149 DPI_2/Isyn neuron_sized_2/a_9750_6632# neuron_sized_2/a_2722_6554# VDD pfet_03v3 ad=0.4332p pd=4.12u as=0.8666p ps=5.36u w=0.22u l=0.28u
X150 VSS VSS VSS VSS nfet_03v3 ad=0 pd=0 as=0 ps=0 w=0.22u l=0.28u
X151 VDD VDD VDD VDD pfet_03v3 ad=0 pd=0 as=0 ps=0 w=0.22u l=0.28u
X152 VSS VSS VSS VSS nfet_03v3 ad=0 pd=0 as=0 ps=0 w=1u l=1u
X153 VDD VDD VDD VDD pfet_03v3 ad=0 pd=0 as=0 ps=0 w=1u l=1u
X154 VDD VDD VDD VDD pfet_03v3 ad=0 pd=0 as=0 ps=0 w=1u l=1u
X155 VSS VSS VSS VSS nfet_03v3 ad=0 pd=0 as=0 ps=0 w=0.22u l=0.28u
X156 VSS VSS VSS VSS nfet_03v3 ad=0 pd=0 as=0 ps=0 w=1u l=1u
X157 VDD VDD VDD VDD pfet_03v3 ad=0 pd=0 as=0 ps=0 w=1u l=1u
X158 VDD VDD VDD VDD pfet_03v3 ad=0 pd=0 as=0 ps=0 w=0.22u l=0.28u
X159 VSS VSS VSS VSS nfet_03v3 ad=0 pd=0 as=0 ps=0 w=1u l=1u
X160 VSS VSS VSS VSS nfet_03v3 ad=0 pd=0 as=0 ps=0 w=0.22u l=0.28u
X161 neuron_sized_2/a_4712_2292# DPI_2/Isyn neuron_sized_2/a_3704_6616# VSS nfet_03v3 ad=0 pd=0 as=0.2014p ps=1.98u w=0.22u l=0.28u
X162 VSS VSS VSS VSS nfet_03v3 ad=0 pd=0 as=0 ps=0 w=0.22u l=0.28u
X163 spike[2] VSS cap_mim_2f0_m4m5_noshield c_width=10u c_length=10u
X164 VDD VDD VDD VDD pfet_03v3 ad=0 pd=0 as=0 ps=0 w=0.22u l=0.28u
X165 VDD VDD VDD VDD pfet_03v3 ad=0 pd=0 as=0 ps=0 w=1u l=1u
X166 VDD VDD VDD VDD pfet_03v3 ad=0 pd=0 as=0 ps=0 w=1u l=1u
X167 VDD VDD VDD VDD pfet_03v3 ad=0 pd=0 as=0 ps=0 w=0.22u l=0.28u
X168 VDD VDD VDD VDD pfet_03v3 ad=0 pd=0 as=0 ps=0 w=1u l=1u
X169 VDD VDD VDD VDD pfet_03v3 ad=0 pd=0 as=0 ps=0 w=0.22u l=0.28u
X170 VSS VSS VSS VSS nfet_03v3 ad=0 pd=0 as=0 ps=0 w=0.22u l=0.28u
X171 neuron_sized_2/a_7550_2214# bias_cell_0/VIp VSS VSS nfet_03v3 ad=0 pd=0 as=0 ps=0 w=1u l=1u
X172 VSS VSS VSS VSS nfet_03v3 ad=0 pd=0 as=0 ps=0 w=0.22u l=0.28u
X173 neuron_sized_2/a_8270_2214# bias_cell_0/VKdn VSS VSS nfet_03v3 ad=0 pd=0 as=0 ps=0 w=1u l=1u
X174 VSS VSS VSS VSS nfet_03v3 ad=0 pd=0 as=0 ps=0 w=1u l=1u
X175 VDD VDD VDD VDD pfet_03v3 ad=0 pd=0 as=0 ps=0 w=1u l=1u
X176 VDD neuron_sized_2/a_3704_6616# neuron_sized_2/a_3704_6616# VDD pfet_03v3 ad=0 pd=0 as=0.2166p ps=2.06u w=0.22u l=0.28u
X177 neuron_sized_2/a_5916_6554# neuron_sized_2/a_9750_6632# spike[2] VDD pfet_03v3 ad=0 pd=0 as=0.2166p ps=2.06u w=0.22u l=0.28u
X178 VSS VSS VSS VSS nfet_03v3 ad=0 pd=0 as=0 ps=0 w=1u l=1u
X179 neuron_sized_2/a_2722_6554# bias_cell_0/VNA VDD VDD pfet_03v3 ad=0 pd=0 as=0 ps=0 w=1u l=1u
X180 VDD VDD VDD VDD pfet_03v3 ad=0 pd=0 as=0 ps=0 w=0.22u l=0.28u
X181 neuron_sized_2/a_4474_6632# VT neuron_sized_2/a_4712_2292# VSS nfet_03v3 ad=0.2014p pd=1.98u as=0 ps=0 w=0.22u l=0.28u
X182 VSS VSS VSS VSS nfet_03v3 ad=0 pd=0 as=0 ps=0 w=1u l=1u
X183 VDD VDD VDD VDD pfet_03v3 ad=0 pd=0 as=0 ps=0 w=0.22u l=0.28u
X184 VSS VSS VSS VSS nfet_03v3 ad=0 pd=0 as=0 ps=0 w=1u l=1u
X185 DPI_2/Isyn bias_cell_0/Vlk VSS VSS nfet_03v3 ad=0 pd=0 as=0 ps=0 w=1u l=1u
X186 VSS VSS VSS VSS nfet_03v3 ad=0 pd=0 as=0 ps=0 w=0.22u l=0.28u
X187 neuron_sized_2/a_3430_2214# bias_cell_0/VK VSS VSS nfet_03v3 ad=0 pd=0 as=0 ps=0 w=1u l=1u
X188 VSS VSS VSS VSS nfet_03v3 ad=0 pd=0 as=0 ps=0 w=0.22u l=0.28u
X189 VSS VSS VSS VSS nfet_03v3 ad=0 pd=0 as=0 ps=0 w=1u l=1u
X190 DPI_2/Isyn VSS cap_mim_2f0_m4m5_noshield c_width=22.18u c_length=22.18u
X191 VDD VDD VDD VDD pfet_03v3 ad=0 pd=0 as=0 ps=0 w=1u l=1u
X192 VDD VDD VDD VDD pfet_03v3 ad=0 pd=0 as=0 ps=0 w=1u l=1u
X193 neuron_sized_2/a_9750_6632# neuron_sized_2/a_4474_6632# VDD VDD pfet_03v3 ad=0.2166p pd=2.06u as=0 ps=0 w=0.22u l=0.28u
X194 VSS VSS VSS VSS nfet_03v3 ad=0 pd=0 as=0 ps=0 w=0.22u l=0.28u
X195 neuron_sized_3/a_8270_2214# neuron_sized_3/a_9750_6632# spike[1] VSS nfet_03v3 ad=0.8114p pd=5.2u as=0.2014p ps=1.98u w=0.22u l=0.28u
X196 VSS VSS VSS VSS nfet_03v3 ad=0 pd=0 as=0 ps=0 w=1u l=1u
X197 VDD VDD VDD VDD pfet_03v3 ad=0 pd=0 as=0 ps=0 w=0.22u l=0.28u
X198 VSS VSS VSS VSS nfet_03v3 ad=0 pd=0 as=0 ps=0 w=1u l=1u
X199 VDD VDD VDD VDD pfet_03v3 ad=0 pd=0 as=0 ps=0 w=0.22u l=0.28u
X200 VSS VSS VSS VSS nfet_03v3 ad=0 pd=0 as=0 ps=0 w=1u l=1u
X201 VSS VSS VSS VSS nfet_03v3 ad=0 pd=0 as=0 ps=0 w=0.22u l=0.28u
X202 neuron_sized_3/a_4712_2292# bias_cell_0/Vamp_bias VSS VSS nfet_03v3 ad=0.6042p pd=5.94u as=0 ps=0 w=0.22u l=0.28u
X203 neuron_sized_3/a_9750_6632# neuron_sized_3/a_4474_6632# neuron_sized_3/a_7550_2214# VSS nfet_03v3 ad=0.2014p pd=1.98u as=0.8114p ps=5.2u w=0.22u l=0.28u
X204 VSS VSS VSS VSS nfet_03v3 ad=0 pd=0 as=0 ps=0 w=1u l=1u
X205 VSS VSS VSS VSS nfet_03v3 ad=0 pd=0 as=0 ps=0 w=1u l=1u
X206 VDD VDD VDD VDD pfet_03v3 ad=0 pd=0 as=0 ps=0 w=0.22u l=0.28u
X207 VSS VSS VSS VSS nfet_03v3 ad=0 pd=0 as=0 ps=0 w=0.22u l=0.28u
X208 VDD VDD VDD VDD pfet_03v3 ad=0 pd=0 as=0 ps=0 w=1u l=1u
X209 VSS VSS VSS VSS nfet_03v3 ad=0 pd=0 as=0 ps=0 w=1u l=1u
X210 neuron_sized_3/a_4474_6632# neuron_sized_3/a_3704_6616# VDD VDD pfet_03v3 ad=0.2166p pd=2.06u as=0 ps=0 w=0.22u l=0.28u
X211 VSS VSS VSS VSS nfet_03v3 ad=0 pd=0 as=0 ps=0 w=0.22u l=0.28u
X212 neuron_sized_3/a_5916_6554# bias_cell_0/VKup VDD VDD pfet_03v3 ad=0.8666p pd=5.36u as=0 ps=0 w=1u l=1u
X213 DPI_3/Isyn spike[1] neuron_sized_3/a_3430_2214# VSS nfet_03v3 ad=0.8114p pd=5.2u as=0.8114p ps=5.2u w=0.22u l=5u
X214 DPI_3/Isyn neuron_sized_3/a_9750_6632# neuron_sized_3/a_2722_6554# VDD pfet_03v3 ad=0.4332p pd=4.12u as=0.8666p ps=5.36u w=0.22u l=0.28u
X215 VSS VSS VSS VSS nfet_03v3 ad=0 pd=0 as=0 ps=0 w=0.22u l=0.28u
X216 VDD VDD VDD VDD pfet_03v3 ad=0 pd=0 as=0 ps=0 w=0.22u l=0.28u
X217 VSS VSS VSS VSS nfet_03v3 ad=0 pd=0 as=0 ps=0 w=1u l=1u
X218 VDD VDD VDD VDD pfet_03v3 ad=0 pd=0 as=0 ps=0 w=1u l=1u
X219 VDD VDD VDD VDD pfet_03v3 ad=0 pd=0 as=0 ps=0 w=1u l=1u
X220 VSS VSS VSS VSS nfet_03v3 ad=0 pd=0 as=0 ps=0 w=0.22u l=0.28u
X221 VSS VSS VSS VSS nfet_03v3 ad=0 pd=0 as=0 ps=0 w=1u l=1u
X222 VDD VDD VDD VDD pfet_03v3 ad=0 pd=0 as=0 ps=0 w=1u l=1u
X223 VDD VDD VDD VDD pfet_03v3 ad=0 pd=0 as=0 ps=0 w=0.22u l=0.28u
X224 VSS VSS VSS VSS nfet_03v3 ad=0 pd=0 as=0 ps=0 w=1u l=1u
X225 VSS VSS VSS VSS nfet_03v3 ad=0 pd=0 as=0 ps=0 w=0.22u l=0.28u
X226 neuron_sized_3/a_4712_2292# DPI_3/Isyn neuron_sized_3/a_3704_6616# VSS nfet_03v3 ad=0 pd=0 as=0.2014p ps=1.98u w=0.22u l=0.28u
X227 VSS VSS VSS VSS nfet_03v3 ad=0 pd=0 as=0 ps=0 w=0.22u l=0.28u
X228 spike[1] VSS cap_mim_2f0_m4m5_noshield c_width=10u c_length=10u
X229 VDD VDD VDD VDD pfet_03v3 ad=0 pd=0 as=0 ps=0 w=0.22u l=0.28u
X230 VDD VDD VDD VDD pfet_03v3 ad=0 pd=0 as=0 ps=0 w=1u l=1u
X231 VDD VDD VDD VDD pfet_03v3 ad=0 pd=0 as=0 ps=0 w=1u l=1u
X232 VDD VDD VDD VDD pfet_03v3 ad=0 pd=0 as=0 ps=0 w=0.22u l=0.28u
X233 VDD VDD VDD VDD pfet_03v3 ad=0 pd=0 as=0 ps=0 w=1u l=1u
X234 VDD VDD VDD VDD pfet_03v3 ad=0 pd=0 as=0 ps=0 w=0.22u l=0.28u
X235 VSS VSS VSS VSS nfet_03v3 ad=0 pd=0 as=0 ps=0 w=0.22u l=0.28u
X236 neuron_sized_3/a_7550_2214# bias_cell_0/VIp VSS VSS nfet_03v3 ad=0 pd=0 as=0 ps=0 w=1u l=1u
X237 VSS VSS VSS VSS nfet_03v3 ad=0 pd=0 as=0 ps=0 w=0.22u l=0.28u
X238 neuron_sized_3/a_8270_2214# bias_cell_0/VKdn VSS VSS nfet_03v3 ad=0 pd=0 as=0 ps=0 w=1u l=1u
X239 VSS VSS VSS VSS nfet_03v3 ad=0 pd=0 as=0 ps=0 w=1u l=1u
X240 VDD VDD VDD VDD pfet_03v3 ad=0 pd=0 as=0 ps=0 w=1u l=1u
X241 VDD neuron_sized_3/a_3704_6616# neuron_sized_3/a_3704_6616# VDD pfet_03v3 ad=0 pd=0 as=0.2166p ps=2.06u w=0.22u l=0.28u
X242 neuron_sized_3/a_5916_6554# neuron_sized_3/a_9750_6632# spike[1] VDD pfet_03v3 ad=0 pd=0 as=0.2166p ps=2.06u w=0.22u l=0.28u
X243 VSS VSS VSS VSS nfet_03v3 ad=0 pd=0 as=0 ps=0 w=1u l=1u
X244 neuron_sized_3/a_2722_6554# bias_cell_0/VNA VDD VDD pfet_03v3 ad=0 pd=0 as=0 ps=0 w=1u l=1u
X245 VDD VDD VDD VDD pfet_03v3 ad=0 pd=0 as=0 ps=0 w=0.22u l=0.28u
X246 neuron_sized_3/a_4474_6632# VT neuron_sized_3/a_4712_2292# VSS nfet_03v3 ad=0.2014p pd=1.98u as=0 ps=0 w=0.22u l=0.28u
X247 VSS VSS VSS VSS nfet_03v3 ad=0 pd=0 as=0 ps=0 w=1u l=1u
X248 VDD VDD VDD VDD pfet_03v3 ad=0 pd=0 as=0 ps=0 w=0.22u l=0.28u
X249 VSS VSS VSS VSS nfet_03v3 ad=0 pd=0 as=0 ps=0 w=1u l=1u
X250 DPI_3/Isyn bias_cell_0/Vlk VSS VSS nfet_03v3 ad=0 pd=0 as=0 ps=0 w=1u l=1u
X251 VSS VSS VSS VSS nfet_03v3 ad=0 pd=0 as=0 ps=0 w=0.22u l=0.28u
X252 neuron_sized_3/a_3430_2214# bias_cell_0/VK VSS VSS nfet_03v3 ad=0 pd=0 as=0 ps=0 w=1u l=1u
X253 VSS VSS VSS VSS nfet_03v3 ad=0 pd=0 as=0 ps=0 w=0.22u l=0.28u
X254 VSS VSS VSS VSS nfet_03v3 ad=0 pd=0 as=0 ps=0 w=1u l=1u
X255 DPI_3/Isyn VSS cap_mim_2f0_m4m5_noshield c_width=22.18u c_length=22.18u
X256 VDD VDD VDD VDD pfet_03v3 ad=0 pd=0 as=0 ps=0 w=1u l=1u
X257 VDD VDD VDD VDD pfet_03v3 ad=0 pd=0 as=0 ps=0 w=1u l=1u
X258 neuron_sized_3/a_9750_6632# neuron_sized_3/a_4474_6632# VDD VDD pfet_03v3 ad=0.2166p pd=2.06u as=0 ps=0 w=0.22u l=0.28u
X259 VSS VSS VSS VSS nfet_03v3 ad=0 pd=0 as=0 ps=0 w=0.22u l=0.28u
X260 neuron_sized_4/a_8270_2214# neuron_sized_4/a_9750_6632# spike[0] VSS nfet_03v3 ad=0.8114p pd=5.2u as=0.2014p ps=1.98u w=0.22u l=0.28u
X261 VSS VSS VSS VSS nfet_03v3 ad=0 pd=0 as=0 ps=0 w=1u l=1u
X262 VDD VDD VDD VDD pfet_03v3 ad=0 pd=0 as=0 ps=0 w=0.22u l=0.28u
X263 VSS VSS VSS VSS nfet_03v3 ad=0 pd=0 as=0 ps=0 w=1u l=1u
X264 VDD VDD VDD VDD pfet_03v3 ad=0 pd=0 as=0 ps=0 w=0.22u l=0.28u
X265 VSS VSS VSS VSS nfet_03v3 ad=0 pd=0 as=0 ps=0 w=1u l=1u
X266 VSS VSS VSS VSS nfet_03v3 ad=0 pd=0 as=0 ps=0 w=0.22u l=0.28u
X267 neuron_sized_4/a_4712_2292# bias_cell_0/Vamp_bias VSS VSS nfet_03v3 ad=0.6042p pd=5.94u as=0 ps=0 w=0.22u l=0.28u
X268 neuron_sized_4/a_9750_6632# neuron_sized_4/a_4474_6632# neuron_sized_4/a_7550_2214# VSS nfet_03v3 ad=0.2014p pd=1.98u as=0.8114p ps=5.2u w=0.22u l=0.28u
X269 VSS VSS VSS VSS nfet_03v3 ad=0 pd=0 as=0 ps=0 w=1u l=1u
X270 VSS VSS VSS VSS nfet_03v3 ad=0 pd=0 as=0 ps=0 w=1u l=1u
X271 VDD VDD VDD VDD pfet_03v3 ad=0 pd=0 as=0 ps=0 w=0.22u l=0.28u
X272 VSS VSS VSS VSS nfet_03v3 ad=0 pd=0 as=0 ps=0 w=0.22u l=0.28u
X273 VDD VDD VDD VDD pfet_03v3 ad=0 pd=0 as=0 ps=0 w=1u l=1u
X274 VSS VSS VSS VSS nfet_03v3 ad=0 pd=0 as=0 ps=0 w=1u l=1u
X275 neuron_sized_4/a_4474_6632# neuron_sized_4/a_3704_6616# VDD VDD pfet_03v3 ad=0.2166p pd=2.06u as=0 ps=0 w=0.22u l=0.28u
X276 VSS VSS VSS VSS nfet_03v3 ad=0 pd=0 as=0 ps=0 w=0.22u l=0.28u
X277 neuron_sized_4/a_5916_6554# bias_cell_0/VKup VDD VDD pfet_03v3 ad=0.8666p pd=5.36u as=0 ps=0 w=1u l=1u
X278 DPI_4/Isyn spike[0] neuron_sized_4/a_3430_2214# VSS nfet_03v3 ad=0.8114p pd=5.2u as=0.8114p ps=5.2u w=0.22u l=5u
X279 DPI_4/Isyn neuron_sized_4/a_9750_6632# neuron_sized_4/a_2722_6554# VDD pfet_03v3 ad=0.4332p pd=4.12u as=0.8666p ps=5.36u w=0.22u l=0.28u
X280 VSS VSS VSS VSS nfet_03v3 ad=0 pd=0 as=0 ps=0 w=0.22u l=0.28u
X281 VDD VDD VDD VDD pfet_03v3 ad=0 pd=0 as=0 ps=0 w=0.22u l=0.28u
X282 VSS VSS VSS VSS nfet_03v3 ad=0 pd=0 as=0 ps=0 w=1u l=1u
X283 VDD VDD VDD VDD pfet_03v3 ad=0 pd=0 as=0 ps=0 w=1u l=1u
X284 VDD VDD VDD VDD pfet_03v3 ad=0 pd=0 as=0 ps=0 w=1u l=1u
X285 VSS VSS VSS VSS nfet_03v3 ad=0 pd=0 as=0 ps=0 w=0.22u l=0.28u
X286 VSS VSS VSS VSS nfet_03v3 ad=0 pd=0 as=0 ps=0 w=1u l=1u
X287 VDD VDD VDD VDD pfet_03v3 ad=0 pd=0 as=0 ps=0 w=1u l=1u
X288 VDD VDD VDD VDD pfet_03v3 ad=0 pd=0 as=0 ps=0 w=0.22u l=0.28u
X289 VSS VSS VSS VSS nfet_03v3 ad=0 pd=0 as=0 ps=0 w=1u l=1u
X290 VSS VSS VSS VSS nfet_03v3 ad=0 pd=0 as=0 ps=0 w=0.22u l=0.28u
X291 neuron_sized_4/a_4712_2292# DPI_4/Isyn neuron_sized_4/a_3704_6616# VSS nfet_03v3 ad=0 pd=0 as=0.2014p ps=1.98u w=0.22u l=0.28u
X292 VSS VSS VSS VSS nfet_03v3 ad=0 pd=0 as=0 ps=0 w=0.22u l=0.28u
X293 spike[0] VSS cap_mim_2f0_m4m5_noshield c_width=10u c_length=10u
X294 VDD VDD VDD VDD pfet_03v3 ad=0 pd=0 as=0 ps=0 w=0.22u l=0.28u
X295 VDD VDD VDD VDD pfet_03v3 ad=0 pd=0 as=0 ps=0 w=1u l=1u
X296 VDD VDD VDD VDD pfet_03v3 ad=0 pd=0 as=0 ps=0 w=1u l=1u
X297 VDD VDD VDD VDD pfet_03v3 ad=0 pd=0 as=0 ps=0 w=0.22u l=0.28u
X298 VDD VDD VDD VDD pfet_03v3 ad=0 pd=0 as=0 ps=0 w=1u l=1u
X299 VDD VDD VDD VDD pfet_03v3 ad=0 pd=0 as=0 ps=0 w=0.22u l=0.28u
X300 VSS VSS VSS VSS nfet_03v3 ad=0 pd=0 as=0 ps=0 w=0.22u l=0.28u
X301 neuron_sized_4/a_7550_2214# bias_cell_0/VIp VSS VSS nfet_03v3 ad=0 pd=0 as=0 ps=0 w=1u l=1u
X302 VSS VSS VSS VSS nfet_03v3 ad=0 pd=0 as=0 ps=0 w=0.22u l=0.28u
X303 neuron_sized_4/a_8270_2214# bias_cell_0/VKdn VSS VSS nfet_03v3 ad=0 pd=0 as=0 ps=0 w=1u l=1u
X304 VSS VSS VSS VSS nfet_03v3 ad=0 pd=0 as=0 ps=0 w=1u l=1u
X305 VDD VDD VDD VDD pfet_03v3 ad=0 pd=0 as=0 ps=0 w=1u l=1u
X306 VDD neuron_sized_4/a_3704_6616# neuron_sized_4/a_3704_6616# VDD pfet_03v3 ad=0 pd=0 as=0.2166p ps=2.06u w=0.22u l=0.28u
X307 neuron_sized_4/a_5916_6554# neuron_sized_4/a_9750_6632# spike[0] VDD pfet_03v3 ad=0 pd=0 as=0.2166p ps=2.06u w=0.22u l=0.28u
X308 VSS VSS VSS VSS nfet_03v3 ad=0 pd=0 as=0 ps=0 w=1u l=1u
X309 neuron_sized_4/a_2722_6554# bias_cell_0/VNA VDD VDD pfet_03v3 ad=0 pd=0 as=0 ps=0 w=1u l=1u
X310 VDD VDD VDD VDD pfet_03v3 ad=0 pd=0 as=0 ps=0 w=0.22u l=0.28u
X311 neuron_sized_4/a_4474_6632# VT neuron_sized_4/a_4712_2292# VSS nfet_03v3 ad=0.2014p pd=1.98u as=0 ps=0 w=0.22u l=0.28u
X312 VSS VSS VSS VSS nfet_03v3 ad=0 pd=0 as=0 ps=0 w=1u l=1u
X313 VDD VDD VDD VDD pfet_03v3 ad=0 pd=0 as=0 ps=0 w=0.22u l=0.28u
X314 VSS VSS VSS VSS nfet_03v3 ad=0 pd=0 as=0 ps=0 w=1u l=1u
X315 DPI_4/Isyn bias_cell_0/Vlk VSS VSS nfet_03v3 ad=0 pd=0 as=0 ps=0 w=1u l=1u
X316 VSS VSS VSS VSS nfet_03v3 ad=0 pd=0 as=0 ps=0 w=0.22u l=0.28u
X317 neuron_sized_4/a_3430_2214# bias_cell_0/VK VSS VSS nfet_03v3 ad=0 pd=0 as=0 ps=0 w=1u l=1u
X318 VSS VSS VSS VSS nfet_03v3 ad=0 pd=0 as=0 ps=0 w=0.22u l=0.28u
X319 VSS VSS VSS VSS nfet_03v3 ad=0 pd=0 as=0 ps=0 w=1u l=1u
X320 DPI_4/Isyn VSS cap_mim_2f0_m4m5_noshield c_width=22.18u c_length=22.18u
X321 VDD VDD VDD VDD pfet_03v3 ad=0 pd=0 as=0 ps=0 w=1u l=1u
X322 VDD VDD VDD VDD pfet_03v3 ad=0 pd=0 as=0 ps=0 w=1u l=1u
X323 neuron_sized_4/a_9750_6632# neuron_sized_4/a_4474_6632# VDD VDD pfet_03v3 ad=0.2166p pd=2.06u as=0 ps=0 w=0.22u l=0.28u
X324 VSS VSS VSS VSS nfet_03v3 ad=0 pd=0 as=0 ps=0 w=0.22u l=0.28u
X325 VDD bias_cell_0/a_1044_1080# bias_cell_0/VK VDD pfet_03v3 ad=0.7315p pd=2.79u as=0.7315p ps=2.79u w=2.09u l=8u
X326 bias_cell_0/VK bias_cell_0/VK VSS VSS nfet_03v3 ad=0.2014p pd=1.98u as=0.2014p ps=1.98u w=0.22u l=40u
X327 bias_cell_0/Vlk bias_cell_0/Vlk VSS VSS nfet_03v3 ad=0.35p pd=1.7u as=0.35p ps=1.7u w=1u l=1u
X328 bias_cell_0/VKup Iref VSS VSS nfet_03v3 ad=3.66305p pd=13.23u as=3.66305p ps=13.23u w=6.005u l=8u
X329 DPI_inh_0/VT DPI_inh_0/VT VDD VDD pfet_03v3 ad=0.308p pd=1.58u as=0.308p ps=1.58u w=0.88u l=1.12u
X330 DPI_4/VT DPI_4/VT VDD VDD pfet_03v3 ad=0.1074p pd=1.08u as=0.2166p ps=2.06u w=0.22u l=0.28u
X331 DPI_4/VT DPI_4/VT VDD VDD pfet_03v3 ad=0.1074p pd=1.08u as=0.1074p ps=1.08u w=0.22u l=0.28u
X332 bias_cell_0/VKdn bias_cell_0/VKdn VSS VSS nfet_03v3 ad=0.35p pd=1.7u as=0.61p ps=3.22u w=1u l=1u
X333 DPI_4/VT DPI_4/VT VDD VDD pfet_03v3 ad=0.1074p pd=1.08u as=0.1074p ps=1.08u w=0.22u l=0.28u
X334 DPI_inh_0/VT DPI_inh_0/VT VDD VDD pfet_03v3 ad=0.308p pd=1.58u as=0.308p ps=1.58u w=0.88u l=1.12u
X335 DPI_inh_0/VT DPI_inh_0/VT VDD VDD pfet_03v3 ad=0.308p pd=1.58u as=0.308p ps=1.58u w=0.88u l=1.12u
X336 VDD bias_cell_0/a_1044_1080# bias_cell_0/VK VDD pfet_03v3 ad=0.7315p pd=2.79u as=0.7315p ps=2.79u w=2.09u l=8u
X337 DPI_inh_0/VT DPI_inh_0/VT VDD VDD pfet_03v3 ad=0.308p pd=1.58u as=0.308p ps=1.58u w=0.88u l=1.12u
X338 DPI_4/VT DPI_4/VT VDD VDD pfet_03v3 ad=0.1074p pd=1.08u as=0.1074p ps=1.08u w=0.22u l=0.28u
X339 VDD DPI_4/Vthr DPI_4/Vthr VDD pfet_03v3 ad=0.1074p pd=1.08u as=0.1074p ps=1.08u w=0.22u l=0.28u
X340 VSS bias_cell_0/VKdn bias_cell_0/VKdn VSS nfet_03v3 ad=0.61p pd=3.22u as=0.35p ps=1.7u w=1u l=1u
X341 DPI_inh_0/VT DPI_inh_0/VT VDD VDD pfet_03v3 ad=0.308p pd=1.58u as=0.308p ps=1.58u w=0.88u l=1.12u
X342 DPI_inh_0/VT DPI_inh_0/VT VDD VDD pfet_03v3 ad=0.308p pd=1.58u as=0.308p ps=1.58u w=0.88u l=1.12u
X343 DPI_4/VT DPI_4/VT VDD VDD pfet_03v3 ad=0.1074p pd=1.08u as=0.1074p ps=1.08u w=0.22u l=0.28u
X344 VDD DPI_4/Vthr DPI_4/Vthr VDD pfet_03v3 ad=0.1074p pd=1.08u as=0.1074p ps=1.08u w=0.22u l=0.28u
X345 VDD bias_cell_0/a_1044_1080# bias_cell_0/VKdn VDD pfet_03v3 ad=2.10275p pd=7.77u as=1.13225p ps=3.935u w=3.235u l=8u
X346 VDD DPI_4/Vthr DPI_4/Vthr VDD pfet_03v3 ad=0.1074p pd=1.08u as=0.1074p ps=1.08u w=0.22u l=0.28u
X347 DPI_4/VT DPI_4/VT VDD VDD pfet_03v3 ad=0.1074p pd=1.08u as=0.1074p ps=1.08u w=0.22u l=0.28u
X348 bias_cell_0/VKdn bias_cell_0/a_1044_1080# VDD VDD pfet_03v3 ad=1.13225p pd=3.935u as=1.13225p ps=3.935u w=3.235u l=8u
X349 VDD DPI_4/Vthr DPI_4/Vthr VDD pfet_03v3 ad=0.1074p pd=1.08u as=0.1074p ps=1.08u w=0.22u l=0.28u
X350 DPI_4/VT DPI_4/VT VDD VDD pfet_03v3 ad=0.1074p pd=1.08u as=0.1074p ps=1.08u w=0.22u l=0.28u
X351 VDD DPI_4/Vthr DPI_4/Vthr VDD pfet_03v3 ad=0.1074p pd=1.08u as=0.1074p ps=1.08u w=0.22u l=0.28u
X352 DPI_4/VT DPI_4/VT VDD VDD pfet_03v3 ad=0.1074p pd=1.08u as=0.1074p ps=1.08u w=0.22u l=0.28u
X353 bias_cell_0/Vamp_bias bias_cell_0/Vamp_bias VSS VSS nfet_03v3 ad=0.2014p pd=1.98u as=0.2014p ps=1.98u w=0.22u l=0.28u
X354 VDD DPI_4/Vthr DPI_4/Vthr VDD pfet_03v3 ad=0.1074p pd=1.08u as=0.1074p ps=1.08u w=0.22u l=0.28u
X355 VDD DPI_4/Vthr DPI_4/Vthr VDD pfet_03v3 ad=0.1074p pd=1.08u as=0.1074p ps=1.08u w=0.22u l=0.28u
X356 DPI_4/VT DPI_4/VT VDD VDD pfet_03v3 ad=0.1074p pd=1.08u as=0.1074p ps=1.08u w=0.22u l=0.28u
X357 VDD DPI_4/Vthr DPI_4/Vthr VDD pfet_03v3 ad=0.1074p pd=1.08u as=0.1074p ps=1.08u w=0.22u l=0.28u
X358 DPI_4/VT DPI_4/VT VDD VDD pfet_03v3 ad=0.1074p pd=1.08u as=0.1074p ps=1.08u w=0.22u l=0.28u
X359 DPI_inh_0/VT DPI_inh_0/VT VDD VDD pfet_03v3 ad=0.308p pd=1.58u as=0.308p ps=1.58u w=0.88u l=1.12u
X360 bias_cell_0/Vlk bias_cell_0/a_1044_1080# VDD VDD pfet_03v3 ad=0.546p pd=2.98u as=0.546p ps=2.98u w=0.84u l=16u
X361 bias_cell_0/a_1044_1080# bias_cell_0/a_1044_1080# VDD VDD pfet_03v3 ad=1.75p pd=5.7u as=3.25p ps=11.3u w=5u l=8u
X362 VDD DPI_4/Vthr DPI_4/Vthr VDD pfet_03v3 ad=0.1074p pd=1.08u as=0.1074p ps=1.08u w=0.22u l=0.28u
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
