Latios1928/engn2912e-project/analog/neuron/layout/PEX/neuron_sized_pex.spice

* NGSPICE file created from neuron_sized_flat.ext - technology: gf180mcuD

.subckt neuron_sized_flat VSS Vlk VK VT Vamp_bias VIp VKdn VNA VKup VMEM spike VDD
X0 a_8270_2214# a_9750_6632# spike.t0 VSS.t3 nfet_03v3 ad=0.2014p pd=1.98u as=0.2014p ps=1.98u w=0.22u l=0.28u
X1 VSS.t53 VSS.t52 VSS.t53 VSS.t18 nfet_03v3 ad=0.61p pd=3.22u as=0 ps=0 w=1u l=1u
X2 VDD.t11 VDD.t9 VDD.t11 VDD.t10 pfet_03v3 ad=0.2166p pd=2.06u as=0 ps=0 w=0.22u l=0.28u
X3 VSS.t16 VSS.t14 VSS.t16 VSS.t15 nfet_03v3 ad=0.61p pd=3.22u as=0 ps=0 w=1u l=1u
X4 VDD.t17 VDD.t15 VDD.t17 VDD.t16 pfet_03v3 ad=0.2166p pd=2.06u as=0 ps=0 w=0.22u l=0.28u
X5 VSS.t19 VSS.t17 VSS.t19 VSS.t18 nfet_03v3 ad=0.61p pd=3.22u as=0 ps=0 w=1u l=1u
X6 VSS.t30 VSS.t28 VSS.t30 VSS.t29 nfet_03v3 ad=0.2014p pd=1.98u as=0 ps=0 w=0.22u l=0.28u
X7 a_4712_2292# Vamp_bias.t0 VSS.t7 VSS.t6 nfet_03v3 ad=0.2014p pd=1.98u as=0.2014p ps=1.98u w=0.22u l=0.28u
X8 a_9750_6632# a_4474_6632# a_7550_2214# VSS.t2 nfet_03v3 ad=0.2014p pd=1.98u as=0.2014p ps=1.98u w=0.22u l=0.28u
X9 VSS.t41 VSS.t40 VSS.t41 VSS.t12 nfet_03v3 ad=0.61p pd=3.22u as=0 ps=0 w=1u l=1u
X10 VSS.t49 VSS.t48 VSS.t49 VSS.t12 nfet_03v3 ad=0.61p pd=3.22u as=0 ps=0 w=1u l=1u
X11 VDD.t41 VDD.t40 VDD.t41 VDD.t13 pfet_03v3 ad=0.2166p pd=2.06u as=0 ps=0 w=0.22u l=0.28u
X12 VSS.t32 VSS.t31 VSS.t32 VSS.t6 nfet_03v3 ad=0.2014p pd=1.98u as=0 ps=0 w=0.22u l=0.28u
X13 VDD.t45 VDD.t44 VDD.t45 VDD.t19 pfet_03v3 ad=0.65p pd=3.3u as=0 ps=0 w=1u l=1u
X14 VSS.t13 VSS.t11 VSS.t13 VSS.t12 nfet_03v3 ad=0.61p pd=3.22u as=0 ps=0 w=1u l=1u
X15 a_4474_6632# a_3704_6616# VDD.t49 VDD.t13 pfet_03v3 ad=0.2166p pd=2.06u as=0.2166p ps=2.06u w=0.22u l=0.28u
X16 VSS.t55 VSS.t54 VSS.t55 VSS.t21 nfet_03v3 ad=0.2014p pd=1.98u as=0 ps=0 w=0.22u l=0.28u
X17 a_5916_6554# VKup.t0 VDD.t52 VDD.t19 pfet_03v3 ad=0.65p pd=3.3u as=0.65p ps=3.3u w=1u l=1u
X18 VMEM.t0 spike.t3 a_3430_2214# VSS.t0 nfet_03v3 ad=0.2014p pd=1.98u as=0.2014p ps=1.98u w=0.22u l=5u
X19 VMEM.t1 a_9750_6632# a_2722_6554# VDD.t55 pfet_03v3 ad=0.2166p pd=2.06u as=0.2166p ps=2.06u w=0.22u l=0.28u
X20 VSS.t57 VSS.t56 VSS.t57 VSS.t24 nfet_03v3 ad=0.2014p pd=1.98u as=0 ps=0 w=0.22u l=0.28u
X21 VDD.t14 VDD.t12 VDD.t14 VDD.t13 pfet_03v3 ad=0.2166p pd=2.06u as=0 ps=0 w=0.22u l=0.28u
X22 VSS.t47 VSS.t46 VSS.t47 VSS.t38 nfet_03v3 ad=0.61p pd=3.22u as=0 ps=0 w=1u l=1u
X23 VDD.t20 VDD.t18 VDD.t20 VDD.t19 pfet_03v3 ad=0.65p pd=3.3u as=0 ps=0 w=1u l=1u
X24 VDD.t47 VDD.t46 VDD.t47 VDD.t22 pfet_03v3 ad=0.65p pd=3.3u as=0 ps=0 w=1u l=1u
X25 VSS.t43 VSS.t42 VSS.t43 VSS.t21 nfet_03v3 ad=0.2014p pd=1.98u as=0 ps=0 w=0.22u l=0.28u
X26 VSS.t69 VSS.t68 VSS.t69 VSS.t38 nfet_03v3 ad=0.61p pd=3.22u as=0 ps=0 w=1u l=1u
X27 VDD.t31 VDD.t30 VDD.t31 VDD.t22 pfet_03v3 ad=0.65p pd=3.3u as=0 ps=0 w=1u l=1u
X28 VDD.t37 VDD.t36 VDD.t37 VDD.t7 pfet_03v3 ad=0.2166p pd=2.06u as=0 ps=0 w=0.22u l=0.28u
X29 VSS.t39 VSS.t37 VSS.t39 VSS.t38 nfet_03v3 ad=0.61p pd=3.22u as=0 ps=0 w=1u l=1u
X30 VSS.t22 VSS.t20 VSS.t22 VSS.t21 nfet_03v3 ad=0.2014p pd=1.98u as=0 ps=0 w=0.22u l=0.28u
X31 a_4712_2292# VMEM.t4 a_3704_6616# VSS.t24 nfet_03v3 ad=0.2014p pd=1.98u as=0.2014p ps=1.98u w=0.22u l=0.28u
X32 VSS.t59 VSS.t58 VSS.t59 VSS.t8 nfet_03v3 ad=0.2014p pd=1.98u as=0 ps=0 w=0.22u l=0.28u
X33 spike.t2 VSS.t1 cap_mim_2f0_m4m5_noshield c_width=10u c_length=10u
X34 VDD.t27 VDD.t26 VDD.t27 VDD.t7 pfet_03v3 ad=0.2166p pd=2.06u as=0 ps=0 w=0.22u l=0.28u
X35 VDD.t33 VDD.t32 VDD.t33 VDD.t1 pfet_03v3 ad=0.65p pd=3.3u as=0 ps=0 w=1u l=1u
X36 VDD.t35 VDD.t34 VDD.t35 VDD.t4 pfet_03v3 ad=0.65p pd=3.3u as=0 ps=0 w=1u l=1u
X37 VDD.t39 VDD.t38 VDD.t39 VDD.t10 pfet_03v3 ad=0.2166p pd=2.06u as=0 ps=0 w=0.22u l=0.28u
X38 VDD.t23 VDD.t21 VDD.t23 VDD.t22 pfet_03v3 ad=0.65p pd=3.3u as=0 ps=0 w=1u l=1u
X39 VDD.t43 VDD.t42 VDD.t43 VDD.t16 pfet_03v3 ad=0.2166p pd=2.06u as=0 ps=0 w=0.22u l=0.28u
X40 VSS.t25 VSS.t23 VSS.t25 VSS.t24 nfet_03v3 ad=0.2014p pd=1.98u as=0 ps=0 w=0.22u l=0.28u
X41 a_7550_2214# VIp.t0 VSS.t10 VSS.t9 nfet_03v3 ad=0.61p pd=3.22u as=0.61p ps=3.22u w=1u l=1u
X42 VSS.t61 VSS.t60 VSS.t61 VSS.t29 nfet_03v3 ad=0.2014p pd=1.98u as=0 ps=0 w=0.22u l=0.28u
X43 a_8270_2214# VKdn.t0 VSS.t5 VSS.t4 nfet_03v3 ad=0.61p pd=3.22u as=0.61p ps=3.22u w=1u l=1u
X44 VSS.t65 VSS.t64 VSS.t65 VSS.t9 nfet_03v3 ad=0.61p pd=3.22u as=0 ps=0 w=1u l=1u
X45 VDD.t25 VDD.t24 VDD.t25 VDD.t1 pfet_03v3 ad=0.65p pd=3.3u as=0 ps=0 w=1u l=1u
X46 VDD.t48 a_3704_6616# a_3704_6616# VDD.t10 pfet_03v3 ad=0.2166p pd=2.06u as=0.2166p ps=2.06u w=0.22u l=0.28u
X47 a_5916_6554# a_9750_6632# spike.t1 VDD.t54 pfet_03v3 ad=0.2166p pd=2.06u as=0.2166p ps=2.06u w=0.22u l=0.28u
X48 VSS.t67 VSS.t66 VSS.t67 VSS.t4 nfet_03v3 ad=0.61p pd=3.22u as=0 ps=0 w=1u l=1u
X49 a_2722_6554# VNA.t0 VDD.t53 VDD.t4 pfet_03v3 ad=0.65p pd=3.3u as=0.65p ps=3.3u w=1u l=1u
X50 VDD.t29 VDD.t28 VDD.t29 VDD.t16 pfet_03v3 ad=0.2166p pd=2.06u as=0 ps=0 w=0.22u l=0.28u
X51 a_4474_6632# VT.t0 a_4712_2292# VSS.t8 nfet_03v3 ad=0.2014p pd=1.98u as=0.2014p ps=1.98u w=0.22u l=0.28u
X52 VSS.t34 VSS.t33 VSS.t34 VSS.t9 nfet_03v3 ad=0.61p pd=3.22u as=0 ps=0 w=1u l=1u
X53 VDD.t8 VDD.t6 VDD.t8 VDD.t7 pfet_03v3 ad=0.2166p pd=2.06u as=0 ps=0 w=0.22u l=0.28u
X54 VSS.t36 VSS.t35 VSS.t36 VSS.t4 nfet_03v3 ad=0.61p pd=3.22u as=0 ps=0 w=1u l=1u
X55 VMEM.t2 Vlk.t0 VSS.t71 VSS.t15 nfet_03v3 ad=0.61p pd=3.22u as=0.61p ps=3.22u w=1u l=1u
X56 VSS.t63 VSS.t62 VSS.t63 VSS.t6 nfet_03v3 ad=0.2014p pd=1.98u as=0 ps=0 w=0.22u l=0.28u
X57 a_3430_2214# VK.t0 VSS.t70 VSS.t18 nfet_03v3 ad=0.61p pd=3.22u as=0.61p ps=3.22u w=1u l=1u
X58 VSS.t45 VSS.t44 VSS.t45 VSS.t29 nfet_03v3 ad=0.2014p pd=1.98u as=0 ps=0 w=0.22u l=0.28u
X59 VSS.t51 VSS.t50 VSS.t51 VSS.t15 nfet_03v3 ad=0.61p pd=3.22u as=0 ps=0 w=1u l=1u
X60 VMEM.t3 VSS.t72 cap_mim_2f0_m4m5_noshield c_width=22.18u c_length=22.18u
X61 VDD.t2 VDD.t0 VDD.t2 VDD.t1 pfet_03v3 ad=0.65p pd=3.3u as=0 ps=0 w=1u l=1u
X62 VDD.t5 VDD.t3 VDD.t5 VDD.t4 pfet_03v3 ad=0.65p pd=3.3u as=0 ps=0 w=1u l=1u
X63 a_9750_6632# a_4474_6632# VDD.t51 VDD.t50 pfet_03v3 ad=0.2166p pd=2.06u as=0.2166p ps=2.06u w=0.22u l=0.28u
X64 VSS.t27 VSS.t26 VSS.t27 VSS.t8 nfet_03v3 ad=0.2014p pd=1.98u as=0 ps=0 w=0.22u l=0.28u
R0 VKdn VKdn.t0 39.7267
R1 Vamp_bias Vamp_bias.t0 45.1008
R2 VT VT.t0 43.4785
R3 VIp VIp.t0 38.7368
R4 VK VK.t0 33.5617
R5 Vlk Vlk.t0 32.5718
R6 VMEM.n2 VMEM.t1 48.8322
R7 VMEM.n0 VMEM.t0 30.2872
R8 VMEM.n0 VMEM.t4 27.5328
R9 VMEM.n3 VMEM.n2 14.6573
R10 VMEM.n1 VMEM.t2 14.2268
R11 VMEM.n3 VMEM.n1 2.723
R12 VMEM.n1 VMEM.n0 2.0525
R13 VMEM VMEM.n3 0.3425
R14 VMEM.n2 VMEM.t3 0.194673
R15 spike.n0 spike.t1 23.1349
R16 spike.n0 spike.t0 21.9686
R17 spike.n2 spike.t2 19.9809
R18 spike.n1 spike.t3 12.607
R19 spike spike.n2 6.962
R20 spike.n1 spike.n0 4.2715
R21 spike.n2 spike.n1 0.1715
R22 VKup VKup.t0 36.7938
R23 VNA VNA.t0 33.9205
R24 VDD.n72 VDD.t50 1087.52
R25 VDD.t55 VDD.n1 769.438
R26 VDD.t54 VDD.t55 476.724
R27 VDD.t50 VDD.t54 476.724
R28 VDD.n71 VDD.n3 436.591
R29 VDD.n73 VDD.n3 436.591
R30 VDD.n73 VDD.n1 436.591
R31 VDD.n71 VDD.n1 436.591
R32 VDD.n72 VDD.t22 391.993
R33 VDD.t22 VDD.t19 338.921
R34 VDD.t4 VDD.t1 338.921
R35 VDD.t16 VDD.t13 332.402
R36 VDD.t19 VDD.t16 305.401
R37 VDD.t7 VDD.t4 305.401
R38 VDD.t13 VDD.t10 271.882
R39 VDD.t10 VDD.t7 271.882
R40 VDD.t1 VDD.n3 253.609
R41 VDD.n53 VDD.t6 22.8087
R42 VDD.n56 VDD.t9 22.8087
R43 VDD.n59 VDD.t12 22.8087
R44 VDD.n62 VDD.t15 22.8087
R45 VDD.n28 VDD.t42 22.6193
R46 VDD.n31 VDD.t40 22.6193
R47 VDD.n34 VDD.t38 22.6193
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
C54 VDD.n72 VSS 1.75792f
C55 VNA.t0 VSS 0.72024f
C56 VKup.t0 VSS 0.51171f
C57 spike.t2 VSS 3.27075f
C58 VMEM.t3 VSS 4.64294f
C59 Vlk.t0 VSS 0.55301f
C60 VK.t0 VSS 1.16937f
C61 VIp.t0 VSS 2.69208f
C62 VT.t0 VSS 1.41256f
C63 Vamp_bias.t0 VSS 1.79547f
C64 VKdn.t0 VSS 2.92601f
.ends
