Latios1928/engn2912e-project/(commit log)

2026-10-21 analog schematic for comparator
    [comparator.sch, schmitt_trigger_comparator_testbench.sch]
2026-10-25 neuron circuits
    [schmitt_trigger_comparator_testbench.sch]
2026-10-26 schmitt-trigger modifications
    [comparator.sch, schmitt_trigger_comparator_testbench.sch]
2026-10-26 neuron testbench + simulations
    [comparator.sch, neuron.sch, neuron_testbench.sch, schmitt_trigger_comparator_testbench.sch]
2026-10-26 additional analgo simulations
    [neuron.sch, neuron_testbench.sch, schmitt_trigger_comparator_testbench.sch]
2026-10-27 librelane estimate for snn_top.sv area
    [metrics.csv]
2026-10-29 DAC + DPI synapse schematics and DACs-DPI test sheet
    - DAC.sch/.sym: 4-branch current DAC; each weight bit switches a branch
    whose current source is biased by Vb. Sinks current from Isum.
    - DPI.sch/.sym: differential-pair integrator. Tail current Isum comes from
    the DACs; Vthr sets gain, VT sets the decay time constant, output Isyn.
    - DACs-DPI.sch: three DACs (one per input) summing into one DPI, with a
    transient testbench in the TRAN_SIM code block.
    - DAC_tb.sch: placeholder, DAC instance only.
    The weight bits w00..w32 (w<bit><dac>) are inputs to the system: they
    will be fed from the digital weight register file (snn_top `weights`).
    In DACs-DPI.sch they are driven by test sources in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
    [DAC.sch, DAC_tb.sch, DACs-DPI.sch, DPI.sch]
2026-10-29 neuron schematic unsized
    [neuron.sch, neuron_old.sch, spike_amplifier.sch]
2026-11-03 neuron sized by claude
    [neuron_5khz.sch, neuron_5khz_testbench.sch, neuron_testbench.sch]
2026-11-05 newly sized neuron
    [neuron_sized.sch, neuron_sized_testbench.sch]
2026-11-05 DAC weight bus and 1:2:3:4 sizing, DPI testbenches, DAC+DPI code test
    - DAC.sym/DAC.sch: weights as one bus w[3:0]; branch k uses k+1 unit cells
    (switch 0.22u/0.28u, current source 1u/8u) for weights 1:2:3:4
    - DACs-DPI.sch: bus wiring, Vb from a trimmed reference into a diode-connected
    unit cell (w[0] = 15 nA), DAC current ammeter, and a test that applies
    codes 0-15 on 10 us spikes and reports current, charge and Isyn per code
    - analog/testbenches: DPI testbenches (DC, step, spike) and run_dpi.py runner
    for sweeps, corners, temperature, supply and mismatch, with results
    - DPI.sym Isum pin moved; neuron schematic and testbench edits
    - Analog_AI_Documentation.md: entries 31-33
    Co-Auth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
    [DAC.sch, DACs-DPI.sch, dpi_dc_tb.sch, dpi_spike_tb.sch, dpi_step_tb.sch, mc.csv, neuron_5khz.sch, neuron_5khz_testbench.sch]
2026-11-05 DAC enable switch, DAC+DPI+neuron chain testbench, xschemrc
    - DAC.sch/DAC.sym: add Men and an en pin; the weight bits can stay static
    and en carries the spike train
    - DACs-DPI.sch: tie each DAC's en to VDD for the weight-code test
    - DACs-DPI-neuron.sch: three DACs -> DPI -> neuron_sized; static weights,
    spike train on en; reports inputs to first fire, inputs per output and
    DAC charge per spike
    - xschemrc (root and analog/neuron): put both folders on the symbol path
    - neuron_sized.sch: bare spike_amplifier.sym reference
    - AI documentation entries 43-48, testbench README update
    [DAC.sch, DACs-DPI-neuron.sch, DACs-DPI.sch, neuron_sized.sch]
2026-11-09 Mixed signal simulation (#1)
    [snn_analog.sch, snn_ms_tb.sch]
2026-11-10 3-5-1 → 2-2-1
    [snn_analog.sch, snn_ms_tb.sch]
2026-11-11 Analog layouts: neuron_sized (rev 2) and DAC, coupling checks, AI log
    - analog/neuron/layout/gen_neuron.py, neuron_sized.gds: neuron layout with
    deep N-well, guard rings, dummy rings around the subthreshold/matched
    devices, VMEM kept out of the routing channel, spike/net1/net2 shielded,
    MIM caps over the transistors. DRC clean, LVS matched.
    - analog/neuron/layout/gen_dac.py, DAC.gds: DAC layout with deep N-well,
    isolated switch wells (body = branch node), 2x5 common-centroid source
    array in a full dummy ring, shielded branch/X/Isum routing, labelled pins.
    DRC clean, LVS matched.
    - coupling.py: geometric coupling report per net from the LVS database;
    reports for VMEM, spike, net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
2026-11-11 DAC layout
    [DAC_binary.sch]
2026-11-12 additional analog updates
    [neuron_sized.sch]
2026-11-12 DPI inhibitory blocks
    [DAC_signed.sch, DPI_inh.sch, DPI_sized.sch, hidden_tb.sch, inh_cell_tb.sch]
2026-11-12 top level analog layout
    [snn_analog_inh.sch]
2026-11-12 testbenches of individual analog blocks
    [dac_signed_pulse_tb.csv, dac_signed_pulse_tb.sch, dac_signed_static_tb.csv, dac_signed_static_tb.sch, dac_signed_static_tb_codes.csv, dpi_load_tb.csv, dpi_load_tb.sch, dpi_load_tb__DPI__chain.csv]
2026-11-12 Add on-chip bias generator schematic, testbenches and sizing tool copy
    analog/bias/bias_gen.sch/.sym: bias generator for the 11 bias pins of
    snn_analog (beta-multiplier master current with n-well resistor and 4-bit
    trim, mirror tree, replica biasing, VT = VDD/2).
    analog/bias/testbenches/: xschem testbenches (DC/supply sweep, start-up,
    PSRR, 2-2-1 network) and the probe block they use.
    analog/bias/analog_API_infrastructure/: copy of the sizing tool with an
    evaluator option, a grid proposer and configs_bias; the original in tools/
    is unchanged.
    [bias_dc_tb.sch, bias_gen.sch, bias_network_tb.sch, bias_probes.sch, bias_psrr_tb.sch, bias_startup_tb.sch]
2026-11-12 Add the bias generator sizing sweep script and what it needs
    analog/bias/sim/sweep_point.py evaluates one unit-mirror size (stack factors,
    calibration, PVT, supply, mismatch) for configs_bias of the sizing tool copy.
    It uses analog/bias/bias_gen.py (design data and SPICE writer),
    sim/stack_corr.py and sim/bias_tb.py. configs_bias starts from the 1/6 um unit.
2026-11-12 Bias testbenches: wire the voltage sources instead of labelling them
    Sources now connect to bias_gen with wires and ground symbols (no net labels
    on the sources); trim bits as .param b3..b0, weights as w3..w0; probe block
    wired straight across. PSRR source value quoted so the AC stimulus is kept.
    Network testbench starts membranes and spikes at 0 V (.ic) so its spike
    counts do not depend on which DC point ngspice finds.
    [bias_dc_tb.sch, bias_network_tb.sch, bias_psrr_tb.sch, bias_startup_tb.sch]
2026-11-14 spike amplifier sizing
    [bias_cell.sch, neuron_sized.sch, spike_amplifier_sized.sch]
